DamirNine/prikmeh/курсовой/2026-11-09/apm/Скрины/кулиса_2_тест.png

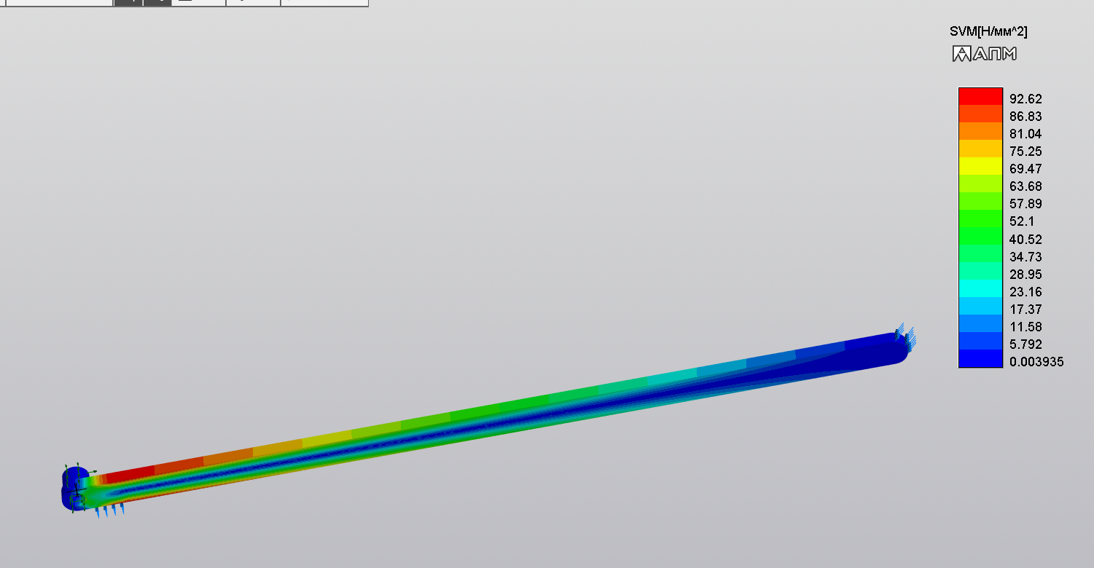
курсовой/2026-11-09/apm/Скрины/кулиса_2_тест.png
