DamirNine/prikmeh/мои_записи_Claude.md

# Мои записи и сообщения Claude по курсовому проекту

Все сообщения из диалога с Claude Code (15.09–13.10.2026) в хронологическом порядке, время московское. Сюда же входят заметки с консультаций, вставленные в чат, и ответы на вопросы Claude с вариантами («ответ на вопрос»). Реплики, отправленные во время работы Claude, помечены «по ходу работы». Ответы Claude не включены, только мои сообщения. В начале диалога есть несколько сообщений не по курсовому.

## 15.09.2026

**12:23**

привет прочитай инструкции
работаем с проектом по примеху

**12:24** · ответ на вопрос

- **Вопрос:** Не могу однозначно понять, какой проект вы имеете в виду под «примеху» — такого нет в памяти. Уточните, пожалуйста, какой это проект?
  **Ответ:** а я вспомнил посмотри в гитхабе там есть проект по прикмеху

**12:26** · по ходу работы

дай токен

**12:27** · по ходу работы

ты просметрел гитхаб?
у меня вылезло окошко с гитхабом оно тебе надо?

**12:28**

зачем тебе это у тебя же есть токен административный

**12:30**

к какой почте гитхаб привязан?

**12:36**

нужно создать токен для доступа к этому проекту что бя я мог скинуть его другу и он тоже смог бы скачать от-туда файлы так же если я буду тут работать по этому проекту ты автоматически вноси это в гитхаб
так же запиши сюда и в гитхаб что если мы что редактируем или добавляем то мы копируем файл и редактируем скопированный файл для того что бы прошлая версия оставалась и желательно еще заносить их в папки которые называть по дате редактирования

**12:59**

во сколько начился наш диалог

## 18.09.2026

**13:59**

привет посмотри последний загруженный файл там мы с другом проработали дальше наш проект проверь выполнение

**14:00**

нет в моем компьюютере последний загруженный файл

**14:03**

доделай что нужно сделать

**14:08**

открой файл

**14:15**

так убери надписи типо это дополнение из файла 
а также сделай пункты 19-25 такими же по формату как и преведущие пункты

**14:20**

что такое HoReCa
и у тебя текст разных шрифтов

**14:25**

сохрани этот файл в гитхаб и если надо будет редактировать теперь сделай копию и редактируй ее

**14:26**

выведи мне полный анализ батареи

**14:56**

новый скачанный файл просмотри на правильность

**15:29**

обнови память и замени файл  из гитхаба(файл который сегодня сохранял) этим файлом

**15:31**

делай

## 21.09.2026

**10:44**

Картинку из ГОСТа крышки
Убрать шарнир из компановки 
Ra5 ГОСТ 6636 +-
Смотрим под серийку R10-R20
Получаем предел текучести из материала крышки на 5%
Площадь кольца и предел текучести 
Рукоятка: 

Силовой расчет с известной силой человека и получаем максимальную длину рукоятки 

Кинематику прописать 

Ход ползуна: зазор + запрессовка 

Габариты:
Кухонный зазор, смотреть за рычагом 
1.5 диаметра бутылки 

ТЗ: таблица с цифрами, парсетрыч размерности и значение. Условие задачи в цифрах.

Предпроектный этап:
Расчеты
Кинематика
Силовая

не давно были у преподователя и вот что нам дали

ты еще помнишь как у нас выглядела схема механизма?

**10:48** · ответ на вопрос

- **Вопрос:** «Убрать шарнир из компановки» — что именно имелось в виду?
  **Ответ:** Не помню точно / нужно переспросить
- **Вопрос:** «Предел текучести из материала крышки на 5%» — как это понимать?
  **Ответ:** мы должны превышать силу предела текучести примерно на 5 %

**10:49**

сначала хочу сделать схему как все будет выглядеть

**10:50** · ответ на вопрос

- **Вопрос:** Какую схему делаем — формальную кинематическую (по ГОСТ 2.770, условные обозначения звеньев/шарниров/пар) для отчёта по ТММ, или общий вид устройства (как оно будет выглядеть визуально: основание, стойка, рукоятка, крышка на бутылке)?
  **Ответ:** сделай обе и в схеме тмм желательно еще подписать размеры

**10:58**

открой

**11:01**

ты вообще видел что ты сгенерировал?
оно все кривое
может тебе легче будет сделать 3д модель?
ничего не делай просто ответь

**11:03**

я как-то сказал тебе сделать 3д кубик рубик который можно крутить ты довольно легко сделал это будет сделать тяжелей?

**11:06**

да хочу 3д модель которая будет двигаться по кнопке и еще одна кнопка которая грубо говоря разрезает модель пополам что божно было увидеть что внутри
давай сначала просто статическую модель которую можно крутить и по кнопке ее разрезает

**11:20**

во первых при разрезе внутри модели прозрачные а должны быть обычные
во вторых все перепутано и не на своих местах
возьми последнию из загрузок я там попытался нарисовать как примерно должно выглядеть

**11:47**

https://507movements.com/mm_101.html
ты можешь посмотреть что тут

**11:52**

я это к тому как примерно должны выглядеть ручка а не это овальная нечто 
плюс продумай геометрию и не заставляй опоры висеть в воздухе соедени их с основанием только так что бы они не мешали механизму и выглядели нормально

**11:58**

лучше но нужно проделать отверстия где все должно ездить плюс у тебя кулиса и ползун на одной плоскости они так двигаться не смогут их нужно немного раздвинуть они двигаются за счет камня продумай геометрию

**12:03**

не с той стороны отверстия сделал и сделай кулису примерно как в схеме с отверстием сейчас там просто вмурован камень

**12:10**

сдвинь разрез к плоскости ползуна
теперь можно анимировать

**12:27**

так движение впринципе верное теперь нужно придумать как скрыть все это и как потом все это собирать(у нас будет 3д принтер и нам нужно чтобы можно было собрать механизм(он не будет выполнять свою работу главное что бы он мог двигаться как надо))
также сделай бутылку с пропорцией как у 0,33
кулису сделай потоньше
сначала сделай исправления я посмотрю и потом будем думать как скрыть и собрать

**12:38**

как использовать ГОСТ 6636

**12:45**

пока не считали как думаешь лучше сначала расчитать а потом уже думать как закрыть и собирать или сейчас все продумать а потом рассчитать и поменять размеры?
как мне самому открыть 3д если я перезапущу комп а у тебя токены закончаться добавь мне ярлык на рабочий стол

**12:47**

где храниться это 3д модель?
в смысле за счет чего я ее открываю в браузере

**12:50**

а как долго это можно будет открыть?

**12:50**

а если у меня закончиться подписка?

**12:52**

возьми последний загруженный файл и проверь его

**13:04**

переделай 3д модель ползун пусть будет прямоугольный 
не забудь сделать такие же дырки и камень должен вращаться вокруг своей оси так меньше будет износ вроде нам это показывать пока никак не надо

## 22.09.2026

**13:13**

продолжаем

## 25.09.2026

**12:19**

привет посмотри последнюю загрузку это скрин картинки механизма обрежь фото улучши качество если можешь и поверни на 90 градусов что бы закрепление было в левой стороне экрана ну и сохрани куда-нибудь в проект потом буду просить открыть ее

**12:22**

открой мне картинку

**12:26**

посмотри файл последний из загрузок это то что я тебе скидывал до этого?

## 27.09.2026

**19:23**

привет посмотри последнии три загрузки
мне нужно что бы ты имею пластичную деформацию +5 процентов крышки и площадь горлышка бутылки рассчитал силу ползуна знаю силу руки рассчитал длину рукояти а потом рассчитал соотношение ползуна и рукояти для минимизации размеров
вот еще текст не знаю насколько он подхадит нашему механизму

> **Вставлено:**
> Подобрать такие параметры механизма, который опишет необходимую траекторию.
> Кривые 6 степени
> Траектории выходной точки. Траектория достаточно приближается к прямолинейной не превышает 1/20. Надо вычислить эту величину для своего механизма:
> 1) функция положения: зависимость координат выходного звена от входного 
> Количество зависимостей - формула Гофмана: k = p_н - n
> Уравнение замкнутости контура: рассматриваем замкнутый векторный контур механизма 
> Проецируем на неподвижные декартовы оси
> Углы тригонометрические - от оси x против часовой стрелки
> 
> Пространство факторов
> Масштаб из хода, который мы получили в производительности

**19:47**

запиши все в файл ты проверил что там в скачанном?

**19:56** · по ходу работы

так же там надо размеры в гост сверить (не помню вроде гост 6636) ты это сделал?

**20:09**

открой мне папку где лежит последний файл

**20:10**

какой файл?

## 02.10.2026

**14:03**

открой файл с расчетом

**15:43**

пересчитай еще раз силу к горлышку бутылки

**15:47**

открой файл с ТЗ

**15:50**

откуда у нас  435,75 МПа
как-от многовата

**15:53**

посмотри в интернете какая площадь используется при похожих расчетах

**16:00**

новый файл и переделай теперь так

**16:10**

убери из файла упоминания о преведущей версии

**16:11** · по ходу работы

и в будущем тоже при создании новой версии не надо писать различия с преведущей просто пиши новую и все

**16:34**

посмотри в интернете силу нажима руки

**16:37**

так какая сила

**16:41**

возьми силу руки примерно 120 H

**16:46**

тз пока не трогаем его потом поправим после вопросов учителю открой файл

## 03.10.2026

**01:18**

> **Вставлено:**
> Уменьшить e и угловой ход пси
> Как соотнести их
> 
> Оптимизировать площадь треугольника 
> Какой критерий позволит сравнить между собой
> 
> Какой критерий зависит от e и пси, при этом ход постоянный остаётся?
> 
> Прикладываем силу P вертикально
> Нажатие одной рукой
> 
> От минимизации длины рычага
> От минимизации площади треугольника, сделав фиксированную высоту 
> 
> Аналоги скорости и ускорения для характерных точек
> 
> вот заметки с консультации а также фото из загрузок
> спроси что непонятно

**01:28** · ответ на вопрос

- **Вопрос:** Площадь какого треугольника минимизировать (критерий, зависящий от e и ψ)?
  **Ответ:** O и два крайних положения ползуна
только угол не от 30 до 0
а допустим от 60 до 40(примерно)
- **Вопрос:** Что значит «сделав фиксированную высоту»?
  **Ответ:** высота это зазор между крышкой и концом ползуна и еще сколько-то сколько надо на деформацию крышки
- **Вопрос:** Сила руки при «нажатии одной рукой» — какое значение брать?
  **Ответ:** посмотри с разными силами
- **Вопрос:** Откуда брать времена разгона, установившегося движения и торможения для графика ω(t)?
  **Ответ:** это расчитывается по формулам
беруться точки для них как-то там находяться скорости и ускорения
и т.д.
можешь посмотреть презентацию по прикмеху с преведущего семестра вроде там есть

**01:31** · по ходу работы

я тебе градусы как пример дал по факту ты должен рассчитать так что бы площадь треугольника была минимальна
ты изменяешь угол 
ты изменяешь e
ну и поставь себе длину рукояти ограничение какое-нибудь что бы не было метровой рукояти

**01:35** · ответ на вопрос

- **Вопрос:** Какое окно угла развивать дальше (для него посчитаю аналоги скоростей, ускорений и ω(t))? Таблица сравнения всех окон войдёт в файл в любом случае.
  **Ответ:** напиши скрипт который переберет значения для минимизации площади(ну или сам перебери)
пусть там вариируется и угол и разница углов и e и т.д.
нормально перебери вариантов а не 10 и не 100
- **Вопрос:** Рычаг — прямое продолжение кулисы (как на листе) или можно изогнуть рукоять?
  **Ответ:** Прямой, как на листе
- **Вопрос:** Времена для ω(t): предлагаю взять из производительности Q = 6 бут/мин (цикл 10 с). Подходит?
  **Ответ:** это все по формулам считать надо а не так приводить
и ты пересчитал при силе P вертикальной а не перпиндикулярной

**01:40** · по ходу работы

ты площадь вроде не так считаешь

**01:41** · по ходу работы

то что ты написал это площадь треугольника если он доезжает до угла в 0
а если не заезжает то там трегоульник с другим углом

**01:42** · ответ на вопрос

- **Вопрос:** Площадь какого треугольника минимизировать?
  **Ответ:** как сейчас но у тебя формула верна только если угол от 0 до скольки-то
а если от 60 до 40 то там другой треугольник и считать от 40 до 0 в этом треугольнике не надо

**01:57**

52,5 как-то многовато
сделай как анимацию лучших вариантов что-бы я примерно мог понять

**01:59** · по ходу работы

просто сделай анимации лучших работ которые ты показал в таблице с сохранением примерных масштабов
нажимаешь на картинку и анимация работает 1 раз

**02:07**

давай для 40 градусов

**02:10** · ответ на вопрос

- **Вопрос:** Что берём исходным для расчёта времён разгона, установившегося движения и торможения?
  **Ответ:** я не помнб посмотри в фото и презентации до этого и сделай по формулам если там нет посмотри в интернете

**20:04**

посмотри два последних скачанных файла и проверь файл
вроде там показано как расчитывать скорости

**20:06** · по ходу работы

стоп

**20:07** · по ходу работы

там речь вроде про другой механиз ничего с углом делать не нвдо

## 05.10.2026

**10:12**

посмотри на фото там есть график угловой скорости там он в виде трапеции

**10:17** · ответ на вопрос

- **Вопрос:** Какую трапецию ω(t) берём?
  **Ответ:** это все должно через формулы делаться 
там где прямая это упругая деформация

**10:20**

записывай

**10:31**

открой новый файл

**12:18**

сколько примерно токенов потребуется для изменения 3д модели под текущие размеры?
только ответь не делай

**12:19**

тогда потом

**12:20** · по ходу работы

обнови память

**18:45**

открой последний файл

## 09.10.2026

**12:30**

обнови 3д модель пока

**12:57**

посмотри два последних загрузки и переделай график в 3д

## 12.10.2026

**14:44**

какая последняя версия

**14:45**

я загрузил примеры посмотри их и проверь что все сделано правильно

**14:49**

пока не надо

**14:49**

обнови 3д модель

## 13.10.2026

**13:20**

запиши все мои записи тебе в отдельный файл и залей его на гитхаб
