DamirNine/prikmeh/лаб2/project_лаб2.md

---
name: project-прикмех-лаб2
description: Лабораторные работы по Прикладной механике в пакете Universal Mechanism Lite (Подчасов Е.О.)
metadata:
  type: project
---

# Прикмех — Лабораторные работы (UM Lite)

Курс: Прикладная механика и основы конструирования  
Преподаватель: Подчасов Е.О.  
ПО: Universal Mechanism Lite 7.0 (`C:\Program Files (x86)\UM Software Lab\Universal Mechanism Lite\70\bin\UMLite.exe`)

---

## Работа 1 — Моделирование и исследование шатунных кривых КПМ

**Цель:** построить шатунную кривую кривошипно-ползунного механизма в Компас 3D и UM Lite, аппроксимировать её участки прямой и дугой.

### Вариант (шифр): **1-8-5-3**
- **1** → l₁ = **0,1 м**
- **8** → λ₂ = l₂/l₁ = 4 → l₂ = **0,4 м**
- **5** → λBM = lBM/l₁ = 1,5 → lBM = **0,15 м**
- **3** → α = **25°**

---

## Работа 2 — Анализ и синтез механизма с выстоем на базе КПМ

**Цель:** подобрать параметры внеосного КПМ (l1, l2, exs), обеспечивающие заданный ход ползуна, коэффициент скорости Kv и долю выстоя.

### Вариант (шифр): **9-7-6**
| Параметр | Строка шифра | Значение |
|---|---|---|
| Ход h | 9 | **250 мм** |
| Kv | 7 | **1,3** |
| Доля выстоя | 6 | **14%** |

### Ключевые формулы (из методички Подчасова):
- Начальное положение (φ=0): A(0,0), B(l1,0) в плоскости YZ
  - Кривошип при φ=0 направлен в сторону +Y
  - Ползун C: y_C = exs, **z_C = −l2·√(1−((l1−exs)/l2)²)**
- При l1=0.5, l2=1.5, exs=0.2: **z_C = −1.46969 м**
- Условие полного оборота: l1 < l2 − |exs|
- Kv = (180° + θ) / (180° − θ), где θ = (θ_пр − θ_обр)/2
- Выстой: участки, где |v| < 10% от max|v|

### Исходные параметры модели для перебора:
- l1=0.5, l2=1.5, exs=0.2 (начальные)
- Пример из методички: l1=0.5, l2=0.7, exs=0.1 → Kv≈1.38, выстой≈14%, ход≈1.022 м → нам нужен Kv=1.3 (чуть меньше)

### Система координат UM Lite (из методички, Рис.2):
- **X** — ось вращения кривошипа
- **Y** — горизонталь (направление внеосности)
- **Z** — вертикаль (ось движения ползуна, вниз = −Z)
- Гравитация: `gravityz=-1`

### Шарнирные векторы (из Рис.13 методички):
- **Ground Vector1**: точка (0,0,0), ось X — для вращательной пары кривошипа
- **Ground Vector2**: точка (0,exs,0), ось Z — для поступательной пары ползуна
- **Body1 (Crank)**: vector в (0,0,0) и в (0,l1,0), ось X
- **Body2 (Rod)**: vector в (0.1,l1,0) и в (0.1,exs,z_C), ось X
- **Body3 (Slider)**: один vector, ось Z

### Шарниры (4 шт., из Рис.14 методички):
- **j1** Body1→Ground: вращательный, **входной (заданная функция времени)**, ω=2π рад/с
- **j2** Body1→Body2: вращательный, автопозиционирование
- **j3** Body3→Body2: вращательный, автопозиционирование, **cut=true** (замыкание контура)
- **j4** Ground→Body3: поступательный, автопозиционирование

### Процедура анализа (из методички):
1. Время интегрирования = 1 с (один оборот при ω=2π)
2. Открыть Графики: Кинематика → Body3 → Координата Z (положение) + Скорость Z
3. Экспортировать (Ctrl+T) → txt-файл с двумя столбцами: t, v:z(Body3)
4. Найти: max|v|, участок выстоя (|v| < 0.1·max|v|)
5. Пересчитать θ через время → Kv

---

## Файлы
- `Работа 2 (1).pdf` — методичка (Downloads), 17 стр.
- `kpm_vystoi.umd` — **созданный UMD файл (НЕ РАБОЧИЙ, есть ошибки)**
- `visualize.py` — Python-анимация механизма
- Все файлы в: `C:\Users\terek\.claude\projects\прикмех\лаб2\`

---

## Статус
- [ ] Работа 1: не начата
- [~] Работа 2: UMD файл создан, нужно исправить

## Известные ошибки в kpm_vystoi.umd
1. **coord0 ползуна = -0.98661** → должно быть **-1.46969** (неправильная формула)
2. **joint2 tc offset = ez=l1** → должно быть **ey=l1** (кривошип по Y, а не по Z)
3. **Ориентация GO (CYLINDER)** — по умолчанию идёт вдоль Z, а кривошип нужно направить по Y. Варианты:
   - Изменить `angle3=-90` в GE для поворота цилиндра (Z→Y при повороте -90° вокруг X)
   - Или использовать coord0=-90° для входного шарнира (если GO вдоль Z)
4. **coord0 вращательных шарниров** — не посчитаны правильно (зависит от ориентации GO)

## Следующий шаг
Нужно переписать kpm_vystoi.umd правильно:
- Вариант A: GO вдоль Z (как в эталонном КПМ), coord0_кривошипа = -90°, тогда joint1 prescribe: q(t)=-π/2 + 2π·t
- Вариант B: GO вдоль Y (добавить angle3=-90 к GE), coord0_кривошипа = 0°, joint1 prescribe: q(t)= 2π·t (проще, соответствует методичке)
- **Предпочтительный: Вариант B** — соответствует рисункам в методичке

### Вычисленные coord0 для Варианта B (GO вдоль Y, φ=0 = кривошип в +Y):
- joint1 (кривошип, вход): coord0=0°, function=0,6.28318,0,0,0,0
- joint4 (ползун, поступательный): coord0=**−1.46969** м
- joint2 (кривошип→шатун): coord0 = угол шатуна относительно кривошипа при φ=0
  - Вектор шатуна: (0, exs−l1, z_C) = (0, −0.3, −1.46969)
  - Нужно уточнить при следующей сессии
- joint3 (шатун→ползун, cut): coord0 = аналогично, противоположный знак

## Примечания из эталонного КПМ (Кривошипно-ползунный механизм.umd)
- GO типа "Звено" в UMD = CYLINDER + ELLIPSOID (нет специального типа LINK)
- BAR = ползун (Box-shape)
- Первый tc в joint = offset от bd1 до точки шарнира; последний tc = offset от точки шарнира до начала bd2
- Структура шарнира: tc → DOF(rv/rt/tv) → rc → tc(0,0,0) → rc → tc(return)
