DamirNine/prikmeh/memory/project_прикмех_курсовой.md

---
name: project-прикмех-курсовой
description: Курсовой по Прикладной механике/ТММ — ручной укупориватель бутылок на тангенсном механизме. Актуально v24 (курсовой/2026-11-06, переработанный расчёт из Downloads\mechanism.docx без ссылок на прошлую версию); до него v23 (курсовой/2026-11-04, build_v23.py → build_v22 → build_v21 поверх v20 + правки рисунков: замечания преподавателя 04.11). Ранее v17 (курсовой/2026-11-02, build_v17.py): v15 с правками пользователя 30.10 + разд. 13 уточнённый силовой расчёт (силы тяжести и инерции, без трения) — P max 109,9 Н, L = 500, кулиса 8×18 Ст3сп и шток Ø8 проходят; ТЗ не трогать; 3D-модель с C-образной обоймой.
metadata:
  type: project
---

# Прикмех — курсовой проект (методология проектирования машины)

Отдельный, семестровый поток заданий — не то же самое, что ДЗ по кинематике точки ([[project-прикмех]]) или ДЗ3 по степеням свободы (кулиса/камень/ползун, вариант 32). Цель курсового проекта: разработать и физически собрать кинематический прототип механизма, защититься по чужому комплекту документации.

## Этапы проектирования
0. **Маркетинговое исследование** — определить назначение проектируемой машины/механизма (понять, что именно проектируем).
1. **Предпроектный этап** — формирование ТЗ.
   - Качественные критерии — словесные, без цифр (условия функционирования, тяжело описать численно): хладостойкость, диэлектрик и т.п.
   - Количественные критерии (8 шт., выражаются цифрами):
     1. Производительность машины (физическая величина на единицу времени, напр. число деталей за смену).
     2. Кинематические характеристики входных и выходных звеньев.
     3. Силовые характеристики технологического процесса.
     4. Эргономика (эргономические требования).
     5. Допустимые габариты.
     6. Масса.
     7. Прочность.
     8. Долговечность.
   - Два базовых критерия для всего проекта — **производительность и усилие**.
2. **Расчётная часть**:
   - Кинематика: метрический синтез (тривиальный или оптимизационный — выбираются 2 варьируемые переменные), затем расчёт скоростей и ускорений.
   - Динамика: квазистатический расчёт.
   - Получение геометрических моделей деталей на основе расчётов — CAD/CAE.
3. Создание прототипа → эксплуатация.

## Комплект проектной документации
ТЗ + Пояснительная записка (сопровождает расчёты) + Конструкторская документация (**ЭГМИ** — электронная геометрическая модель изделия) + Инструкция по сборке + Инструкция по эксплуатации.

## Защита
Команды обмениваются комплектами деталей и инструкциями — нужно по **чужой** документации собрать механизм и запустить его. Защита проходит в Zoom.
Материалы к защите: полный перечень документов (см. выше) + доклад/презентация (**10–12 слайдов**, доклад **5 минут**, результаты) + видеозапись доклада + инструкции по сборке/эксплуатации + видео сборки и работы прототипа против собранного механизма.
Прототип — **сугубо кинематический**: отрабатывает только кинематику, не функционал.

## Сроки по неделям
- **3 неделя** — ТЗ (должен быть готов каркас: назначение механизма, производительность, силовая нагрузка).
- **8 неделя** — расчётная часть (ручные расчёты + компьютерные расчёты).
- **11 неделя** — конструкторская часть.
- **14 неделя** — «Т» (в лекции записано без расшифровки — уточнить у преподавателя, что имелось в виду).
- **15–17 неделя** — защита проекта.

## Текущее ДЗ: 3 варианта схемы назначения механизма

Базовая кинематическая схема — **кулисно-ползунная (тангенсная)**: кулиса 1 (качающееся звено с пазом) + камень 2 (палец-ползунок в пазу) + шатун/рычаг 3 + ползун (шток в направляющих скобах). Это та же схема, что и в ДЗ3 (Вариант 32 из `ДЗ РК6 ПМ 2026.pdf`, стр.7) и в прошлом ТММ-задании про [[тангенсный-механизм]] — курсовой проект продолжает эту же кинематику, но требует придумать ей **реальное назначение**.

На этапе 0 (маркетинговое исследование) материалы и размеры не важны — нужно только назначение/облик машины:

1. **Банальный вариант (ГОСТ-единица)** — **дверной/оконный шпингалет (задвижка) рычажного типа**. Стандартная скобяная фурнитура: поворотный рычаг-флажок (кулиса) через камень в пазу двигает штангу-засов (ползун) в опорных скобах на дверной/оконной раме. Стандартные исходные данные — типоразмеры и материалы по ГОСТ на скобяные изделия (аналог ГОСТ 5090).
2. **Вариант со свободой проектирования (рыночный аналог, не ГОСТ)** — **рычажная тавотница / шприц для консистентной смазки** (ручной смазочный инструмент с рычажным приводом плунжера). Есть готовые коммерческие товары на маркетплейсах (Ozon/WB: "шприц-масленка рычажная"), но нет единого ГОСТ-типоразмера — конструкция и пропорции варьируются у разных производителей; наш вариант будет того же порядка величин, но не копией конкретной модели.
3. **Креативный вариант (без аналогов)** — **настенная кинетическая скульптура**: например, механическая «птица/бабочка», у которой поворот ручки через кулисно-ползунный механизм превращает вращение в колебательное (машущее) движение декоративного крыла/хвоста. Чисто художественный объект, аналогов на рынке нет, сравнивать не с чем ни на одном этапе.

**Why:** выбор схемы — входная точка курсового проекта, от неё зависят все дальнейшие расчёты и первый дедлайн (3 неделя = готовое ТЗ). Три назначения выбраны так, чтобы сохранить одну и ту же кулисно-ползунную кинематику, но дать три разных уровня свободы проектирования, как требует методичка.
**How to apply:** при проработке ТЗ/расчётов курсового проекта — по умолчанию считать эти три назначения кандидатами (пока пользователь не выберет одно окончательно); при формировании количественных критериев (производительность, усилие и т.д.) — подставлять параметры под выбранное назначение, не путать качественные и количественные критерии.

## Финально выбранное назначение (2026-09-18): укупориватель бутылок

Пользователь с другом (по команде) отошли от трёх исходных вариантов-кандидатов и выбрали новое, более конкретное назначение: **ручной настольный укупориватель стеклянной бутылки Long Neck 0,33 л металлической кронен-крышкой Ø26 мм**, привод рабочего органа — тот же тангенсный механизм (кулиса-камень-ползун). Бутылка — Wiegand-Glas Longneck 0,33 л, арт. 456-10-03. Файл: `курсовой/2026-09-18/predproektnyi_etap_upakovochnyi_mehanizm_18_punktov.docx` (предпроектный этап, 18 пунктов).

### Проверка выполнения предпроектного этапа (по состоянию на 2026-09-18)

Качественные критерии (§9 документа) — сформулированы корректно, словесно, без цифр. Ок.

Из 8 обязательных количественных критериев методички заполнены/начаты только 3:
1. **Производительность** — Q = 6 бутылок/мин (цикл ~10с). ✅ Готово.
2. **Кинематические характеристики звеньев** — частично: ход ползуна S≈15мм, угол качания кулисы Δφ≤30°, длина рукоятки L≈350мм — все помечены как предварительные, требуют метрического синтеза. ⚠️ Начато, не завершено.
3. **Силовые характеристики техпроцесса** — F≈800Н (усилие укупоривания, ориентировочно), Pmax≈75Н/P≈50-60Н (усилие руки). ⚠️ Начато, но преподаватель явно указал: F нужно пересчитать через предел текучести материала крышки, а не оставлять оценочным.
4. **Эргономика** — ❌ отдельно не сформулирована (усилие руки P≈50-60Н частично покрывает, но explicit пункта нет).
5. **Допустимые габариты** — ❌ явно вынесено в список "не определено" (габариты всей установки).
6. **Масса** — ❌ не указана масса устройства (только масса бутылки).
7. **Прочность** — ❌ явно в списке "не определено" (прочность и жёсткость элементов).
8. **Долговечность** — ❌ вообще не упомянута нигде в документе.

Оба базовых критерия проекта (производительность и усилие) заявлены — формально стартовая точка 3-й недели («каркас: назначение, производительность, силовая нагрузка») закрыта. Но для полного ТЗ по методичке не хватает 5 из 8 количественных критериев (эргономика, габариты, масса, прочность, долговечность) — они пока даже не в статусе "предварительно", а просто отсутствуют или явно помечены автором как открытые вопросы (§17).

Логика по физике укупоривания (переход крышки за предел текучести, σкр>σт, упругая работа деталей механизма σmax≤[σ]) прописана верно и методологически обоснованно — это фактически уже задел на 8-ю неделю (расчётная часть/силовой расчёт), а не только на ТЗ.

**Why:** зафиксировано после явной просьбы пользователя (2026-09-18) проверить, что сделал он с другом в последнем присланном файле.
**How to apply:** следующий шаг — материал кронен-крышки → его предел текучести → пересчитать F реально, а не оценочно; затем добить недостающие 5 количественных критериев (даже кратко) до полноценного ТЗ; остальные варианты назначения (шпингалет/тавотница/скульптура) больше не актуальны — тема закрыта на укупоривателе.

### Добито до 8/8 критериев (2026-09-18)

По просьбе пользователя «доделай что нужно сделать» — дополнил копию файла (правило копии соблюдено, оригинал от друга не тронут): `курсовой/2026-09-18-доп/predproektnyi_etap_upakovochnyi_mehanizm_25_punktov.docx` (18 исходных пунктов + добавлены §19-25).

- **Материал крышки и уточнённый расчёт F** (§19): жесть SR T3-T4 (ГОСТ-аналог ЭЖК, ГОСТ 13345), s=0,20-0,22мм, σт≈400МПа (данные по международным маркам жести для крышек Ø26мм, найдены через WebSearch — источник не давал точных ГОСТ-цифр по σт, поэтому использован зарубежный аналог как обоснованная оценка). Расчёт через пластический момент изгиба зубца (Mт=σт·b·h²/4, b≈4,8мм по 21 зубцу, плечо a≈3мм) даёт F_идеал≈148Н; с технологическим коэффициентом запаса k=5,5 (трение, неравномерность, упрочнение) → F≈814Н — подтверждает ранее принятое F≈800Н аналитически, как требовал преподаватель.
- **Эргономика** (§20): по ГОСТ 12.2.049-80 — P≈50-60Н целевое, Pmax≈75Н предельное для нечастого использования.
- **Габариты** (§21): оценка ≈450×450×420мм (Д×Ш×В), предварительно.
- **Масса** (§22): ≈2-3кг по объёму стальных деталей, критерий ≤3кг.
- **Прочность** (§23): сталь 45, σт≈360МПа, n=1,8 → [σ]≈200МПа.
- **Долговечность** (§24): целевой ресурс N≥20000 циклов (прототип на защиту полный ресурс не проходит).
- **Сводная таблица** (§25): все 8 критериев методички закрыты (часть — как "предварительно", уточняется на расчётном/конструкторском этапах).

**Важно:** это оценочные/предварительные расчёты уровня ТЗ (предпроектный этап), не финальный силовой расчёт — коэффициент k=5,5 в расчёте F эмпирический (не выведен строго), нужно будет пересчитать точнее на расчётном этапе (8 неделя) при появлении реальной геометрии укупорочной головки. Пользователю стоит показать §19-25 преподавателю/другу как черновик, а не как окончательный результат.

### Версия друга «_ispravleno» (2026-09-18) — переработка §17-25 с реальными источниками

Друг (или его инструмент) прислал `predproektnyi_etap_upakovochnyi_mehanizm_25_punktov_ispravleno.docx` — существенно более строгую переработку моих §17-25: заменил мои оценочные допущения (k=5…6, [σ]=200МПа, лимит массы 3кг, ресурс 20000 циклов) на данные из реальных источников, с нумерованными сносками [1]-[7]. Файл сохранён в репозиторий тем же путём.

**Проверил источники через WebSearch/WebFetch (2026-09-18) — по большей части подтвердилось:**
- ГОСТ 32624-2020: подтверждено напрямую (allgosts.ru) — давление для типа I **0,7 МПа** (не 0,8 как в старой редакции 2014г — в 2020-м снизили), материалы ЭЖК/ХЛЖК, толщина 0,16-0,30мм — всё точно.
- TH415/T4CA жесть, σт=415МПа — подтверждено у нескольких производителей жести (Tata Steel и др.), реальная марка именно для кронен-крышек.
- ГОСТ 1050-2013 сталь 45 (σт=355МПа, σв=600МПа) — подтверждено точно.
- Vigo Manual Crown Capper (500мм, 9,5кг, ~400бут/ч) — совпадает с сайтом производителя дословно.
- Патенты EP0531379B1 и US5373683A — оба реальные (Hermann Kronseder/KRONES, начало 1990х, укупорка в 2 фазы давления), тема в точку.

**Не подтвердилось / под вопросом:**
- ~~Сноска [5] «ГОСТ Р ЕН 1005-3-2010 действует до 01.12.2026, замена ГОСТ EN 1005-3-2016» — похоже на выдумку~~ — **ОШИБОЧНАЯ ПОМЕТКА, исправлено 2026-09-21**: карточка изменения Росстандарта (protect.gost.ru/gost/changesdetails/b36a8a36-…) подтверждает: отменён с 01.12.2026, замена ГОСТ EN 1005-3-2016, изменение зарегистрировано 20.11.2025, опубликовано в ИУС 2-2026. allgosts.ru просто не успел обновиться. Утверждение друга верное, убирать НЕ нужно.
- Цифра «~80 kgf» из патентов [4] — патенты настоящие, но саму цифру усилия в тексте патентов не проверял (нужно открыть на Google Patents).
- Таблица EN 1005-3 (275Н база × 0,8 × 0,5 × 1,0 × 0,5 = 55Н) — методика верна структурно (так и работает стандарт), но сами табличные коэффициенты не сверял (текст стандарта платный).

**Why:** пользователь попросил (2026-09-18) проверить новый скачанный файл на правильность — важно для курсовой не просто доверять красиво оформленным ссылкам, а проверять их.
**How to apply:** перед защитой/сдачей — убрать или перепроверить сноску [5] про дату отмены ГОСТа.

**Обновление (2026-09-18, тем же днём):** по просьбе пользователя версия «_ispravleno» стала канонической — её содержимое скопировано в `курсовой/2026-09-18-доп/predproektnyi_etap_upakovochnyi_mehanizm_25_punktov.docx` (замена, не рядом). Дубликат `_ispravleno.docx` удаляется отдельно (файл был занят Word при попытке удаления — см. [[project-прикмех]] про паттерн "не форсить, просто попросить закрыть"). Моя более слабая версия (с коэффициентом k=5,5, [σ]=200МПа и т.д.) остаётся доступна только через git-историю (коммиты 0e7c3d1/92d7389/cbca0f3), в рабочем дереве репозитория больше не присутствует. Дальнейшая работа по курсовому проекту ведётся на основе версии друга.

## Заметки с очной встречи с преподавателем (2026-09-21)

Пользователь принёс сырой конспект (голосовой/на слух, местами неоднозначный) с очной встречи с преподавателем. Зафиксировано как есть, без додумывания — часть пунктов нужно уточнить перед реализацией:

- **Картинка из ГОСТа крышки** — в ТЗ/документацию нужно вставить чертёж/картинку крышки из ГОСТ 32624-2020 (размеры, профиль).
- **«Убрать шарнир из компановки»** — ⚠️ пользователь сам не помнит точно, что имелось в виду (2026-09-21) — **нужно переспросить преподавателя**. Пока НЕ трогать чертежи/компоновку по этому пункту — ждём уточнения.
- **Ra5 по ГОСТ 6636, ориентир на ряд R10–R20** — размеры деталей назначать не произвольно, а по рядам предпочтительных чисел ГОСТ 6636 (Ra5, при необходимости более мелкий шаг — R10/R20), с допуском ±.
- **Предел текучести материала крышки — «на 5%»** — уточнено пользователем (2026-09-21): расчётное напряжение/усилие должно **превышать предел текучести примерно на 5%** (σ_расч ≈ 1,05·σт), то есть заведомый заход в пластическую область с небольшим запасом сверху — не 5%-й запас вниз и не offset-метод. Это уточняет п.19 текущего файла (там было "σeq,кр ≥ Rp0,2" без конкретного запаса) — можно формализовать как σeq,кр ≈ 1,05·Rp0,2 ≈ 1,05·415 ≈ 436 МПа.
- **Сила укупоривания через площадь кольца**: F = A_кольца × σт (площадь контактного кольца обжима × предел текучести материала крышки) — это чище, чем прежний расчёт через пластический момент изгиба зубца (§19 в текущем файле); стоит пересчитать F этим способом и сравнить с F≈0,8кН у друга.
- **Рукоятка**: силовой расчёт с известной силой человека (эргономика, см. §20 текущего файла — Pраб≤55Н по ГОСТ Р ЕН 1005-3) → из него получить МАКСИМАЛЬНУЮ длину рукоятки (а не просто принять L≈350мм произвольно).
- **Кинематику прописать полностью** (метрический синтез + расчёт скоростей/ускорений — это уже задел на 8-ю неделю, расчётный этап).
- **Ход ползуна S = зазор + запрессовка** — то есть S раскладывается на 2 физически осмысленных слагаемых (зазор перед контактом с крышкой + глубина обжима/запрессовки), а не одна оценочная цифра ≈15мм.
- **Габариты**: учитывать "кухонный" зазор — смотреть, чтобы рукоятка при взмахе не задевала ничего вокруг (эргономический зазор за рычагом); основание/база ≥ 1,5 диаметра бутылки (≥1,5×60,4мм ≈ 90,6мм — уточняет прежнюю прикидку "200×150мм").
- **ТЗ должно быть таблицей**: колонки параметр / размерность / значение, условие задачи выражено в цифрах (а не текстом-описанием, как сейчас местами в §1-18).
- **Предпроектный этап теперь явно включает**: расчёты — кинематика + силовая часть (раньше это относили больше к 8-й неделе/расчётному этапу; преподаватель, похоже, хочет видеть их раньше, уже на этапе ТЗ).

**Why:** прямая просьба пользователя (2026-09-21) сохранить конспект со встречи с преподавателем.
**How to apply:** не переделывать документ по этим пунктам молча — сначала уточнить два неясных места (шарнир, "5%"), затем пересчитать F через площадь кольца и длину рукоятки через силовой расчёт, оформить ТЗ как таблицу параметр/размерность/значение, добавить кинематику и габаритные правила (1,5×D, зазор за рычагом) в файл.

## ТЗ в табличной форме — версия друга (2026-09-21, вечер)

Файл: `курсовой/2026-09-21/TZ_uporivatel_Long_Neck_033_GOST_predvaritelnye.docx`. Друг переписал ТЗ с нуля под замечания преподавателя: §2 — таблица 30 параметров (№/параметр/обозн./ед./значение/основание/статус), §4 — компоновочные требования, §6 — таблица 6 ГОСТов с «что берём». Проверил:

**Закрыто из списка преподавателя:** ТЗ-таблица ✅; шарнир — решено: «отдельный элемент не выделяется, пара реализуется осью/опорой» ✅ (закрывает открытый вопрос выше); Ra10–Ra20 ГОСТ 6636-69 ✅; площадь кольца + предел текучести (стр. 24) ✅; рукоятка из силы человека (стр. 27, §5) ✅; ход = зазор + запрессовка (стр. 25) ✅; 1,5·D_b = 90,6 мм (стр. 22) ✅; рукоятка входит в габарит (стр. 30) ✅; расчёты на предпроектном этапе (§5) ✅.

**Проверено по источникам:** ГОСТ 32624-2020 табл. 1 — h=6,00±0,15, d=26,75+0,15, D=32,10±0,20, z=21 — совпадает точно (fetch полного текста); ГОСТ ISO 12821-2023 — реальный, введён 01.12.2023, идентичен ISO 12821:2019; ГОСТ 32131-2021 — реальный; W=3·3−2·4=1 — верно. Ссылка на ГОСТ 32624 ведёт на internet-law.ru/…/gost_10715.html — «10715» это id страницы сайта, не номер ГОСТа, ссылка правильная.

**Замечания:**
1. Картинка крышки (§3) — перерисована сама (matplotlib-стиль), НЕ рисунок из ГОСТа; пропорции неверные (h:d нарисовано ≈0,6, реально 6/26,75≈0,22 — крышка втрое выше настоящей); подпись «D» наезжает на «Вид сверху». Преподаватель просил картинку ИЗ ГОСТа — лучше вставить настоящий рисунок 1.
2. Нет критерия «+5% над пределом текучести» (уточнение пользователя от 2026-09-21) — в стр. 24 стоит добавить σ_расч ≈ 1,05·σт.
3. n=3 (камень — отдельное звено) в ТЗ, а в 3D-модели камень — круглый палец, жёстко на ползуне (пара 4-го класса). Оба дают W=1, но ТЗ и прототип должны сойтись на одной реализации.
4. Ссылки на protect.gost.ru для ISO 12821 и 13345 — страницы пагинации (`page=1535&search=`), а не карточки документа; могут «уехать».
5. Косметика: «Long Neck» в заголовке vs «Longneck» в таблице.

**Why:** пользователь попросил проверить последний скачанный файл (2026-09-21).
**How to apply:** при следующей правке ТЗ — заменить картинку на настоящий рис. 1 ГОСТ 32624-2020 (или хотя бы исправить пропорции), добавить 1,05·σт в стр. 24, решить с камнем (отдельное звено vs палец на ползуне) и привести 3D-модель/ТЗ к одному варианту.

## Силовой расчёт F → рукоять (2026-09-27)

Документы друга от 27.09 (`Расчеты_и_вопросы_преподавателю_ПМ.docx`, `Итог_ПМ_подтвержденные_данные_и_вопросы_1.docx`): σт = 415 МПа взято от TH415/T4 (Tata Steel, EN 10202) как аналог ЭЖК ст. В 0,22 мм — ждёт согласования преподавателя; сам F друг не считал. Эскиз преподавателя в «Итоге» (перевёрнут): кольцо со стрелкой F + тангенсный механизм с размером e.

**Мой расчёт (пользователь попросил: σ+5% × площадь горлышка → F → L → соотношение):**
- Венчик 26 H 180 (ISO 12821, рис. 2): наружный **Ø26,55±0,25**, внутр. 16,5–18,0 → A_торца = 319,9 мм² → **F = 435,75·319,9 ≈ 139 кН** — физически невозможно (σ·A = сила сплющить сплошную стальную шайбу; зубцы крышки гнутся, а не сжимаются). Сечение юбки π·26,75·0,22 = 18,5 мм² → 8,1 кН. Реальный ориентир: патент US9327859B1 «450 lb force for application of conventional steel crowns» ≈ **2,0 кН**.
- Кинематика: y = e·tg φ, s = e/cos φ; сила F = P·L·cos²φ/e; рукоять **L = (F/P)(e + s_c²/e)**, s_c ≈ h_k = 6 мм.
- Оптимум: обжим при φ≈0 (кулиса ⟂ ползуну); при Δφ ≤ 30° e = S/tg30° = 26 → **Ra20 e = 28**, Δφ = 28,2°. L: 800 Н → 426 (Ra20 450) мм; 2 кН → 1066 мм; 139 кН → 74 м. При L=450 для 2 кН нужна P ≈ 130 Н.
- Если разрешить Δφ > 30° в ненагруженной зоне (угол давления ≤30° только на обжиме): e=16 → L(2 кН)=664; e=11 (теор. минимум) → 520 мм.
- Лекционный текст про «кривые 6-й степени / ≤1/20» — про шатунные кривые четырёхзвенника; у нас точная прямая (Δ=0). Нелинейность y(φ) к хорде при e=28: 3,3 % < 5 %. «Формула Гофмана» = Гохмана: k = p − n = 4 − 3 = 1.

**How to apply:** финальные F и L — только после ответа преподавателя, какое кольцо A и можно ли σт=415; показать ему цифры 139 кН / 74 м vs 2 кН. P ≤ 55 Н с реальными 2 кН даёт рукоять ~1 м — тоже вопрос.

**Файл расчёта (2026-09-27):** `курсовой/2026-09-27/Расчет_силовой_и_кинематический_тангенсный_механизм.docx` (9 стр., A4, стиль как у документов друга; генератор — scratchpad `build_calc_docx.py`) + `raschetnaya_shema_tangensnyi.png` + копии двух документов друга от 27.09. Сверка документов друга по первоисточникам: всё верно (ГОСТ 32624 пп. 4.1/5.2.1, ГОСТ 13345 табл. 2/5, ISO 12821 рис. 1, STLB п. 3.3.2 — pry-off 0,22/TH415/SR/61 HR). TH415 = 415 МПа подтверждён каталогом ArcelorMittal (EN 10202: T61/T4, CA, SR, 415±50 МПа, «crown corks»); ссылка друга на Tata Steel таблицы не содержит; σв=435 не подтверждено (не используется).

**ГОСТ 6636-69 (добавлено 2026-09-27, разд. 7 файла расчёта):** ряды сверены с текстом ГОСТа (meganorm). Приняты: S = 16 (Ra5; зазор 10 Ra5 + обжим 6 — не нормализуется, от высоты крышки), e = 28 (Ra20; Ra10 = 32 дал бы L 500), L = 450 (Ra20) при 800 Н, свободная зона 100 (Ra5), основание 200×160 (в ТЗ 150 — только Ra40), L ≈ 350 из ТЗ — лишь «дополнительный размер». Проверка: Δφ = arctg(16/28) = 29,7° ≤ 30°, L от S не зависит. Размеры бутылки/крышки/жести и углы ГОСТ 6636 не нормализует (п. 1).

### Проверка файла расчёта после обновления 27.09 (2026-10-01)

Пользователь попросил просмотреть последнее обновление на GitHub (коммиты 9193603 + 7fc1d06). **Ошибок нет.**
- Все числа пересчитаны независимо (A = 319,9 мм², F = 139 кН (126…153), юбка 8,1 кН, 450 lbf = 2,0 кН, табл. 4–6, Δφ/φоб, ход камня 4,25 мм, дуга 234 мм, нелинейность 0,585 мм = 3,7 %) — совпадают. Мелочь: в табл. 5 L(2 кН) при e = 20 и e = 11 — 793 и 519 мм (в файле 794 и 520); на выводы не влияет.
- ГОСТ 6636-69 сверен по HTML-таблице meganorm **по ячейкам** (пересказ страницы через WebFetch путал столбцы — например, ошибочно отнёс 150 к Ra20; для таблиц ГОСТов разбирать HTML самому). Цитаты пп. 1 и 4 дословные; 15 и 150 — только Ra40; 350 — дополнительный размер; Ra20 после 1000 — 1120; все принятые значения в заявленных рядах.
- Розовая заливка строк (FBE9E7) — намеренный стиль выделения во всём файле, не дефект.
- Замечания (не ошибки): (1) запас по углу качания 0,26°: при e = 28 предел 30° держится только до S ≤ 28·tg 30° = 16,17 мм — любое увеличение зазора потребует e = 32 (Ra10) или смягчения ограничения; (2) разд. 2–6 посчитаны для S = 15 (Δφ 28,2°, дуга 209 мм), разд. 7 — для S = 16 (29,7°, 234 мм) — стоит добавить итоговую таблицу принятых размеров; (3) ТЗ ещё не синхронизировано (S = 15, L ≈ 350, основание 200×150) — обновлять после ответа преподавателя, копией в папку с датой; (4) весь разд. 7 опирается на F = 800 Н из ТЗ — главный блокер по-прежнему вопрос преподавателю про кольцо/F (разд. 10).

**How to apply:** этот файл заново не перепроверять; следующий шаг — ответы преподавателя (разд. 10), затем итоговая таблица размеров и синхронизация ТЗ.

## Расчёт v2 — сила по обжиму юбки (2026-10-02)

Файл: `курсовой/2026-10-02/Расчет_силовой_и_кинематический_тангенсный_механизм_v2.docx` (11 стр.; генератор scratchpad `build_calc_docx_v2.py` = шапка v1 + `content_v2.py`). Версия 27.09 не тронута.
- «Кольцо» = сечение стенки юбки A = π·d_ср·s; F = n·σраб·A·ln(D_k/D_обж) (формула силы листовой штамповки, n = 1,5–2,0). D_k = 32,10 (ГОСТ 32624), D_обж = 28,6–28,8 (STLB прил. 6). Принято n = 2, D_обж = 28,6 → **F_ук = 1974 Н ≈ 2 кН**; сходится с патентом US9327859 (450 lb) и замером на Grifo (hobbybrauer.de: 120 Н × 18,4 ≈ 2,2 кН).
- Энергетика: путь руки на обжиме ≥ F·S_об/P = 215 мм — при P ≤ 55 Н рукоять обязательно длинная.
- Вариант А (Δφ ≤ 30°): e = 28, L = 1051 → **1120** (Ra20). Вариант Б (рекомендован, Δφ = 45°): e = 16, L = 655 → **710** (Ra20), φ_об = 20,6°. S = 16 (10 + 6). П. 25 ТЗ (800 Н) занижен в 2,5 раза.

## Сила руки — нормы (поиск 2026-10-02)

- **ГОСТ Р ЕН 1005-3-2010, табл. 1** (сверено по HTML meganorm Data2/1/4293800/4293800044.htm): F_B, Н, проф./быт.: кисть 250/184; одной рукой сидя вверх 50/31, **вниз 75/44**, наружу 55/31, внутрь 75/49; толкание с рукоятками 275/186, без 62/30; вытягивание с рукоятками 225/169, без 55/28; всем телом стоя толкание 200/119, вытягивание 145/96. Метод: F_R = F_B·m_v·m_f·m_d·m_r; m_v 1,0/0,8 (движение); m_f (≤3 с): ≤0,2/мин 1,0; 0,2–2 0,8; 2–20 0,5; >20 0,3; m_d ≤1 ч 1,0, 1–2 ч 0,8, 2–8 ч 0,5; m_r ≤0,5 рекомендовано, 0,5–0,7 не рекомендовано, >0,7 избегать. Для нас (вниз, 6 бут/мин): быт. 8,8 Н, проф. 15 Н (рекоменд.) — 55 Н из ТЗ по этому стандарту не обосновывается (55 = F_B «наружу»/«вытягивание без рукояток» проф. без множителей).
- **ГОСТ 21753-76, табл. 2** (рычаги управления, кгс не более; в скобках — «вверх-вниз»): всей рукой >960/смену 2; 241–960 3; 17–240 4; 5–16 6(4); <5 15(7); двумя руками 4,5; 9; 9; 9; 20(14).
- Замер: ручной укупориватель Grifo — макс. сила руки ≈ 120 Н (hobbybrauer.de).
- Рукоять при F = 1974 Н: P = 44 → 900/1400 мм (e = 16/28); 55 → 710/1120; 69 (7 кгс) → 560/900; 88 (2 руки, 9 кгс) → 450/710; 120 → 320/500 (Ra20).

## Расчёт v3 — P = 120 Н (2026-10-02)

Пользователь выбрал силу руки ≈ 120 Н. Файл: `курсовой/2026-10-02/Расчет_силовой_и_кинематический_тангенсный_механизм_v3.docx` (13 стр.; генератор scratchpad `make_v3.py` → `content_v3.py` → `build_calc_docx_v3.py`). Новый п. 5.1 с таблицей норм силы руки (ЕН 1005-3: 44/75, с множителями 9/15; ГОСТ 21753-76: 39 / 88 / 137 Н; замер Grifo 120 Н).
- F_ук/P = 1974/120 = 16,45; путь руки на обжиме ≥ 99 мм.
- **Рекомендован вариант А: e = 28 (Ra20), L = 482 → 500 мм (Ra10)**, Δφ = 29,7°, φ_об = 12,1°, сила руки 115,6 Н, дуга 260 мм, L/e = 17,9. Вариант Б: e = 16, L = 300 → 320 (Ra10), Δφ = 45°, 112,6 Н.
- ТЗ п. 19 (55 Н) и п. 25 (800 Н) нужно обновить — пока не трогали.

## Консультация 02–03.10 и расчёт v4 (2026-10-03)

Консультация (фото в Downloads 03.10): уменьшать e и угловой ход ψ при постоянном ходе; критерий — площадь треугольника O–Bн–Bк (O и крайние положения ползуна, высота = ход S = зазор + деформация); P вертикально, одной рукой, рычаг прямой; аналоги скорости/ускорения для характерных точек; трапеция ω(t): «до ω_max» (разгон) → «уст. дв.» → торможение с «нач. деф.» (начало деформации).
- A = ½·e·S (= разность треугольников от горизонтали) — зависит только от e; пользователь сомневался, проверено на 60°→40°: 280,6 − 135,9 = 144,7.
- Перебор `курсовой/2026-10-03/optimize_window.py`: φк −60…60, ψ 1…120 (шаг 0,1°), e 3…60 (0,1 мм) = 816 753 261 вариантов; ограничения L ≤ 500, e ≥ 10, |φ| ≤ 60°, P = 120 Н верт. (L = F·e/(P·cos³φ)). Без огр. ψ: e = 10, 60°→7,5°, ψ = 52,5° — пользователю «многовато». Анимация лучших вариантов: артефакт https://claude.ai/artifact/VXt93KQm4Mi2rMtqVxd3EP (копия animatsiya_okon_kulisy.html).
- **Выбран ψ ≤ 40°** → e = 11,7 → **12 (Ra10)**, окно **59,29° → 19,29°**, φоб = 40,36°, L = 446 → **500 (Ra10)**, сила руки 107 Н, A = 96 мм².
- ω(t): v_ср = 0,35 м/с и v_max = 0,7 м/с (Фех А.И. «Эргономика», ТПУ 2014, с. 46) → t_рх = 1,0 с, ω_max = 1,40, t_р = 0,472, t_у = 0 (вырождается), t_т = 0,525, ε = +2,97/−2,66. V_D max 29,2 мм/с; a_D max 136,5 мм/с²; V_K 0,70 м/с.
- Нелинейность y(φ) для окна 15,6 % > 1/20 — вынесено вопросом.
- Файл: `курсовой/2026-10-03/Расчет_силовой_и_кинематический_тангенсный_механизм_v4.docx` (16 стр.; генератор scratchpad content_v4.py + шапка build_calc_docx.py).

## Расчёт v5 — закон ω(t) по фазам деформации крышки (2026-10-05)

Пользователь: на фото консультации ω(t) — трапеция, «где прямая (горизонтальная площадка) — это упругая деформация»; всё по формулам. Слайды из `Final_presentation_with_seminars.pptx` (Семинары 9–12) — аналитический метод V = V_q·ω, a = ε·V_q + ω²·a_q совпадает с файлом; [ϑ] = 20° на слайде 93 — про другой (кривошипно-ползунный) механизм, угол НЕ трогать (пользователь: «стоп, ничего с углом делать не надо»).
- Фазы: разгон = холостой ход (до касания, φоб = 40,36°); площадка = упругая деформация юбки (Гук: ε_т = σт/E = 415/2,1e5 = 0,00198 → Δr = 0,032 мм → δ_у = Δr/tgα = 0,109 мм, tgα = 1,75/6); торможение = пластическая деформация (φу = 40,06° → 19,29°).
- ω_max = 0,7/0,5 = 1,40; t_р = 0,472, t_у = 0,0038, t_т = 0,518, Σ = 0,994 с; ε = +2,97 / −2,70; v_ср получается 0,351 м/с = 0,35 из Феха (независимая проверка).
- Файл `курсовой/2026-10-05/Расчет_силовой_и_кинематический_тангенсный_механизм_v5.docx` (17 стр.; генератор scratchpad make_v5.py → content_v5.py + шапка build_calc_docx.py).

**Сделано 2026-10-09 (было отложено): 3D-модель обновлена — v9, копия курсовой/2026-10-09/3d_model_v9.html; плоскости спереди назад: ползун+бутылка (z=0), кулиса (−0,22), стойка (−0,45); кнопка «Узел крупно»; движение по закону ω(t) v5.** Исходная задача: (артефакт https://claude.ai/artifact/9v6upATwdPYLdikvfoYe9o, исходник был в scratchpad старой сессии — при необходимости прочитать через Artifact read) под размеры v5: e = 12 мм, L = 500 мм, окно 59,29°→19,29°, ход 16 мм, бутылка 226,5×60,4, основание 200×160, ход камня по пазу 12,7→23,5 мм. Перевести модель из условных единиц в мм; узел у оси кулисы мелкий относительно рукояти — нужен крупный вид. Делать в новой сессии (оценка 40–60 тыс. токенов + правки).

## ИТОГ (09.10) и расчёт v6 (2026-10-10)

`курсовой/2026-10-09/…_ИТОГ.docx` — версия друга: v5 + раздел 6 заменён его фрагментом `triangle_optimization_section.docx` (A(φк, ψ) = S²/[2(tg(φк+ψ) − tg φк)], рис. 2–3, табл. 6 с ψ = 30…52,5°). Пользователь 10.10 прислал (Downloads\Telegram Desktop): фото рис. 3 A_min(ψ), «листик» с силовым расчётом (копии — `курсовой/2026-10-10/исходные/`), пример чужого курсового `преза last (2).pdf` (РК6-54Б бр.1, лесопильная рама; стр. 7 — проекции аналогов на x, y; стр. 9–10 — первичный силовой расчёт по звеньям и графики реакций от φ), лекции 6–7 и семинары 7–12 (сем. 11 — кинетостатика и порядок силового расчёта: 1) активные силы → реакции, 2) прочность → сечения/массы, 3) кинетостатика с инерцией, 4) трение…).

Просьбы: (1) нанести угловой ход на рис. 3 — «должен пересечь основной график примерно в 40°»; (2) скорость/ускорение ползуна — как проекции на оси ДСК (движемся против оси y); (3) затем силовой расчёт по листику.

**v6** = копия ИТОГ, правки скриптом `курсовой/2026-10-10/build_v6.py` (+ calc_v6.py, figs_v6.py, fig7_fbd.py, PNG рис. 3, 5–8). 27 стр.
- **Угловой ход:** ни одна честная нормировка не даёт пересечения ровно в 40° (min–max 35,5°, равные относительные уступки 36,8°, излом кривой 37,1°, «по участку 37–52,5°» 43,5°). Принято: равные относительные уступки δA = A/A* − 1 (A* = 80), δψ = ψ/ψ* − 1 (ψ* = 29,33°); прямая A*·ψ/ψ* на рис. 3 + правая шкала δ, %. Пересечение **ψ = 36,8°, e = 12,53, уступки 25,3 %** → e = 12 (Ra10) возможно с ψ ≥ 38,3° (L 480, P 115 Н) → принято 40° (L 446 → 500, P 107 Н, запас 11 %). В табл. 6 добавлены δA, δψ и строка 36,75°. Вопрос преподавателю вынесен.
- **Проекции ДСК:** 4.3 — V_qDx = 0, V_qDy = −e/cos²φ, a_qDy = 2e sinφ/cos³φ; K: V_qKx = L sinφ, V_qKy = −L cosφ, a_qKx = −L cosφ, a_qKy = −L sinφ; ω_z = −ω. Табл. 8, 9, рис. 5 — V_Dy, a_Dy (числа те же, что в v5: они уже были проекциями, менялись подписи).
- **Раздел 11 «Силовой расчёт механизма» (первичный, квазистатический, без масс/инерции/трения):** закон F(φ) по листику — 0 до касания (40,36°); упругий C = F_т/δ_у ≈ 17 300 Н/мм до φу = 40,06°; пластика k ≈ 16 Н/мм. F = σ·A_пр, A_пр = n·A·ln(Dk/Dобж) = 4,529 мм² → F_т = 1880, F_ук = 1974 Н (σmax = 1,05σт). Группа II(2,3), затем звено 1; ΣM относительно произвольной точки H (как сем. 11 и листик), при H = O → P = F·e/(L cos³φ). R21N = F/cosφ, R23 = (−F tgφ, F), R30N = −F tgφ, R10x = F tgφ, R10y = P − F, M21 = M30 = 0. Максимумы при φу = 40,06°: **P = 100,6 Н**, R12N = 2456, |R10| = 2380, |R30N| = 1581 Н, M в кулисе ≈ 37,3 Н·м; |R10y| max = 1917 Н в конце хода. Оценка инерции/веса рукояти (20×8×500 сталь): ≈ 0,6 Н и ≈ 3 Н силы руки. Разделы 11–15 → 12–16, табл. 10 → 12.
- Перед правкой docx: ИТОГ сделан в Word (w14-атрибуты, OMML в разд. 6) — правлю python-docx поверх копии, генератора content_v5 больше нет.

**Не расшифровано на листике:** надпись «9 — P сил + l длин рычага» с кривой «max разг» (возможно, замечание к разделу 9 — закон ω(t) из силы руки и длины рычага) — спросить пользователя. Нижний график листика (два горба и спад ниже нуля) похож на силу/момент с учётом сил инерции — это следующий этап (кинетостатика).

**How to apply:** следующий шаг — прочностной расчёт кулисы/камня/ползуна/оси O в положениях φ = 40,06° и 19,29° → сечения и массы → кинетостатика с инерцией по ω(t) п. 9 → трение. ТЗ (final-1 в `исходные/`) всё ещё не синхронизировано (S 15, L 350, P 55 Н, F 800 Н).

### v7 (2026-10-10, тот же день) — точка M, система 9 уравнений, L по max L_треб(φ)

Замечания пользователя к v6: (1) на рисунке со звеньями нужна точка M левее и выше всего, с осями от неё (как «H» на листике и «M» в сем. 11), чтобы моменты всех звеньев считать относительно неё; (2) полная матрица из 9 уравнений; (3) всё выразить через угол и построить графики; (4) максимальное значение (требуемой) длины рукояти принять за проектную длину; (5) «сила руки тоже должна быть от угла».

Файл `курсовой/2026-10-10/…_v7.docx` (29 стр.; build_v7.py = помощники build_v6 + v7_body; calc_v7.py, figs_v7.py, fig7_fbd_v7.py; рис. 4, 5, 7, 8, 9 — *_v7.png).
- Плечи от M: вправо x, вниз y (все положительны), проекции сил — по ДСК (x →, y ↑), момент M_M(F) = F_y·x + F_x·y (как в сем. 11: «R10x·y_M + R10y·x_M»). x_M = 50, y_M = 500 мм; D (x_M + e; y_M − e tgφ), K (x_M + L cosφ; y_M − L sinφ), a(φ) = X_D cosφ − Y_D sinφ.
- Неизвестные X = (R10x, R10y, R12N, M12, R23x, R23y, R30N, M30, **P**) — сила руки P(φ) неизвестная, L — параметр. Табл. 10 — матрица A(φ) и B(φ); |det A| = 117…401, решено для 40 001 угла, = аналитике, не зависит от M. (Сначала пробовал L как 9-ю неизвестную при P = 120 — на холостом ходе выходит L = 0 и R10y = +120 Н, бессмыслица; перешёл на P(φ) по замечанию пользователя.)
- L_треб(φ) = F(φ)·e/(120·cos³φ): max **419,25 мм при φу = 40,06°** → **L = 450 мм (Ra20)**; P(φ) ≤ **111,8 Н**. Окно ψ = 38,3° дало бы 451 → 500 мм — аргумент за ψ = 40° в 6.6.
- Каскад L 500 → 450 по всему документу: ω_max = 1,556; t_р 0,425, t_у 0,0034, t_т 0,466, Σ 0,894 с; ε +3,66/−3,34; V_Dy max −32,4 мм/с (φ 44,9°); a_Dy(0) = −168,5; V_r до 24,3 мм/с (касание 20,8), a_к = 64,8; F/P: 4,99/16,59/31,53; табл. 7, 8, 9, 12, п. 7.1, 9.3, 9.4, вопросы. Дуга руки 314, подъём 387 мм.
- Реакции при φу (L = 450): R10x 1581, R10y −1768, |R10| 2371, R12N 2456, R23 (−1581; 1880), R30N −1581, M12 = M30 = 0; конец хода: P 62,6, |R10y| 1911.
- **3D-модель v9 (L = 500) устарела** — при следующем обновлении перевести на L = 450.

### v8 (2026-10-10, вечер) — ψ = 36,75° вместо 40°, e = 12,53, L = 500, уравнения с φ ± 90°

Просьба пользователя: «пересчитай все углы, где у нас сошлись две линии — 36 с чем-то; угол 40 выкидываем; ты угол правильно считаешь? посмотри рисунок» (фото `Downloads\Telegram Desktop\photo_2026-10-10_22-45-54.jpg` — кусок листа: R12, M12 и дуга угла от горизонтали до R12N). Выбор пользователя: **e = 12,53 мм — точка пересечения** (не нормализовать; обоснование — п. 1 ГОСТ 6636-69: размер связан расчётной зависимостью e = S/(tg φн − tg φк)). Альтернативы, которые отверг: e = 13 (58,45→21,69, A 104), e = 14 (56,26→19,50, A 112, L 444→450), e = 12 требует ψ ≥ 38,3°.
- **Угол проверен по фото:** направление R12N — φ + 90° от оси x против часовой (как cos(φ1 + π/2) на листе), R21N — φ − 90°; в v8 уравнения записаны явно: R10x + R12N·cos(φ+90°) = 0, R10y + R12N·sin(φ+90°) − P = 0, камень — cos/sin(φ−90°); a(φ) = X_D·sin(φ+90°) + Y_D·cos(φ+90°); на рис. 7 — дуги углов.
- Файл `курсовой/2026-10-10/…_v8.docx` (29 стр.; build_v8.py = помощники v7 + v8_body, относительные пути; calc_v8.py → forces_v8.npz, kin_v8.npz; figs_v8.py нужен ещё amin_v6.npz из calc_v6.py; fig7_fbd_v8.py; рис. 2–9 *_v8.png). Коммит 7df230b.
- Окно 59,47° → 22,72°, A = 100,2 мм², уступки 25,3 %; φоб = 41,91°, φу = 41,63° (упругий участок 0,28°); L0 = 500 (оценка с F_ук при касании — точка лежит на ограничении L ≤ 500).
- L_треб max = **470,1 мм при φу = 41,63°** → **L = 500 мм (Ra10)**, P ≤ **112,8 Н** (запас 6 %). Реакции при φу: R10x 1671, R10y −1767, |R10| 2432, R12N 2515, R23 (−1671; 1880), R30N −1671, M = 40,7 Н·м; конец хода P 63,0, |R10y| 1911. |det A| = 129…425.
- Кинематика при L = 500: ω_max 1,40; t_р 0,438, t_у 0,0034 (3,4 мс — точно 3,448, не 3,5!), t_т 0,472, Σ 0,913 с; ε +3,20/−2,97; V_Dy max −31,9 (φ 45,3°), касание −31,7; a_Dy(0) −155,3; V_r до 23,9, касание 21,16, a_к 59,2; F/P 5,23/16,45/31,32 (φу 16,66). Нелинейность y(φ) 2,42 мм = 15,1 %. Дуга руки 321, подъём 431 мм.
- В табл. 6 строка ψ = 40° оставлена как точка сетки сравнения (30/35/40/45/50/52,5), принятый 36,75 выделен.
- Допущения поправлены: сила обжима постоянна только в выборе окна (пп. 5–7, в запас), в п. 11 — закон п. 11.2; «допустимая сила руки P_доп = 120 Н».
- **3D-модель v9 устарела:** L снова 500, но e 12 → 12,53 и окно 59,29→19,29 → 59,47→22,72.
- Аудит через Workflow (ultracode) 10.10 не прошёл — лимит сессии; можно перезапустить.

### v9 (2026-10-11) — независимая перепроверка v8

Пользователь: «перепроверь всё, что нарешал; ты переделал графики?». Файл `курсовой/2026-10-11/…_v9.docx` (29 стр.; build_v9.py = build_v8 + 4 правки, рисунки берёт из ../2026-10-10; verify_v9.py <docx> — независимый пересчёт и сверка). Коммит cdb0218.
- **verify_v9.py** считает всё заново другим способом (бисекция вместо сетки, своя матрица 9×9 строго по табл. 10, своё моделирование ω(t)) и сверяет строки текста и таблицы 3, 6, 7, 8, 9, 11, 12 + данные npz рисунков 3–9: **0 расхождений**; система 9 уравнений = аналитике до 1e-9 Н, от точки M не зависит; |det| 129…425.
- Ловушка: оптимизация окна (п. 6, табл. 6, ψ*, точка пересечения) считана при **F = 1974 Н** (как в п. 6.2), а не 1973,53 — с точной силой ψ* = 29,322, табл. 6 «уезжает» в 2-м знаке (ψ = 30: φк 6,79 вместо 6,75). ψ* = 29,3289 → 29,33; пересечение 36,754, A_c = 100,25 (на границе округления), принятое e = 12,53 → A = 100,24.
- Исправлено в v9: δA(ψ = 50) 2,9 → 2,8 % (было от округлённой площади 82,3); C = 1880/0,1087 ≈ 17 300 (с 0,109 вручную 17 250); подпись рис. 1 — F_ук там сила головки на крышку (вниз), на ползун — такая же вверх (рис. 7); дата 11.10.2026.
- Рисунки: 2–9 в документе — v8 (проверено по md5 картинок в docx); рис. 1 — общая схема ИТОГ без чисел. Отдельный 3D-график площади был со старым «ψ = 40° принято» → `2026-10-11/fig_area_3d_v9.png` (fig3d_v9.py), точка ψ = 36,75°.
- Ещё не обновлено: 3D-модель механизма (`2026-10-09/3d_model_v9.html`, артефакт 9v6upATwdPYLdikvfoYe9o) — окно 59,29→19,29, e = 12; нужно 59,47→22,72, e = 12,53, L = 500.

### v10 (2026-10-11/12) — раздел 12 «Прочностной расчёт звеньев»

Просьба: «сделай копию файла и в ней сделай прочностной расчёт как в примере». Пример — `Downloads\Telegram Desktop\преза last (2).pdf` (РК6-54Б бр.1, стр. 11–18): положения по экстремумам графиков → эпюры N, Q, M (онлайн-калькулятор) → сечение кулисы (полый прямоугольник, A = bH − bh, σ = N/A + M/W ≤ [σ] = σт/n, «код» по ГОСТ 6636-69) → распределение h вдоль кривошипа → массы из 3D. Семинар 12 (sem12.pdf): σ = N/A, σ = M/W + N/A, W = I/y_max, J = bh³/12, W = bh²/6, эпюры Q, N для шатуна.
Файл `курсовой/2026-10-11/…_v10.docx` (39 стр.) = копия v9 + разд. 12; build_v10.py (SRC = v9 в той же папке), calc_v10.py → strength_v10.json, figs_v10.py → рис. 10–14 (*_v10.png), verify_v10_strength.py (МКЭ местного изгиба + формулы) — расхождений нет; verify_v9.py на v10 — 0. Коммит 07a4cd2. Разделы 12–16 → 13–17, табл. «Принятые параметры» → 17.
- Сталь 45 (ГОСТ 1050-2013, σт 355, σв 600), [n] = 2,5 → [σ] 142, [τ] 85; [p] = 30 МПа для подвижных соединений — ориентировочно (источник не нашёл), вынесено в вопросы.
- Опасное φу = 41,63°: N = −75,0 Н, Q(O–D) = −2430,5, Q(D–K) = +84,3, |M_D| = 40,75 Н·м (= P(L cos φ − e)); φк: 28,27 Н·м.
- Палец D Ø12 (консоль, плечо 6 мм, изгиб 87,3 МПа), камень 18×18×10 (p 14,0), ось O Ø16 (плечо 22 мм, 130,6 МПа), ступица Ø32×16.
- **Компоновка у оси O:** при e = 12,53 камень в конце хода в 4,58 мм от оси; ось Ø12 с бобышкой R9 в одной плоскости → перекрытие 4,4 мм, нужно e ≥ 17,5 мм. Принята составная кулиса: ступица позади планки, паз в планке перед ней (a1 = 3,6, a2 = 34,7 мм). Вопрос преподавателю: так или увеличить e (тогда повтор разд. 6).
- Сечение А–А (b = 10, w = 18): определяет местный изгиб стенки паза (балка с заделками, пролёт 31,1); H = 32 → 144,7 МПа (не проходит), принято H = 36 (Ra20): 91,6 МПа (φк 73,8). Рукоять: профиль 36 → 16 на 100 мм, далее 10×16; σ ≤ 72,7 МПа; прогиб K 2,6 мм.
- Шток ползуна Ø16×60: σ = 9,8 МПа, λ = 30. Массы: m1 = 0,833 кг (zS 194,7 мм, J_O 0,0528, J_S 0,0212), m2 = 0,017, m3 = 0,275 кг.
- 3D-модель механизма (09.10, v9 html) всё ещё в старых размерах; 12.10 пользователь просил её открыть — открыта (Start-Process).
**How to apply:** следующий этап — кинетостатика с массами табл. 16 (сем. 11, п. 3), затем трение и проверочный расчёт; ждать ответа преподавателя по компоновке у оси O и [p].

### Примеры чужих курсовых и сверка v10 (2026-10-12)

Пользователь загрузил примеры (копии в `курсовой/примеры/`): **РПЗ РК6-52Б-1** (тот же кулисный тангенсный механизм: AB = k·sec α, y = k·tg α; посадка семян) + его презентация «курсач-преза»; **РПЗ.pdf** (РК6-51Б бр. 2, кривошипно-ползунный, выдвижная полка) + «Презентация.pptx (1).pdf».
Структура примеров: титул, реферат, содержание, введение (назначение, цель, задачи) → поисковая НИР (назначение, качественные/количественные критерии, исходные данные) → эскизное проектирование (структурная схема, метрический синтез варьированием, кинематика: аналоги V_q, a_q всех ключевых точек графиками по φ, V = V_q·ω, a = a_q·ω² + V_q·ε) → первичный силовой (без масс, равновесие каждого звена, СЛАУ в матричной форме, графики реакций, самое нагруженное положение) → определение сечений/прочностной ([σ] = σт/n, эпюры, затем сортамент по ГОСТ) → **уточняющий силовой** (+ m·g, Ф = −m·a_S, M_Ф = −J·ε, сравнение с первичным) → **рабочее проектирование** (3D-модели звеньев в КОМПАС, МКЭ напряжений/перемещений, оптимизация, чертежи, сборка) → заключение, источники; презентация ~12–14 слайдов, прототип на 3D-печати.
Вывод сверки: разделы v10 по методике совпадают с примерами (кинематика, СЛАУ 9×9, эпюры N/Q/M — у нас подробнее). **Нет:** уточняющего силового расчёта с инерцией; 3D-моделей звеньев/МКЭ/чертежей/сборки; оформления РПЗ (титул, реферат, содержание, введение, критерии, заключение); графиков аналогов по φ для всех точек (у нас таблицы + график ползуна). Рабочие разделы (сверка источников, вопросы преподавателю, применимость лекций) в итоговую РПЗ не переносить.

**3D-модель обновлена под v10 (2026-10-12):** артефакт 9v6upATwdPYLdikvfoYe9o, версия 10; копия `курсовой/2026-10-12/3d_model_v10.html`. e = 12,53, окно 59,47→22,72, L = 500; составная кулиса (планка 10 мм, сечение 36 → 10×16, паз 18 от 3,6 до 34,7 мм; ступица Ø32×16 позади планки на консольной оси O Ø16 от стойки); камень — брусок 18×18×10, поворачивается вместе с кулисой; палец D Ø12 консолью от штока Ø16, заканчивается в камне (за планку не выходит — иначе упирается в ступицу); плоскости: шток/бутылка/втулки z = 0, планка −14 мм, ступица −19…−35, стойка от −37; втулки направляющих только перед планкой, кронштейны к стойке ниже ступицы; ω(t) v8 (t_р 0,438, t_у 0,003448, t_т 0,472).

### v11 (2026-10-23) — прочностной расчёт переделан по схеме консультации 19.10

Пользователь (19.10, видимо по итогам консультации): «силовой расчёт норм»; прочностной — опасные положения → эпюры N, Q, M → σ = |N|/A + |M|/W ≤ [σ] (A = b·h, W = b·h²/6) → размеры по сортаменту (пруток — перебор, лист — b известно, h из уравнения) → из этого материал. 23.10: «делай, прошлый прочностной расчёт удали».
Файл `курсовой/2026-10-23/…_v11_квадратный_камень.docx` (42 стр.; в 2026-10-19 лежит только исходная копия v10, сделанная 19.10): build_v11.py (SRC = v10 из 2026-10-11, вырезает старый разд. 12 со всеми картинками и вставляет новый), calc_v11.py → strength_v11.json, figs_v11.py → рис. 10–14 *_v11.png, verify_v11_strength.py (независимо, местный изгиб — аналитически) — расхождений 0; verify_v9.py из 2026-10-11 на v11: таблицы 0, текст — только дата (11.10 → 23.10, намеренно).
- Структура разд. 12: 12.1 порядок, марки стали (табл. 12: Ст3сп ГОСТ 14637-89 σт 245; 35 и 45 — ГОСТ 1050-2013 табл. 4: 315/530, 355/600; 40Х — ГОСТ 4543-2016: 785/980), [n] = 2,5, [τ] = 0,5[σ]; 12.2 опасные положения (табл. 13, 14): φу = 41,63° — всё, кроме штока, φк = 22,72° — шток; 12.3 эпюры (рис. 10–12); 12.4 пруток — перебор по ГОСТ 2590 (табл. 15); 12.5 кулиса из листа — h, H из уравнения, местный изгиб стенки паза (рис. 13); 12.6 выбор материала (табл. 16 — все детали из одной марки при b = 8; табл. 17 — проверка принятого), перегрузка; 12.7 массы (табл. 18); 12.8 итоги. Сводка стала табл. 19. Ссылки «п. 12.7» в 11.1/11.7 остались верными (массы).
- Принято: кулиса (планка + ступица) — Ст3сп, лист 8 мм: рукоять 8×18 (91,5 МПа), зона паза H = 36, паз w = 16, стенки t = 10 (93,6 МПа: общий 26,3 + местный 67,3, M_м = 8,97 Н·м в заделке у a1) при [σ] 98; детали из прутка — сталь 45 ([σ] 142): палец D Ø10 (128,1, τ 42,7), ось O Ø16 (127,0) + ступица Ø32×16, камень 16×16×8, шток Ø12 (17,4 МПа; условие малой гибкости λ ≤ 40 при μ = 2, l = 60 — по прочности хватило бы Ø5, но λ = 96).
- Выбор материала: 40Х даёт рукоять 8×10 и прогиб конца 16,8 мм (E одинаков у всех сталей) + закалка длинной детали → нет; 45 для кулисы −0,13 кг, но прогиб ×1,6 → кулиса Ст3сп (прогиб 2,8 мм); для пальцев/оси сталь 45 (Ø10/Ø16 вместо Ø11/Ø18 → меньше камень и паз). Лист 8 мм: при 6 мм кулиса легче на 8 %, но давление палец–камень 47 МПа (при 8 мм — 31); при 10 мм +12 % массы.
- Перегрузка (головка упёрлась в конце хода, рука 120 Н): F = 3758 Н, все нагрузки в φк ×1,90 → кулиса до 142, пальцы до 208 МПа < σт; запас по текучести ≥ 1,7 — так обосновано [n] = 2,5. Вопрос преподавателю — нужен ли упор хода.
- Массы: m1 = 0,718 кг (планка 0,643 + ступица 0,076), z_S = 199,1 мм, J_O = 0,0472, J_S = 0,0188 кг·м²; m2 = 0,011; m3 ≈ 0,315 (ориентировочно: направляемая часть 24×40×16, палец, шток Ø12×60, головка Ø40×24).
- Новые вопросы (разд. 16, №11–15): материал Ст3сп/45 и [n]; упор хода; составная кулиса (камень в конце хода в 5,6 мм от O); [p] для шарниров (камень–паз 19,6, палец–камень 31,4, ось–ступица 9,5 МПа); МКЭ для стенки паза.
- Важно для 3D-модели: в силовом расчёте реакция направляющей ползуна — на уровне пальца D (M30 = 0), поэтому шток считается только сжатым. В 3D-модели v10 обе втулки ниже кулисы — шток был бы консолью под 1,67 кН поперечной силы; при обновлении модели направляющую делать на уровне D. Модель (артефакт 9v6upATwdPYLdikvfoYe9o) ещё в размерах v10.
**How to apply:** дальше — уточняющий силовой расчёт с массами табл. 18 (сем. 11, п. 3), обновление 3D-модели под v11, ответы преподавателя по вопросам 11–15.

### Вариант с камнем-роликом (2026-10-23) — отдельный файл
Пользователь: «почему камень стал квадратом, он же был круглым» (круглым — ролик в 3D-модели v9 от 09.10; брусок-сухарь появился в v10). Объяснил: ролик касается стенки паза по линии, σH по Герцу ≈ 1200 МПа для Ø16 × 8. Попросил **отдельный файл с круглым**, причём в самом файле **не писать «выбрали круглый как просили» и не объяснять, почему круглый** — переделать так, будто бруска не было.
Файл `курсовой/2026-10-23/…_v11_круглый_камень.docx` (43 стр.): build_r.py (SRC = v10), calc_r.py → strength_r.json, figs_r.py (рис. 12–14), fig7_fbd_r.py (рис. 7: звено 2 — круг), fig1_roller.py (рис. 1 из v10 с роликом в точке D), verify_r.py — расхождений 0; verify_v9 — таблицы 0.
- п. 4.1: камень — ролик на пальце D, пара 1–2 высшая, при структурном анализе заменяется поступательной (ПВП, W = 1 сохраняются); раздел 11 не менялся (M12 = 0 и так).
- Контакт: σH = 0,418·√(F·E/(b·ρ)); ГОСТ 21354-87 (проверено по PDF files.stroyinf.ru): табл. 12 σHlim = 2НВ + 70 (< 350 НВ) или 17·HRC + 200 (38…50 HRC), табл. 11 SH = 1,1 / 1,2, п. 3.2.2 σHPmax = 2,8σт / 44·HRC; Z_N = 1. Без закалки [σH] < 700 → ролик ≥ Ø31,4 при b = 12 → закалка ТВЧ ролика и стенок паза HRC 45…50 → [σH] = 840 → материал всех звеньев — сталь 45 (лист по ГОСТ 1577-93).
- Перебор листа (табл. 15): b 6/8/10/12 → ролик Ø45/36/28/22, H 71/56/45/40, m1 0,81–0,85 кг, прогиб 1,7…5,0 мм; принят **b = 12**: ролик Ø22 × 12 (σH = 836 ≤ 840; перегрузка 1064 ≤ 2090), рукоять 12×12 (136,2 МПа), зона паза H = 40, паз 22 со скруглёнными концами (t = 9; 91,5 МПа: 15,6 + 75,8, местный M = 12,29 Н·м при сосредоточенной силе), палец D Ø11 (134,7), ось O Ø16 (139,1, плечо 23), шток Ø12. m1 = 0,850 кг (J_O 0,0477), m2 = 0,027, m3 ≈ 0,321.
**How to apply:** два параллельных файла v11 в `курсовой/2026-10-23` — …_v11_квадратный_камень.docx (build_v11.py) и …_v11_круглый_камень.docx (build_r.py); пользователь выберет. Правки — в соответствующий build-скрипт.

### Трение — только прикидка (2026-10-23, пользователь: «не надо пока ничего»)
В v11 трения нет (разд. 15: η = 1, «запас 6 % для трения»). Прикидка для квадратного камня при φу (трение в пазу, в направляющей ползуна, в шарнирах O и D, f одинаковый): f = 0,05 → R12N 2768 Н, P ≈ 129 Н (L для 120 Н ≈ 540 мм); f = 0,10 → 3096 Н, P ≈ 150 Н (L ≈ 620 мм). Запаса 6 % не хватает. Если попросят — предложенные варианты: только трение / трение + инерция; при P > 120 — удлинить L, оставить 500 и указать силу, или снизить трение (смазка, бронзовый камень). Новый файл — в папку дня правки.

### v13 (2026-10-24) — по замечаниям преподавателя, единственный актуальный вариант
Замечания: эпюры на истинном (наклонном) положении звена; оси/пальцы на срез — потом в моделях (из расчёта убраны); шток — на устойчивость с критической силой; масса и J камня не нужны; e ≈ 1 см → камень снаружи рычага (обойма), не в пазу. Пользователь: «теперь только этот вариант, ни квадрата, ни круга».
Файл `курсовой/2026-10-24/…_v13.docx` (39 стр.): build_v13.py (SRC = v10), calc_v13.py → strength_v13.json, figs_v13.py (рис. 10–13), fig7_fbd_v13.py, fig1_scheme_v13.png (ровная опора под O); verify_v9 — таблицы 0.
- Кулиса — сплошная полоса Ст3сп 8×18 (h_треб 17,71; σ 94,8 ≤ 98; τ 25,3; прогиб 4,0 мм), обойма камня 20 мм, p = 15,7 МПа; паза и ступицы нет.
- Шток Ст3сп: λ = μl/i, μ = 2, l = 60; Ясинский (a 310, b 1,14) при λ < 100, Эйлер при λ ≥ 100; [n_у] = 3. Ø6 проходит по рабочей силе (n 3,13), но при перегрузке 3758 Н n = 1,65 → принят Ø8: λ 60, F_кр 12 144 Н, n_у 6,15 (перегрузка 3,23).
- Массы: m1 = 0,573 кг (J_O 0,0471), m3 ≈ 0,27; камень не учитывается.
- Не сделано: v12 с новым рис. 1 не пересобран (файлы были открыты в Word) — неактуально, v13 его заменяет.

### v14 (2026-10-24) — те же расчёты, рисунки без наложений (актуальная версия)
Пользователь: «рисунки и обозначения пересекаются, некоторая часть как будто обрезана». `…_v14.docx` (39 стр.), build_v14.py (= build_v13 + замены). Рисунки: figs_v14.py (10–13), fig7_fbd_v14.py, fig1_v14.py (растр v13: подписи L·cos φ, F_ук, φ_н перенесены, штриховка восстановлена зеркально, x_лев + x_прав = 930), figs_kin_v14.py (рис. 4, 5).
- Нумерация: камень-обойма теперь рис. 12 (в п. 12.4), шток — рис. 13 (в v13 было наоборот, не по порядку).
- Рис. 12: кулиса целиком + выносной элемент А (круг) + сечение Б–Б; разрыва полосы больше нет (пользователь не любит линии обрыва). R12N действует на кулису по +n → рабочее ребро — нижнее (в v13 стрелка была сверху — ошибка).
- Эпюра Q — «ординаты без масштаба» (участок D–K 84 Н против 2430 Н на O–D иначе не виден); на схеме R10y — модулем, стрелка в истинную сторону.
- Грабли: calc_v8.py (данные kin_v8.npz для рис. 4, 5) импортирует scipy, а его нет — запускать с PYTHONPATH на заглушку scipy/optimize.py (brentq делением пополам) во временной папке; npz в репозиторий не кладутся.

### v15 (2026-10-26) — повторная проверка «всего», актуальная версия
`курсовой/2026-10-26/…_v15.docx` (39 стр.), build_v15.py берёт рисунки из своей папки, иначе из 2026-10-24 (там же strength_v13.json). figs_v15.py — рис. 3 (подпись «принято» не перекрывает штриховые ограничения), 6 (вставка не на оси и не на скачке силы), 8 (выноска к точке снизу); данные amin_v6.npz (calc_v6.py) + forces_v8.npz. В тексте добавлены ссылки на таблицы 17 и 19; «Рабочая версия от 26.10.2026».
- Проверено: все 13 рисунков — нужные файлы, порядок рисунков и ссылок, в тексте нет паза/ролика/ступицы/срезного расчёта, вёрстка через Word без отрывов подписей.
- Открыто (не трогал, спросить): в исходных разделах 1–8 у таблиц 1–9 нет ссылок в тексте до таблицы (табл. 3, 7, 8, 9 не упомянуты вовсе).

### ЗАДАЧА НА ПОТОМ (2026-10-26, пользователь: «пока просто запиши»)
Изменить геометрию камня: обойма должна охватывать кулису со всех сторон, чтобы кулиса не выскакивала. Сейчас обойма C-образная — открыта со стороны стойки (верхняя, нижняя и передняя стенки, задней нет), см. рис. 12 и 3D-модель.
Учесть при переделке: открытая сторона была нужна, потому что в конце хода (φк) край обоймы подходит к центру оси O на 3,58 мм, а ось O (Ø10) с распорной втулкой (Ø16) входит в кулису как раз со стороны стойки — закрытая задняя стенка в них упрётся. Тогда менять что-то из: длину обоймы l_к = 20, ось O (с другой стороны / короче), задняя стенка не сплошная (губки, заходящие за задние кромки полосы). Затронет: рис. 12, текст п. 12.3–12.4, 3D-модель.
**Закрыто пользователем 30.10:** в рис. 12 поверх старого сечения «в)» вставлен (плавающий) рисунок — обойма с губками, заходящими за задние кромки полосы. 3D-модель ещё с C-образной обоймой.

### v18 (2026-11-02) — формулы Word, матрица 9×9, рис. 14 из 9 графиков (актуальная версия)
Просьба: «все формулы красиво через LaTeX; вместо табл. 20 — матрица 9×9; графиков 9». `курсовой/2026-11-02/…_v18.docx` (47 стр.) = постобработка v17 скриптом build_v18.py.
- Формулы: formulas_latex.py — LaTeX всех 103 выносных формул по порядку (сверка по началу текста; список — list_formulas.py), omml.py: latex2mathml 3.77.0 (поставлен pip) → правка MathML (склейка 1,05; cos/sin/tg с применением функции и тонким пробелом; \quad → символы пробела; прописные греческие прямо; pmatrix → mfenced) → `C:\Program Files\Microsoft Office\root\Office16\MML2OMML.XSL` → OMML 14 пт, cases — столбцы влево. Итого 109 формул Word (6 разбиты на 2 строки, закон обжима 11.2 — система с фигурной скобкой). Линейные формулы друга в п. 6.1–6.2 тоже переделаны (tan → tg).
- Табл. 20 → матричное уравнение A(φ)·X = B(φ) (11 пт), B3 = G1·XS − Ф1y·XS − Ф1x·YS − MФ1 строкой ниже; табл. 21–23 → 20–22; таблицы разд. 13 не разрываются (keepNext).
- Рис. 14 (figs_v18.py → fig14_unknowns_v18.png): 3×3 как рис. 9, первичный штрихом, уточнённый сплошной, разность — оранжевая правая шкала.
- Обозначения: R10x/R23x → R с нижним 10 и верхним x везде (как в разд. 11 и на рисунках).
- Проверка: verify_v9 — таблицы 0 (текстовые «не найдено» — формулы теперь в m:t); числа всех формул v17 = v18 (кроме 17 300 с тонким пробелом и степеней ²/³ из п. 6).
- Дальше правки формул — через formulas_latex.py / build_v18.py; новые формулы — omml.math_paragraph(LaTeX).
- **v20 после правки пользователя** (02.11, 12:29): пользователь сам удалил п. 12.6 «Проверка принятых размеров» с таблицей 17 и попросил «просто обнови v20» (правка на месте, без новой версии; его вариант закоммичен отдельно 69d9795). renum_v20.py: таблицы 18–22 → 17–21, пп. 12.7/12.8 → 12.6/12.7, «п. 12.7» → «п. 12.6»; ссылка про перегрузку в 12.1 → п. 12.5, в сводке «Наибольшие напряжения» → пп. 12.4, 12.5. Таблиц теперь 21 (сводка — 21).
- **v20** (тот же день, актуальная): рис. 12 перерисован (fig12_v20.py, build_v20.py поверх v19) — сечение Б–Б с губками прямо в рисунке, палец D заодно с обоймой (общий контур, цвет и штриховка, на виде А торец пальца закрашен); плавающая картинка пользователя поверх рис. 12 удалена; в подписи «палец D выполнен заодно с обоймой». Проверено 02.11: таблицы v19 = файл пользователя 30.10, кроме строки камня в табл. 17 ([p] = 24, «проходит» вместо «—», «см. вопросы») и строк сводки; Downloads\Kursovoy_Proekt_Prikladnaya_Mehanika*.docx — обрезки начала расчёта (табл. 1 без изменений). Пустые скобки на фото с телефона — его просмотрщик не показывает объекты-скобки и матрицы формул Word; пользователь: «с формулами всё норм».
- **v19** (тот же день): рис. 14 — только уточнённый расчёт, без штриховой первичной и оранжевой разности (просьба пользователя), figs_v19.py + build_v19.py поверх v18; подпись и ссылка в п. 13.6 «(первичного — на рисунке 9)».

### v21 (2026-11-04) — замечания преподавателя, актуальная версия
Замечания (конспект пользователя): крайние положения тонкими линиями; разрез исправить — продлить линию, сплошной цвет без штриховки; «главный вектор / главный момент сил инерции»; пустой кружочек → точка; схемы по ЕСКД, звено — палочкой; расчёт кинематических пар — отверстия на срез и смятие («считали только для центров»); [τ] крепежа ≤ 50 МПа.
Файл `курсовой/2026-11-04/…_v21.docx` (52 стр.) = постобработка v20 скриптом build_v21.py. Мои трактовки (сказать, если преподаватель имел в виду иное): крайние положения — тонкие штрихпунктирные с двумя точками (ГОСТ 2.303) на рис. 1 и 12б; «продлить линию» — ось пальца через всё сечение Б–Б; секущая плоскость перенесена на ось пальца D (раньше шла мимо пальца, а он был в сечении); «кружочек → точка» — на расчётных схемах (рис. 7, 10, 11, 13) шарниры и центры масс закрашенными точками, на кинематической схеме рис. 1 шарниры остались кружками по ГОСТ 2.770.
- Рисунки: fig1_v21.py (новая кинематическая схема с нуля: стойка-опора, кулиса линией, камень прямоугольником, шток в направляющей, головка поперечной линией; рабочее положение φ = 48° на холостом ходе), fig_fbd_v21.py (рис. 7 и 13, на рис. 13 — легенда «главный вектор/момент»), figs_epury_v21.py (exec figs_v14 с точками), fig12_v21.py (без штриховки, Ø10, ступица штриховой), fig14_v21.py (exec figs_v19 по calc_v21.npz).
- Новый **п. 12.6 «Кинематические пары: срез и смятие»** + табл. 17 (calc_v21.py: exec calc_v17 с массой ступицы + проверки): ось O и палец D Ø10, сталь 45, [τср] = 50 (0,5·142 = 71 → ограничение 50); τ 31,0 / 32,0; Ø8 — на пределе (50,0). [σсм]: подвижное 24, неподвижное (ось в стойке, лист Ст3сп 12 мм) 65 (Inventor: fixed 84/65/50, sliding 30/24/12; τA пальцев 11 373: 50/35/25, 11 500: 70/50/35). **Отверстие кулисы на оси O: 2432/(10·8) = 30,4 > 24 — не проходит** → ступица Ø16 × 12 приварена к кулисе вместо распорной втулки, l = 20, 12,2 МПа; больший d нельзя (d ≥ 12,7 → перемычка 2,7 мм, τ 57 > 49). Перемычки: кулиса c = 4 → 38,0; ползун c = 7, s = 16 → 11,2; стойка 20,3; ползун–палец 15,7; 3–0: 2,6 МПа. Перегрузка ×1,90: τ 50,5 / 51,9 < 0,5σт = 177,5.
- Ступица (11,5 г на оси O) → m1 = 0,585, zS = 241,6, JS = 0,0130, G1 = 5,74; m1·zS и JO те же → P, R не меняются; в табл. 19 MФ1 0,0415 / −0,0385, в табл. 20 R10y −1761 / −1861. Перенумерация: пп. 12.6–12.7 → 12.7–12.8, табл. 17–21 → 18–22.
- 3D-модель v21: patch_3d_v21.py → 3d_model_v21.html, артефакт 2LV9g7o2g8fChrYMYRXPHw версия 3 (ступица в группе кулисы, палец D через ползун 16 мм); ярлык на столе не менялся.

### v22 (2026-11-04, тот же день) — правки пользователя к рисункам v21, актуальная версия
Пользователь: «звено 3 тоже палка»; «стойка не ровная — угол не 90°» (треугольная опора у O на рис. 1 → вертикальная стойка на основании, как в v13–v14); «в разрез палец не попадает — заштриховать как раньше, без пальца, цвет пальца как сейчас» → «разрез Б–Б»: секущая плоскость снова рядом с пальцем (cy + 6), обойма и полоса со штриховкой и светлой заливкой v20, палец D за плоскостью — без штриховки, цвет #e8c99a; ось пальца продлена. Значит, «без штриховки» у преподавателя относилось к пальцу, а не ко всему разрезу.
Файлы: fig1_v22.py, fig_fbd_v22.py (звено 3 — только линия, без прямоугольника и головки), fig12_v22.py; build_v22.py = exec build_v21 с другими DST/рисунками/подписями 7 и 12. Текст и расчёт — как в v21. v21 оставлен (был открыт в Word).
3D-модель v22 (patch_3d_v22.py → 3d_model_v22.html, артефакт версия 4): ступица голубая (matHub, в allMats для разреза), в легенде, на панели блок «Что изменено» — пользователь не понял по v21, что поменялось.

### v23 (2026-11-04) — разрез Б–Б: обойма и палец одного цвета, актуальная версия
Пользователь: «ты вернул старое, а нужно, чтобы камень и палец были одного цвета». fig12_v23.py: обойма — цвет пальца #e8c99a со штриховкой ////, кулиса — #c9d4e3 со штриховкой (цвета вида б), палец за плоскостью без штриховки. build_v23.py = exec build_v22 (меняет DST и рис. 12). Вопрос «может ли камень с пальцем быть одной деталью» — ответил: да (обойма с цапфой из стали 45 или палец, запрессованный и приваренный в обойму, — неразъёмная деталь); обойма надевается на полосу с конца K до установки ручки, палец D держится в ползуне стопорным кольцом.

### Модели в КОМПАС-3D v25 (2026-11-04) — `курсовой/2026-11-04/kompas/`
Пользователь: «смоделировать звенья в компасе, чтобы ручка не могла опуститься ниже и механизм работал»; выбрал: строю скриптом через API, оба упора неподвижные (не регулируемые), пружину пока не делаем.
- kompas_build.py (API5, COM к уже запущенному kStudy.exe — сам COM-сервер не стартует, «Ошибка при выполнении приложения-сервера»; скрипт запускает kStudy.exe и ждёт) → 10 деталей .m3d: УКП.00.001 Основание, .002 Стойка (лист 12, x −49,47…42,53, y до 62), .003 Ось O Ø10, .004 Направляющая (планки у боковых граней ползуна + кронштейны к стойке), .005 Упор нижний (грань по нижнему ребру кулисы при φк, r 30…42), .006 Упор верхний (по верхнему ребру при φн, r 45…57); .01.001 Кулиса со ступицей, .01.002 Ручка (Ø26, x 402,5…497,5), .02.001 Камень с пальцем D, .03.001 Ползун. Неподвижные — в координатах сборки (начало — ось O, z как в 3D-модели), подвижные — в своих («O, x вдоль кулисы», «D»).
- kompas_assembly.py (API7) → УКП.00.000 Укупориватель.a3d: 11 сопряжений; угол кулисы — mc_Angle XZ кулисы ↔ XZ сборки с IMateInterval (UseInterval, SetValueRange 22,72…59,47); камень — XZ ↔ XZ кулисы; ползун — YZ на расстоянии e от YZ сборки; палец — соосность. Проверки: угол задан сопряжением (диапазон выключен) — y ползуна = e·tg φ точно; 15° → 23,09°, 70° → 59,09° после включения диапазона. С включённым диапазоном ParamValue не двигает механизм; Placement у сопряжённых деталей скриптом не меняется; повторное Save/SaveAs открытой сборки — «Ошибка на сервере», поэтому сборка проверяется и сохраняется в том же запуске (положение φу).
- geom_check.py — соударения по геометрии на 241 положении: нет; упоры касаются кулисы ровно в φк и φн; мин. зазоры 0,5 (обойма–полоса, ползун–направляющая), 2,5 мм (нижний упор–обойма). API-проверка соударений (IMeasurementContainer.Collisions) падает — нет способа задать объекты.
- Массы КОМПАС: кулиса 577,6 г (расчёт 584,7 — без вычета отверстия), ползун 371 г (в расчёте ориентировочно 270 — головка Ø40×24 сплошная), камень 43,7 г.
- В КОМПАС у пользователя были открыты свои документы ПТП (Деталь.m3d с несохранёнными изменениями) — не трогал.
- Пружина (ответ пользователю): нужен момент ≈ 1,25 Н·м вверху / 2,0 Н·м внизу (вес 0,83 / 1,32 Н·м × 1,5), сила руки +4,3 Н → ≈ 114 Н; обязателен верхний упор; варианты — кручения на оси O, растяжения кулиса–стойка, сжатия на штоке (до 134 Н).

### КОМПАС, переделка (2026-11-04, вечер) — детали отдельно, сборка сопряжениями
Пользователь: «как делал сборку? нужно сначала отдельно все детали, потом в сборке всё соединять; отдельная папка под детали». Было: неподвижные детали построены сразу в координатах сборки и просто закреплены.
Стало: `kompas/Детали/*.m3d` — каждая деталь от своей базы (основание — центр верхней грани; стойка — ось O на передней грани; ось — центр заднего торца; направляющая — ось ползуна на низу кронштейнов; упоры — угол задней грани; кулиса — ось O на задней грани полосы; ручка — начало на оси; камень — ось пальца на передней грани; ползун — ось отверстия в средней плоскости). Стойка 92 × 390 × 12 (x −49,5…42,5 от O), основание 200 × 160 × 20; упоры: нижний x 31…42, низ −5; верхний x 15…21, верх +60 (грани по рёбрам кулисы в φк, φн). Массы КОМПАС = ручной счёт для всех 10 деталей.
`УКП.00.000 Укупориватель.a3d`: закреплено только основание, 25 сопряжений по граням/осям/плоскостям (список — в docstring kompas_assembly.py); камень по толщине привязан к ползуну (1 мм, палец со стопорным кольцом) — с привязкой к кулисе решатель терял «камень по оси кулисы». Кинематика: y ползуна = e·tg φ точно.
Грабли API: IPlacement3D.Rotate — центр поворота в координатах самой детали (передавать 0,0,0); «На расстоянии» между плоскостями — знаковое, по нормали 2-й плоскости (нормаль XZ = −y → для «выше» менять порядок объектов); вырез с dtNormal идёт против нормали эскиза → вырезы делать симметрично (dtBoth); грань компонента — IPart7.FindObjectsByPoint в координатах сборки; Alignment: прижатые грани — Opposite, заподлицо/плоскости — Cooriented. SetAdvancedColor: прозрачность 1,0 = непрозрачная (с 0,0 детали были невидимы — «как 3D-чертёж», только рёбра). «На расстоянии» иногда ставит деталь по другую сторону плоскости независимо от начального положения (так встали верхний упор и камень) → где можно — совпадения граней (камень: торец пальца заподлицо с передней гранью ползуна), в скрипте check_places() сверяет положение всех деталей с задуманным. Вид сборки можно сохранить в PNG: ksDocument3D.SaveAsToRasterFormat (k5.ActiveDocument3D()). Диапазон угла (IMateInterval) API не принуждает (перестроение не двигает кулису даже при диапазоне 30…30,01°) — работает только при перетаскивании мышью, проверяет пользователь.

Движение (06.11): встроенная анимация — Сборка → Размещение компонентов → Изменить положение компонентов → способ «По сопряжениям» (кнопки Вперёд/Назад/Стоп); для туда-сюда по кнопке — `2026-11-06/kompas/kompas_motion.py` + «Движение механизма.bat» (tkinter-окно Старт/Стоп, закон ω(t) п. 9, замедление 1…10, по умолчанию 3; кадр 40–60 мс; диапазон угла выключается на время движения, при «Стоп» возвращается; сборку не сохраняет).

### КОМПАС — 4 детали, стойка на столе (2026-11-04, ночь) — заменено версией 2026-11-06
Пользователь по очереди: основание убрать (к стене) → стойка/ось/направляющая/упоры одной деталью, кулиса+ручка одной деталью → «куда рукоять пропала, это просто палка» (сделал рукоять Ø26 стальной частью кулисы, 868 г) → «убери рукоять и переназови деталь; верни стойку к столу, только это всё ещё одна деталь». Итог (`kompas/Детали`): УКП.00.001 Стойка = основание 200 × 160 × 20 (лист в 18 мм от левой и 10 мм от задней кромки) + лист 92 × 390 × 12 + ось O + направляющая + упоры, без отверстий под стену, 8622,1 г; УКП.01.001 Кулиса (полоса + ступица, без рукояти, 577,6 г = расчёт); УКП.02.001 Камень с пальцем D; УКП.03.001 Ползун. Сборка: стойка закреплена, 8 сопряжений, проверки пройдены. Эскизы (05.11, «эскизы с минусом — задай размеры, чтобы стали +»): все 22 полностью определены — класс Sketch2D: горизонтальность/вертикальность, совпадение концов (ksSetObjConstraint), одна фиксированная точка, управляющие размеры (ksLinDimension/ksDiamDimension → TransferReference → IDrawingObject1.Associate + ksCFixedDim), проверка ISketch.ConstraintsState == 1 при сохранении; полоса кулисы — прямоугольник + 2 окружности R9 (без дуг). Кожух (05.11, «деталь, чтобы закрывала механизм и её можно было двигать, как на продажу»): УКП.04.001 Кожух, АБС 2 мм, 43,4 г, наружные кромки x −17…45,5, y −53…64 от O, z −34…12; открыт сзади, паз под кулису (полоса между нижним ребром при φк и верхним при φн, зазор 1 мм, z −34…−12,5) в правой и верхней стенках и паз под шток в дне (x e ± 6) открыты назад → снимается сдвигом вперёд; в сборке 3 сопряжения: YZ и XZ по плоскостям стойки + «На расстоянии» (стойка XY, кожух XY — такой порядок даёт +z) с диапазоном 0…120 мм (пользователь сам поменял 60 → 120 в КОМПАСе 05.11 и попросил записать; сборку сохранил через API7 IKompasDocument.Save — у созданного скриптом документа сохранение работает, кожух в файле сдвинут на ≈59,6 мм, как оставил пользователь). geom_check: соударений нет, зазоры кулиса–паз 1, шток–паз 2 мм. Отдельной рукояти-втулки нет — если попросят снова, это вопрос материала (через API телу материал не задать) и массы в разд. 13.

### КОМПАС — крепление к стене, актуальная версия (2026-11-06) — `курсовой/2026-11-06/kompas`
**Итог 06.11:** стойка = лист 92 × 390 × 12 (x −31,75…60,25 от O — центр 14,25 совпадает с центром кожуха, поля от кожуха по 14,75 мм («механизм с края стенки — сделай посередине, смотри по кожуху»); 4 отв. Ø6 под стену: 8 мм от боковых краёв, чтобы шляпка не шла под кожух, 10 от верхнего и нижнего; правое верхнее отверстие при φ ≈ 46° закрыто кулисой, шуруп ставится при другом положении рукояти, зазор до кулисы по z есть) + основание 128 × 92 × 20 (x −49,75…78,25: поля по 18 мм от листа, ось бутылки на 1,7 мм левее центра; z −46…46 в сборке: задняя кромка заподлицо со стеной, ось бутылки посередине глубины; 92 ≥ 1,5·D = 90,6) + ось O, направляющая (97 мм), упоры, 5436,3 г; ползун: шток Ø8 × 60 + головка, 371,1 г; кожух y −53…64, 43,4 г; кулиса 577,6 г; камень 43,7 г. Низ листа −325,25 от O = дно бутылки (бутылка 226,5 + крышка 6 + зазор 10 = 242,5 под головкой при φн, подтверждено поставщиками 225–227 мм). Шток 60 и лист 390 — как в расчёте: пользователь просил укоротить только потому, что «смотрелось странно», потом вернул («если по длине нормально, менять ничего не надо»). Промежуточная версия с листом 365 и штоком 35 (коммит 6145db0) — НЕ актуальна. Масса ползуна: в модели головка сплошная (236,8 г), в расчёте m3 = 0,27 учтена полость Ø30×20 (125,8 г) — поэтому 371 г против 270; в модель полость не вносилась, сделать только по просьбе. docx и 3D на сайте под крепление к стене не обновлены. Грабля: упавший на сохранении сеанс КОМПАСа после перезапуска восстанавливает безымянный черновик, и он становится активным окном — app.ActiveDocument нельзя использовать для чтения свойств своей детали (Part.save берёт массу через TransferInterface своего документа). Опасные шаги связывать через &&, файлы не удалять до подтверждения, что КОМПАС закрылся: 06.11 так удалились детали и сборка (восстановлены пересборкой). Грабля: КОМПАС держит в памяти модель файла даже после закрытия всех документов — если детали открывались в этом сеансе, перед перестройкой его надо перезапустить (app.Quit(), connect() запустит снова); kompas_assembly сверяет массы компонентов с parts_mass.json и останавливается при расхождении. Запускающий .bat писать байтами из Python-файла, не через printf в bash: обратные слэши портятся. Первоначально: Пользователь: «убери ещё раз крепление к столу (прямоугольник снизу), пластину крепим к стене». Скрипты скопированы из 2026-11-04/kompas (там осталась настольная версия). (без основания стойка весит 3587,5 г); сборка: 11 сопряжений, кожух 0…120 мм. От стены (задняя грань листа): кулиса 24,5…32,5 мм, ось ползуна 46 мм; низ листа — уровень дна бутылки. Отдельной рукояти-втулки нет, рукоять — конец полосы. При перетаскивании мышью механизм работает: пользователь ставил рукоять на 27,15°, ползун пришёл в e·tg φ. Не обновлены под стену и новое основание: 3D-модель на сайте (основание, ручка) и docx (сводка «основание 200 × 160», ТЗ).

### 3D-модель v17 (2026-11-02) — новая ссылка
Старый артефакт 9v6upATwdPYLdikvfoYe9o из этого аккаунта не открывается («not found», список артефактов пуст) — опубликован новый: **https://claude.ai/artifact/2LV9g7o2g8fChrYMYRXPHw** (иконка cube); исходник `курсовой/2026-11-02/3d_model_v17.html`, собирается `patch_3d_v17.py` из 2026-10-26/3d_model_v15.html. Обновлять — publish того же файла (в новой сессии — с url). Версия 2 (02.11) — 3d_model_v20.html (patch_3d_v20.py из v17): палец D в группе камня, цвет обоймы (как на рис. 12 v20); публиковать с url. Ярлык на модель у пользователя: `C:\Users\terek\Desktop\Укупориватель 3D.url` (02.11 переведён на новую ссылку) — при смене ссылки править и его.
- Обойма закрыта: сзади губки (толщина 2,5, заход на рёбра 2,2 мм, z −24,5…−22 — в глубине распорной втулки оси O Ø16), у оси O укорочены на 3 мм: без этого в конце хода губка входит во втулку на 0,31 мм; с укорочением зазор ≥ 1,47 мм (стенки — 2,15, ось Ø10 — 4,5; проверено перебором 2001 положения). Зазор губок до втулки выводится на панели.
- Кнопка «Человек для масштаба» (и якорь #human): фигура 1750 мм у кухонной столешницы 850 мм (1200 × 750), стоит у торца против конца рычага лицом к механизму (rotation.y = π/2), правая рука — 2-звенная обратная кинематика к рукоятке (плечо 325, предплечье 255 + кисть 90), следует за рычагом в анимации. При 850 мм рукоять в начале хода ≈ 1,63 м от пола — выше плеча.

### Правки пользователя 30.10 и v16 (2026-11-02)
Пользователь правил v15 сам (`Downloads\…_v15 (2).docx`, копия — `курсовой/2026-11-02/…_v15_правки_30.10.docx`): удалил разд. 14 «Применимость лекций» и 16 «Вопросы» (Допущения → 14, Источники → 15) — **не восстанавливать**; новое сечение Б–Б обоймы на рис. 12; в табл. 17 уточнил названия строк; в формулах п. 6.1 «−» стало «-»; убрал рис. 13 (шток). По его просьбе в `…_v16.docx` (cleanup_v16.py) удалены остатки рис. 13 (абзац «26295», подпись, ссылка в п. 12.5). Висит: в табл. 17 «см. вопросы» у давления камня p = 15,7 МПа — раздела вопросов нет.

### v17 (2026-11-02) — раздел 13 «Уточнённый силовой расчёт с силами тяжести и инерции» (актуальная версия)
Решения пользователя: трение не учитываем, обратный ход не считаем; если по уточнённым нагрузкам материалы выдерживают — пишем «всё в норме», если нет — менять материал внутри разд. 13 и пересчитать.
Файл `курсовой/2026-11-02/…_v17.docx` (45 стр.): build_v17.py (SRC = v16), calc_v17.py → calc_v17.json/npz (npz не в git), fig13_fbd_v17.py (рис. 7 + G1, Ф1τ, Ф1n, MФ1 в S1, G3, Ф3 в S3), figs_v17.py (рис. 14: P(φ) перв./уточн. + поправки ΔR). Разделы: Сводка → 14 (табл. 19 → 23), Допущения → 15, Источники → 16; новые табл. 19–22, рис. 13–14.
- Знаки: ω, ε в документе по модулю, φ' = −ω, φ'' = −ε; Ф1τ = m1·ε·zS по +n, Ф1n по +u, MФ1 = JS·ε (CCW +); Fпр = Fук − G3 + Ф3; P = [Fпр·e/cos²φ − G1·zS·cos φ + JO·ε]/(L·cos φ). Матрица A та же, меняется только B.
- Итоги: P max 112,8 → 109,9 Н (−2,6 %; вес кулисы −2,8 Н, ползуна −0,2), L = 500 сохраняется (запас 8 %); холостой ход P = −2,9…−2,5 Н, R12N = −5,1…−3,6 Н (камень на противоположном ребре — обойма закрытая); реакции на рабочем участке −0,14…−0,29 %. Проверка энергией: AP 10,751 = AF 11,452 − ΔП 0,701 Дж.
- Проверочный прочностной (распределённые q·(ε·z − g·cos φ), q·(ω²·z − g·sin φ), q = 1,13 кг/м): |MD| 40,75 → 40,65 Н·м (вес/инерция D–K компенсируют снижение P), σ 94,8 → 94,6 ≤ 98, τ 25,3, p 15,7 ≤ [p] = 24, шток не хуже — материалы не менялись.
- [p] = 24 МПа — Autodesk Inventor Help, Clevis Pin Joints (metric): сталь 37/42, подвижное соединение, повторная нагрузка (статика 30, знакоперем. 12); внесено в п. 12.4, табл. 17 («см. вопросы» → «проходит») и источники.
- verify_v9.py (2026-10-11) на v17: таблицы 0 расхождений; «не найдено» — только строки удалённого пользователем разд. 14 и намеренно изменённые (дата, сводка).
- Грабли вёрстки: длинные формулы в одну строку переносятся (FORM 14 pt) — делить на строки; таблица «перв. / уточн.» в одной ячейке переносится → по две строки на положение; рисунок после длинной таблицы уезжает и оставляет полстраницы пустой → ставить рисунок перед таблицей.
- Шапка «(разделы 15–16)» → «(раздел 15)», дата 02.11.2026.

### КОМПАС — встроенная анимация «Механика: Анимация» (2026-11-06, готово) — `курсовой/2026-11-06/kompas`
Запуск в одно нажатие: `Анимация в КОМПАСе.bat` → `kompas_animation.py --play` (открывает копию сборки, запускает Анимацию, загружает сценарий, ставит цикл и «Возвращать в начало», жмёт ▶). `python kompas_animation.py` без ключей пересобирает копию и сценарий — делать после любой пересборки деталей или сборки. Файлы: `УКП.00.000 Укупориватель (анимация).a3d` (копия: рукоять в φн, сопряжение угла исключено, скрытая ось «Ось O» по цилиндру оси O), `Анимация механизма.xml` (36 шагов: 18 вниз, 18 вверх, ломаная по закону ω(t), отклонение < 0,1°). Рабочая сборка не менялась: в ней диапазон угла для мыши. Проверено журналом на 3 циклах и через .bat: φ 22,72…59,47 без накопления сдвига, ползун = камень = e·tg φ (медиана ошибки 0,000 мм). Номинально ход 2,74 с (3× к реальным 0,91 с), на деле около 4 с: «время условное», кадр дольше 1/24 с. Кнопка окна `Движение механизма.bat` и kompas_motion.py остаются как были.
Как устроено (ради чего копия): кулису вращает Анимация, камень и ползун идут по сопряжениям, кинематику считает КОМПАС. Если сопряжение «Под углом» не исключено в самой сборке, решатель возвращает кулису на место. Флаги Mate в XML ничего не отключают, Cycle в XML при загрузке не применяется (только галочка 1024 в «Настройках»).
Грабли формата: ось вращения — только по цилиндрической поверхности (o3d_axisConeFace), системная «Ось Z» и ось по двум плоскостям дают «Траектория не соответствует документу!»; пробелы в имени оси пишутся в XML подчёркиваниями («Ось O» → Axis="Ось_O"); Direct="1" — φ растёт (рукоять вверх); XML UTF-8 без BOM. Запуск из скрипта: ksAttachKompasLibrary + ksExecuteKompasLibraryCommand(h, 2) не возвращается, пока окно открыто, — отдельным процессом (--lib). Окно Анимации — диалог с меню, команды идут через WM_COMMAND (номера в скрипте), панель «Воспроизведение»: ▶ 1008, ■ 1009, «Возвращать в начало» 1069. Файл сохраняется с задержкой — ждать появления. После HideMessage обязательно вернуть ksShowMessage. IKompasDocument.Save() ничего не возвращает; GetOrigin() возвращает (флаг, x, y, z), брать [-3:]. PowerShell Start-Process -Wait на .bat не вернётся, пока открыта Анимация (ждёт и --lib).
Не сделано, можно предложить: кожух на время анимации полупрозрачный (в XML есть Transparency), запись видео кнопкой ● на панели. docx и 3D на сайте под стену не обновлены.

### КОМПАС — бутылка и причина сбоев SaveAs (2026-11-06) — `курсовой/2026-11-06/kompas`
«Сделай отдельную деталь бутылку и добавь туда»: УКП.05.001 Бутылка (`Детали`): полая, стекло 2,5, янтарная полупрозрачная (opacity 0,6). H 226,5, Ø60,4, шейка Ø26, венчик Ø26,6, горло Ø17,4, стенка 2,3, дно 5, плечо от y = 98 — две сопряжённые дуги. Стенка и начало плеча подобраны под ТЗ: 220,8 г (в ТЗ m_b = 220 г, «Зафиксировано») и 354,8 мл до краёв; из-за этого плечо ниже, чем в 3D на сайте (там 128). Эскиз один, «+»: Sketch2D.contour — у дуги закреплены все три точки (индексы 0, 1, 2). В сборке 3 новых сопряжения (всего 14): дно на основании, плоскости YZ и XY по ползуну. Компонент № 5; в анимации тоже есть (PARTS в kompas_animation.py). geom_check: соударений нет; головка касается верха бутылки при φк — так задумано: ход 16 = зазор 10 + крышка 6, крышка не моделировалась, головка в модели сплошная (без полости Ø30×20).
Причина сбоев «Ошибка на сервере» в SaveAs (2 раза за день): приложения КОМПАСа, включая APM FEM, грузятся ещё 5–7 с после старта (APM FEM на 3,4 с); скрипт подключался в это окно и сразу создавал первую деталь, APM FEM цеплялся к ней (рядом .apmf, всегда только у стойки), следующий SaveAs падал в kAPI2D5.dll+0xa898, на стеке ApmFemTreeView.ocx. Дампы: %LOCALAPPDATA%\ASCON\KOMPAS-3D\Dumps. Исправлено: connect() после запуска ждёт wait_apps() (число модулей не растёт 4 с), Part.save останавливается, если появился .apmf. Нарочно сбой не воспроизводился, после исправления один полный прогон прошёл без него. Если сбой повторится — смотреть, был ли .apmf.

### Расчёт v24 (2026-11-06) — `курсовой/2026-11-06`
Пользователь скачал `mechanism.docx` (44 стр., 531 формула, 164 рисунка, 23 таблицы — переработка v23 с таблицей источников 1, приложением А о перегрузке) и попросил убрать упоминания прошлой версии. Снимок — `mechanism.docx`, результат — `Расчет_силовой_и_кинематический_тангенсный_механизм_v24.docx`, скрипт — `docx_remove_version_refs.py` (меняет только w:t, проверено: кроме текста document.xml ничего не изменилось). Заменено 38 абзацев: «Указано в v23» → «Принято» (слово уже есть в столбце «Статус» таблицы 2), «исходный расчёт/п. 12.6», «эта редакция». Вместе со ссылками ушли оговорки о том, что нормативные первоисточники не перепроверялись. Сравнение «первичный/уточнённый расчёт» оставлено — это содержание разд. 13. В v24 по-прежнему основание 200 × 160 и настольная компоновка, под крепление к стене не обновлено.

### КОМПАС 09.11 — палец D отдельно от камня — `курсовой/2026-11-09/kompas`
Замечание преподавателя: камень = деталь с отверстием + штифт, фиксация по оси (резьба + гайка или проточка под кольцо). Пользователь: палец отрезать, в камне отверстие, палец удлинить, резьба со стороны ползуна, гайка. Сделано: «Камень» УКП.02.001 (обойма с отверстием Ø10, 30,7 г), «Палец D» УКП.02.002 (Ø10 × 21,5 + М8 × 1,25 на 10,5, L = 32, сталь 45, 17,3 г, условная резьба), «Шайба 8 ГОСТ 11371-78», «Гайка М8-6H.5 ГОСТ 5915-70» (S13 × 6,5, фаски 30°, внутренняя резьба). Палец запрессован в камень (H7/r6), задний торец заподлицо с обоймой — сзади в 0,5 мм полоса кулисы, головке места нет; ползун вращается на пальце; шайба упирается в уступ пальца в 0,5 мм перед ползуном, гайка — в шайбу (ползун не зажат). Кожух глубже: CV_Z 46 → 58 (стенка в 3 мм от конца пальца, 52,3 г). Сборка: 9 компонентов, 23 сопряжения, всё выполнено; соударений нет (geom_check). «−» у подвижных компонентов — как и раньше (угол задан диапазоном). API: эскиз на XOZ — (u, v) = (x, −z); условная резьба — o3d_thread по круговому ребру (FindObjectsByPoint у TopPart детали). Пользователь 09.11: «анимацию через КОМПАС делать не надо» — kompas_animation в папку 09.11 не перенесён. Документ расчёта (палец, срез i = 1, крепление) под это ещё не обновлён.

### Расчёт v26 (2026-11-09) — `курсовой/2026-11-09`, актуальный
build_v26.py (из v24 в 2026-11-06; python -I build_v26.py v24.docx v26.docx fig_crimp.png) по замечаниям преподавателя, в оформлении v24 (выносные формулы — PNG из LaTeX, рендер matplotlib mathtext cm 12 пт 600 dpi, \frac→\dfrac, ширина EMU = px·1524, descr «LaTeX: …»): 1) срез в одной плоскости — звенья в параллельных плоскостях, i убрано из формул/текста/табл. 17/прил. А; 2) I_min — минимальный осевой момент инерции сечения (п. 12.5, обозначения), абзац «увеличить размер или сменить материал» (материал помогает только при λ < λпред; выбран диаметр); 3) логика «рисунок → уравнения → матрица → решение»: «По расчётным схемам рисунка 8…», итог о 9 уравнениях — в конце 11.4, «система решена…» — в 11.6 и 13.5, рис. 14 — в конце 13.3 перед уравнениями (перенос рисунков сразу после вводной фразы давал полстраницы пустоты — отказался); 4) новый рис. 1 в п. 3.3 (fig_crimp.py: половина сечения — коническая горловина α = 16,3°, давление q по нормали, б) q·cos α / q·sin α, F_ук = ∫ q sin α dA) + текст, формула, ссылка в 11.1; остальные рисунки +1 (15 всего). 45 стр.; пустой низ на с. 5, 28, 35 (в v24 было 4 такие страницы) — подгонять в конце. Черновик v25 — занят скрытым Word от моей проверки (у пользователя не открыт), пользователь: «делай новую версию» → v26. Не тронуто (предложить): перегрузка τ 50,5/51,9 > 50 и кулиса 125 > 98 («увеличить размер или сменить материал»); п. 12.6/рис. 12 «палец заодно с обоймой» — модель уже с отдельным пальцем и гайкой; табл. 18 «головка Ø40 × 24», m3 = 0,270 кг (в КОМПАСе ползун 418,7 г).
Окно «Движение механизма.bat» (09.11) проверено — работает.

### КОМПАС 09.11 — головка с конической горловиной
kompas_build.py: SLIDER_PROFILE — головка Ø40, вход конуса Ø32,1 → Ø28,6 на 6 мм (фаска 1,25), цилиндр Ø28,6 до потолка 0,5 мм над крышкой при φк; при φк верх конуса на 5,4 мм ниже торца горлышка (низ юбки), при φоб вход конуса у низа юбки. Головка удлинена вниз 24 → 36,65 мм (шток 60 прежний, ход 16 не менялся); ползун 418,7 г. `python kompas_build.py polzun` — перестроить только ползун. Сборка пересобрана (23 сопряжения), geom_check: соударений нет, буртик горлышка — стенка горловины 1 мм, торец — потолок 1,44 мм. Зазор между торцом головки и верхом крышки в начале хода всего ≈2,4 мм (бутылку подсовывать впритык). Крышки в модели нет.

### Расчёт v27 (2026-11-09) — актуальный: рисунок пальца
build_v27.py (из v26): рис. 13 «Камень и кулиса» — fig13_kamen.py (основа fig12_v23.py): в Б–Б палец отдельной деталью,
в стенке обоймы — штриховыми, к ползуну — обрыв; новый г) разрез В–В через ось пальца параллельно Б–Б (кулиса, обойма,
палец Ø10 × 32, ползун — след при φу ±18,07, шайба, гайка М8; палец/шайба/гайка нерассечёнными по ГОСТ 2.305; одна
плоскость среза; направляющая не показана). Текст: под рисунком, п. 12.6 (палец запрессован H7/r6, шайба и гайка, уступ 0,5)
и табл. 17 — вместо «заодно с обоймой». 45 стр., рис. 13 на с. 29.
Ответ пользователю 09.11 про перегрузку: только когда ход кончился (φк) и давят 120 Н (63 Н нужно); заклинивание раньше —
меньше (φу ≈ 2000 Н); нижний упор в 3D снимает перегрузку с пальца/ползуна/штока, но не с кулисы (≈51 Н·м, ≈118 МПа > 98);
в прил. А упор не учтён.

### Расчёт v28 (2026-11-09) — актуальный; палец своим цветом
Пользователь: «палец теперь другая деталь — покрась в другой цвет» → палец D #7fae6a (зелёный) на рис. 13 (fig13_kamen.py,
PIN) и в 3D (kompas_build.py PIN_COLOR, build_pin(); `python kompas_build.py pin` — перестроить только палец; сборку
пересобирать не нужно — цвет берётся из детали). v28 = v27 + новая картинка рис. 13 (build_v28.py), текст не менялся.
Вопрос «у ползуна не слишком глубоки?» — ответил про полость-горловину: ≈14 мм — минимум (крышка 6,3 + обжим 6 + фаска 1,25
+ зазор 0,5), менять не нужно.
Грабля 09.11: после `python kompas_build.py pin|polzun` сборку надо пересобрать (`python kompas_assembly.py`): сопряжения ссылаются на грани детали, у перестроенной детали они новые — старая сборка открывается с «!» (6 сопряжений пальца). Скрипт теперь об этом напоминает.

### APM FEM (с 09.11) — `курсовой/2026-11-09/apm`, в работе
Задача пользователя: каждую деталь (кроме стойки) — сетка, силы, расчёт в APM FEM; 4 картинки на деталь: деталь, тест, новая
деталь (где красное — добавить материал/скругления, где синее — убрать, напр. отверстия в середине кулисы), тест новой; всё —
в отдельный файл. Порядок: сначала кулиса и ползун, потом камень и палец D. Нагрузка — рабочая при φу (Fук 1880, R12N 2515,
P 112,8, R30N 1671 Н). Делёж: у APM FEM нет API (только команды RTW: 2 Закрепление, 3 Сила, 10 Сетка, 11 Расчёт, 15 Карта)
→ клики в APM делает пользователь, я — инструкции, копии деталей (apm/Детали, «(APM)»: светлые, эскизы скрыты; у кулисы
линией разъёма отделена зона контакта с камнем x 6,76…26,76 на нижней грани), картинки (apm_prep.py: SaveAsToRasterFormat,
ракурс — IKompasDocument3D1.ViewProjectionManager.SetMatrix3D, 4×4 по строкам: ось X экрана, ось Y, к наблюдателю, сдвиг),
улучшенные детали и итоговый файл. Скрины пользователя — apm/Скрины (кулиса_2_тест.png, ползун_2_тест.png …).
APM-результаты хранятся ВНУТРИ .m3d (не .apmf), только если в дереве прочностного анализа на папке «Карты результатов» включён флажок «Сохранять результаты в файл», затем Ctrl+S. Пользователь (09.11): модели с картами напряжений сохранять, чтобы быстро открывать в КОМПАСе → после каждого теста: флажок + сохранить, проверить рост файла, коммит. Скрины пользователь делает Win+Shift+S → OneDrive\Изображения\Screenshots (беру последний, копирую в apm/Скрины: <деталь>_2_тест.png, <деталь>_4_тест_новой.png). Кулиса готова: 92,6 МПа (ручной 94,6); облегчённая — 8 пазов 30×8 R4, x 125…435, 463,9 г (−114 г), максимум тот же, у пазов ≤ 81.
APM 13.11 итог (отчёт apm/«Прочностной анализ деталей в APM FEM.docx», build_report.py, 8 стр., вверху жирно «напряжения снизились, всё в допускаемых» — просьба пользователя): кулиса 9 пазов 449,7 г, 92,6 МПа; ползун колокол+R3 320,8 г, 95,9→49,0; камень — замкнутая обойма (задняя стенка 2,5 от x −4, у ступицы губки), R1,5 (до углов полосы 0,09 мм — пользователю предложено R1, не решено), фаски 0,5 на отверстии (передняя — вырезом вращения, «Фаска» не строится), сталь 40Х: 646→230 в перемычке; палец — сталь 40Х, изгиб ≈230 (консоль 4 мм заделки). Пики на кромке закрепления APM — сингулярность, не учитывать. Закрепление половины отверстия даёт 28 000 МПа (сингулярность) — не делать. Доработки внесены в модель 13.11 (см. ниже), в расчётную записку — нет.

### Сборка 13.11 и комплект для печати (сделано 13.11) — `курсовой/2026-11-13`
Рабочая модель — kompas/ (детали из APM-копий: prepare_parts.py → unhide_parts.py → kompas_assembly.py; стойка и кожух —
`python kompas_build.py stand cover`). Итог: кулиса 447,7 г (фаска по контуру), ползун 320,8, камень 34,6 — СТАЛЬ 45 (камню
40Х не нужна: 100 МПа < 142), палец 17,3 — 40Х (192 > 142), стойка 6134 г: рёбра 80 × 138,6 × 8 (60°), кожух 59,2 г: левая
стенка в 1 мм от конца кулисы (x −12), лежит верхней стенкой на верхнем упоре (CV_Y1 62), утолщение левой стенки ниже кулисы
(y ≤ −9) упирается в планку направляющей — решение пользователя «максимально просто». geom_check.py: + рёбра, + проверка
кожух–стойка (касания), KOMPAS CheckIntersectionWithBody (IFeature7.ResultBodies компонентов) — пересечений нет.
Грабли КОМПАСа: APM-копии сохранены со скрытыми телами → копии невидимы (чтение IModelObject.Hidden ненадёжно — ставить
явно, проверять картинкой); открывать деталь при открытой сборке → «пустой» документ (Item=None) и падение; растровая
картинка — по габариту видимых тел в масштабе (пиксели ∝ dpi), не по окну; STL — SaveAsToAdditionFormat format 6 (пишет ASCII).
Комплект «Укупориватель — печать и сборка/»: «Инструкция по сборке.html» (самостоятельный, картинки встроены; для новичка:
что это, как работает, детали, печать, подготовка, 8 шагов с подсветкой новой детали, работа, неполадки) + «Детали для
печати/» 8 STL (без бутылки). Исходники — инструкция/ (make_images.py, export_stl.py, template.html, build_html.py).
Отчёт APM ещё не обновлён под итог камня (100,1 МПа) и сталь 45 камня; расчётная записка — под массы/материалы.
