DamirNine/prikmeh/memory/MEMORY.md

# Memory Index — Прикмех

- [Проект Прикмех](project_прикмех.md) — ДЗ по Прикладной механике, РК6-45Б бригада 2, кинематика точки, финал …_исправл.docx
- [Курсовой проект](project_прикмех_курсовой.md) — укупориватель на тангенсном механизме: модели КОМПАС v25 — актуальные курсовой/2026-11-09/kompas (09.11: камень + отдельный палец D Ø10/М8 с шайбой и гайкой, кожух глубиной 58; анимацию через КОМПАС пользователь делать не просил — в 09.11 её нет); до них курсовой/2026-11-06/kompas (Детали/ — стойка: лист 390 мм на стену + основание 128 × 92 + всё неподвижное, кулиса, камень, ползун со штоком 60, кожух, бутылка; сборка с диапазонами; окно «Движение механизма.bat»; встроенная анимация КОМПАС — «Анимация в КОМПАСе.bat», kompas_animation.py, копия сборки и XML-сценарий); настольная версия — 2026-11-04/kompas; актуально v28 (09.11: = v27, палец зелёный #7fae6a на рис. 13 и в 3D); v27 (= v26 + рис. 13 с отдельным пальцем, разрез В–В с шайбой и гайкой); v26 (09.11, курсовой/2026-11-09: замечания преподавателя — i = 1, I_min, логика рисунок→уравнения→матрица→решение, рис. 1 обжим конусом; головка в 3D с конической горловиной); v24 (06.11, курсовой/2026-11-06: mechanism.docx без ссылок на прошлую версию); до него v23 (04.11, курсовой/2026-11-04, build_v23.py → v22 → v21 поверх v20; v23 — обойма и палец одного цвета в разрезе; v22 — звено 3 линией, ровная стойка, разрез Б–Б со штриховкой и пальцем без штриховки; v21: замечания преподавателя — схемы по ЕСКД, новый п. 12.6 «пары на срез и смятие» с [τ] крепежа ≤ 50 МПа, ступица Ø16 × 12 у оси O); v20 (02.11, курсовой/2026-11-02: = v19 + рис. 12 с губками и пальцем заодно с обоймой; v19 = v18 с рис. 14 только уточнённого расчёта; v18 = v17 + все формулы — формулы Word из LaTeX (omml.py, formulas_latex.py), матрица 9×9 вместо табл. 20, рис. 14 — 9 графиков; разд. 13 «Уточнённый силовой расчёт» — P 109,9 Н, без трения); до этого v15 (26.10, курсовой/2026-10-26; = v14 из 2026-10-24 + рис. 3, 6, 8 и ссылки на табл. 17, 19; обойма — рис. 12, шток — рис. 13): камень-обойма снаружи кулисы, полоса Ст3сп 8×18, эпюры на наклонном звене, шток Ø8 на устойчивость; ψ = 36,75°, e = 12,53, L = 500; 3D-модель v17 — новый артефакт 2LV9g7o2g8fChrYMYRXPHw (старый 9v6up… недоступен), курсовой/2026-11-02/3d_model_v17.html: закрытая обойма с губками, укороченными у втулки оси O, кнопка «Человек»
- [Правила работы с файлами](workflow_редактирование.md) — копия перед правкой + папки по дате, автопуш изменений в GitHub
- [Формулы через LaTeX](feedback_formulas_latex.md) — все новые формулы: LaTeX → формулы Word (omml.py в курсовой/2026-11-02), не текстом
