DamirNine/prikmeh/memory/project_прикмех.md

---
name: project-прикмех
description: ДЗ по Прикладной механике (МГТУ, РК6-45Б, бригада 2) — кинематика точки, плоское и сложное движение, проверка расчётов и перерисовка рисунков.
metadata:
  type: project
---

# Прикмех (Прикладная механика)

ДЗ для МГТУ им. Баумана, каф. «Теория механизмов и машин», направление 09.03.01.
Вариант: **РК6-45Б, бригада 2**. Тема: кинематика точки.

## Исходные данные варианта
- x(t)=3a·cos(bπt²/3), y(t)=a·sin(bπt²/3); a=8, b=−3 → **x=24cos(πt²), y=−8sin(πt²)**
- Сложное движение: z′(t)=6t²+2, φ(t)=−sin(πt). Момент t₀=1.

## Ключевые ответы (проверены символьно через sympy, всё верно)
- Плоское, t=1: M(−24,0); траектория — эллипс x²/24²+y²/8²=1.
- ДСК: V=(0,16π), a=(96π²,16π); |a|=16π√(36π²+1).
- ПСК: r=24, θ=π, V_r=0, V_θ=−16π, a_r=−96π², a_θ=−16π.
- ЕСПЗД: a_τ=16π, a_n=96π², ρ=8/3.
- Сложное: V=(0,−8π,12), a=(88π²,16π,12); ρ_простр≈0,89. Два метода (через неподвижную СК и через формулы сложного движения) дают одинаковый результат.

## Файлы (C:\Users\terek\.claude\projects\прикмех)
- **РК6-45Б_бригада_2_решение_ПМ_финал.docx** — АКТУАЛЬНЫЙ финал (раунд 2, после правок Подчасова), также лежит в `C:\Users\terek\OneDrive\Рабочий стол\университет\Семестр 4\Прик Мех\4 семестр\`.
- РК6-45Б_бригада_2_решение_ПМ_исправл.docx — финал раунда 1 (устарел, базовый файл для замены картинок в раунде 2).
- РК6-45Б_бригада_2_решение_ПМ.docx — оригинал решения (новая версия с двумя методами).
- homework1.docx / homework1.pdf — предыдущая версия решения (была «упрощённая/точная схема», в новой заменена на 2 метода).
- ДЗ РК6 ПМ 2026.pdf — методичка с заданием (34 варианта механизмов; к данному ДЗ по кинематике не относится напрямую).
- **redraw.py** — генерирует 14 исправленных рисунков → media_fixed/ (раунд 2: + базис на всех рисунках, 3D — только окрестность точки).
- **insert_images.py** — заменяет word/media/imageN.png на media_fixed/figNN внутри копии docx и пересчитывает cy под новый аспект (ищет wp:extent/a:ext по позиции конкретного a:blip r:embed, не глобальной заменой строк — картинки 2-9 и 11-14 совпадают по cx/cy, глобальная замена была бы небезопасна). Раунд 2 запускался на _исправл.docx → _финал.docx.
- media_fixed/ — fig01…fig14 (текущая версия), media_new/ — оригинальные image1…14 (из самого первого раунда).

## Что было сделано
1. Проверены все расчёты — корректны. Найдена опечатка в старой версии (матрица поворота y·sinφ вместо x·sinφ), в новой версии исправлена.
2. Рисунки перерисованы в правильном масштабе: равный аспект осей (эллипс 24×8), векторы в верных пропорциях (a_r:a_θ=18.8:1), читаемые 3D.
3. Картинки вставлены в копию docx (replace media в zip + пересчёт cy под аспект). Маппинг Рис.N→imageN→figN.

## Про масштаб векторов на рисунках (важно, не баг)
Деления осей (5, 10, 24…) — это КООРДИНАТЫ точки (единицы длины). Векторы V (=16π≈50)
и a (=96π²≈947) имеют другие единицы и огромны, их нельзя отложить в той же шкале.
Поэтому скорость/ускорение нарисованы в отдельном уменьшенном масштабе (sV=0.18, sA=20/96π²):
стрелка показывает НАПРАВЛЕНИЕ, истинная величина — в подписи. Длина стрелки ≠ число на оси.
Внутри одного рисунка компоненты пропорциональны (a_r:a_θ=18.8:1). Пользователь это принял,
менять не просил. Был баг: при sV=0.40 стрелка V (~20) вылезала за ylim=12 и не рисовалась —
исправлено уменьшением до sV=0.18 (~9 ед.).

## Инструменты
Python 3.12 (`py`), пакеты sympy/matplotlib/numpy установлены. docx-текст извлекается через zipfile+regex; кириллицу в путях передавать НЕ через here-string в py-stdin (манглится) — писать .py файл и запускать.

## Раунд 2: правки рисунков по замечаниям Подчасова (2026-06-19)

Подчасов (преподаватель) вернул работу с замечаниями: 1) нет масштаба, 2) на всех картинках должен быть базис (i,j / e_r,e_φ / τ,n) в начале координат O, 3) на части картинок нет векторов вообще, 4) пространственные (3D) рисунки — не рисовать всю траекторию, только окрестность точки M (можно чуть продлить за неё) + базис + векторы V и a.

Эталонный стиль (фото в Загрузках от 19.06.2026, 6 шт.) показывает: полный эллипс (не дуга) с 2 стрелками направления обхода, точки-метки на пересечении с осями (24,-24,8,-8) с цифрами, базис у O, большой вектор в точке M с разложением на компоненты (пунктирный прямоугольник) и подписями.

**Важно — пользователь поправил:** масштаб эллипса должен быть НАСТОЯЩИЙ 8:24 (равный аспект, как в исходном `redraw.py` с `set_aspect("equal")`), а НЕ искажённый, как на эталонных фото Подчасова (там эллипс визуально "пухлее" реальных пропорций). Эталонные фото — образец СТИЛЯ (базис, векторы, подписи), а не образец масштаба.
Также: цвета должны быть яркие/насыщенные (чёрный эллипс, красный/синий/фиолетовый/зелёный векторы), а не блёклый серый.

Пробовал делать рисунки в Desmos через Playwright CDP (см. технические заметки ниже) — пользователь сначала попросил "сделай графики в desmos", но после того как стало ясно сколько граблей у Desmos API (vector/segment не поддерживаются, подписи теряются, параметр должен называться t), сказал "сделай как раньше а не в desmos" — **вернулись на matplotlib (redraw.py)**, это финальный инструмент для рисунков. Технические заметки по Desmos оставлены ниже на будущее, если когда-то снова попросят Desmos.

**Финал нужно сохранить в:** `C:\Users\terek\OneDrive\Рабочий стол\университет\Семестр 4\Прик Мех\4 семестр` (а не только в папке проекта).

### Раунд 2.1: точечная полировка после первой партии правок

После первой версии раунда 2 пользователь дал ещё точечные правки (через live-просмотр и через страницу сравнения, см. ниже):
- У базиса (i/j, e_r/e_φ, τ/n) подписи с белым фоном слегка перекрывали оси — увеличил отступ подписи от точки крепления (с ~0.8-0.9 до 1.3-1.6 ед.) и уменьшил `pad` бокса.
- Подпись `M(t=1)` на плоских рисунках перекрывалась векторами, исходящими из M (вверх/вправо) — перенесена левее точки (`ha="right"`, x=-25.5), в свободную зону (там нет ни кривой, ни векторов, т.к. x<-24 вне эллипса).
- В 3D (Рис.10, 12) подпись `$\vec a$` была не видна — не сама стрелка, а именно текст-метка, перекрывалась осью k / другими элементами из-за того что mplot3d не делает честную сортировку по глубине между Text и Poly3DCollection. Исправлено: подписям векторов в 3D добавлен белый bbox + `zorder=20` + сдвиг метки в сторону от оси k (`loff=(2.5,2.5,2)` вместо `(0,0,2)`).
- В Рис.14 буквы `a_r` (оранжевая) и `a` (красная) почти слились — **важно: пользователь просил развести именно ПОДПИСИ, а не сами стрелки** (стрелки должны остаться из одной точки M, как в физике). Сначала по ошибке развёл стрелки (сдвинул точку старта) — пользователь поправил "буквы а не стрелки, стрелки верни назад". Финально: стрелки обе из `Mabs`, а подписям просто разный вертикальный отступ `loff=(0,0,-1.3)` для a_r (ниже) и `loff=(0,0,+1.3)` для a (выше).
- `arrow3()` теперь принимает `loff=(dx,dy,dz)` — кастомный отступ метки от конца вектора (по умолчанию `(0,0,2)`).

### Страница сравнения «было/стало»
`compare/index.html` — простая HTML-страница (тёмная тема, вертикальный список, обычный скролл) с парами картинок `old/{N}.png` (старые из `_исправл.docx`, raunda 1) и `new/{N}.png` (копии текущих `media_fixed/figNN`). Раздаётся локально через `py -m http.server 8743` из папки `compare/`, открывается в уже запущенном Playwright-браузере. При каждой правке рисунков — обновлять `compare/new/*.png` (copy из media_fixed) и просто релоадить страницу в браузере, HTML менять не нужно.

### Раунд 2.2: мелкая сетка + цифры/стрелки помельче

- Пользователь принёс референс из Desmos (скрин с мелкой сеткой "миллиметровка": крупные линии через 2(x)/1(y) с подписями + мелкие промежуточные). Добавлено в `base_plane()`: `MultipleLocator(2)/(1)` для крупной сетки, `AutoMinorLocator(4)` для мелкой, два вызова `ax.grid()` (major/minor) разной яркости. DPI поднят до 220 для чёткости тонких линий.
- Затем: "цифры и стрелки выглядят большими" — приём **"рисуй крупнее, потом уменьшай"**: размер шрифтов/линий задан в pt и не зависит от figsize, а от figsize зависит, сколько пикселей приходится на единицу данных. Поэтому: `figsize` увеличен в `SCALE=1.6` раза (и для плоских, и для 3D рисунков), картинка рендерится при том же dpi=220, а затем в `save()` через PIL уменьшается обратно `/SCALE` (LANCZOS) — итоговый размер картинки тот же, но шрифты/линии относительно сетки получаются тоньше и мельче. Параметр `SCALE` в начале `redraw.py` — можно покрутить, если понадобится ещё мельче/крупнее.

### Важно: финальный docx живёт в OneDrive — может быть занят Word
При копировании финала в OneDrive один раз получил `Device or resource busy` — файл был открыт в Word (`WINWORD.exe`). Не нужно ничего форсить/убивать процесс — просто попросить пользователя закрыть файл и повторить `cp` после подтверждения.

### Раунд 3: правки по номерам страниц docx (не Рис.N!)

Пользователь дал фидбэк по номерам **страниц итогового docx**, а не по "Рис.N" — соответствие НЕ совпадает с номером рисунка и не очевидно (зависит от объёма текста перед рисунком). Чтобы сопоставить страницу→рисунок надёжно: **конвертировать docx в PDF через Word COM (PowerShell)** и посмотреть нужные страницы:
```powershell
$word = New-Object -ComObject Word.Application; $word.Visible = $false
$doc = $word.Documents.Open($path); $doc.SaveAs([ref]$pdfPath, [ref]17); $doc.Close(); $word.Quit()
```
(17 = wdFormatPDF). Затем `Read` нужных страниц PDF напрямую (инструмент поддерживает `pages` параметр). Так нашли точное соответствие: стр.6→Рис.3, стр.9→Рис.5, стр.10→Рис.6, стр.11→Рис.7, стр.12→Рис.8, стр.13→Рис.9 (смещение +3/+4, не константа).

Найденные и исправленные баги (matplotlib-версия НИКОГДА не имела полного разложения вектора — это осталось недоделанным с самого первого раунда, я предполагал что раз есть результирующий вектор или есть компоненты — то "вектор есть", но Подчасову нужны ОБЕ части одновременно):
- **Рис.3 (ДСК ускорение)**: был только итоговый `a`, без `a_x,a_y`. Добавлена функция `decompose(ax, base, vx, vy, color, lx, ly, la)` — рисует оба компонента + пунктирную рамку + итоговый вектор одним вызовом. Переиспользована для Рис.6 (`a_r,a_θ`) и Рис.9 (`a_n,a_τ`), у которых была обратная проблема — были компоненты, но не было итогового `a`.
- **Рис.5**: текст `$V_r=0$` рисовался в `M[0]-7` = -31, что вне `xlim=(-30,30)` — "улетал влево" за рамку. Убран совсем (по просьбе пользователя), вместо него — нормальная подпись масштаба.
- **Рис.6, 9**: текст про "отношение компонент 18.8:1" заменён на единообразную подпись `масштаб ускорения 1:N` (как у Рис.2/3) — старый текст не выглядел как масштаб для Подчасова.
- **Рис.7**: орты τ,n рисовались ДВАЖДЫ — и у точки M (старый стиль), и у O (по конвенции раунда 2). Убрана версия у M, оставлена только у O.
- **3D (Рис.10-14): базисные векторы i,j,k разной длины** — причина: `ax.set_box_aspect((1,1,1))` форсит КУБ независимо от реальных диапазонов осей (xlim/ylim span=52, zlim span=16), из-за чего 1 единица по Z визуально "растягивается" больше чем по X/Y. **Правильный fix для равного 3D-масштаба — `set_box_aspect` с РЕАЛЬНЫМИ диапазонами осей**: `ax.set_box_aspect((xspan, yspan, zspan))`, а не `(1,1,1)`.
- **3D: вектор `a` (crimson) "пропадал" на Рис.10/12** — НЕ баг прозрачности/zorder (computed_zorder=False не помогло). Реальная причина: вектор `a` почти параллелен оси `i` (red) и при ракурсе `elev=18,azim=-60` визуально ложится на неё; crimson и red — слишком близкие оттенки, после downsize (SCALE=1.6) тонкие близкие линии сливаются в одну. Фикс: цвет `a` в Рис.10/12 заменён на контрастный `magenta`. **Урок: для 3D-векторов выбирать цвета по контрасту с осевым базисом (red/green/blue), а не просто "разные именованные цвета" — crimson/red, или navy/blue визуально слипаются.**
- Добавлены подписи `масштаб скорости/ускорения 1:N` на все рисунки, где их не было (Рис.5,8 и все 3D Рис.10-14, через новую `note3d()`).

### Раунд 4: единичный базис везде + орты ЕСПЗД из точки M + убран белый фон подписей (2026-06-21)

Правки от пользователя:
1. **Базисные векторы единичной длины (=1) во ВСЕХ рисунках**, включая 3D (Рис.10-14, i,j,k). Раньше в 2D были растянуты до 3.6 (для наглядности), в 3D — до 12. `draw_basis()` теперь рисует `L=1.0`; в `base_3d()` тоже `L=1.0`, но `arrow_length_ratio` поднят до 0.4 (иначе наконечник на векторе длины 1 не виден на масштабе осей 52×52×16) — базис в 3D стал маленьким крестиком у O, это осознанный трейдофф, пользователь подтвердил после явного вопроса (AskUserQuestion: "оставить 12" vs "сделать 1" → выбрал 1).
2. **Рис.7,8,9 (ЕСПЗД): орты τ,n теперь рисуются из точки M(t=1), а не из O** — `draw_basis(ax, kind, origin=...)` принял параметр origin; `base_plane(..., basis_at=M)`. Концептуально верно: естественный трёхгранник привязан к движущейся точке, а не к фиксированному O (в отличие от i,j/e_r,e_θ, которые остались в O).
3. **Коллинеарность орта и физического вектора (V вдоль τ в Рис.8, a_n вдоль n и a_τ вдоль τ в Рис.9)** — если рисовать орт ДО более длинного V/a того же направления, длинный вектор сверху полностью перекрывает короткий орт (даже если у него другой цвет — он просто рисуется позже и закрывает первый). Два фикса вместе: (а) цвет esp-орт сделан тёмно-серым `"0.3"` вместо чёрного — отличим от чёрного V; (б) ввёл `base_plane(..., defer_basis=True)` + ручной вызов `draw_basis(ax,"esp",origin=M)` ПОСЛЕ отрисовки V/a — рисуется последним = виден сверху как короткий чёткий "огрызок"-наконечник у основания длинного вектора.
4. **Убран белый bbox-фон у подписей** — и у орт (`lbl()` внутри `draw_basis`), и у векторов V/a в 3D (`arrow3()`). Раньше белый фон был добавлен намеренно (Рис.10/12: подпись $\vec a$ пропадала без него из-за особенностей сортировки глубины в mplot3d). После проверки без фона подпись на сером фоне сетки всё равно читается — регрессии не возникло, но если в будущем подпись где-то пропадёт — известная причина и обратный фикс (вернуть bbox) под рукой.
5. **compare/ страница**: добавлен cache-busting (`?v=${Date.now()}` к src картинок) — картинки old/new перезаписываются под теми же именами при каждом раунде, без cache-bust браузер после F5 показывал старые версии из кэша (пользователь жаловался "не вижу разницы" — вероятная причина).
6. После проверки — `py insert_images.py` перезапущен (читает `_исправл.docx` как основу, не предыдущий `_финал.docx` — это нормально, так и задумано), `_финал.docx` пересохранён + скопирован в OneDrive.

## Технические заметки по управлению Desmos через JS API (Playwright CDP)

На странице www.desmos.com/calculator доступен `window.Calc` — внутренний API калькулятора (setExpression/setExpressions/setMathBounds/asyncScreenshot/getState/expressionAnalysis работают).

Грабли:
- Функции `vector(...)` и `segment(...)` НЕ поддерживаются на этой странице (ошибка "калькулятор не поддерживает функцию"), даже с `authorFeatures`/`forceEnableGeometryFunctions` включёнными. Вместо вектора — рисовать вручную: "вал" как параметрическую прямую `(x1+(x2-x1)t,y1+(y2-y1)t)` + треугольник-наконечник через `\operatorname{polygon}((x,y),(x,y),(x,y))` (это работает).
- Параметрическая переменная ОБЯЗАТЕЛЬНО должна называться `t` — любая другая буква (`u`,`s`,`r`...) даёт ошибку "слишком много переменных", даже если задать domain явно. При этом разные независимые кривые могут все использовать `t` одновременно без конфликта (каждая своя область видимости).
- Domain параметрической кривой надо задавать ОТДЕЛЬНЫМ вызовом `setExpression({id, domain:{min,max}})` ПОСЛЕ создания самой кривой (создание+domain в одном вызове иногда не применяется).
- Чтобы точка была невидима, но её label остался виден на скриншоте — НЕ `pointOpacity:0`, а `pointSize:0, pointOpacity:1` (opacity:0 скрывает и точку, и подпись).
- `asyncScreenshot` по умолчанию не включает подписи (label) — нужен явный параметр `showLabels:true`.
- Функции `\cos`,`\sin` и т.п. ОБЯЗАТЕЛЬНО с бэкслешем в latex; при передаче через `node -e "..."` в Bash бэкслеши легко теряются — писать .cjs файл через Write, не инлайн.
