DamirNine/prikmeh/РК6-45Б_бригада_2_решение_ПМ.docx

# Решение задания по прикладной механике

РК6-45Б, бригада 2. Плоское и сложное движение точки

# Исходные данные

Для варианта РК6-45Б, бригада 2 заданы:

x(t)=3acos(bπt^2)/3,  y(t)=asin(bπt^2)/3,  t=1.

Параметры варианта:

a=8,  b=-3.

Подставим значения a и b :

x(t)=3⋅8cos(-3πt^2)/3=24cos(-πt^2 ).

Так как cos(-α)=cosα , получаем:

x(t)=24cos(πt^2 ).

Для координаты y :

y(t)=8sin(-3πt^2)/3=8sin(-πt^2 ).

Так как sin(-α)=-sinα , получаем:

y(t)=-8sin(πt^2 ).

Для второго номера законы движения подвижной системы:

z'(t)=6t^2 +2,  φ(t)=-sin(πt).

# 1. Первый номер: движение точки в плоскости

## 1.1. Положение точки и траектория

В момент времени t=1 :

x(1)=24cosπ=-24,

y(1)=-8sinπ=0.

Следовательно,

M(-24; 0).

Для получения уравнения траектории обозначим:

u=πt^2 .

Тогда:

x=24cosu,  y=-8sinu.

Отсюда:

x/24=cosu,  -y/8=sinu.

Используем тождество sin^2 u+cos^2 u=1 :

(x/24)^2 +(-y/8)^2 =1.

Получаем уравнение траектории:

(x^2)/576+(y^2)/64=1.

Это эллипс с полуосями 24 по оси x и 8 по оси y .

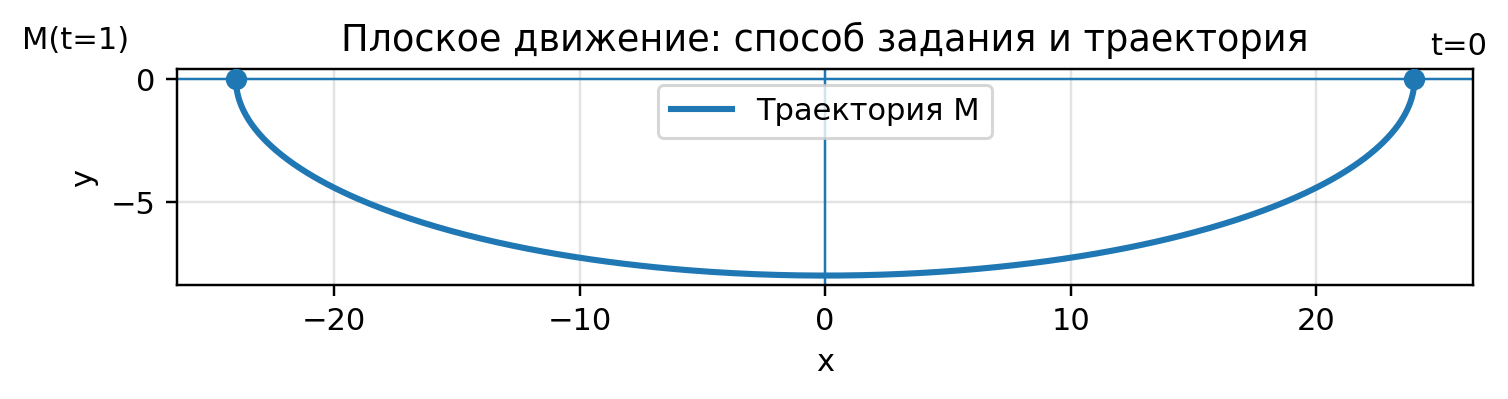
[picture p3: figure]

Рисунок 1. Плоское движение: способ задания и траектория.

## 1.2. Решение в декартовой системе координат

В декартовой системе координат скорость и ускорение находятся прямым дифференцированием координат:

V=xi+yj,

a=xi+yj.

### Скорость

Для координаты x :

x(t)=24cos(πt^2 ),

x(t)=24⋅[-sin(πt^2 )]⋅2πt.

Следовательно,

x(t)=-48πtsin(πt^2 ).

При t=1 :

x(1)=-48πsinπ=0.

Для координаты y :

y(t)=-8sin(πt^2 ),

y(t)=-8cos(πt^2 )⋅2πt.

Следовательно,

y(t)=-16πtcos(πt^2 ).

При t=1 :

y(1)=-16πcosπ=16π.

Итак,

V=0i+16πj=16πj.

Модуль скорости:

V=√(x^2 +y^2)=√(0^2 +(16π)^2).

V=16π≈50,27.

Скорость направлена вертикально вверх, так как x=0 , а y>0 .

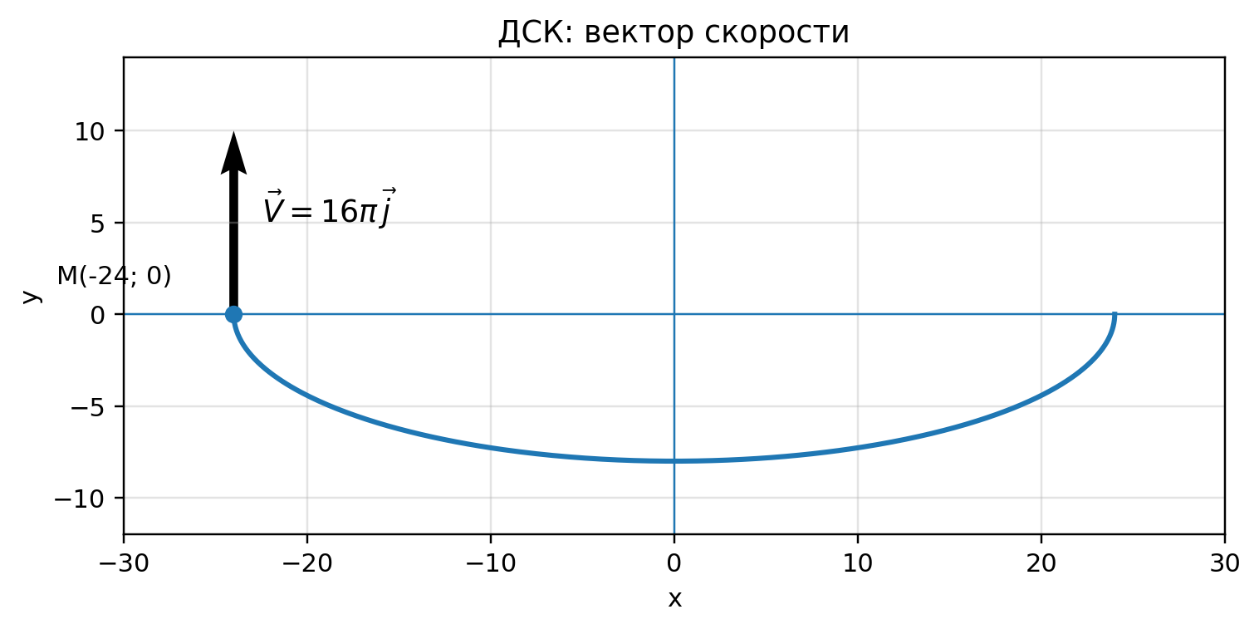
[picture p4: figure]

Рисунок 2. ДСК: вектор скорости.

### Ускорение

Вторая производная координаты x :

x(t)=-48πsin(πt^2 )-96π^2 t^2 cos(πt^2 ).

При t=1 :

x(1)=-48πsinπ-96π^2 cosπ.

x(1)=96π^2 .

Вторая производная координаты y :

y(t)=-16πcos(πt^2 )+32π^2 t^2 sin(πt^2 ).

При t=1 :

y(1)=-16πcosπ+32π^2 sinπ.

y(1)=16π.

Следовательно,

a=96π^2 i+16πj.

Модуль ускорения:

a=√((96π^2 )^2 +(16π)^2).

a=16π√(36π^2 +1)≈950,03.

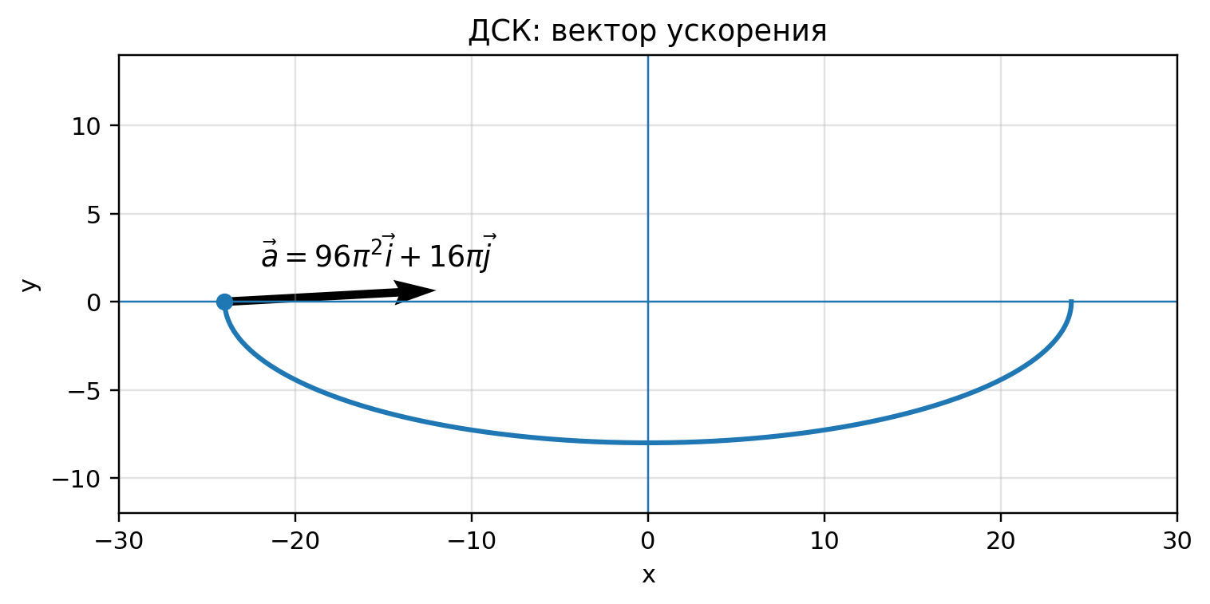
[picture p5: figure]

Рисунок 3. ДСК: вектор ускорения.

Итог для ДСК:

M(-24;0),  V=16πj,  a=96π^2 i+16πj.

## 1.3. Решение в полярной системе координат

В полярной системе координат используются величины r и θ :

r=√(x^2 +y^2),  θ=atan2(y,x).

При t=1 имеем x=-24 , y=0 , поэтому:

r=√((-24)^2 +0^2)=24.

Точка лежит на отрицательной полуоси Ox , значит:

θ=π.

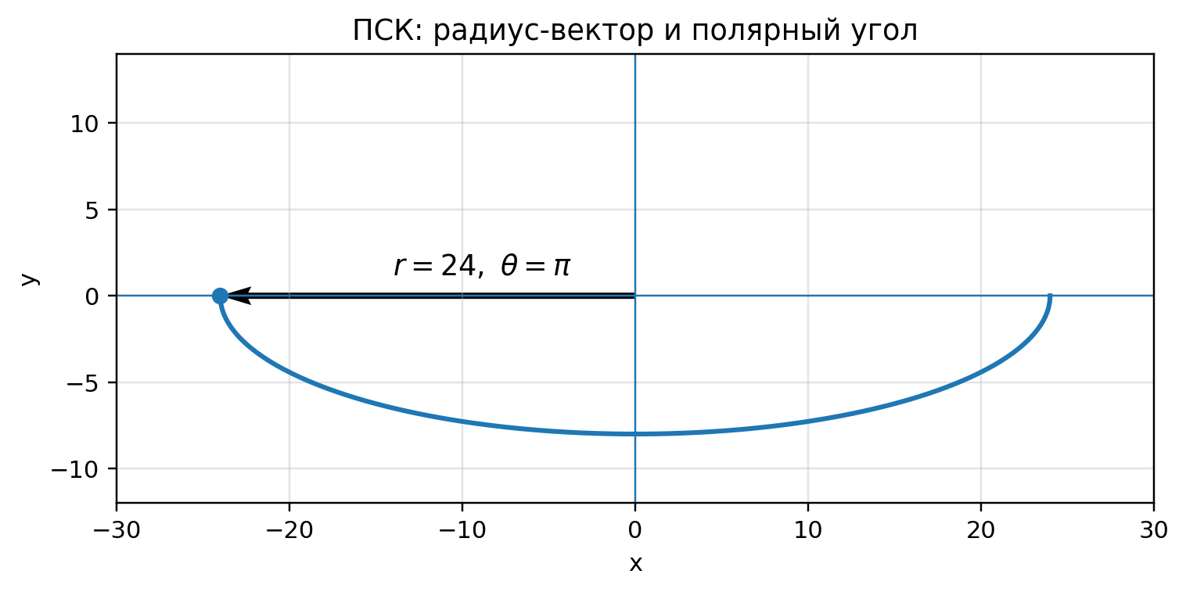
[picture p6: figure]

Рисунок 4. ПСК: радиус-вектор и полярный угол.

### Скорость в полярной системе

Скорость в полярной системе:

V=V_r e_r +V_θ e_θ ,

где:

V_r =r,  V_θ =rθ.

Компоненты можно найти через декартовы координаты:

r=(xx+yy)/r,

θ=(xy-yx)/(r^2).

Подставим значения при t=1 :

x=-24,  y=0,  x=0,  y=16π,  r=24.

Радиальная составляющая скорости:

V_r =r=((-24)⋅0+0⋅16π)/24=0.

Угловая скорость:

θ=((-24)⋅16π-0⋅0)/(24^2).

θ=-(384π)/576=-(2π)/3.

Поперечная составляющая скорости:

V_θ =rθ=24⋅(-(2π)/3)=-16π.

Итак,

V_r =0,  V_θ =-16π.

V=0e_r -16πe_θ .

По модулю:

V=16π.

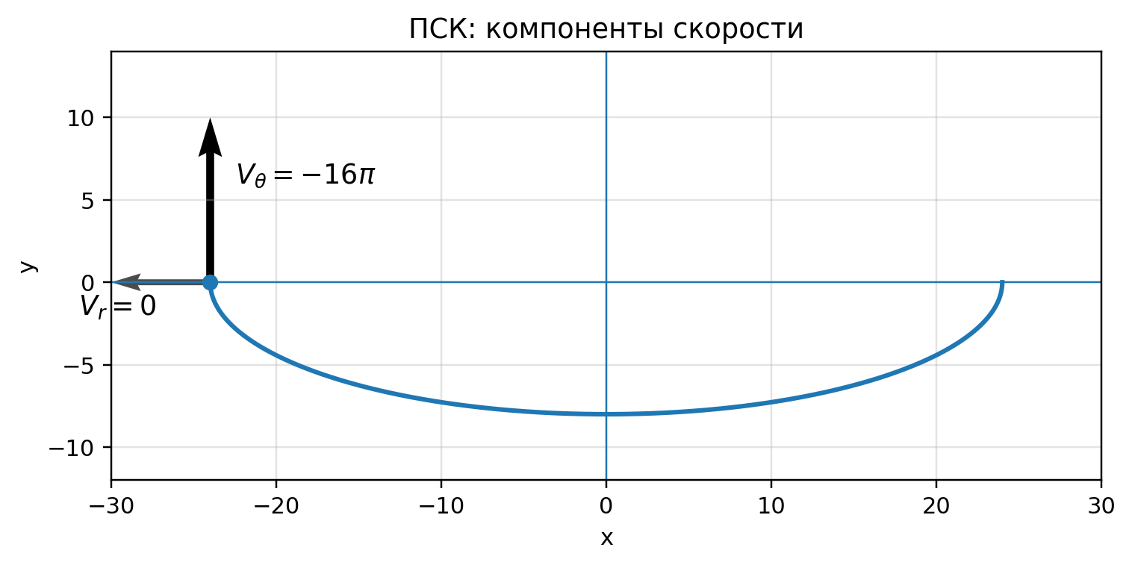
[picture p7: figure]

Рисунок 5. ПСК: компоненты скорости.

### Ускорение в полярной системе

В полярной системе ускорение записывается так:

a=a_r e_r +a_θ e_θ .

В момент t=1 :

θ=π,

поэтому:

e_r =(cosπ,sinπ)=(-1,0),

e_θ =(-sinπ,cosπ)=(0,-1).

Декартовое ускорение:

a=(96π^2 , 16π).

Радиальная компонента:

a_r =a⋅e_r =(96π^2 ,16π)⋅(-1,0).

a_r =-96π^2 .

Угловая компонента:

a_θ =a⋅e_θ =(96π^2 ,16π)⋅(0,-1).

a_θ =-16π.

Следовательно,

a=-96π^2 e_r -16πe_θ .

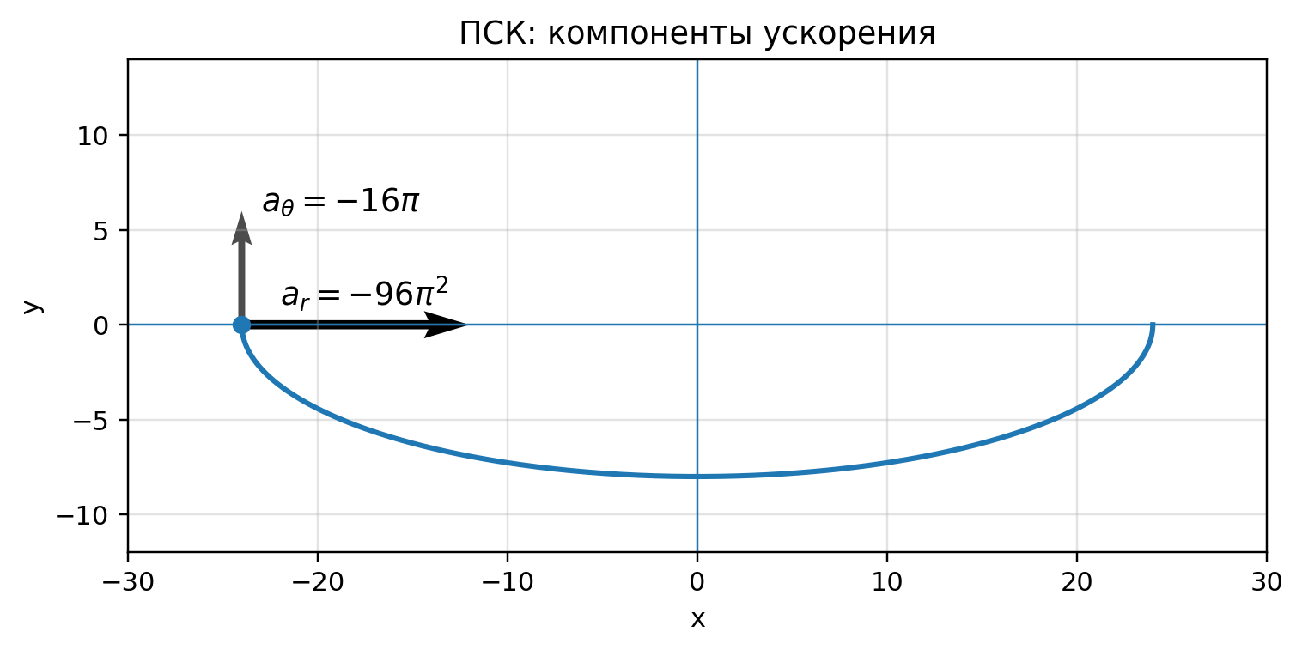
[picture p8: figure]

Рисунок 6. ПСК: компоненты ускорения.

Итог для ПСК:

r=24,  θ=π,  V_r =0,  V_θ =-16π,

a_r =-96π^2 ,  a_θ =-16π.

## 1.4. Решение при естественном способе задания движения

В естественном способе используются касательный и нормальный единичные векторы:

τ,  n.

Скорость всегда направлена по касательной:

V=Vτ.

Ускорение раскладывается на тангенциальную и нормальную составляющие:

a=a_τ τ+a_n n.

В точке M(-24;0) касательная направлена вверх, а главная нормаль направлена вправо.

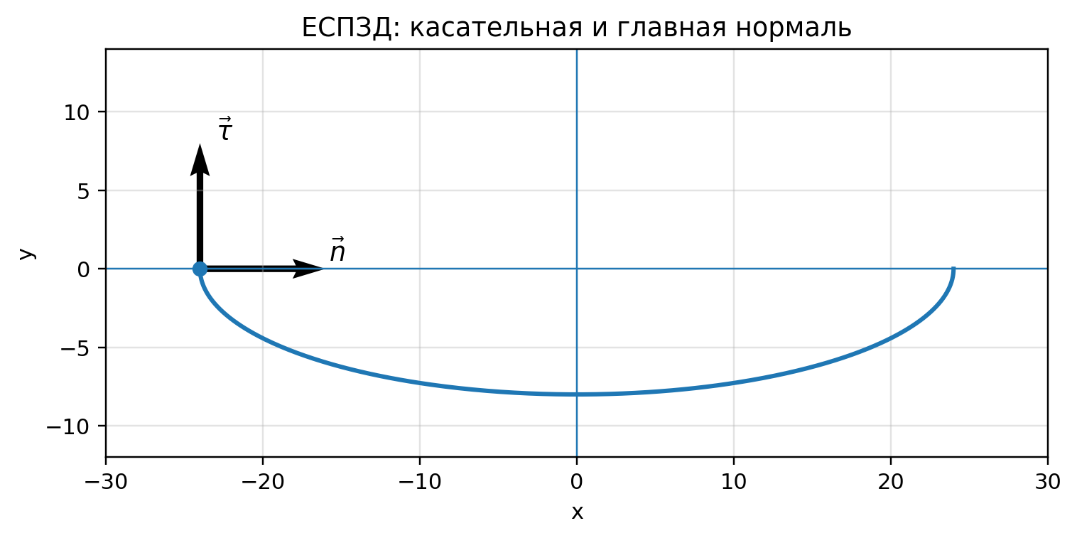
[picture p9: figure]

Рисунок 7. ЕСПЗД: касательная и главная нормаль.

### Скорость

Из решения в ДСК:

V=16πj.

Следовательно,

V=16π.

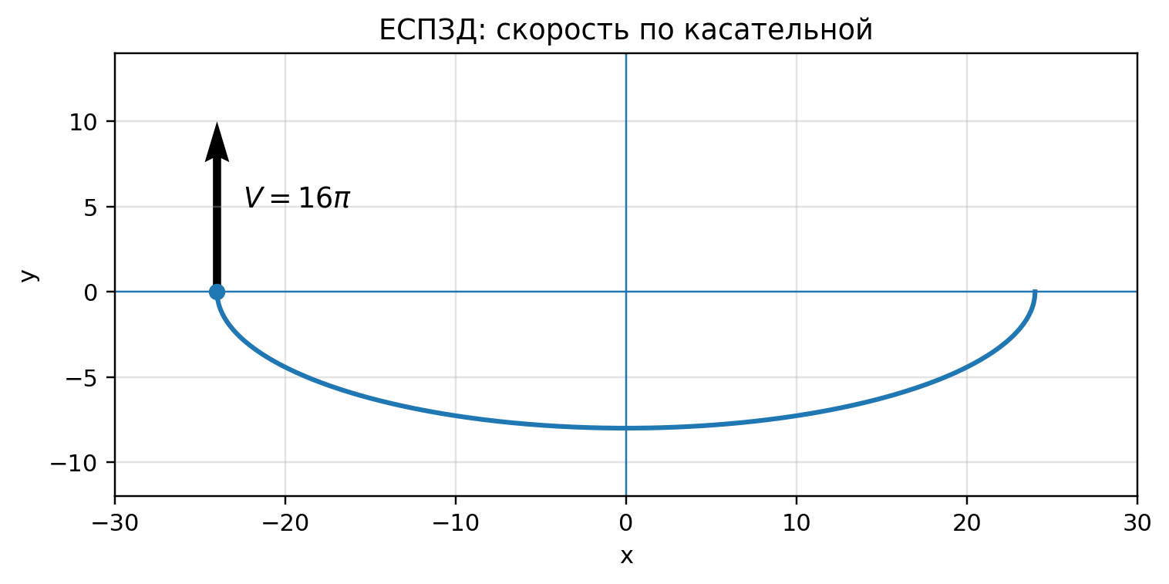
[picture p10: figure]

Рисунок 8. ЕСПЗД: скорость по касательной.

### Тангенциальное и нормальное ускорения

Тангенциальная составляющая ускорения равна проекции ускорения на касательную. Так как касательная направлена вверх, то:

a_τ =16π.

Нормальная составляющая направлена вправо:

a_n =96π^2 .

Проверка по модулю полного ускорения:

a=√(a_τ^2 +a_n^2)=√((16π)^2 +(96π^2 )^2).

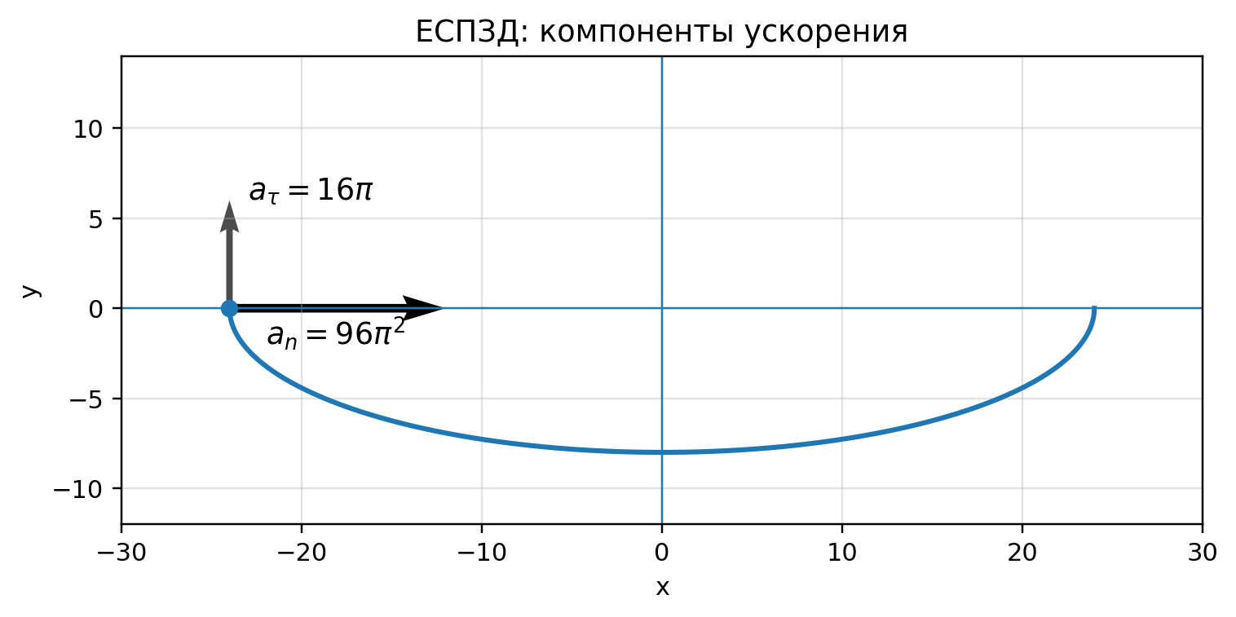
[picture p11: figure]

Рисунок 9. ЕСПЗД: компоненты ускорения.

### Радиус кривизны плоской траектории

Радиус кривизны находится по формуле:

ρ=(V^2)/(a_n).

Подставляем значения:

ρ=((16π)^2)/(96π^2)=(256π^2)/(96π^2).

ρ=8/3≈2,67.

Итог для ЕСПЗД:

V=16π,  a_τ =16π,  a_n =96π^2 ,  ρ=8/3.

# 2. Второй номер: сложное движение точки

Подвижная система движется по законам:

z'(t)=6t^2 +2,

φ(t)=-sin(πt).

При t=1 :

z'(1)=6⋅1^2 +2=8,

φ(1)=-sinπ=0.

То есть в рассматриваемый момент оси подвижной и неподвижной систем совпадают по направлению, а смещение вдоль оси z равно 8 .

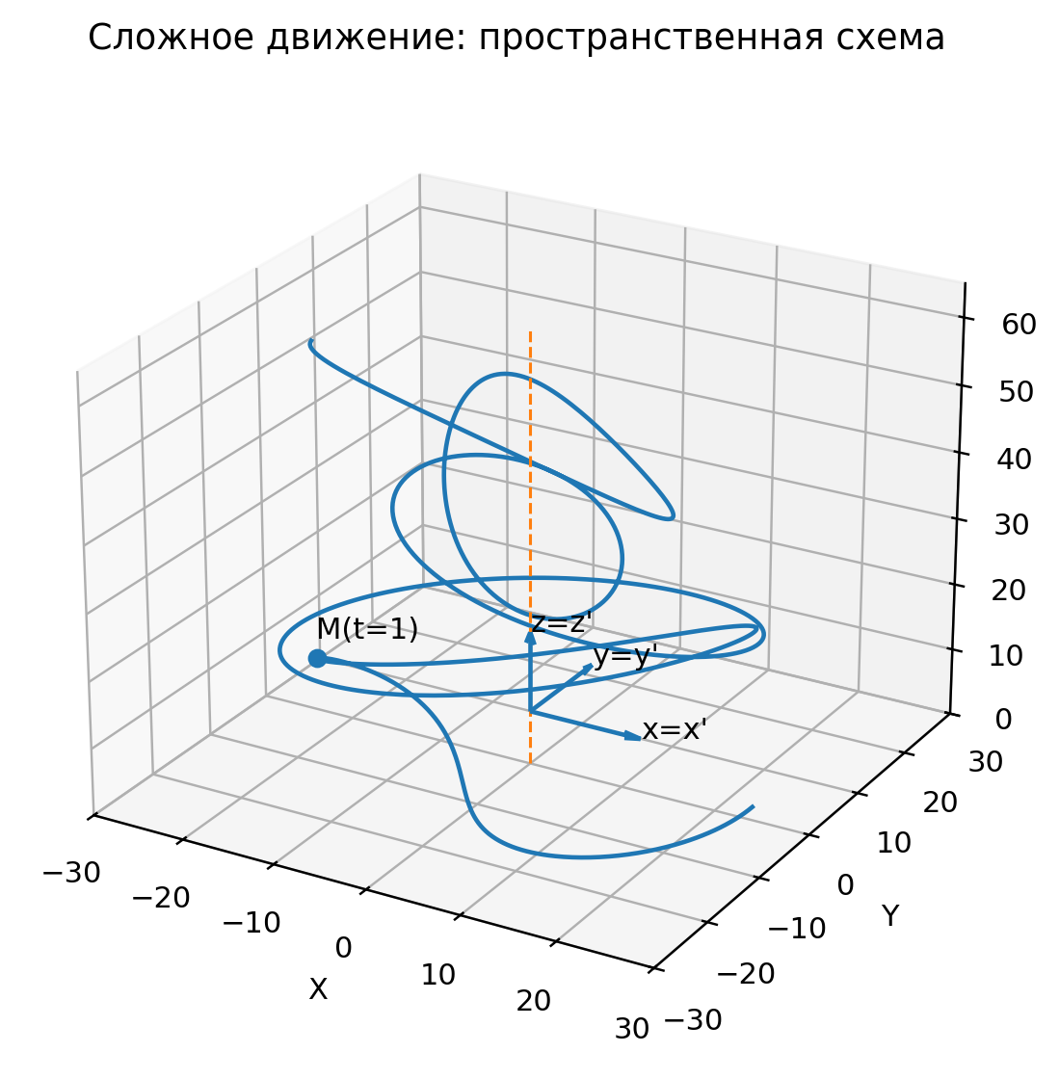
[picture p12: figure]

Рисунок 10. Сложное движение: пространственная схема.

## 2.1. Производные закона поворота и движения вдоль оси

Скорость вдоль оси z' :

z'(t)=12t.

При t=1 :

z'(1)=12.

Ускорение вдоль оси z' :

z'(t)=12.

Закон поворота:

φ(t)=-sin(πt).

Угловая скорость:

ω=φ(t)=-πcos(πt).

При t=1 :

ω=φ(1)=π.

Вектор угловой скорости направлен вдоль оси z' :

ω=πk'.

Угловое ускорение:

ε=φ(t)=π^2 sin(πt).

При t=1 :

ε=φ(1)=0.

## 2.2. Метод 1: через переход к неподвижной системе координат

В этом методе сначала записываем координаты точки в неподвижной системе. При повороте вокруг оси z на угол φ :

X=xcosφ-ysinφ,

Y=xsinφ+ycosφ,

Z=z'.

### Скорость методом 1

Дифференцируем координаты:

X=xcosφ-xφsinφ-ysinφ-yφcosφ,

Y=xsinφ+xφcosφ+ycosφ-yφsinφ,

Z=z'.

При t=1 имеем:

φ=0,  cos0=1,  sin0=0.

Также:

x=-24, y=0, x=0, y=16π, φ=π, z'=12.

Тогда:

X=x-yφ=0-0⋅π=0.

X=0.

Для координаты Y :

Y=xφ+y.

Y=(-24)π+16π=-8π.

Y=-8π.

Для координаты Z :

Z=12.

Следовательно, абсолютная скорость:

V=0i-8πj+12k.

Модуль скорости:

V=√(0^2 +(-8π)^2 +12^2).

V=4√(4π^2 +9)≈27,85.

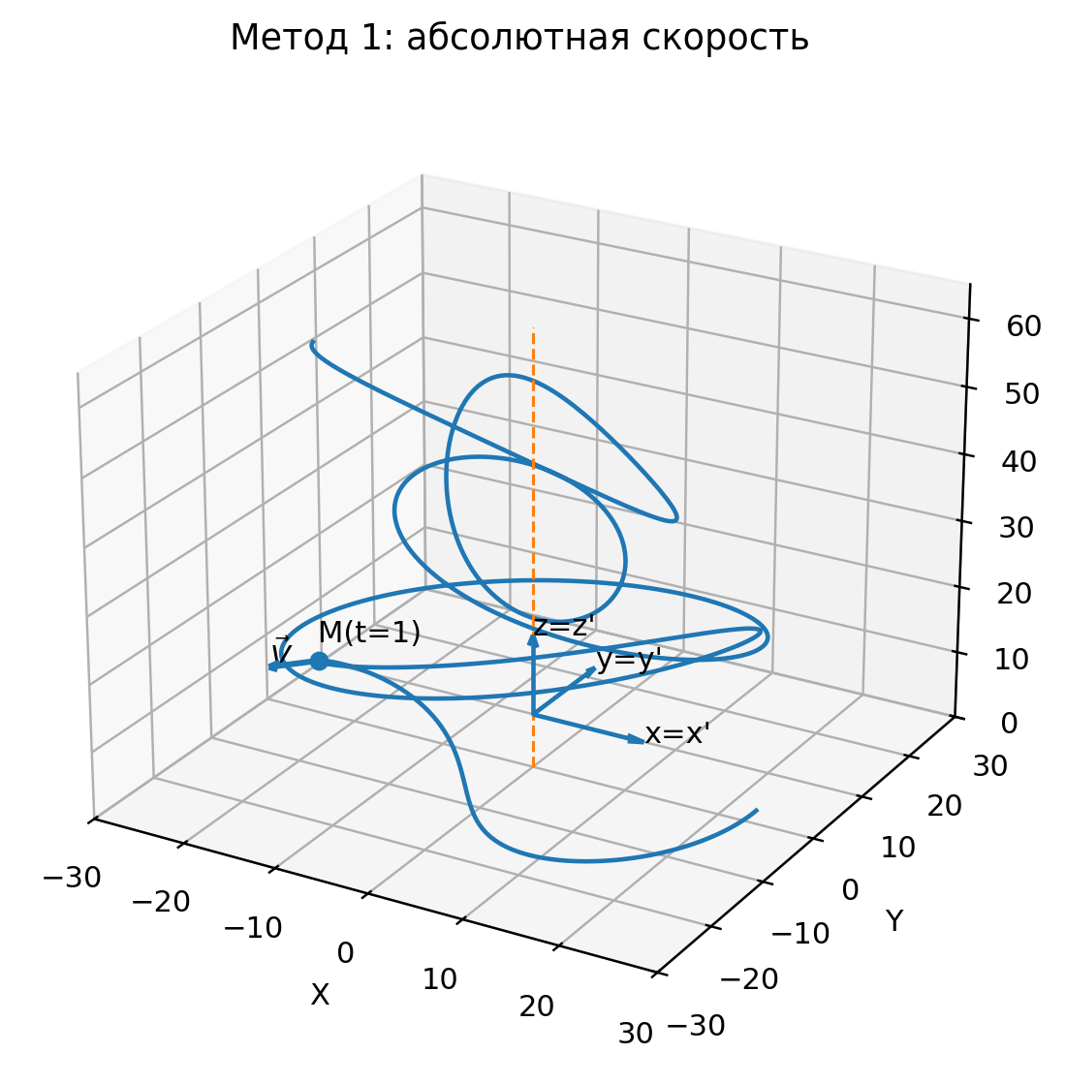
[picture p13: figure]

Рисунок 11. Метод 1: абсолютная скорость.

### Ускорение методом 1

При φ=0 удобно использовать упрощённые формулы, полученные повторным дифференцированием координат:

X=x-xω^2 -2yω-yε,

Y=y+2xω+xε-yω^2 ,

Z=z'.

Подставляем:

x=96π^2 , x=-24, ω=π, y=16π, y=0, ε=0.

Получаем:

X=96π^2 -(-24)π^2 -2⋅16π⋅π-0.

X=96π^2 +24π^2 -32π^2 =88π^2 .

X=88π^2 .

Для координаты Y :

Y=16π+2⋅0⋅π+(-24)⋅0-0⋅π^2 .

Y=16π.

Для координаты Z :

Z=12.

Следовательно:

a=88π^2 i+16πj+12k.

Модуль ускорения:

a=√((88π^2 )^2 +(16π)^2 +12^2).

a=√(7744π^4 +256π^2 +144)≈870,06.

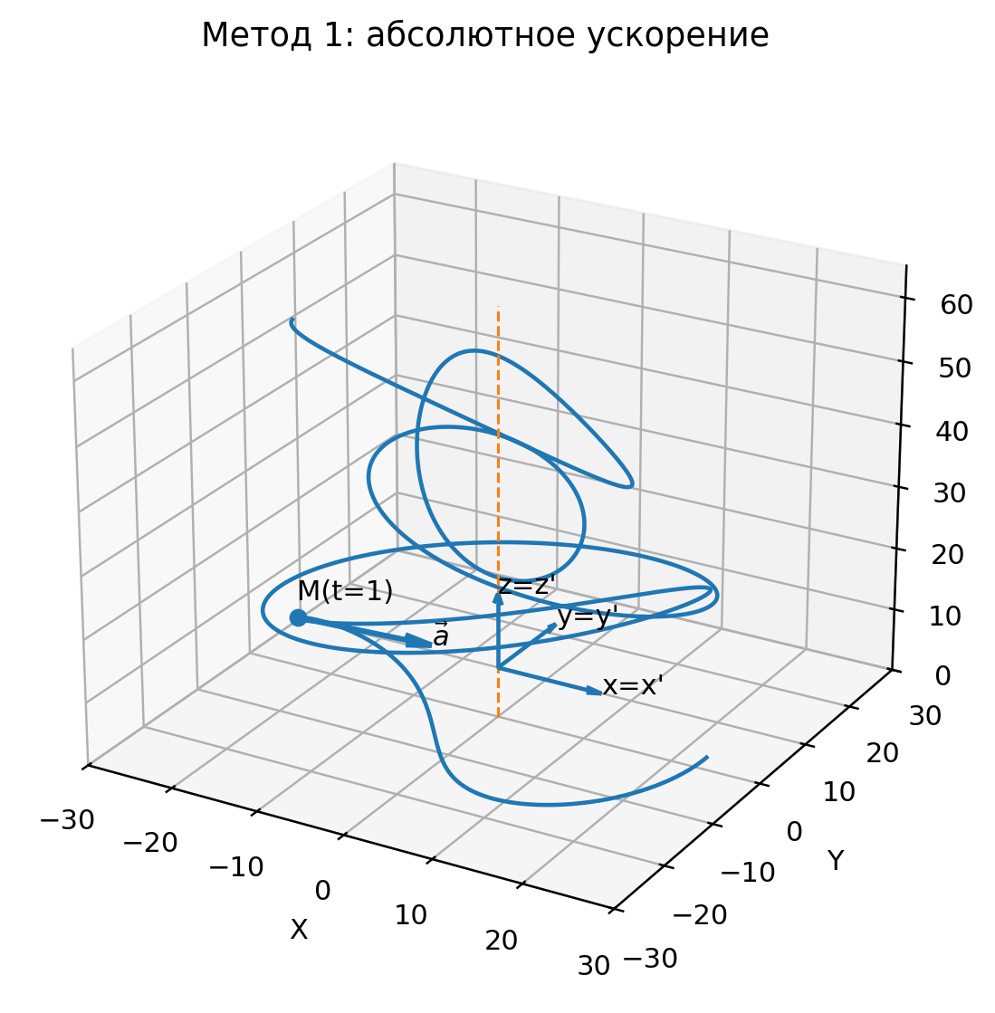
[picture p14: figure]

Рисунок 12. Метод 1: абсолютное ускорение.

## 2.3. Метод 2: через формулы сложного движения

Главная формула для скорости сложного движения:

V=V_e +V_r .

Здесь V_r - относительная скорость точки в подвижной системе, а V_e - переносная скорость, возникающая из-за вращения подвижной системы.

### Относительная скорость

Относительная скорость:

V_r =xi'+yj'+z'k'.

Подставляем значения при t=1 :

x=0, y=16π, z'=12.

Получаем:

V_r =0i'+16πj'+12k'.

### Переносная скорость

Радиус-вектор точки относительно начала подвижной системы:

r=-24i'+0j'+8k'.

Переносная скорость при вращении:

V_e =ω×r.

Так как:

ω=πk',

то:

V_e =πk'×(-24i'+0j'+8k').

Раскрываем:

V_e =-24π(k'×i')+8π(k'×k').

Так как k'×i'=j' и k'×k'=0 , получаем:

V_e =-24πj'.

### Абсолютная скорость методом 2

Складываем:

V=V_e +V_r .

V=-24πj'+16πj'+12k'.

V=-8πj'+12k'.

При t=1 угол φ=0 , поэтому оси подвижной и неподвижной систем совпадают:

i'=i,  j'=j,  k'=k.

Значит:

V=-8πj+12k.

Модуль:

V=4√(4π^2 +9)≈27,85.

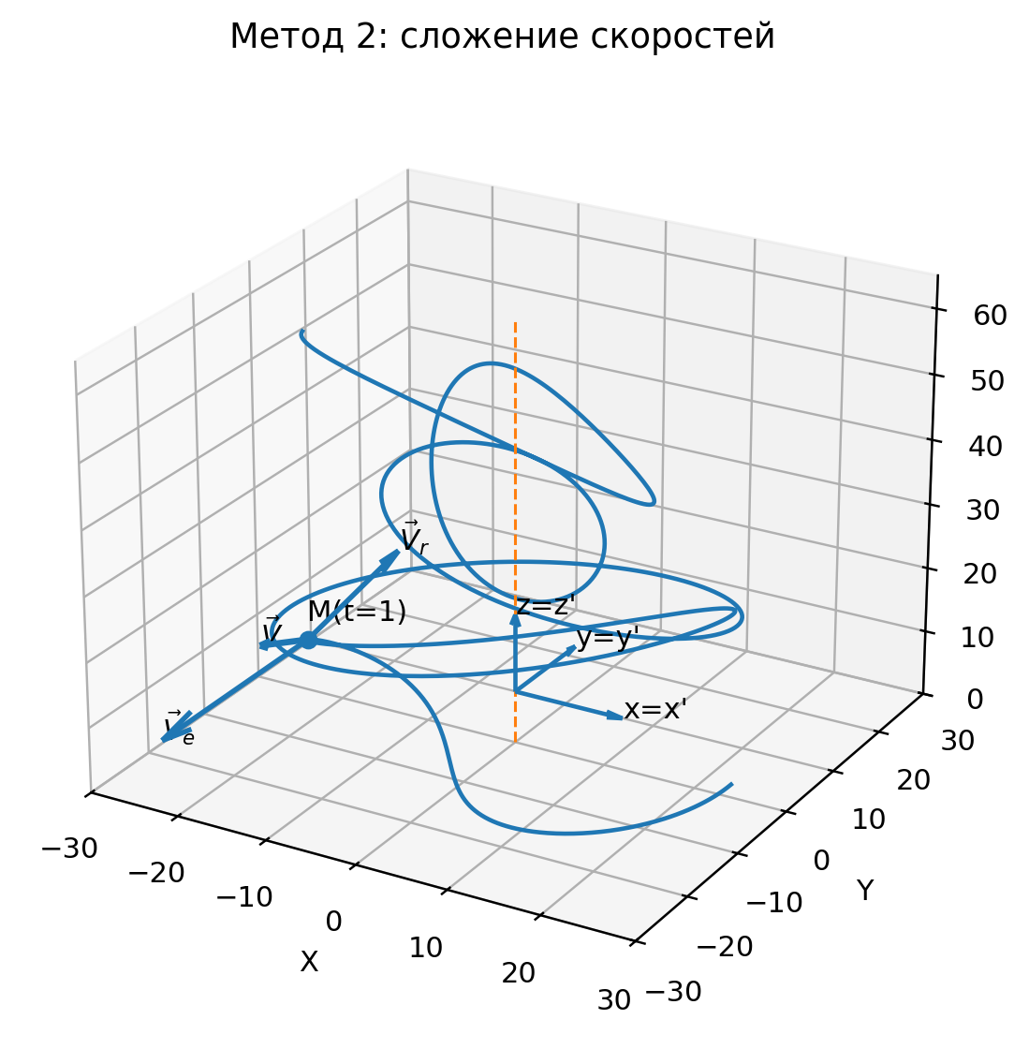
[picture p15: figure]

Рисунок 13. Метод 2: сложение скоростей.

## 2.4. Ускорение методом 2

Формула сложного движения для ускорения:

a=a_r +a_e +a_(кор) .

### Относительное ускорение

Относительное ускорение:

a_r =xi'+yj'+z'k'.

При t=1 :

x=96π^2 , y=16π, z'=12.

Следовательно:

a_r =96π^2 i'+16πj'+12k'.

### Переносное ускорение

Переносное ускорение:

a_e =ε×r+ω×(ω×r).

Так как:

ε=0,

то:

ε×r=0.

Остаётся нормальное переносное ускорение:

a_e =ω×(ω×r).

Мы уже нашли:

ω×r=-24πj'.

Тогда:

a_e =πk'×(-24πj').

a_e =-24π^2 (k'×j').

Так как k'×j'=-i' , получаем:

a_e =24π^2 i'.

### Ускорение Кориолиса

Ускорение Кориолиса:

a_(кор) =2ω×V_r .

Подставляем:

a_(кор) =2πk'×(16πj'+12k').

a_(кор) =32π^2 (k'×j')+24π(k'×k').

Так как:

k'×j'=-i',  k'×k'=0,

получаем:

a_(кор) =-32π^2 i'.

### Абсолютное ускорение методом 2

Складываем составляющие:

a=a_r +a_e +a_(кор) .

a=(96π^2 i'+16πj'+12k')+24π^2 i'-32π^2 i'.

Компоненты:

a_x =96π^2 +24π^2 -32π^2 =88π^2 ,

a_y =16π,

a_z =12.

Следовательно:

a=88π^2 i'+16πj'+12k'.

Так как при t=1 оси совпадают:

a=88π^2 i+16πj+12k.

Модуль:

a=√(7744π^4 +256π^2 +144)≈870,06.

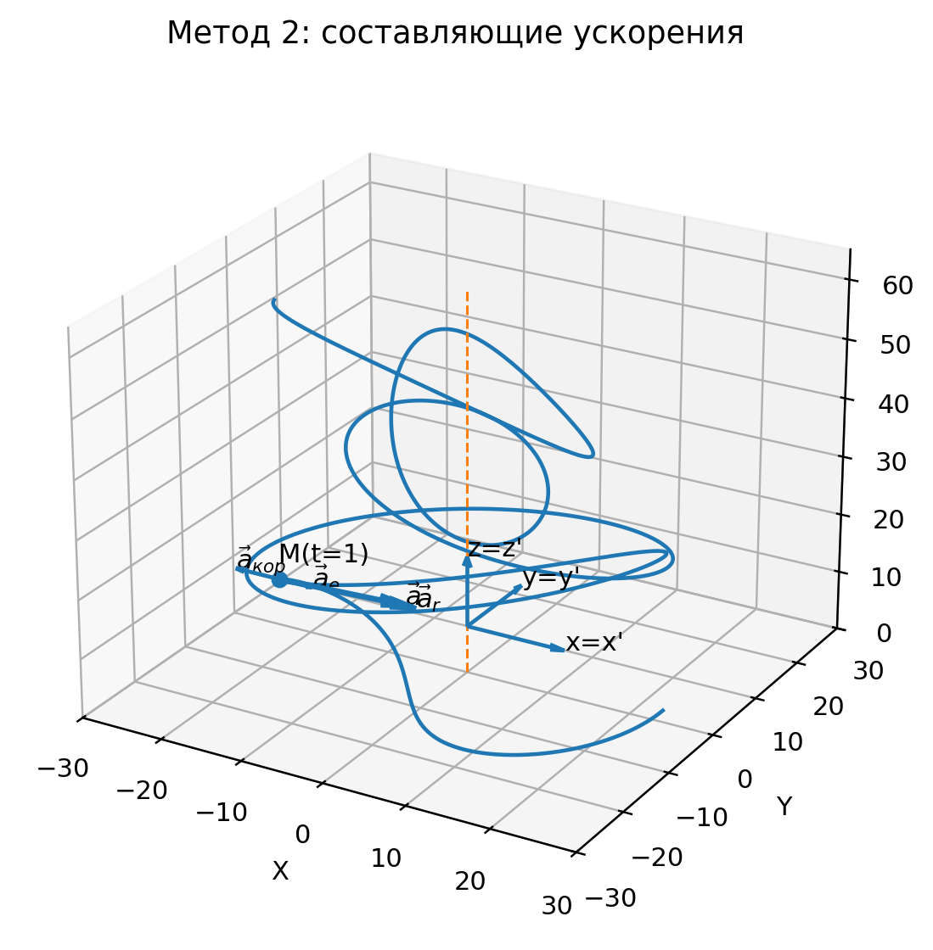
[picture p16: figure]

Рисунок 14. Метод 2: составляющие ускорения.

## 2.5. Радиус кривизны пространственной траектории

Для пространственного движения радиус кривизны вычисляется по формуле:

ρ=(V^3)/(|V×a|).

Используем найденные абсолютные скорость и ускорение:

V=(0; -8π; 12),

a=(88π^2 ; 16π; 12).

Векторное произведение:

V×a=∣i, j, k0, -8π, 1288π^2 , 16π, 12∣.

Компонента по оси x :

(V×a)_x =(-8π)⋅12-12⋅16π.

(V×a)_x =-96π-192π=-288π.

Компонента по оси y :

(V×a)_y =12⋅88π^2 -0⋅12=1056π^2 .

Компонента по оси z :

(V×a)_z =0⋅16π-(-8π)⋅88π^2 =704π^3 .

Следовательно:

V×a=-288πi+1056π^2 j+704π^3 k.

Модуль векторного произведения:

|V×a|=√((-288π)^2 +(1056π^2 )^2 +(704π^3 )^2).

Модуль скорости:

V=4√(4π^2 +9).

Тогда:

ρ=((4√(4π^2 +9))^3)/(√((288π)^2 +(1056π^2 )^2 +(704π^3 )^2)).

ρ≈0,89.

# 3. Сравнение двух методов

Первый метод дал:

V=0i-8πj+12k,

a=88π^2 i+16πj+12k.

Второй метод дал:

V=-8πj'+12k',

a=88π^2 i'+16πj'+12k'.

При t=1 :

φ(1)=0,

поэтому оси совпадают:

i'=i,  j'=j,  k'=k.

Значит, оба метода дают один и тот же результат:

V=-8πj+12k,  V=4√(4π^2 +9)≈27,85.

a=88π^2 i+16πj+12k,  a≈870,06.

Радиус кривизны пространственной траектории во втором задании:

ρ≈0,89.

# Итоговые ответы

Плоское движение:

M(-24;0),  V=16πj,  V=16π≈50,27.

a=96π^2 i+16πj,  a≈950,03.

a_τ =16π,  a_n =96π^2 ,  ρ=8/3≈2,67.

Сложное движение:

V=-8πj+12k,  V≈27,85.

a=88π^2 i+16πj+12k,  a≈870,06.

ρ≈0,89.
