DamirNine/prikmeh/курсовой/2026-10-23/Расчет_силовой_и_кинематический_тангенсный_механизм_v12_квадратный_камень.docx

КУРСОВОЙ ПРОЕКТ ПО ПРИКЛАДНОЙ МЕХАНИКЕ

Ручной настольный укупориватель бутылки Long Neck 0,33 л

Силовой и кинематический расчёт тангенсного механизма

Рабочая версия от 23.10.2026. Расчёт выполнен по цепочке: материал крышки → предел текучести +5 % → площадь кольца → усилие на ползуне → сила руки → длина рукояти → графическая оптимизация окна качания кулисы по минимуму площади треугольника O–Bн–Bк → аналоги скоростей и ускорений → закон движения кулисы ω(t) → проекции скоростей и ускорений характерных точек на оси ДСК → силовой расчёт звеньев (система 9 уравнений, моменты относительно точки M) → длина рукояти по наибольшему значению требуемой длины L(φ) → прочностной расчёт звеньев: опасные положения, эпюры N, Q, M, подбор сечений по сортаменту, выбор материала, массы звеньев.

Величины со статусом «допущение» подлежат согласованию с преподавателем (разделы 15–16).

1. Проверка исходных данных

Все числовые исходные данные расчёта сверены с первоисточниками.

Таблица 1 — Результаты сверки

№ | Утверждение | Первоисточник | Результат
1 | Крышка тип I — обжимная | ГОСТ 32624-2020, п. 4.1 | Подтверждено
2 | Жесть ЭЖК толщиной 0,16–0,30 мм | ГОСТ 32624-2020, п. 5.2.1 | Подтверждено
3 | hk = 6,00; dk = 26,75; Dk = 32,10 мм; z = 21 | ГОСТ 32624-2020, табл. 1 | Подтверждено
4 | Жесть № 22 — 0,22 мм | ГОСТ 13345-85, табл. 2 | Подтверждено; отклонение +0,01/−0,02 мм
5 | Степень твёрдости В — 61 ± 3 HR30T | ГОСТ 13345-85, табл. 5 | Подтверждено
6 | ГОСТ 13345-85 не задаёт σт в МПа | ГОСТ 13345-85 | Подтверждено: нормируются только твёрдость и глубина лунки
7 | Pry-off крышка: 0,22 мм, TH415, SR, 61 HR | STLB Kronenkorken, 10.11.2016, п. 3.3.2 | Подтверждено; документ рекомендательный
8 | TH415: σт = 415 МПа | Каталог ArcelorMittal «Steel for Packaging» (EN 10202) | Подтверждено: 415 ± 50 МПа, назначение — crown corks
9 | Диаметр крышки после обжима 28,6–28,8 мм | STLB Kronenkorken, разд. 6, приложение 6 | Подтверждено
10 | Реальное усилие укупоривания ≈ 2 кН | US 9 327 859 B1 («450 lb»); замер на укупоривателе Grifo (hobbybrauer.de, 2019) | Подтверждено двумя независимыми источниками
11 | Наружный диаметр венчика 26 H 180 — 26,55 ± 0,25 мм | ISO 12821:2019 (ГОСТ ISO 12821-2023), рис. 2 | Подтверждено
12 | Базовые силы FB и метод FR = FB·mv·mf·md·mr | ГОСТ Р ЕН 1005-3-2010, табл. 1–5 | Подтверждено
13 | Предельные усилия на рычагах по частоте использования | ГОСТ 21753-76, табл. 2 | Подтверждено
14 | Максимальная сила руки на ручном укупоривателе ≈ 120 Н | замер на укупоривателе Grifo (hobbybrauer.de, 01.04.2019) | Подтверждено (единичный замер)
15 | Перемещение руки к органу управления — 0,35 м/с; сгибание и разгибание руки — 0,7…1,7 м/с | Фех А.И. Эргономика: учеб. пособие. Томск: Изд-во ТПУ, 2014, с. 46 | Подтверждено
16 | Нормальные линейные размеры, ряды Ra5–Ra40 | ГОСТ 6636-69, пп. 1, 4, таблица | Подтверждено по полному тексту

2. Исходные данные

Таблица 2 — Исходные данные расчёта

Обозн. | Величина | Значение | Источник | Статус
σт | Предел текучести жести (TH415 ≈ ЭЖК ст. В, 0,22 мм) | 415 МПа (±50) | EN 10202, каталог ArcelorMittal | Допущение
k | Коэффициент «+5 %» над пределом текучести | 1,05 | указание преподавателя | Трактовку подтвердить
Dk | Наружный диаметр крышки до обжима | 32,10 ± 0,20 мм | ГОСТ 32624-2020, табл. 1 | Подтверждено
Dобж | Диаметр крышки после обжима | 28,6–28,8 мм | STLB, приложение 6 | Подтверждено
s | Толщина жести | 0,22 мм | ТЗ п. 17; ГОСТ 13345-85 | Принято
n | Коэффициент упрочнения и трения в инструменте | 1,5–2,0 | формула силы листовой штамповки | Принято n = 2,0
hk | Высота крышки | 6,00 ± 0,15 мм | ГОСТ 32624-2020, табл. 1 | Подтверждено
P | Сила руки на конце рукояти, направлена вертикально | 120 Н | п. 5.1 | Принято (в ТЗ п. 19 — 55 Н, обновить)
Sз | Технологический зазор | 10 мм | назначен, Ra5 | Допущение
Sоб | Часть хода под нагрузкой (обжим) | ≤ hk = 6 мм | принято с запасом | Допущение
S | Ход ползуна S = Sз + Sоб | 16 мм (в ТЗ ≈ 15) | ТЗ п. 26; ГОСТ 6636-69 | Предварительно
Lmax | Наибольшая длина рукояти | 500 мм | ограничение габарита | Допущение
emin | Наименьшее расстояние от оси кулисы до оси ползуна | 10 мм | конструктивно: ось кулисы, камень, ползун | Допущение
[ϑ] | Допускаемый угол давления на ползун | 60° | принято | Допущение
ψ | Угловой ход кулисы | 36,75° | точка равных относительных уступок (п. 6.6) | Принято
Q | Производительность | ≥ 6 бут./мин | ТЗ п. 18 | Принято
vmax | Наибольшая скорость руки (сгибание и разгибание руки) | 0,7 м/с | Фех А.И., с. 46: 0,7…1,7 м/с, нижняя граница | Подтверждено
E | Модуль упругости жести (сталь) | 2,1·10⁵ МПа | справочное значение для стали | Принято

3. Усилие укупоривания

3.1. Рабочее напряжение

σраб = k·σт = 1,05·415 = 435,75 МПа

3.2. Почему не площадь торца горлышка

Если умножить σраб на площадь кольца торца горлышка (венчик 26 H 180, ISO 12821):

Aторц = π/4·(26,55² − 17,25²) = 319,9 мм², F = 435,75·319,9 ≈ 139 кН

Это около 14 т на горлышко и в 70 раз больше реального усилия (п. 3.4). Произведение σ·Aторц — это сила, при которой пластически сплющилась бы сплошная стальная шайба площадью 320 мм². Стекло горлышка не деформируется, а металл крышки по всей площади торца не сжимается — поэтому эта площадь в расчёт не принимается.

3.3. Расчётная схема: обжим юбки крышки

При укупоривании горловина головки надвигается на крышку и уменьшает диаметр её юбки с Dk = 32,10 мм до Dобж = 28,6–28,8 мм. Пластически деформируется тонкое кольцо — стенка юбки толщиной s. Такая операция в листовой штамповке называется обжимом, и сила для неё определяется через кольцевое сечение стенки и степень деформации:

Fук = n·σраб·A·ln(Dk/Dобж), A = π·dср·s

Здесь A — площадь кольцевого сечения стенки (кольцо на эскизе преподавателя), dср = Dобж − s, ln(Dk/Dобж) — логарифмическая степень деформации по окружности, n = 1,5–2,0 — коэффициент упрочнения металла и трения в инструменте. Расчётный случай — наименьший диаметр после обжима и верхнее значение n:

A = π·(28,6 − 0,22)·0,22 = 19,61 мм², ln(32,10/28,6) = 0,1154

Fук = 2,0·435,75·19,61·0,1154 = 1974 Н ≈ 2,0 кН

Размерность: [МПа]·[мм²] = [Н/мм²]·[мм²] = [Н]; степень деформации и n безразмерны.

Таблица 3 — Усилие обжима, Н, в зависимости от Dобж и n

Dобж, мм | A, мм² | ln(Dk/Dобж) | n = 1,5 | n = 1,8 | n = 2,0
28,6 | 19,61 | 0,1154 | 1480 | 1776 | 1974
28,7 | 19,68 | 0,1120 | 1440 | 1729 | 1921
28,8 | 19,75 | 0,1085 | 1401 | 1681 | 1867

3.4. Проверка по независимым данным

Таблица 4 — Сравнение с реальными значениями

Источник / вариант | Fук | Комментарий
Расчёт по обжиму юбки (п. 3.3) | 1,40–1,97 кН | принят, Fук = 1974 Н
Патент US 9 327 859 B1: «450 lb force for application of conventional steel crowns» | ≈ 2,0 кН | промышленное укупоривание стальной крышки
Ручной укупориватель Grifo: замер силы руки 120 Н × передаточное отношение 18,4 | ≈ 2,2 кН | форум hobbybrauer.de, 2019
Площадь торца горлышка | 139 кН | отклонено, п. 3.2
Сечение юбки без степени деформации π·dk·s·σраб | 8,1 кН | отклонено: осевое смятие юбки как трубы
ТЗ, п. 25 (предварительно) | 800 Н | занижено в 2,5 раза — п. 25 ТЗ нужно обновить

Оговорка: формула силы и коэффициент n взяты из листовой штамповки; юбка кронен-крышки гофрированная (21 зубец), поэтому расчёт является инженерной оценкой.

4. Кинематический анализ

4.1. Структура механизма

Звенья: 0 — стойка, 1 — кулиса с рукоятью, 2 — камень, 3 — ползун. Кинематические пары: O (0–1, вращательная), 1–2 (поступательная), D (2–3, вращательная), 3–0 (поступательная); все — V класса. Формула строения: I(0, 1) + II ПВП(2, 3).

W = 3n − 2p5 = 3·3 − 2·4 = 1, k = p − n = 4 − 3 = 1 (формула Гохмана)

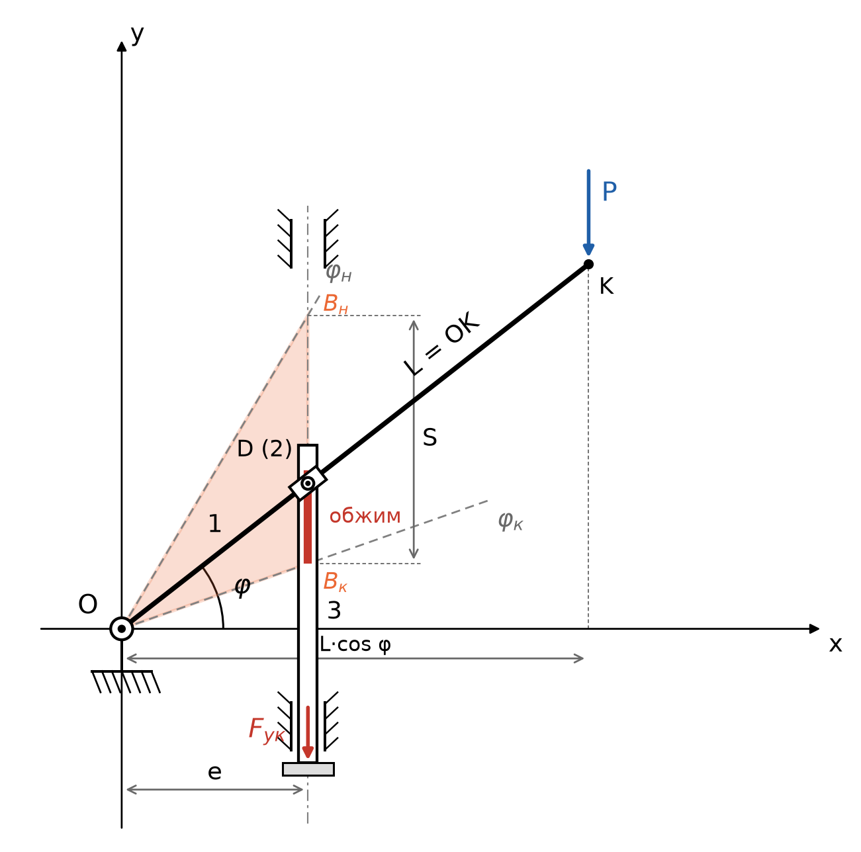
[picture p139: figure]

Рисунок 1 — Расчётная схема (без масштаба): O — ось кулисы, D — камень, K — конец рукояти; заштрихован треугольник O–Bн–Bк, красным — участок обжима; Fук — сила, с которой головка давит на крышку (на ползун крышка действует такой же по величине силой, направленной вверх, — рис. 7)

4.2. Функция положения

Векторный контур O → D; углы отсчитываются от оси x против часовой стрелки:

lOD = e + y (векторы — полужирным)

x: lOD·cos φ = e, y: lOD·sin φ = y

y = e·tg φ, lOD = e / cos φ

4.3. Аналоги скоростей и ускорений

Обобщённая координата q = φн − φ отсчитывается от начала хода; при рабочем ходе φ убывает (кулиса поворачивается по часовой стрелке), ползун движется вниз — против оси y ДСК. Координаты точек в ДСК (рис. 1): ползун D — xD = e, yD = e·tg φ; конец рукояти K — xK = L·cos φ, yK = L·sin φ. Аналоги скоростей и ускорений — проекции на оси ДСК, полученные дифференцированием координат по q (dφ/dq = −1):

ползун D: VqDx = dxD/dq = 0, VqDy = dyD/dq = −e/cos²φ

aqDx = 0, aqDy = d²yD/dq² = 2e·sin φ/cos³φ

камень относительно кулисы: Vq,r = e·sin φ/cos²φ, aq,r = e(1 + sin²φ)/cos³φ

точка C кулисы под камнем: VqC = lOD = e/cos φ

конец рукояти K: VqKx = L·sin φ, VqKy = −L·cos φ

aqKx = −L·cos φ, aqKy = −L·sin φ, |VqK| = |aqK| = L

Проекции истинных скоростей и ускорений: VDy = ω·VqDy, aDy = ω²·aqDy + ε·VqDy (так же для оси x и точки K); ускорение Кориолиса камня aк = 2ω·Vr. Здесь ω = dq/dt > 0 и ε = dω/dt — по закону движения п. 9; проекция угловой скорости кулисы на ось z ДСК ωz = dφ/dt = −ω (поворот по часовой стрелке). Знак проекции показывает направление движения относительно оси: VDy < 0 — ползун движется против оси y.

4.4. Ход ползуна, масштаб и угол давления

S = e·(tg φн − tg φк) ⇒ e = S / (tg φн − tg φк)

Все линейные размеры механизма пропорциональны e — «масштаб из хода». Без учёта трения камень давит на ползун по нормали к пазу кулисы, поэтому угол давления на ползун равен φ.

5. Силовой расчёт рукояти

5.1. Сила руки

Нажатие одной рукой, сила P направлена вертикально. Сила сопоставлена с нормами и с замером на серийном ручном укупоривателе:

Таблица 5 — Сила руки по нормам и замерам

Источник | Условия | P, Н
ГОСТ Р ЕН 1005-3-2010, табл. 1 | одной рукой вниз, базовая сила FB: бытовое / профессиональное применение | 44 / 75
ГОСТ Р ЕН 1005-3-2010, п. 4.2, табл. 2–5 | то же с множителями mv = 0,8; mf = 0,5 (6 бут./мин); md = 1,0; mr = 0,5 | 9 / 15
ГОСТ 21753-76, табл. 2 | всей рукой, 17–240 раз в смену | 39 (4 кгс)
ГОСТ 21753-76, табл. 2 | двумя руками, менее 5 раз в смену, движение «вверх — вниз» | 137 (14 кгс)
Замер на ручном укупоривателе Grifo | наибольшая сила руки | ≈ 120

Методика ГОСТ Р ЕН 1005-3 для режима 6 бутылок в минуту рекомендует лишь 9–15 Н; при усилии обжима ≈ 2 кН ручной укупориватель с такой силой нереализуем (п. 5.3). Реальные ручные укупориватели работают при силе руки около 120 Н. Принимается:

P = 120 Н (вертикально)

5.2. Длина рукояти

Рукоять — прямое продолжение кулисы. Вертикальная сила P на конце K совершает работу на вертикальном перемещении точки K: d(L·sin φ) = L·cos φ·dφ. По принципу возможных перемещений (трение не учитывается):

P·L·cos φ·dφ = F·dy = F·e/cos²φ·dφ ⇒ F = P·L·cos³φ / e

L = Fук·e / (P·cos³φmax)

Здесь φmax — наибольший угол кулисы на участке обжима (начало обжима, tg φоб = tg φк + Sоб/e).

5.3. Энергетическая проверка

Работа руки на участке обжима не меньше работы обжима. Если сила обжима постоянна на всём участке Sоб, вертикальный путь руки на этом участке:

sруки ≥ Fук·Sоб / P = 1974·6 / 120 = 99 мм

Механизм может только распределить этот путь между длиной рукояти и углом её поворота, но не сократить его. При P = 9–15 Н путь руки на одном обжиме составил бы 0,8–1,3 м — поэтому рекомендуемые значения ГОСТ Р ЕН 1005-3 для ручного укупоривания неприменимы.

6. Выбор окна качания кулисы по минимуму площади треугольника O–Bн–Bк

6.1. Целевая функция

Критерием кинематического синтеза по указанию преподавателя принимается минимальная площадь треугольника O–Bн–Bк, образованного осью кулисы O и крайними положениями точки ползуна. Полный ход ползуна S задан, поэтому расстояние e не является независимым параметром: оно однозначно определяется выбранным окном углов кулисы.

S = e·(tan φн - tan φк)

ψ = φн - φк, φн = φк + ψ

e(φк, ψ) = S / [tan(φк + ψ) - tan φк]

Площадь красного треугольника равна половине произведения его основания S на расстояние e:

A = 1/2·e·S

После исключения e получаем целевую функцию, непосредственно зависящую от положения и углового хода кулисы:

A(φк, ψ) = S² / {2·[tan(φк + ψ) - tan φк]}

Для принятого хода S = 16 мм выполняется A = 8e и e = A/8. Поэтому e удобно показывать на дополнительной правой шкале графика A_min(ψ): это тот же результат оптимизации, выраженный как основной геометрический размер механизма.

6.2. Ограничения оптимизации

При построении допустимой области сохранены ограничения текущей расчётной модели: Fук = 1974 Н; P = 120 Н; S = 16 мм; Sоб = 6 мм; L ≤ 500 мм; e ≥ 10 мм; |φ| ≤ 60°. Для каждого значения ψ положение окна φк → φн выбирается так, чтобы площадь A была минимальной и одновременно выполнялись геометрические и силовые ограничения.

L = Fук·e / [P·cos³ φоб], φоб = arctan(tan φк + Sоб/e)

6.3. Зависимость площади A от конечного угла φк

На рисунке 2 показана зависимость A = f(φк) при фиксированных значениях углового хода ψ. Каждая кривая показывает, как смещение окна качания влияет на площадь при неизменном ходе S. Точками отмечены минимальные допустимые значения с учётом ограничений из п. 6.2.


Рисунок 2 — Зависимость площади треугольника A от конечного угла φк при различных значениях углового хода ψ; точками — минимум с учётом ограничений п. 6.2, крупной точкой — принятый вариант ψ = 36,75°

6.4. Зависимость минимальной площади Aₘᵢₙ от углового хода ψ

Для каждого ψ определено минимальное допустимое значение площади. На рисунке 3 левая вертикальная ось показывает Amin, первая правая — соответствующее расстояние e = 2A/S = A/8, вторая правая — относительную уступку δ (п. 6.6). Вертикальными линиями показана смена активных ограничений: при малых ψ минимум задаётся ограничением длины рукояти, затем — предельным углом φн = 60°, а при больших ψ дальнейшее уменьшение площади прекращается из-за e ≥ 10 мм. Оранжевой прямой на тот же график нанесён угловой ход ψ — второй критерий выбора (п. 6.6).


Рисунок 3 — Минимальная допустимая площадь Amin(ψ) и угловой ход ψ в шкале относительных уступок; пересечение — компромисс равных уступок, принятый вариант

6.5. Численные результаты оптимизации

Таблица 6 — Результаты минимизации площади при различных ψ и относительные уступки (выделено — точка компромисса, принятый вариант)

ψ, ° | φк, ° | φн, ° | e, мм | Aₘᵢₙ, мм² | φоб, ° | L, мм | δA, % | δψ, %
30 | 6,75 | 36,75 | 25,46 | 203,7 | 19,49 | 500 | 154,6 | 2,3
35 | 20,99 | 55,99 | 14,57 | 116,5 | 38,50 | 500 | 45,7 | 19,3
36,75 | 22,72 | 59,47 | 12,53 | 100,2 | 41,91 | 500 | 25,3 | 25,3
40 | 20,00 | 60,00 | 11,70 | 93,6 | 41,25 | 453 | 17,0 | 36,4
45 | 15,00 | 60,00 | 10,93 | 87,4 | 39,25 | 387 | 9,3 | 53,4
50 | 10,00 | 60,00 | 10,28 | 82,3 | 37,22 | 335 | 2,8 | 70,5
52,5 | 7,49 | 59,99 | 10,00 | 80,0 | 36,19 | 313 | 0,0 | 79,0

6.6. Выбор расчётного варианта

Площадь треугольника и угловой ход ψ — два противоречивых критерия: уменьшение площади (и расстояния e) требует увеличения углового хода, а угловой ход рукояти желательно иметь наименьшим. Строгий минимум площади в принятой области — ψ ≈ 52,5°, e = 10 мм, A = 80 мм², но угловой ход при этом на 79 % больше наименьшего допустимого.

Чтобы сравнить критерии на одном графике, оба выражены в относительных уступках от своих наилучших допустимых значений:

δA = Amin(ψ)/A* − 1, A* = 80,0 мм² (e = 10 мм)

δψ = ψ/ψ* − 1, ψ* = 29,33° (наименьший ψ при L ≤ 500 мм)

На рисунке 3 угловой ход нанесён прямой A*·ψ/ψ*: в этой шкале наилучшие значения обоих критериев совмещены, и вторая правая шкала δ читается одинаково для обеих линий. Точка пересечения — компромисс равных относительных уступок: ψ = 36,75°, A = 100,2 мм², e = 12,53 мм, каждая уступка 25,3 % (таблица 6). Левее неё резко растёт площадь (при ψ = 30° уступка по площади 155 %), правее — угловой ход, а площадь почти не уменьшается: после излома при ψ = 37,1° увеличение ψ на 1 % уменьшает A лишь на 0,58 %.

Принимается точка равных уступок: ψ = 36,75°, e = 12,53 мм, окно 59,47° → 22,72°, A = 100,2 мм². Расстояние e связано расчётной зависимостью e = S/(tg φн − tg φк) с ходом S = 16 мм и углами окна, поэтому по п. 1 ГОСТ 6636-69 к нормальному размеру не приводится (раздел 7). Для сравнения: при нормальном размере e = 12 мм (Ra10) окно с φн ≤ 60° требует ψ ≥ 38,3°, а при e = 14 мм (Ra20) площадь возрастает до 112 мм² (уступка 40 %).

Для принятого ψ = 36,75° окно лежит на границе ограничения L ≤ 500 мм (п. 6.2): φк = 22,72°, φн = 59,47°, e = 12,53 мм, A = 100,2 мм² (выделенная строка таблицы 6). Окончательная длина рукояти определяется силовым расчётом (п. 11.7).

7. Приведение размеров к ГОСТ 6636-69 и уточнение окна

«Стандарт не распространяется на технологические межоперационные размеры, связанные с расчетной зависимостью с принятыми значениями других параметров; на размеры, установленные в стандартах на конкретные изделия; на оптимальные размеры, замена которых нормальными линейными размерами приведет к снижению качества продукции».

ГОСТ 6636-69, п. 1.

«При выборе размеров предпочтение должно отдаваться рядам с более крупной градацией (ряд Ra5 следует предпочитать ряду Ra10; ряд Ra10 — ряду Ra20; ряд Ra20 — ряду Ra40)».

ГОСТ 6636-69, п. 4.

7.1. Расстояние e и окно кулисы

Расстояние e = 12,53 мм принято в точке равных уступок (п. 6.6). Оно связано расчётной зависимостью e = S/(tg φн − tg φк) с нормальным ходом S = 16 мм и углами окна, поэтому по п. 1 ГОСТ 6636-69 к нормальному размеру не приводится. Окно кулисы из условия точного хода при ψ = 36,75°:

φн = 59,47°, φк = 22,72°, ψ = 36,75°, φоб = arctg(tg 22,72° + 6/12,53) = 41,91°

L0 = 1974·12,53 / (120·cos³41,91°) ≈ 500 мм

Это оценка в запас: в ней полная сила Fук действует уже в момент касания, поэтому точка компромисса и лежит на ограничении L ≤ 500 мм (п. 6.2). Окончательная длина рукояти определяется силовым расчётом (п. 11.7) как наибольшее значение требуемой длины Lтреб(φ) при допустимой силе руки 120 Н: Lтреб max = 470 мм при φу = 41,63° → L = 500 мм (ряд Ra10); наибольшая сила руки при этом 112,8 Н. Площадь треугольника: A = ½·12,53·16 = 100,2 мм².

7.2. Остальные размеры

Таблица 7 — Нормализация размеров по ГОСТ 6636-69

Размер | Расчётное / исходное, мм | Ra10, мм | Ra20, мм | Принято, мм | Ряд | Примечание
Технологический зазор Sз | ≈ 9 | 10 | 10 | 10 | Ra5 | назначается конструктором
Ход ползуна S = Sз + Sоб | 15 (ТЗ; только в Ra40) | 16 | 16 | 16 | Ra5 | Sоб = 6 мм связан с высотой крышки и не нормализуется
Расстояние e | 12,53 | 16 | 14 | 12,53 | — | точка равных уступок; связано расчётной зависимостью с S и углами (п. 1 ГОСТ 6636-69)
Длина рукояти L | 470 (max Lтреб, п. 11.7) | 500 | 500 | 500 | Ra10 | наибольшая сила руки 112,8 Н ≤ 120 Н
Свободная зона у бутылки | ≥ 1,5·60,4 = 90,6 | 100 | 100 | 100 | Ra5
Основание a × b (ТЗ) | 200 × 150 | 200 × 160 | 200 × 160 | 200 × 160 | Ra10 / Ra5 | 150 есть только в Ra40
Длина рукояти в ТЗ | ≈ 350 | — | — | заменена расчётом | — | 350 — лишь «дополнительный размер»

К размерам бутылки, венчика, крышки и толщине жести, к Sоб, к текущим положениям y(φ), lOD(φ) и к углам ГОСТ 6636-69 не применяется (п. 1).

8. Аналоги скоростей и ускорений характерных точек

Характерные положения: начало хода (φн), начало обжима — касание головки с крышкой (φоб), конец хода (φк). Значения по формулам п. 4.3 при e = 12,53 мм, L = 500 мм; размерность — мм на радиан (мм/рад, мм/рад²). Для ползуна даны проекции аналогов на ось y ДСК, проекции на ось x равны нулю (VqDx = aqDx = 0); минус у VqDy — при рабочем ходе ползун движется против оси y.

Таблица 8 — Аналоги скоростей и ускорений

Положение | φ | lOD | VqDy | aqDy | Vq,r | aq,r | 2Vq,r | F/P
начало хода | 59,47° | 24,67 | −48,56 | 164,67 | 41,83 | 166,51 | 83,65 | 5,23
начало обжима | 41,91° | 16,84 | −22,62 | 40,62 | 15,11 | 43,97 | 30,23 | 16,45
конец хода | 22,72° | 13,58 | −14,73 | 12,33 | 5,69 | 18,35 | 11,38 | 31,32

Для конца рукояти K: |VqK| = L = 500 мм/рад, нормальная составляющая аналога ускорения a^nqK = L = 500 мм/рад²; проекции на оси ДСК в начале обжима: VqKx = L·sin φ = 334,0 мм/рад, VqKy = −L·cos φ = −372,1 мм/рад (конец рукояти движется вниз и вправо). Передаточное отношение по силе F/P = L·cos³φ/e на участке обжима наименьшее в его начале; в начале пластической деформации (φу = 41,63°) оно равно 16,66, и сила руки 1880/16,66 = 112,8 Н (п. 11.7).

9. Закон движения кулисы ω(t)

9.1. Формулы

Закон изменения угловой скорости кулисы на рабочем ходе — трапеция: разгон с постоянным ускорением до ωmax, установившееся движение, торможение до остановки. Угловой ход равен площади под графиком ω(t):

ψ = ½·ωmax·tр + ωmax·tу + ½·ωmax·tт

εр = ωmax/tр, εт = −ωmax/tт

Фазы определяются работой укупоривателя:

- разгон — холостой ход, от начала хода до касания головки с крышкой (φн → φоб), кулиса набирает ωmax;
- установившееся движение — упругая деформация крышки, пока напряжение в юбке не достигнет предела текучести (φоб → φу);
- торможение — пластическая деформация крышки (обжим) до остановки в конце хода (φу → φк).

9.2. Упругий участок деформации крышки

Юбка крышки деформируется упруго, пока относительная деформация не достигнет предела текучести (закон Гука):

εт = σт/E = 415 / 2,1·10⁵ = 0,00198

Радиальное упругое перемещение юбки наружным диаметром Dk:

Δrу = εт·Dk/2 = 0,00198·32,10/2 = 0,032 мм

Горловина головки переводит осевой ход в радиальное обжатие юбки. За весь обжим Sоб = 6 мм радиус уменьшается на (Dk − Dобж)/2 = (32,10 − 28,6)/2 = 1,75 мм, поэтому:

tg α = 1,75/6 = 0,292 (α = 16,3°), δу = Δrу/tg α = 0,032/0,292 = 0,109 мм

Из 6 мм обжима упругий участок занимает 0,109 мм, пластический — 5,891 мм. Положения кулисы по функции положения y = e·tg φ:

φоб = arctg(tg 22,72° + 6/12,53) = 41,91°, φу = arctg(tg 22,72° + 5,891/12,53) = 41,63°

ψхх = 59,47° − 41,91° = 17,56° = 0,3065 рад

ψу = 41,91° − 41,63° = 0,28° = 0,00483 рад, ψпл = 41,63° − 22,72° = 18,91° = 0,3301 рад

9.3. Наибольшая угловая скорость и времена фаз

По эргономическим данным (Фех А.И., с. 46) сгибание и разгибание руки происходит со скоростью 0,7…1,7 м/с. Наибольшая скорость конца рукояти принимается по нижней границе, так как рука прикладывает значительное усилие:

ωmax = vmax/L = 0,7/0,5 = 1,40 рад/с

Времена фаз — из формулы трапеции для каждого участка:

tр = 2ψхх/ωmax = 2·0,3065/1,40 = 0,438 с

tу = ψу/ωmax = 0,00483/1,40 = 0,0034 с

tт = 2ψпл/ωmax = 2·0,3301/1,40 = 0,472 с

εр = 1,40/0,438 = 3,20 рад/с², εт = −1,40/0,472 = −2,97 рад/с²

tрх = 0,438 + 0,003 + 0,472 = 0,913 с

проверка: ψ = ½·1,40·0,438 + 1,40·0,0034 + ½·1,40·0,472 =

= 0,641 рад = 36,75°

Средняя скорость руки на рабочем ходе sK/tрх = 321/0,913 = 351 мм/с совпадает со скоростью перемещения руки к органу управления 0,35 м/с (Фех А.И., с. 46) — независимая проверка принятой ωmax.

Установившийся участок короткий (3,4 мс): сталь деформируется упруго лишь до 0,2 %, поэтому почти весь обжим — пластический. На рисунке 4 он показан на увеличенной вставке.

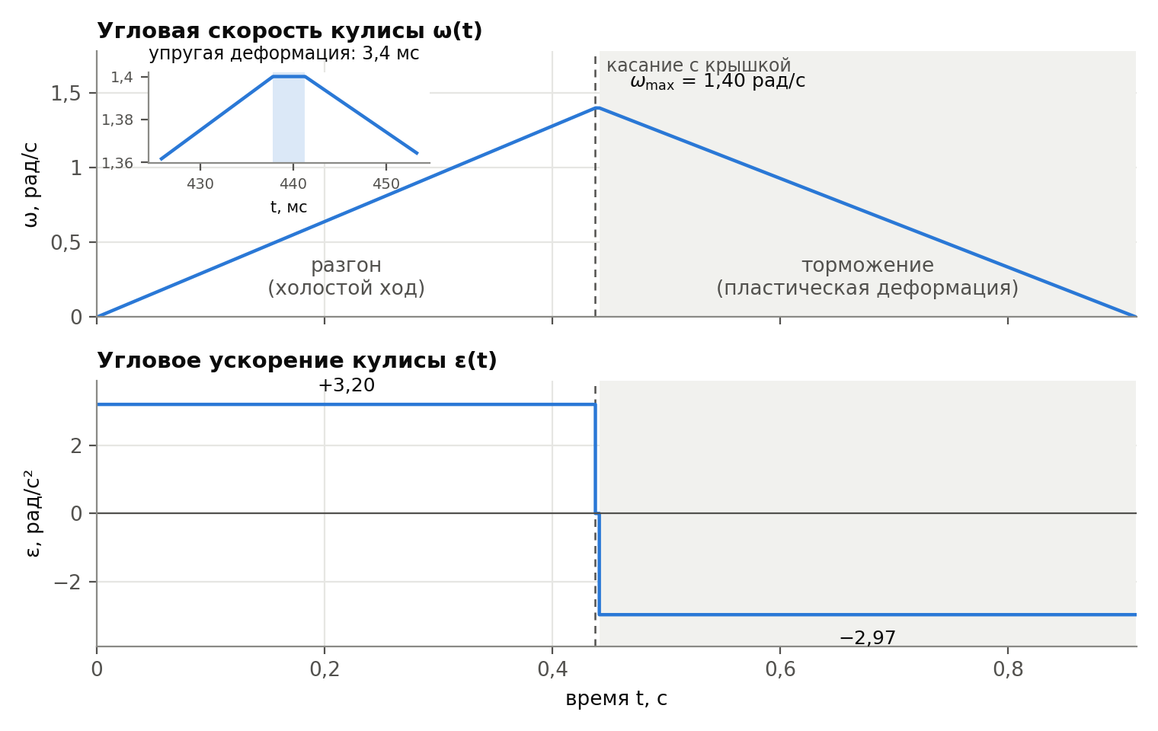
[picture p140: figure]

Рисунок 4 — Угловая скорость и угловое ускорение кулисы на рабочем ходе; серым — пластическая деформация, на вставке — упругая деформация

9.4. Проверка производительности

Tц = 60/Q = 60/6 = 10 с

Обратный ход принимается по времени равным рабочему: tрх + tобр ≈ 1,8 с. На установку и снятие бутылки остаётся 8,2 с из 10 с цикла — требование Q ≥ 6 бут./мин выполняется.

10. Скорости и ускорения характерных точек

Проекции скоростей и ускорений на оси ДСК вычисляются по аналогам (п. 4.3 и 8) и закону движения (п. 9): VDy = ω·VqDy, aDy = ω²·aqDy + ε·VqDy. Ползун движется вдоль оси y, поэтому VDx = 0 и aDx = 0, а скорость и ускорение ползуна полностью задаются проекциями на ось y. Ось y направлена вверх, а на рабочем ходе ползун движется вниз — против оси y, поэтому VDy < 0. Если знаки VDy и aDy совпадают, ползун разгоняется, если противоположны — тормозится. В моменты смены фаз угловое ускорение меняется скачком, поэтому значения даны до и после них.

Таблица 9 — Проекции скоростей и ускорений на оси ДСК в характерные моменты (L = 500 мм)

Момент | t, с | φ | ω, рад/с | ε, рад/с² | VDy, мм/с | aDy, мм/с² | VK, м/с | a^τK, м/с² | a^nK, м/с²
начало хода | 0 | 59,47° | 0 | +3,20 | 0 | −155,3 | 0 | +1,60 | 0
касание с крышкой (до) | 0,438 | 41,91° | 1,40 | +3,20 | −31,7 | +7,3 | 0,70 | +1,60 | 0,98
касание (после) — упругая деформация | 0,438 | 41,91° | 1,40 | 0 | −31,7 | +79,6 | 0,70 | 0 | 0,98
начало пластической деформации (до) | 0,441 | 41,63° | 1,40 | 0 | −31,4 | +78,2 | 0,70 | 0 | 0,98
начало пластической деформации (после) | 0,441 | 41,63° | 1,40 | −2,97 | −31,4 | +144,8 | 0,70 | −1,48 | 0,98
конец хода | 0,913 | 22,72° | 0 | −2,97 | 0 | +43,7 | 0 | −1,48 | 0

Наибольшая по модулю проекция скорости ползуна VDy = −31,9 мм/с достигается на холостом ходе при φ = 45,3° (t = 0,393 с); головка подходит к крышке с VDy = −31,7 мм/с. Наибольшая по модулю проекция ускорения aDy = −155,3 мм/с² — в начале хода (направлена вниз, ползун разгоняется). Камень скользит по пазу кулисы со скоростью до 23,9 мм/с (на холостом ходе, при φ ≈ 50,7°), в момент касания — Vr = ω·Vq,r = 1,40·15,11 = 21,16 мм/с; ускорение Кориолиса в момент касания aк = 2·1,40·21,16 = 59,2 мм/с². Конец рукояти K движется со скоростью до 0,70 м/с.

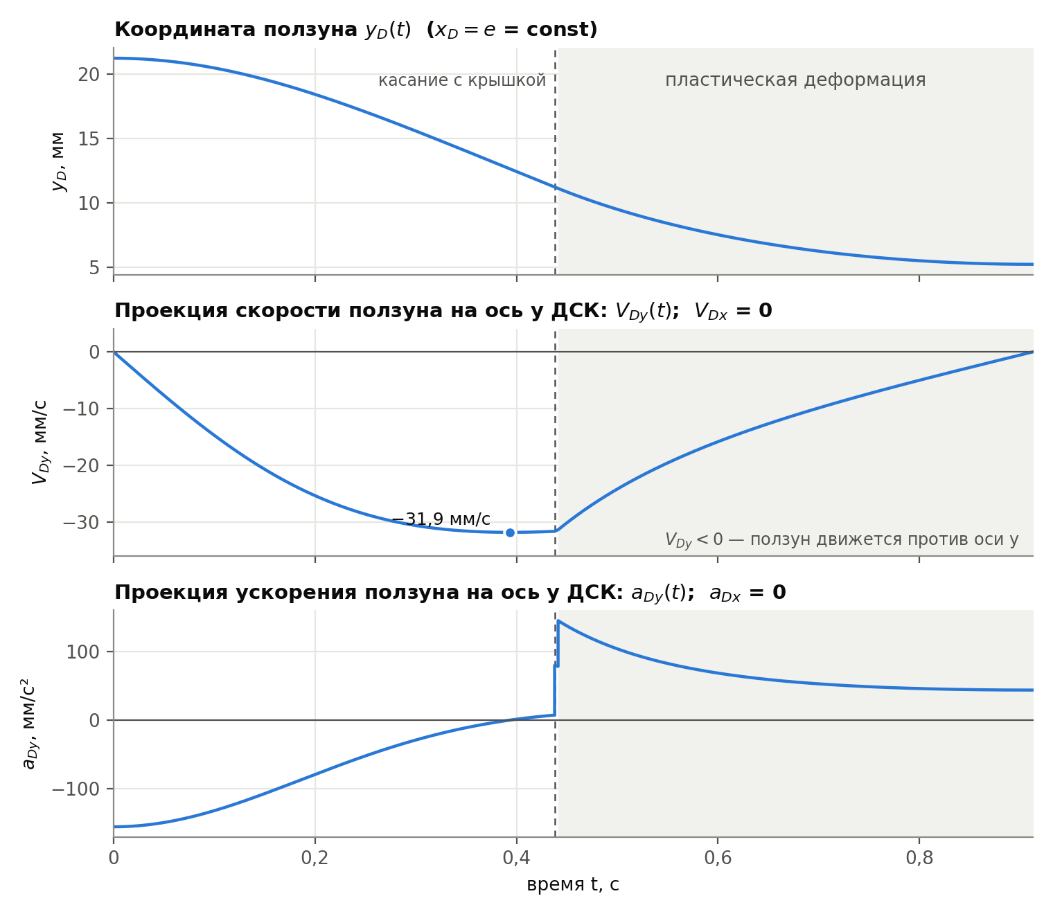
[picture p141: figure]

Рисунок 5 — Координата ползуна и проекции его скорости и ускорения на ось y ДСК на рабочем ходе (VDx = aDx = 0); серым — пластическая деформация
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
