DamirNine/prikmeh/desmos_screens/fig01_traj.png

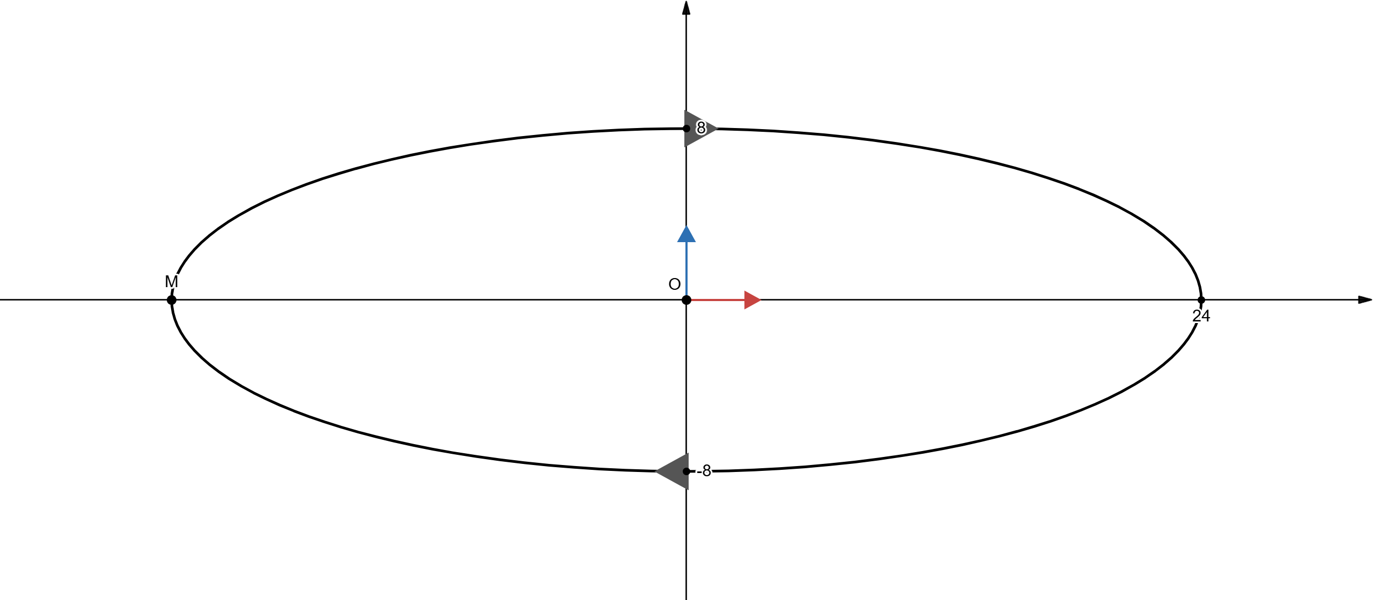
desmos_screens/fig01_traj.png
