DamirNine/prikmeh/scratch_media/check2_kamen.png

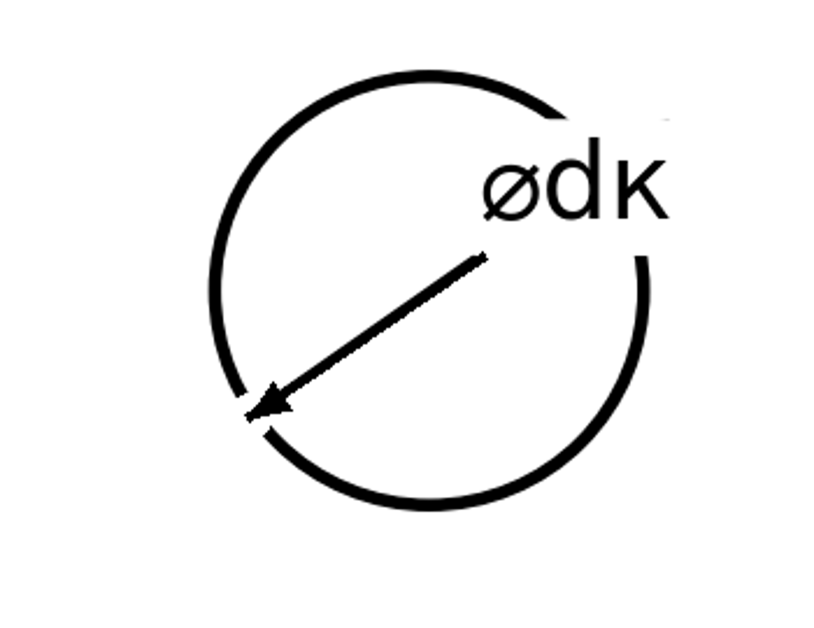
scratch_media/check2_kamen.png
