DamirNine/prikmeh/scratch_media/check2_kulisa.png

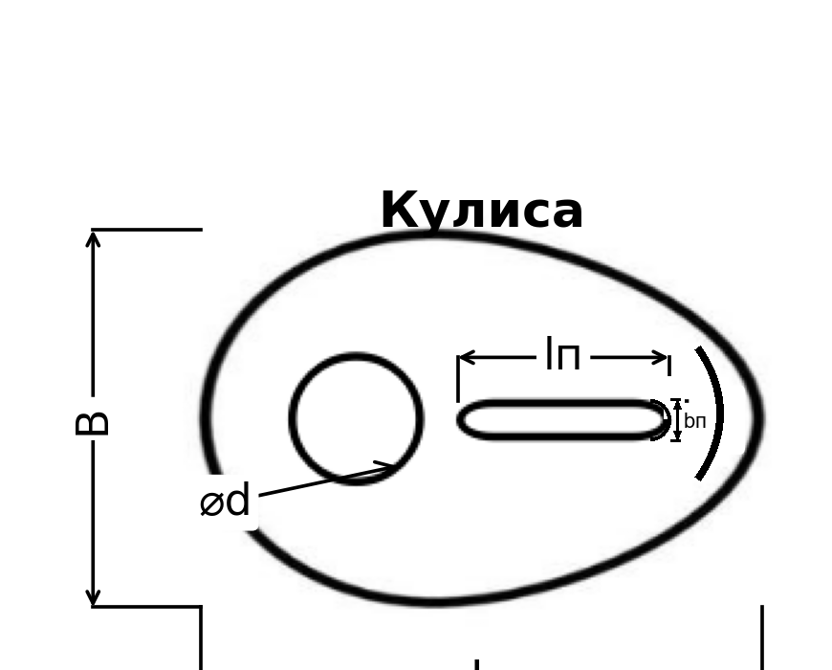
scratch_media/check2_kulisa.png
