DamirNine/prikmeh/scratch_media/check3_slot.png

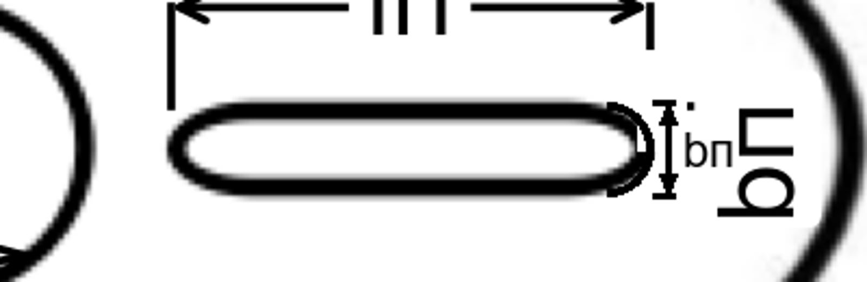
scratch_media/check3_slot.png
