DamirNine/prikmeh/scratch_media/check4_slot.png

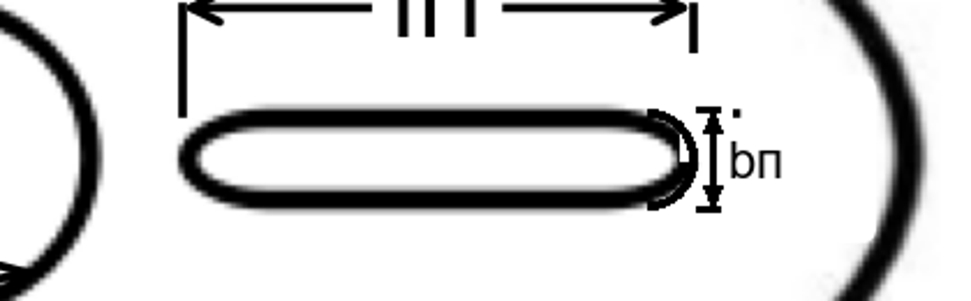
scratch_media/check4_slot.png
