DamirNine/prikmeh/scratch_media/check4_whole.png

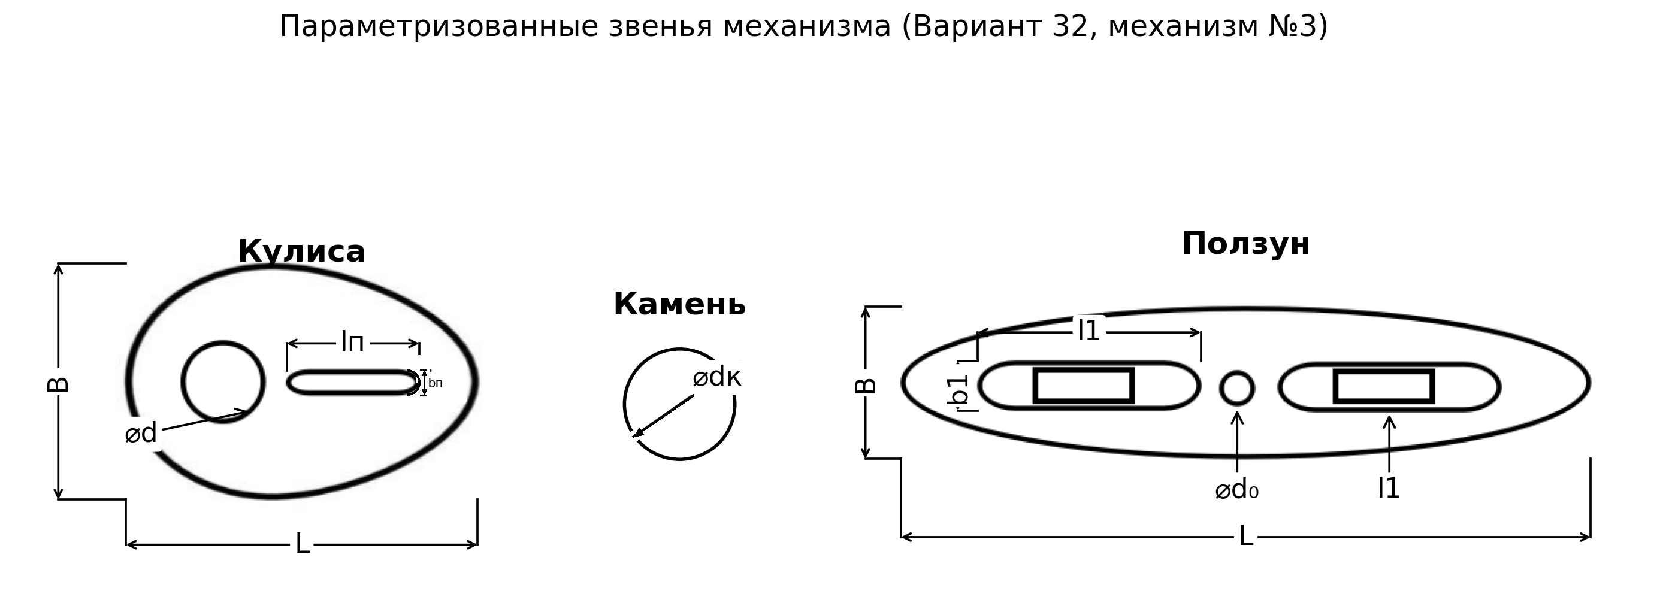
scratch_media/check4_whole.png
