DamirNine/prikmeh/scratch_media/check_bp_zoom.png

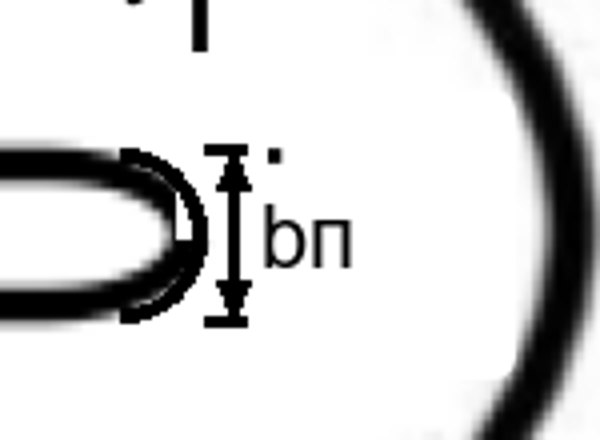
scratch_media/check_bp_zoom.png
