DamirNine/prikmeh/scratch_media/check_contour_grid.png

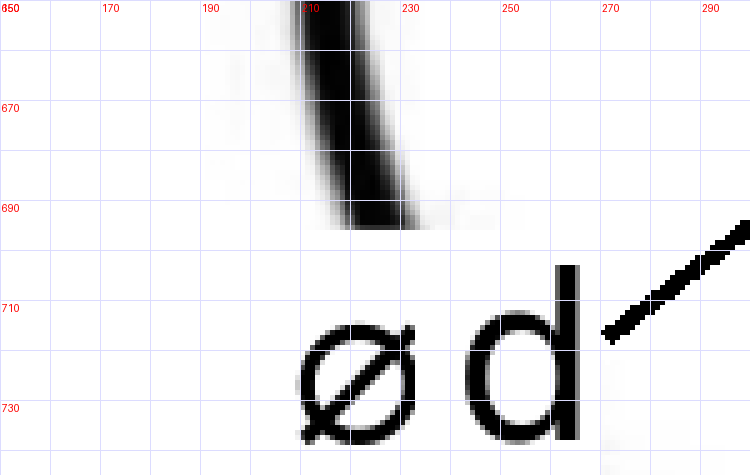
scratch_media/check_contour_grid.png
