DamirNine/prikmeh/scratch_media/check_contour_wide.png

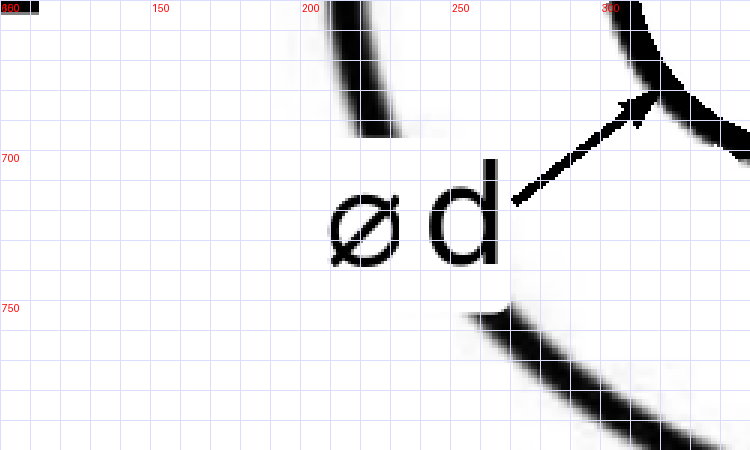
scratch_media/check_contour_wide.png
