DamirNine/prikmeh/scratch_media/check_d_actual.png

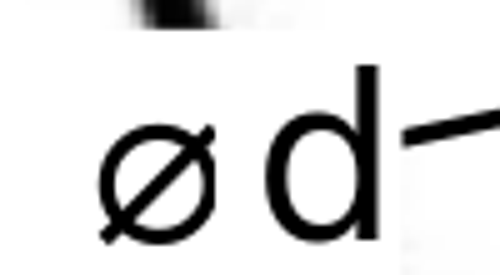
scratch_media/check_d_actual.png
