DamirNine/prikmeh/scratch_media/check_dot_zoom.png

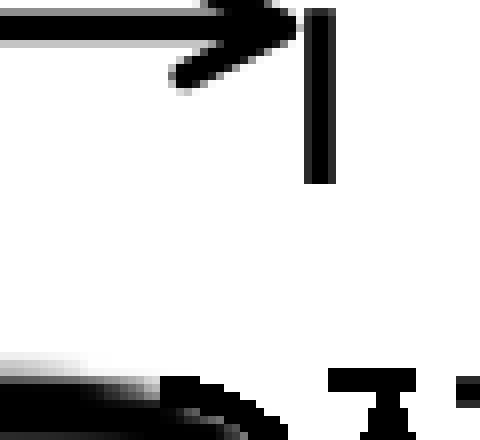
scratch_media/check_dot_zoom.png
