DamirNine/prikmeh/scratch_media/check_extra_arrow.png

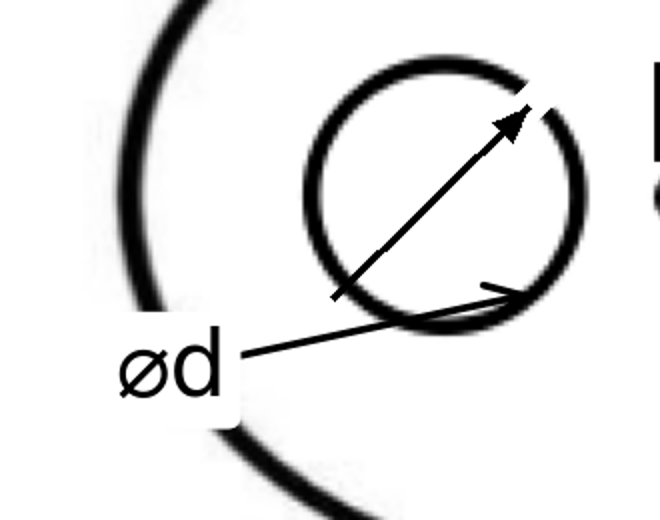
scratch_media/check_extra_arrow.png
