DamirNine/prikmeh/scratch_media/check_final_od.png

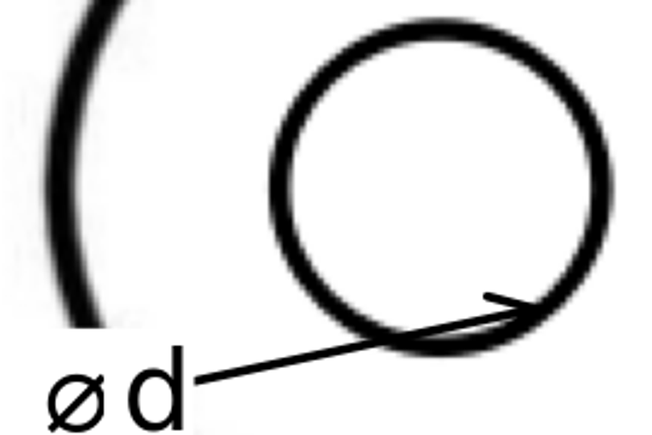
scratch_media/check_final_od.png
