DamirNine/prikmeh/scratch_media/check_full_kulisa.png

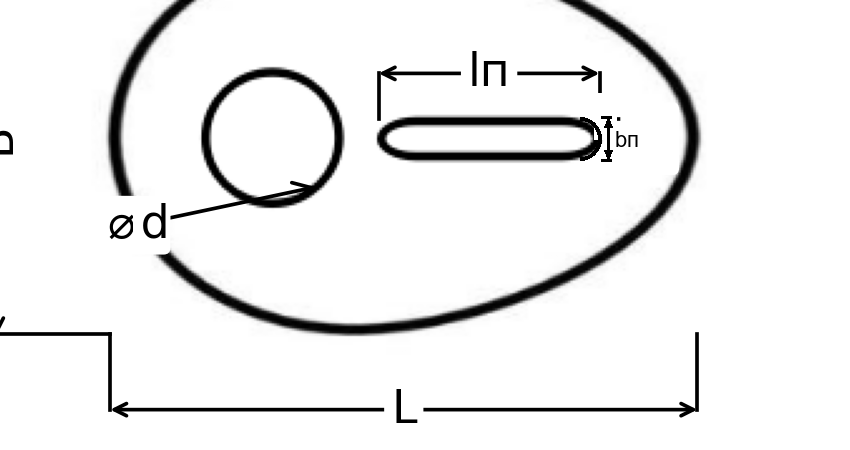
scratch_media/check_full_kulisa.png
