DamirNine/prikmeh/scratch_media/check_kulisa_full2.png

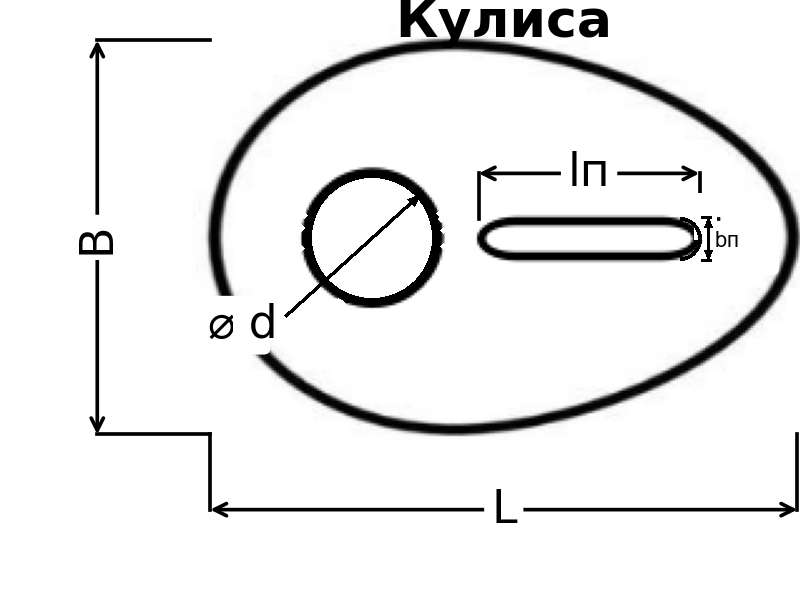
scratch_media/check_kulisa_full2.png
