DamirNine/prikmeh/scratch_media/check_label_d.png

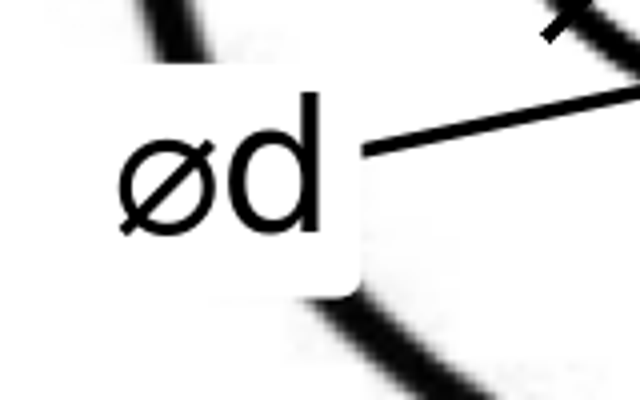
scratch_media/check_label_d.png
