DamirNine/prikmeh/scratch_media/check_label_grid.png

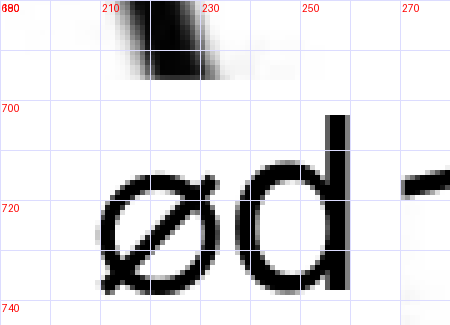
scratch_media/check_label_grid.png
