DamirNine/prikmeh/scratch_media/check_label_oval.png

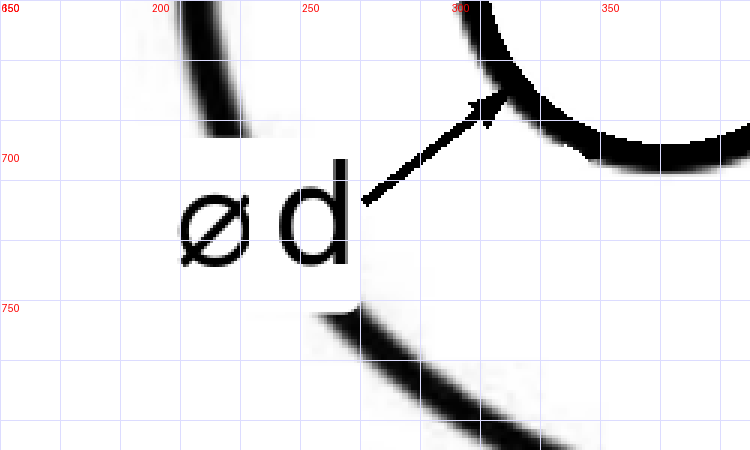
scratch_media/check_label_oval.png
