DamirNine/prikmeh/scratch_media/check_label_pixels.png

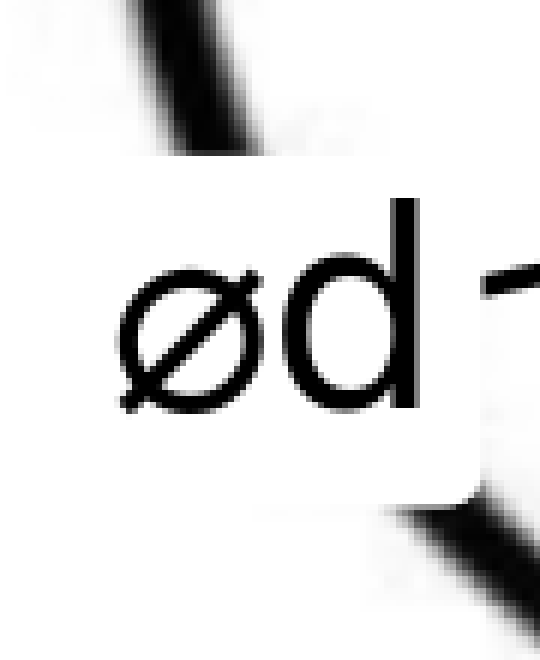
scratch_media/check_label_pixels.png
