DamirNine/prikmeh/scratch_media/check_label_pixels_fixed.png

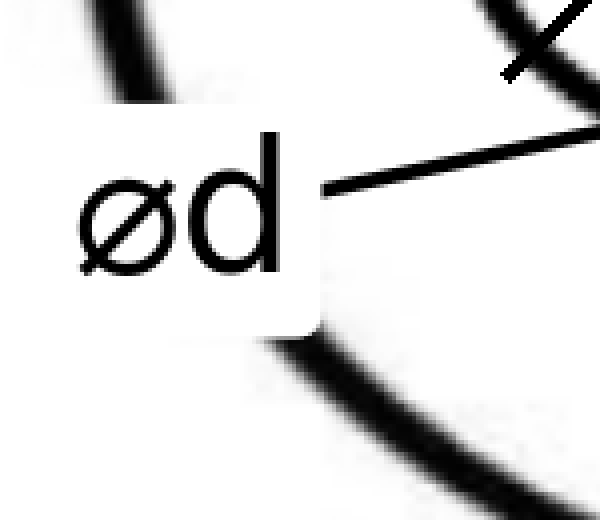
scratch_media/check_label_pixels_fixed.png
