DamirNine/prikmeh/scratch_media/check_lines_isolated2.png

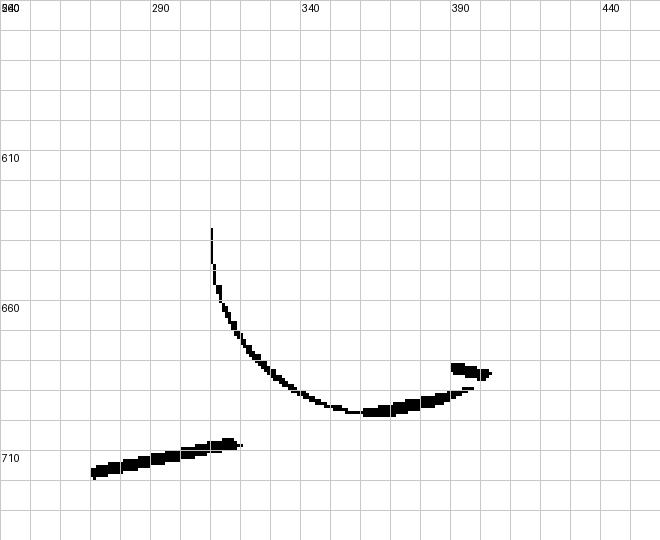
scratch_media/check_lines_isolated2.png
