DamirNine/prikmeh/scratch_media/check_lines_isolated3.png

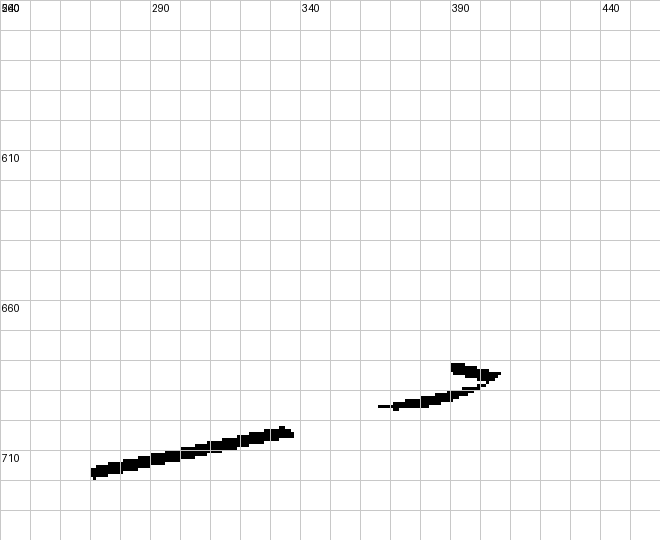
scratch_media/check_lines_isolated3.png
