DamirNine/prikmeh/scratch_media/check_lines_isolated.png

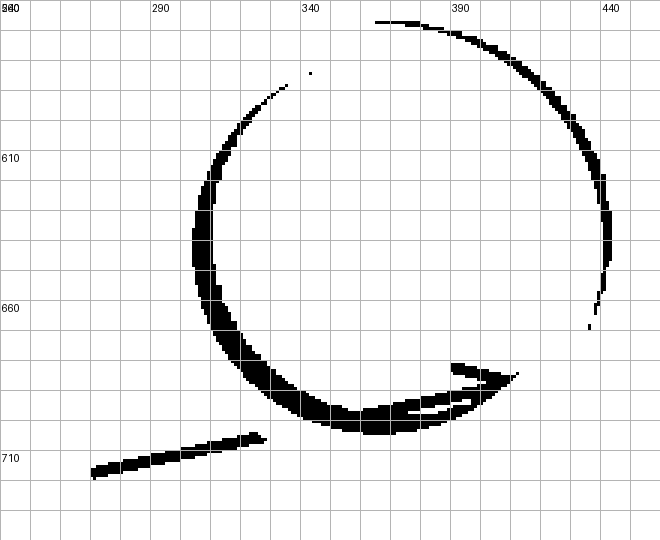
scratch_media/check_lines_isolated.png
