DamirNine/prikmeh/scratch_media/check_od_final2.png

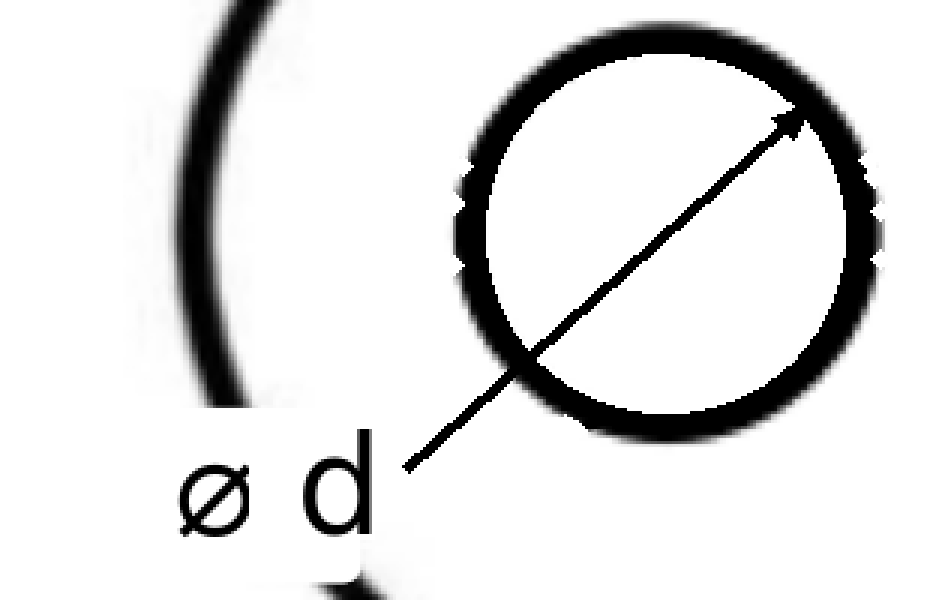
scratch_media/check_od_final2.png
