DamirNine/prikmeh/scratch_media/check_od_full_grid.png

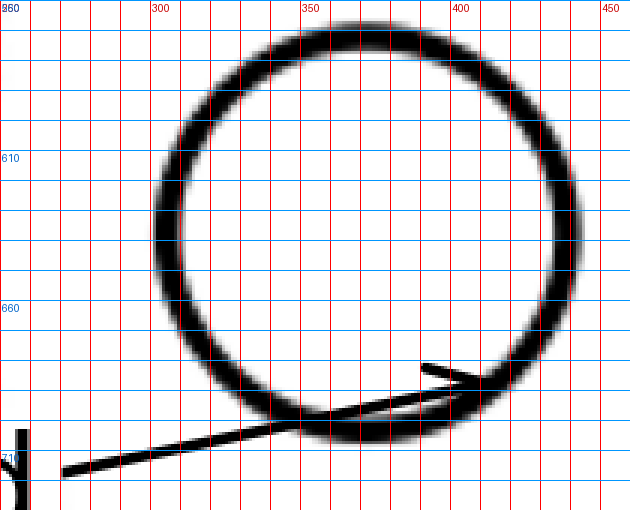
scratch_media/check_od_full_grid.png
