DamirNine/prikmeh/scratch_media/check_od_v2.png

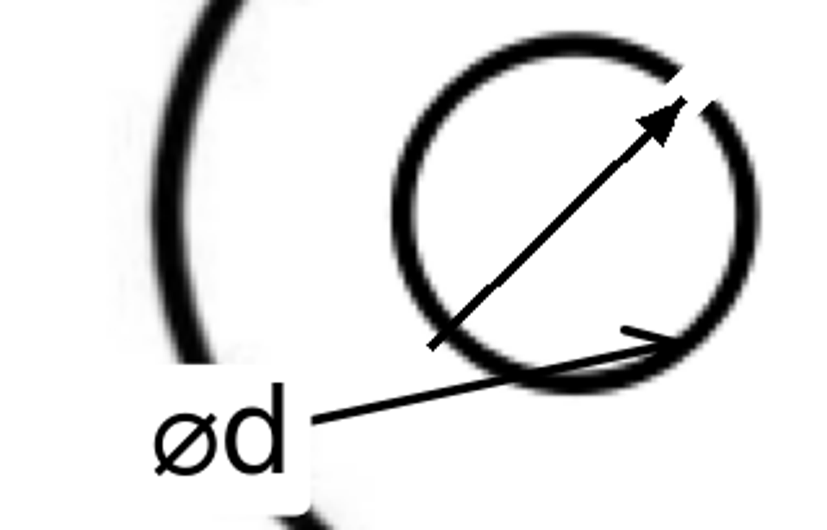
scratch_media/check_od_v2.png
