DamirNine/prikmeh/scratch_media/check_pristine_grid.png

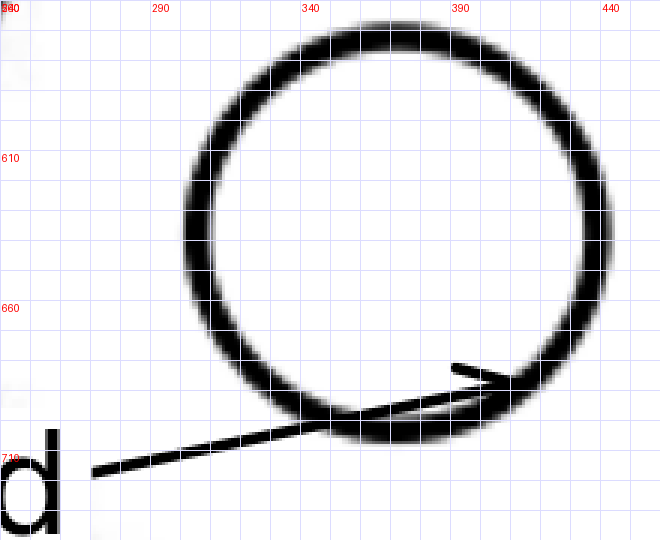
scratch_media/check_pristine_grid.png
