DamirNine/prikmeh/scratch_media/check_radial_od2.png

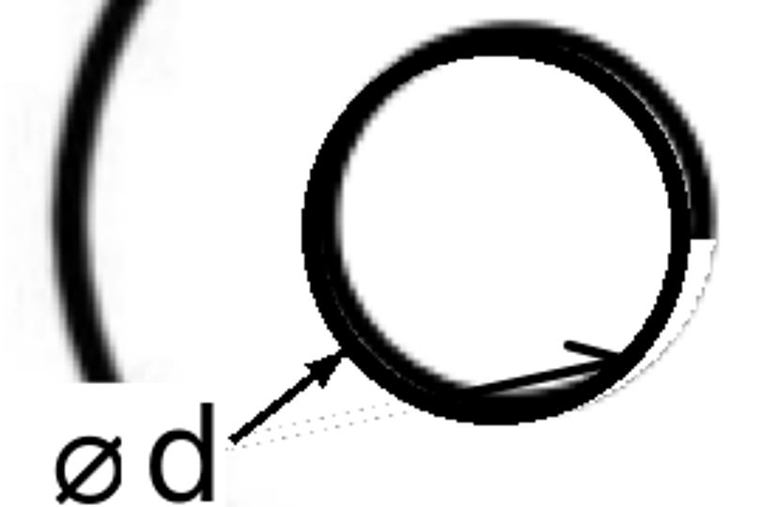
scratch_media/check_radial_od2.png
