DamirNine/prikmeh/scratch_media/check_tip_grid.png

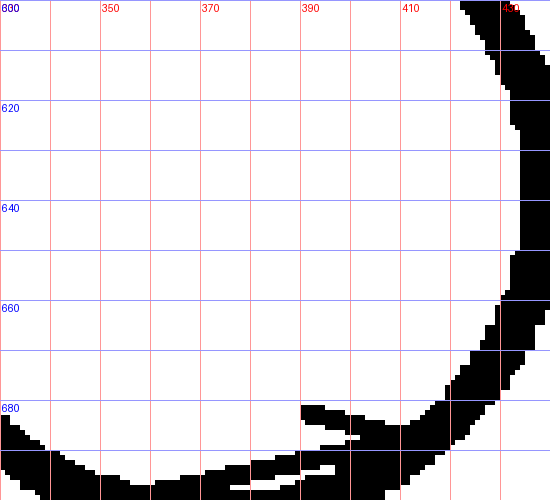
scratch_media/check_tip_grid.png
