DamirNine/prikmeh/scratch_media/crop_bp_nearest.png

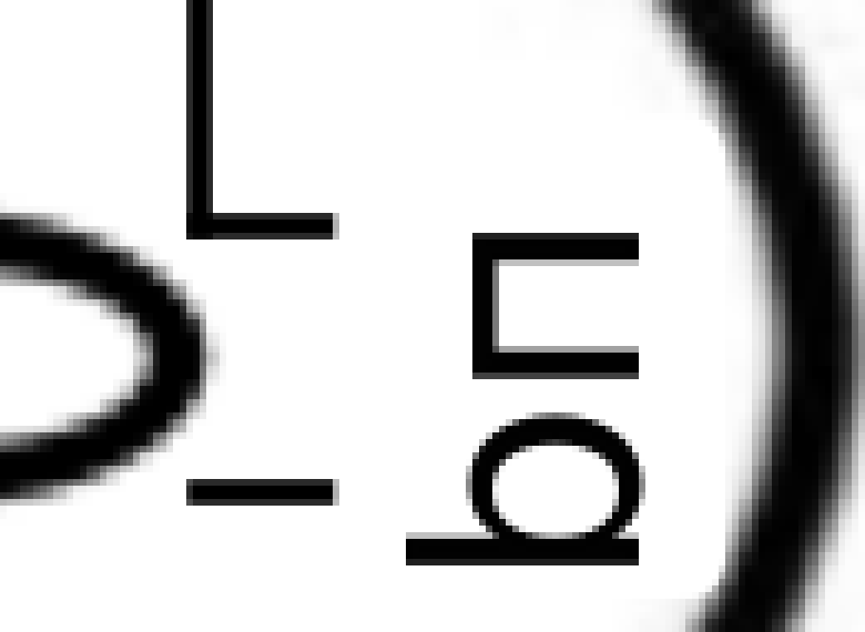
scratch_media/crop_bp_nearest.png
