DamirNine/prikmeh/scratch_media/crop_kamen.png

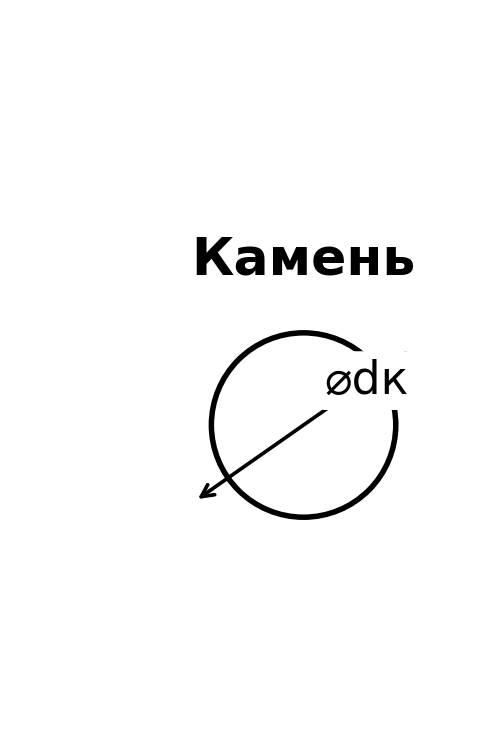
scratch_media/crop_kamen.png
