DamirNine/prikmeh/scratch_media/crop_kulisa.png

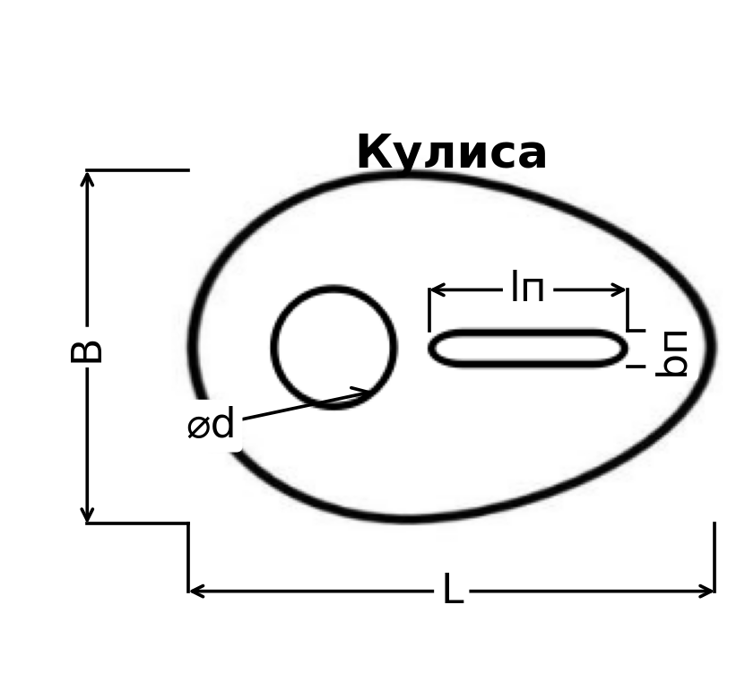
scratch_media/crop_kulisa.png
