DamirNine/prikmeh/scratch_media/crop_slot2.png

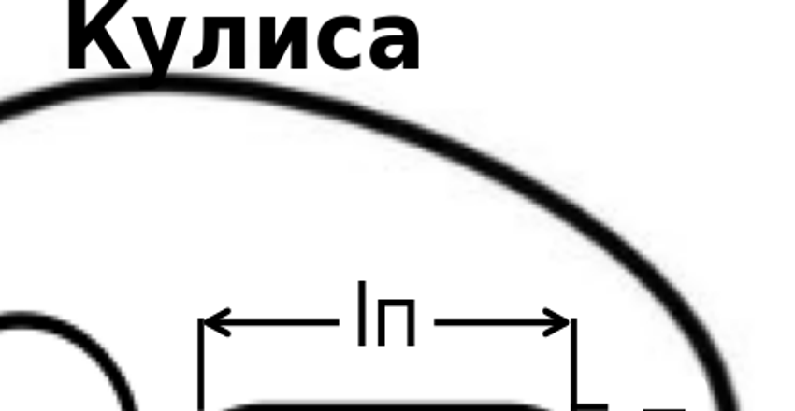
scratch_media/crop_slot2.png
