DamirNine/prikmeh/scratch_media/crop_slot3.png

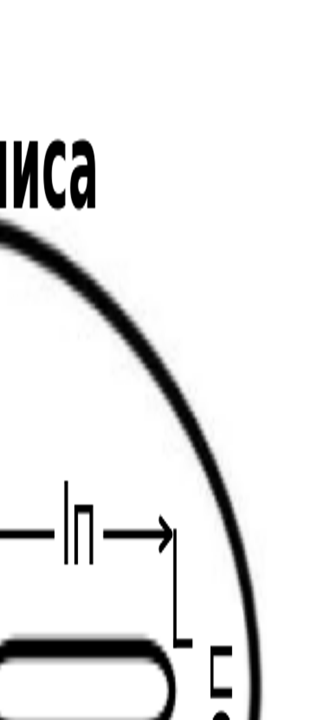
scratch_media/crop_slot3.png
