DamirNine/prikmeh/scratch_media/crop_slot4.png

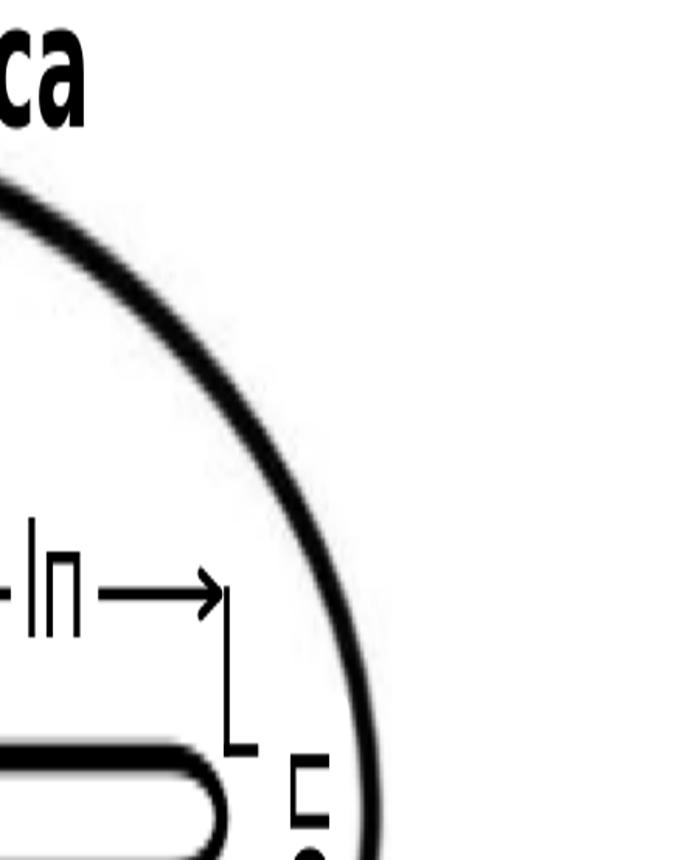
scratch_media/crop_slot4.png
