DamirNine/prikmeh/scratch_media/crop_slot.png

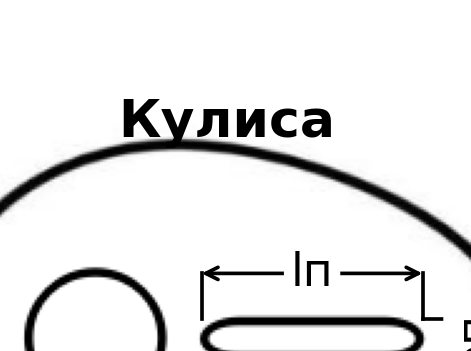
scratch_media/crop_slot.png
