DamirNine/prikmeh/scratch_media/crop_slot_grid.png

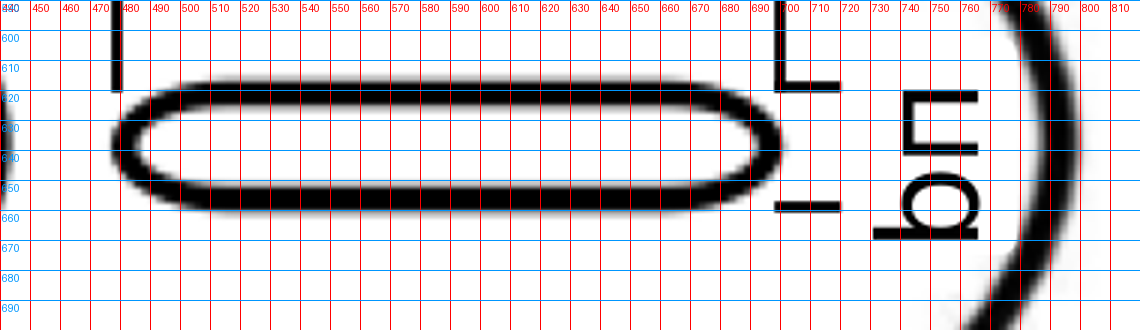
scratch_media/crop_slot_grid.png
