DamirNine/prikmeh/scratch_media/image1.png

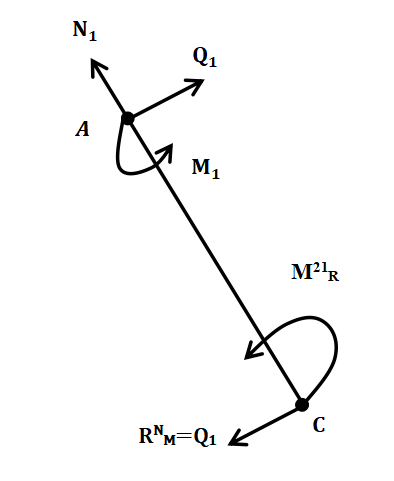
scratch_media/image1.png
