DamirNine/prikmeh/scratch_media/image2.png

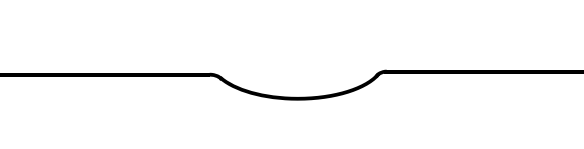
scratch_media/image2.png
