DamirNine/prikmeh/scratch_media/image3.png

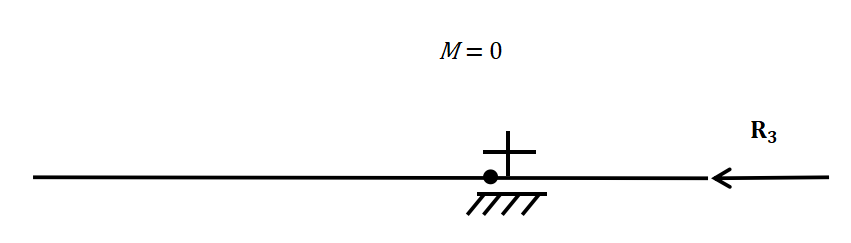
scratch_media/image3.png
