DamirNine/prikmeh/scratch_media/image4.png

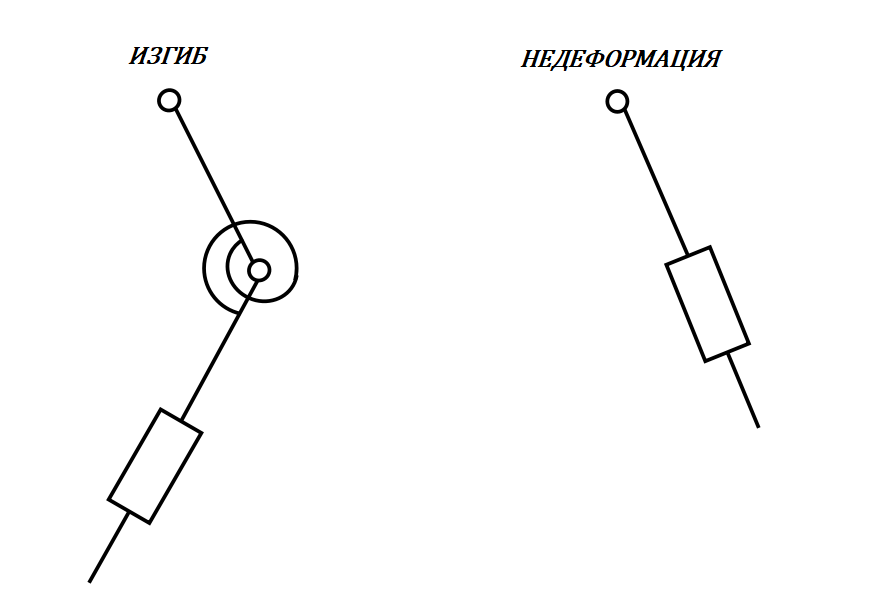
scratch_media/image4.png
