DamirNine/prikmeh/scratch_media/image7.png

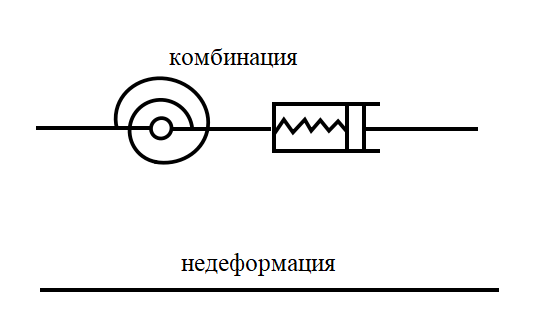
scratch_media/image7.png
