DamirNine/prikmeh/scratch_media/image8.png

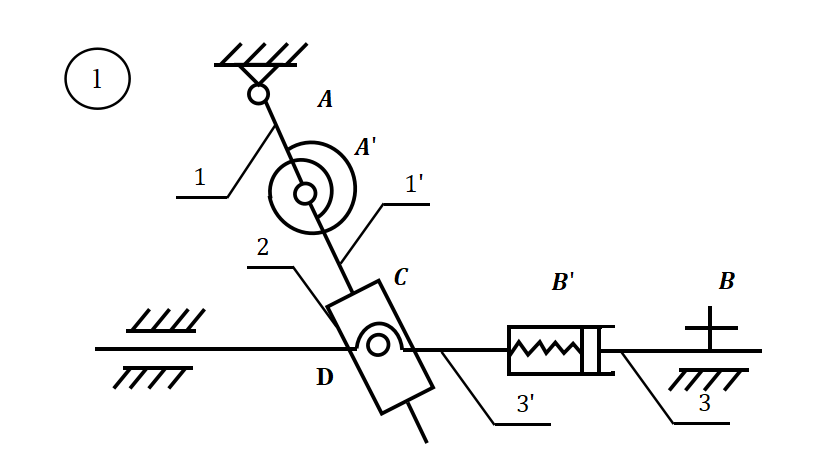
scratch_media/image8.png
