DamirNine/prikmeh/scratch_media/image9.png

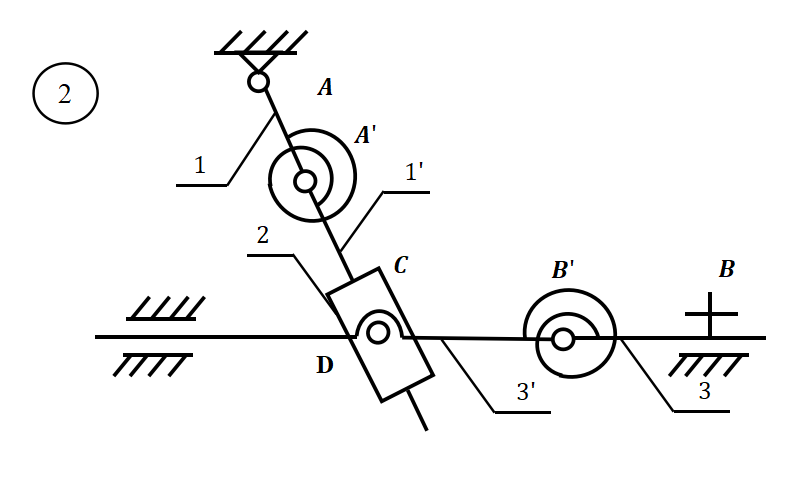
scratch_media/image9.png
