DamirNine/prikmeh/scratch_media/image10.png

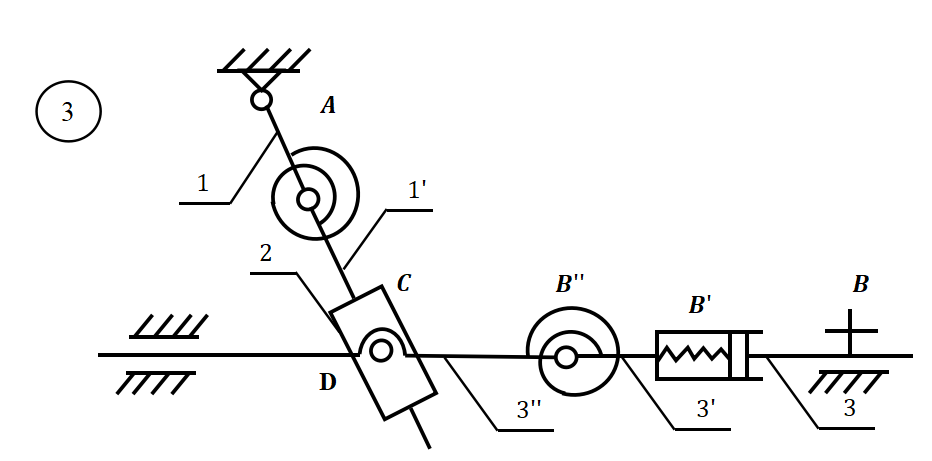
scratch_media/image10.png
