DamirNine/prikmeh/scratch_media/image11.png

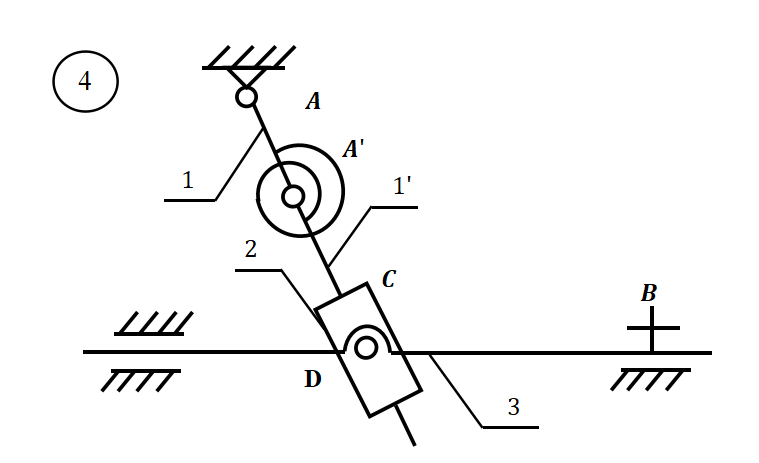
scratch_media/image11.png
