DamirNine/prikmeh/scratch_media/image12.png

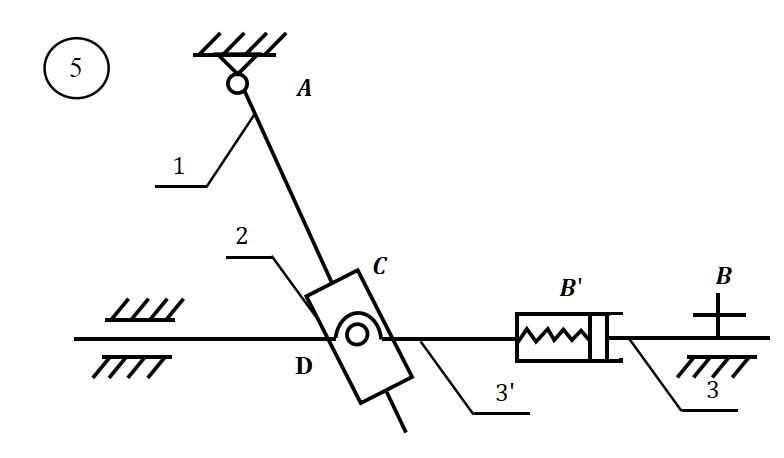
scratch_media/image12.png
