DamirNine/prikmeh/scratch_media/image13.png

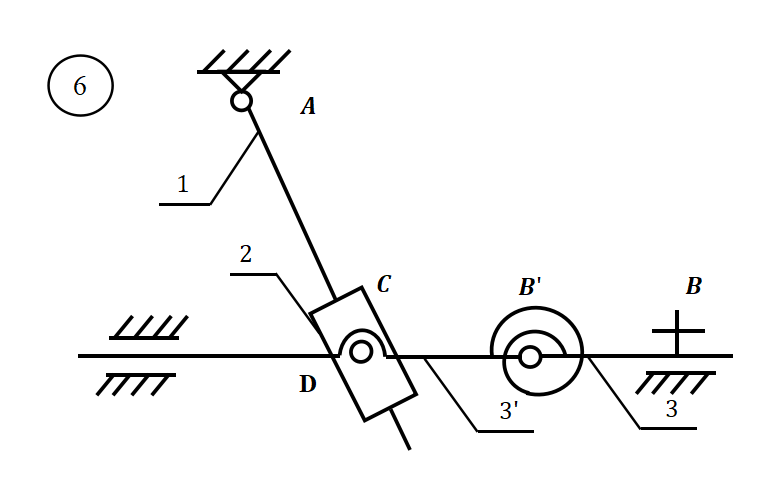
scratch_media/image13.png
