DamirNine/prikmeh/scratch_media/image14.png

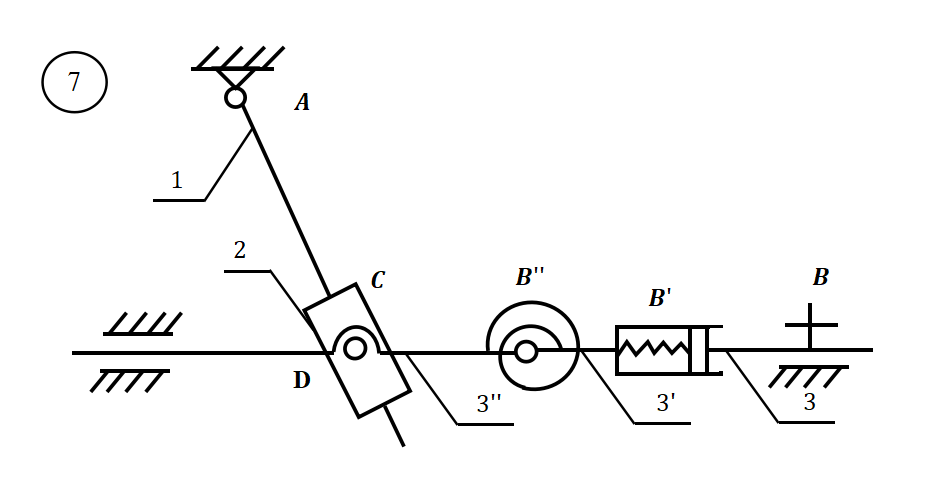
scratch_media/image14.png
