DamirNine/prikmeh/scratch_media/image15.png

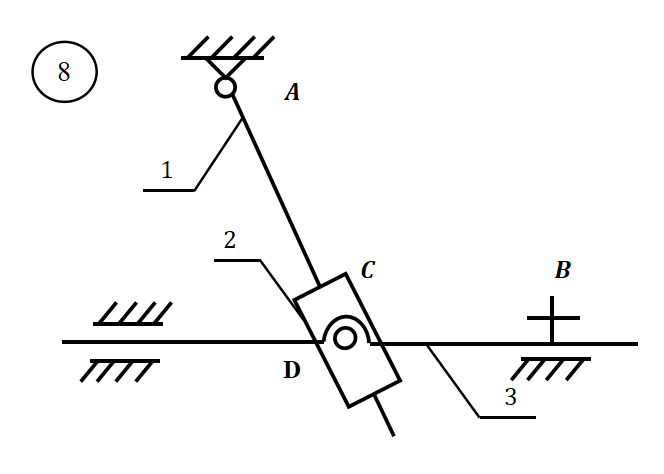
scratch_media/image15.png
