DamirNine/prikmeh/scratch_media/image16.png

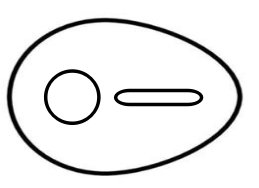
scratch_media/image16.png
