DamirNine/prikmeh/scratch_media/image17.png

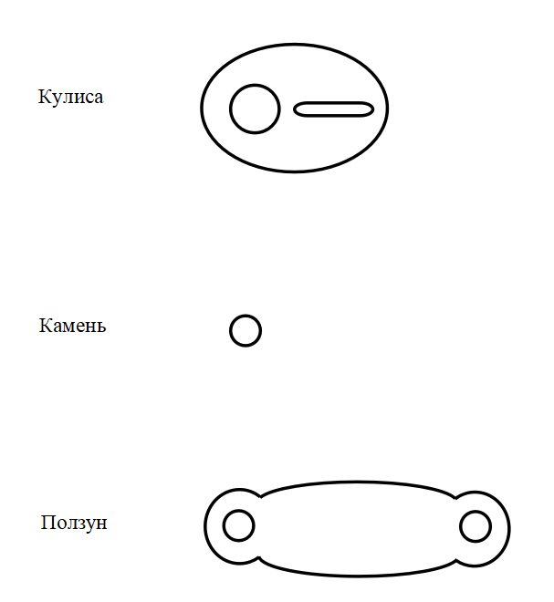
scratch_media/image17.png
