DamirNine/prikmeh/scratch_media/line_only_vis.png

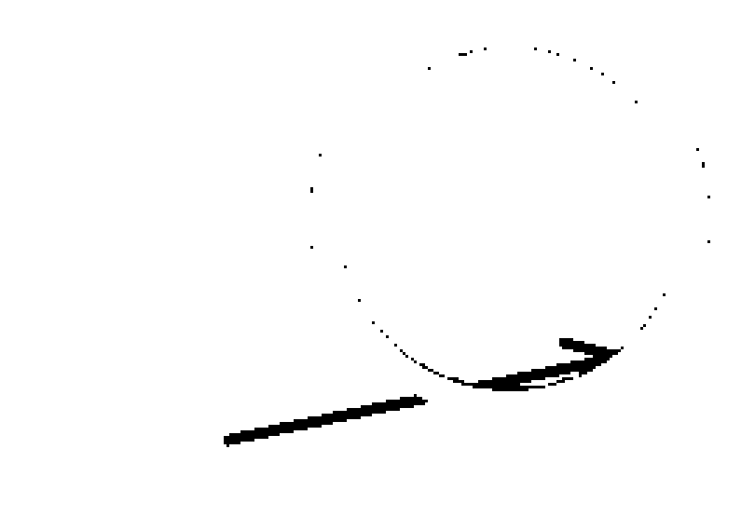
scratch_media/line_only_vis.png
