DamirNine/prikmeh/курсовой/2026-09-21/general_view.png

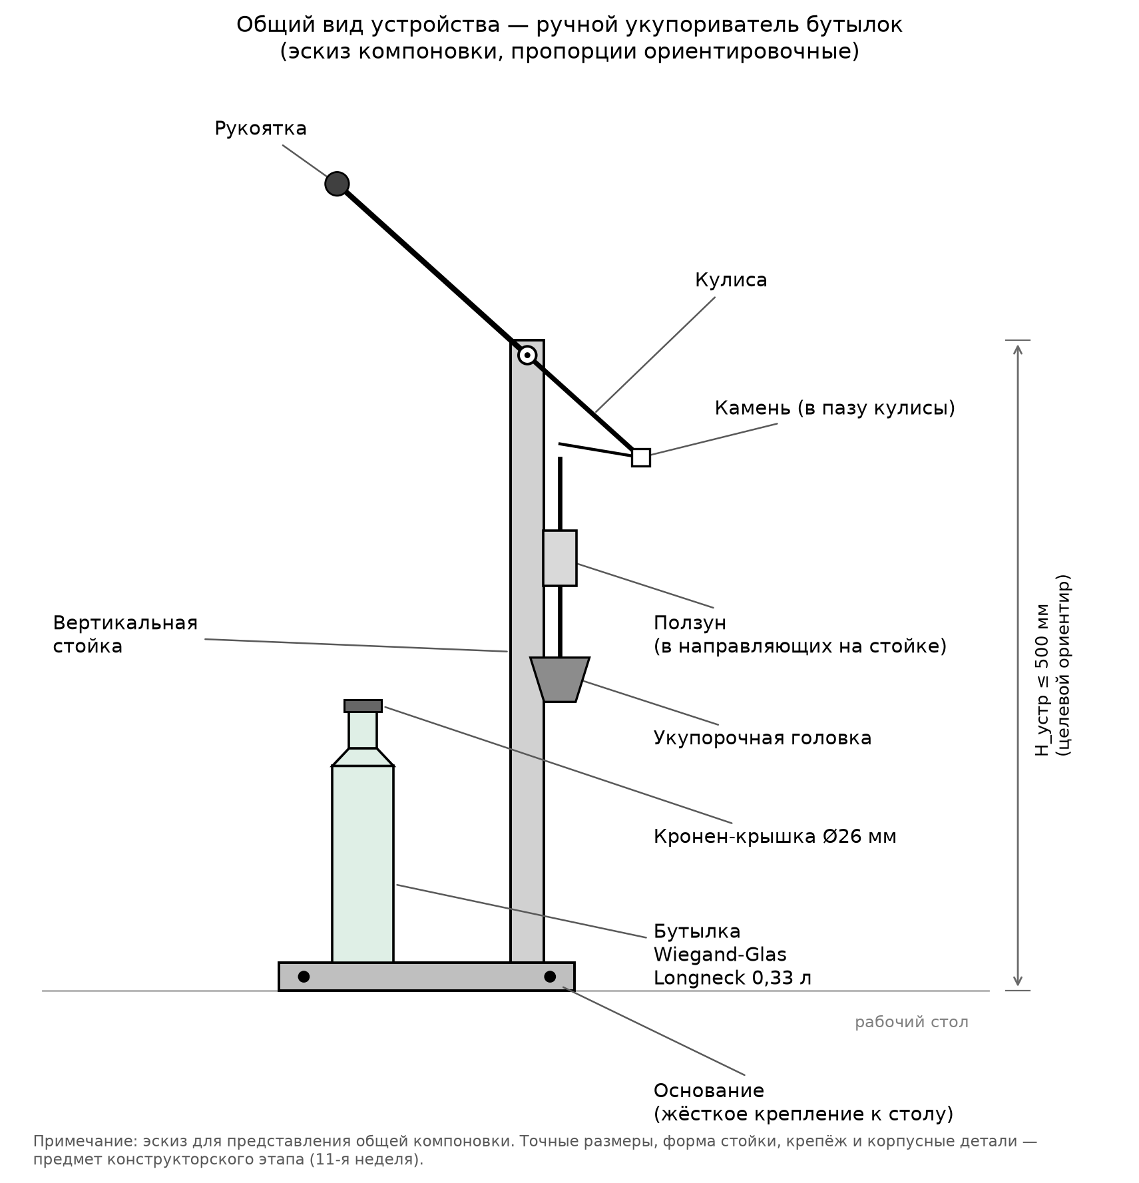
курсовой/2026-09-21/general_view.png
