DamirNine/prikmeh/курсовой/2026-09-21/kinematic_scheme.png

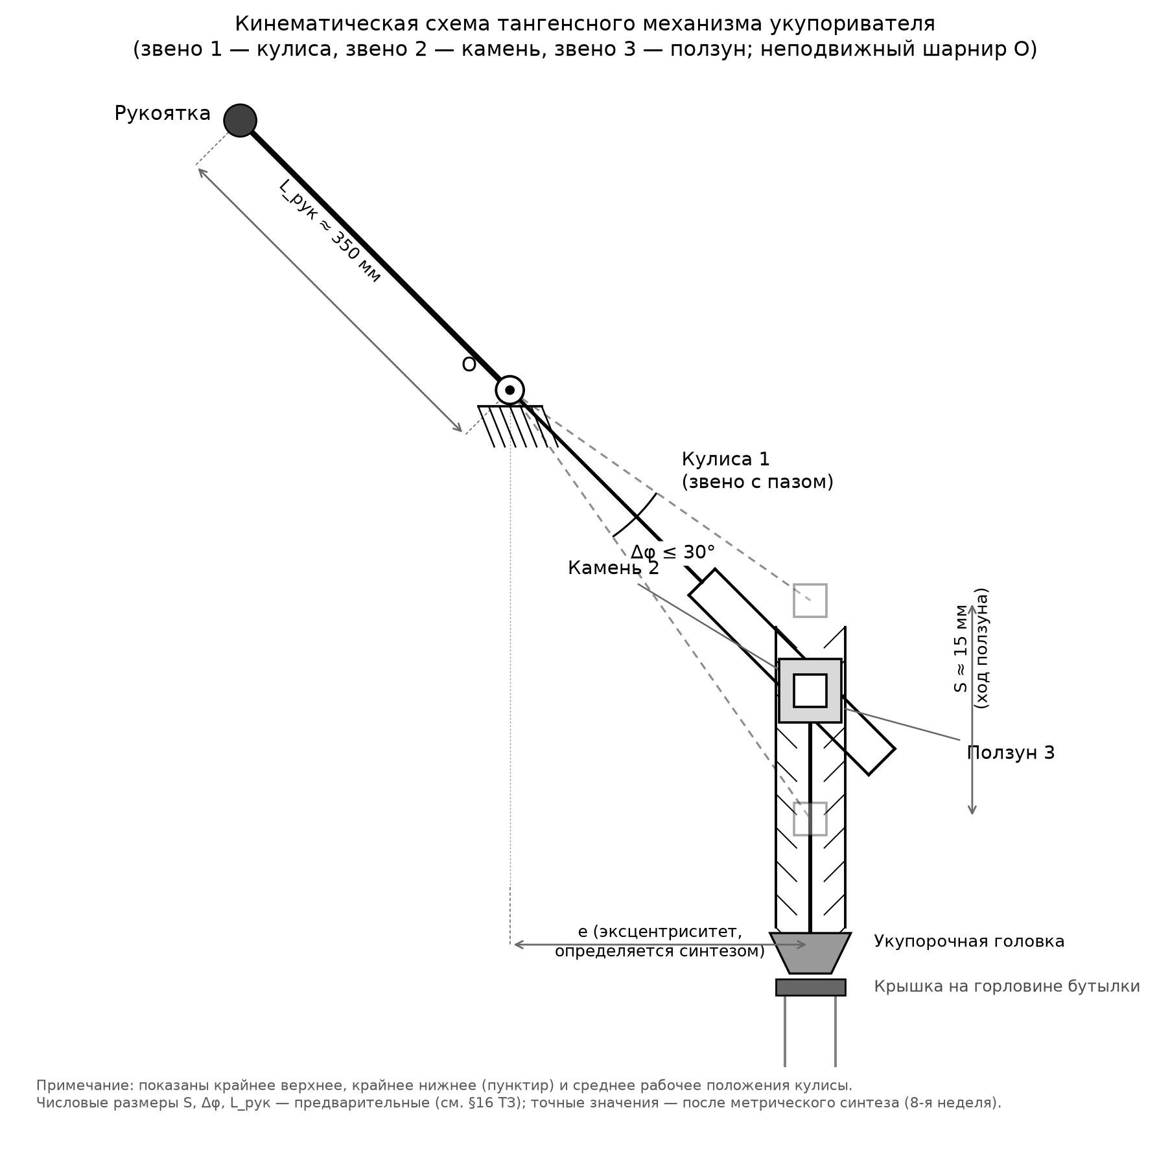
курсовой/2026-09-21/kinematic_scheme.png
