DamirNine/prikmeh/курсовой/2026-09-25/shema_mehanizma_zadanie.png

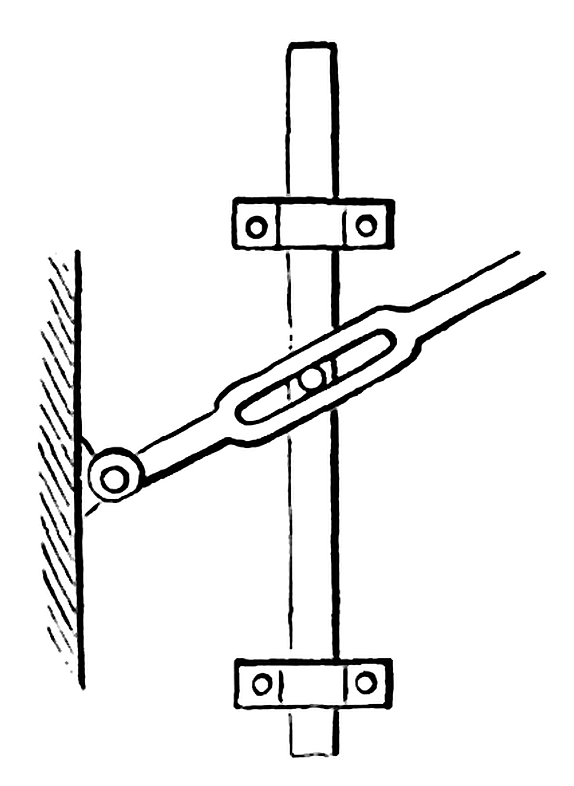
курсовой/2026-09-25/shema_mehanizma_zadanie.png
