DamirNine/prikmeh/курсовой/2026-09-27/raschetnaya_shema_tangensnyi.png

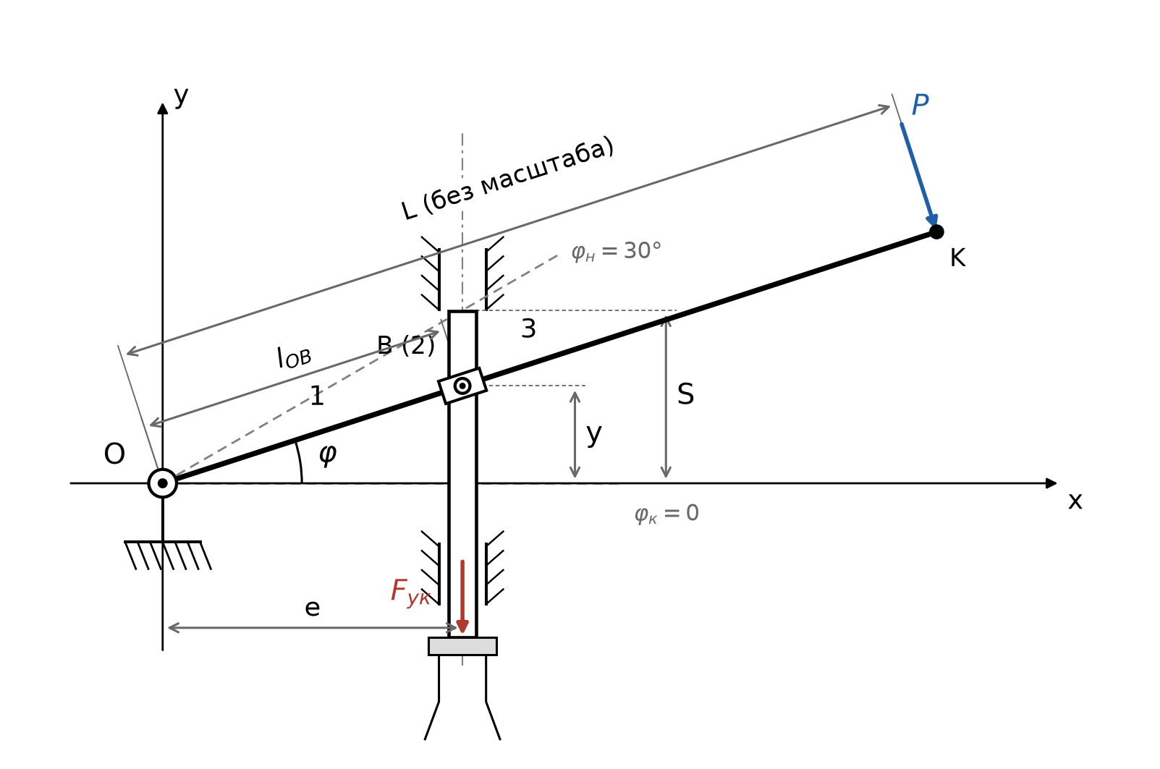
курсовой/2026-09-27/raschetnaya_shema_tangensnyi.png
