DamirNine/prikmeh/курсовой/2026-10-03/fig_frontier.png

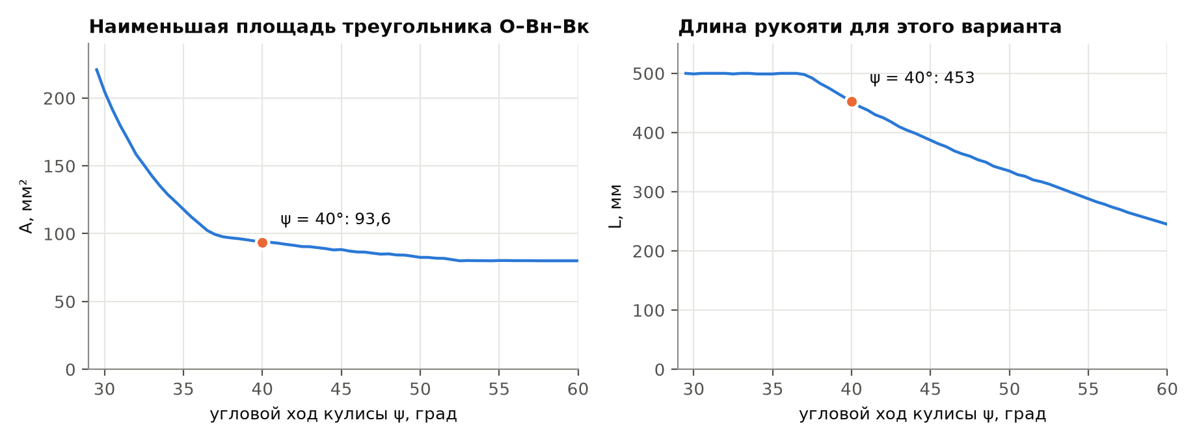
курсовой/2026-10-03/fig_frontier.png
