DamirNine/prikmeh/курсовой/2026-10-03/fig_omega.png

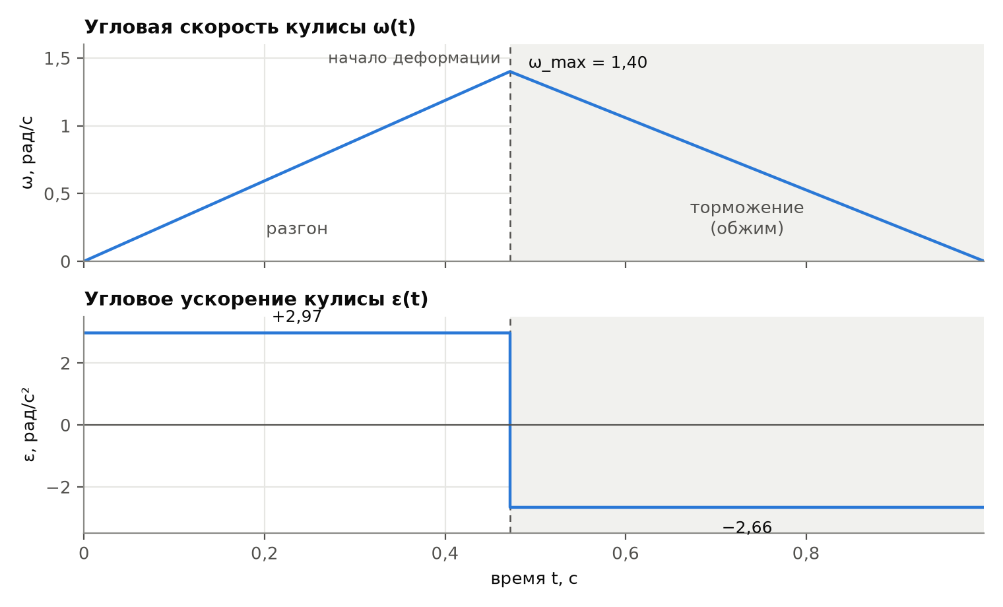
курсовой/2026-10-03/fig_omega.png
