DamirNine/prikmeh/курсовой/2026-10-03/fig_slider.png

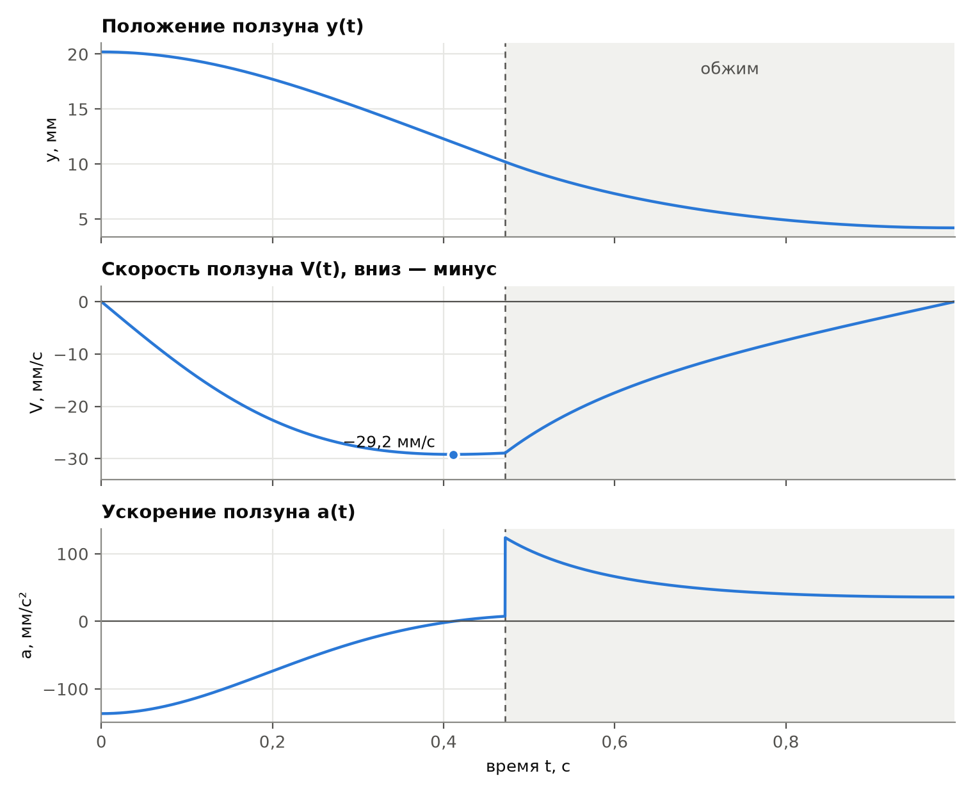
курсовой/2026-10-03/fig_slider.png
