DamirNine/prikmeh/курсовой/2026-10-09/fig_area_3d.png

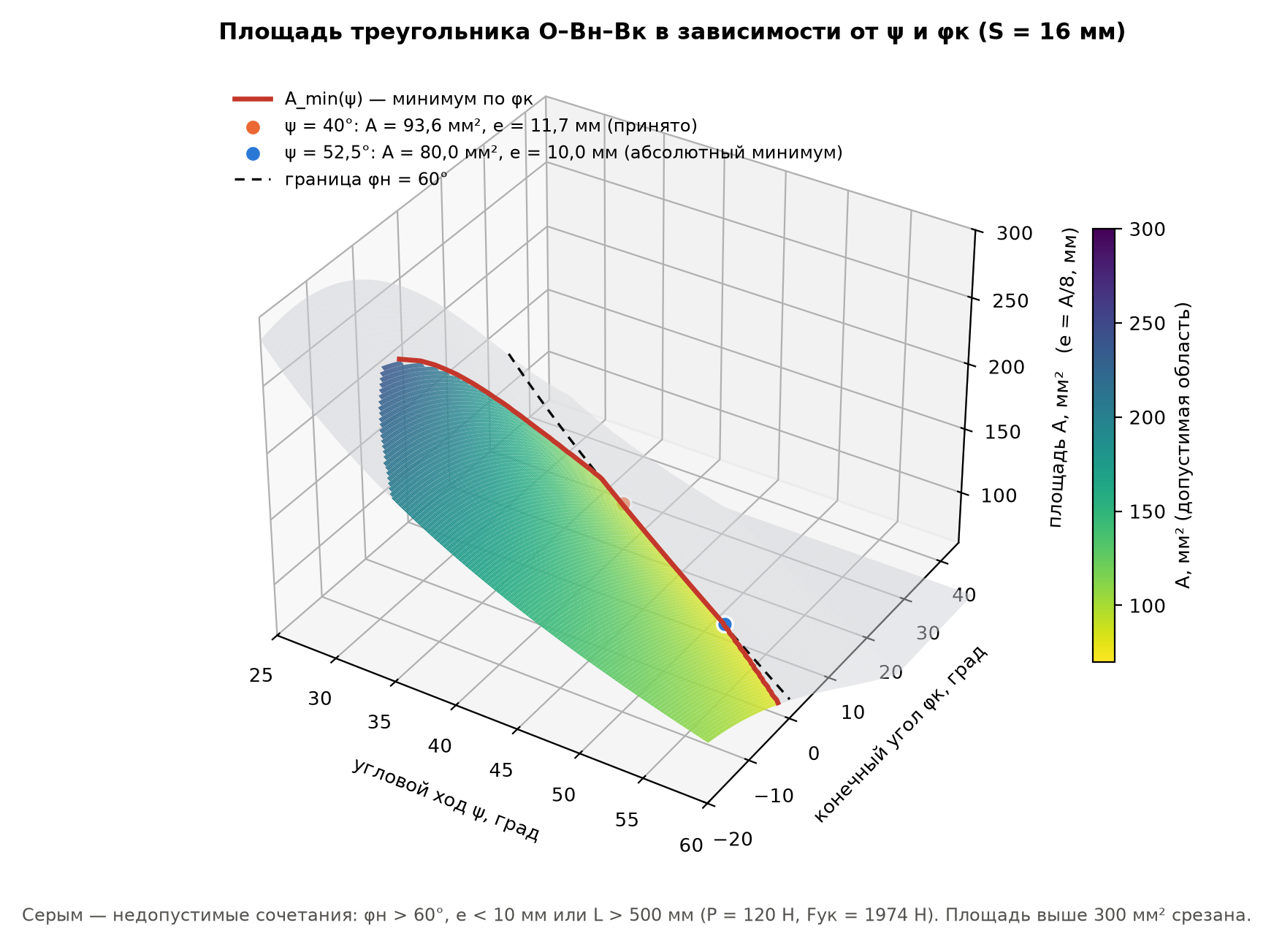
курсовой/2026-10-09/fig_area_3d.png
