DamirNine/prikmeh/курсовой/2026-10-10/fig3_amin_psi_v6.png

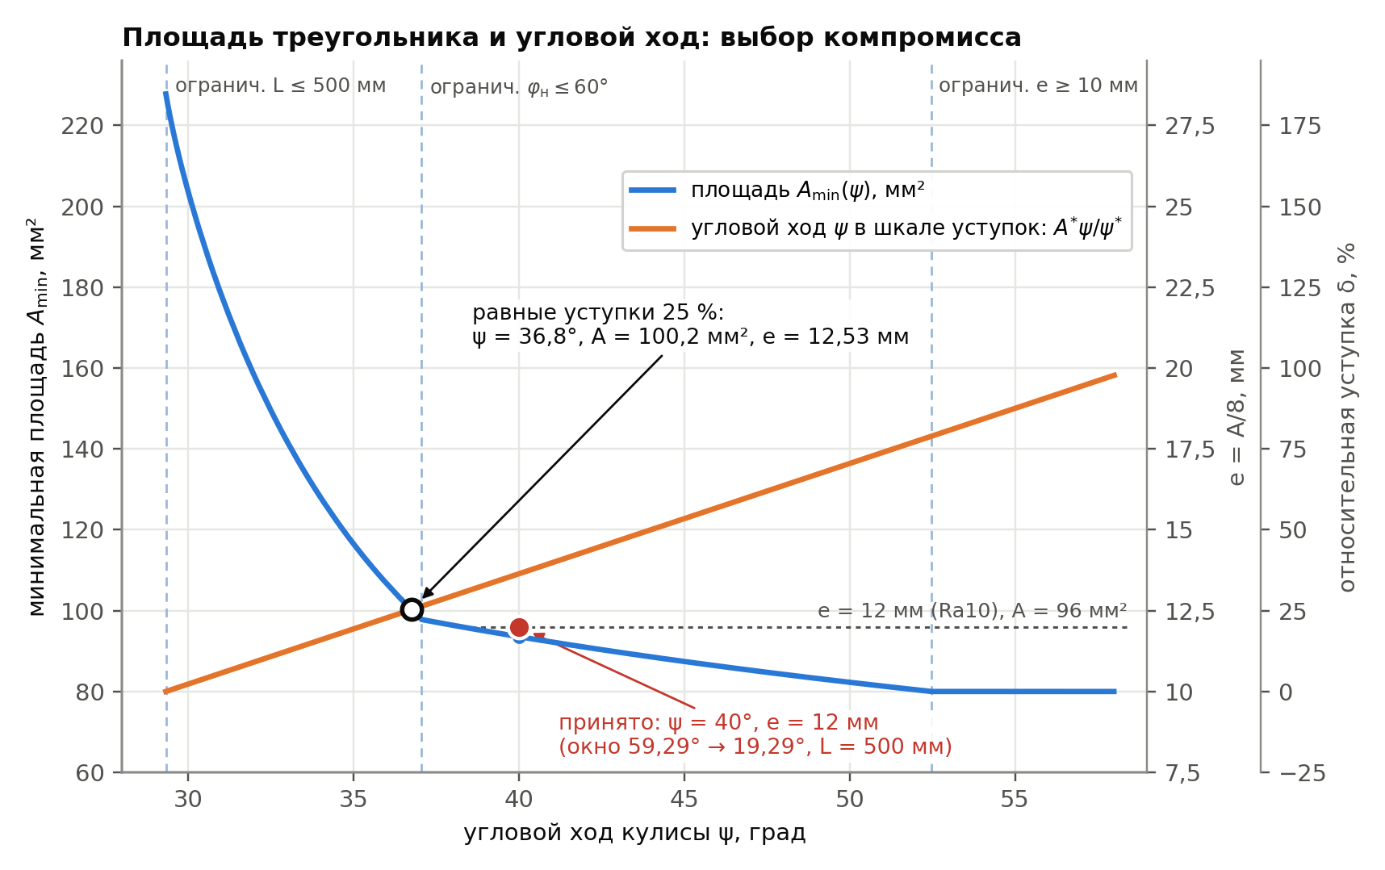
курсовой/2026-10-10/fig3_amin_psi_v6.png
