DamirNine/prikmeh/курсовой/2026-10-10/fig7_fbd_v6.png

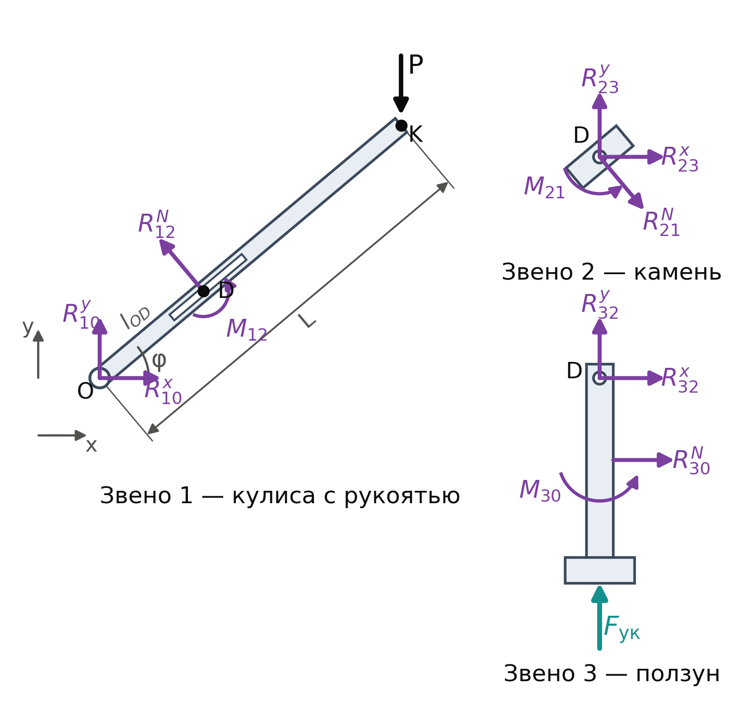
курсовой/2026-10-10/fig7_fbd_v6.png
