DamirNine/prikmeh/курсовой/2026-10-10/fig8_forces_v6.png

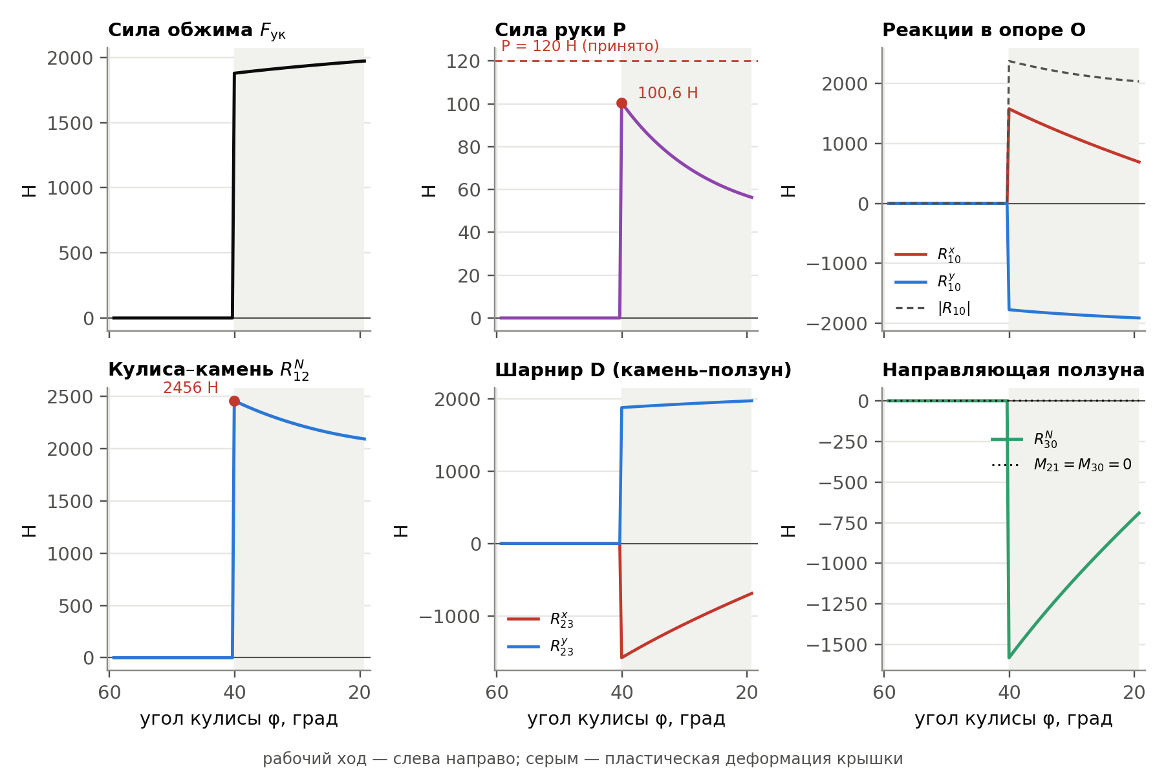
курсовой/2026-10-10/fig8_forces_v6.png
