DamirNine/prikmeh/курсовой/2026-10-10/исходные/foto_grafik_Amin.jpg

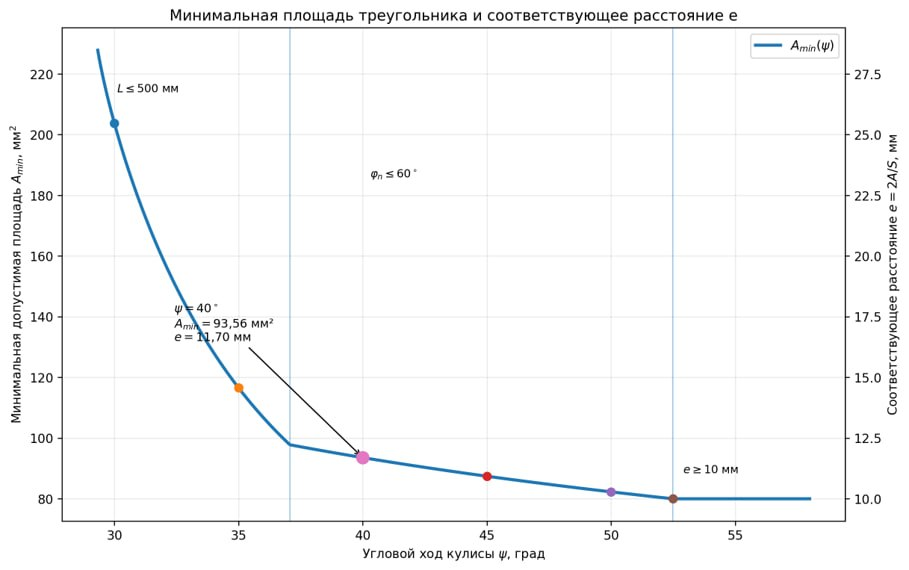
курсовой/2026-10-10/исходные/foto_grafik_Amin.jpg
