DamirNine/prikmeh/курсовой/2026-10-10/исходные/listik_silovoi_raschet.jpg

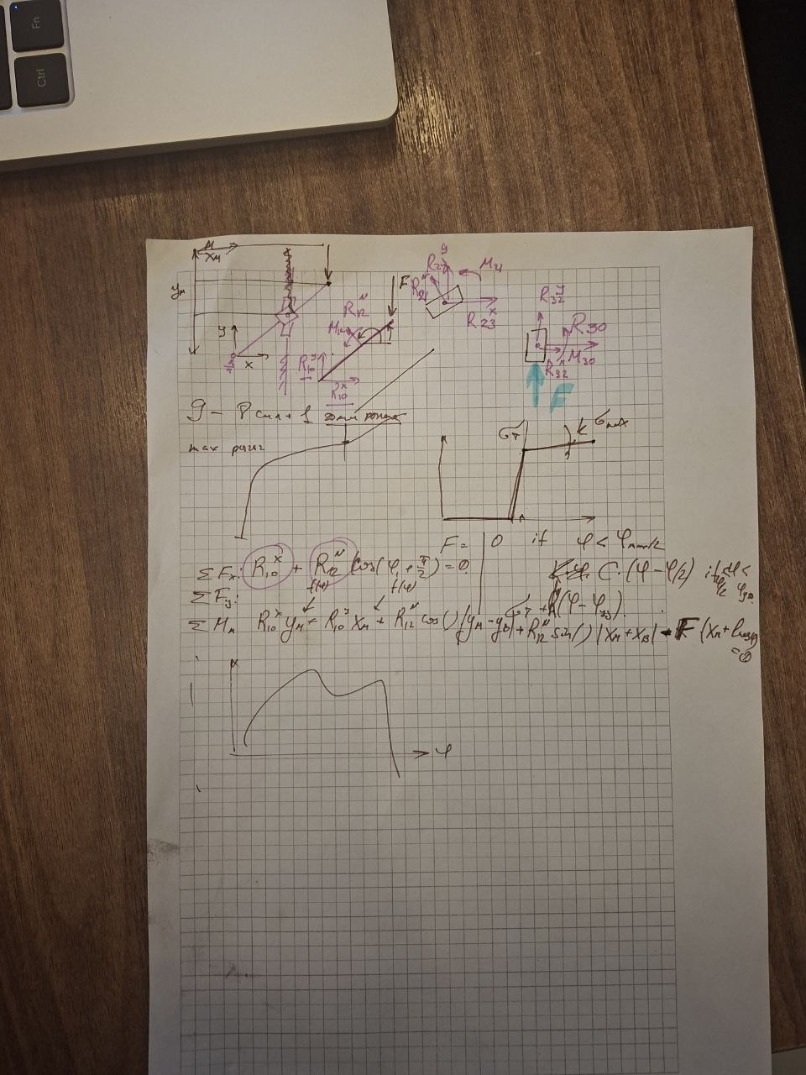
курсовой/2026-10-10/исходные/listik_silovoi_raschet.jpg
