DamirNine/prikmeh/курсовой/2026-10-11/fig10_epury_phiy_v10.png

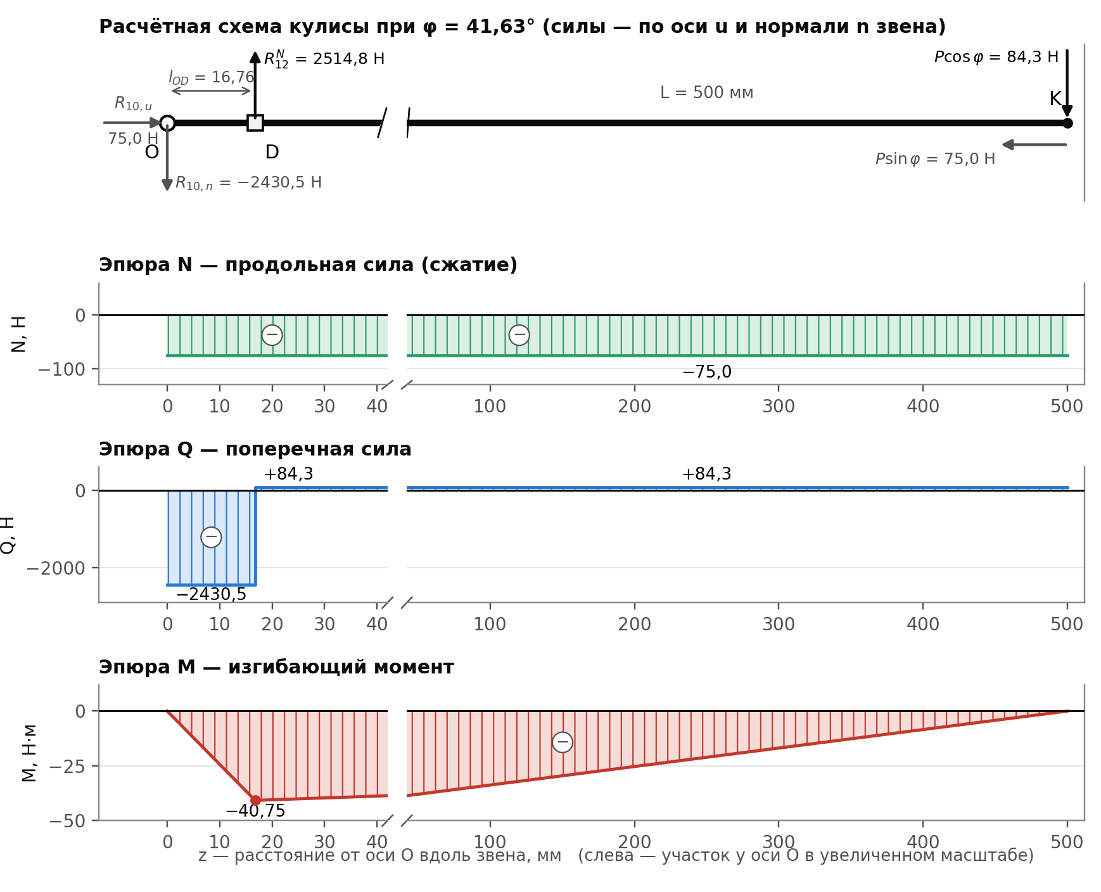
курсовой/2026-10-11/fig10_epury_phiy_v10.png
