DamirNine/prikmeh/курсовой/2026-10-11/fig11_epury_phik_v10.png

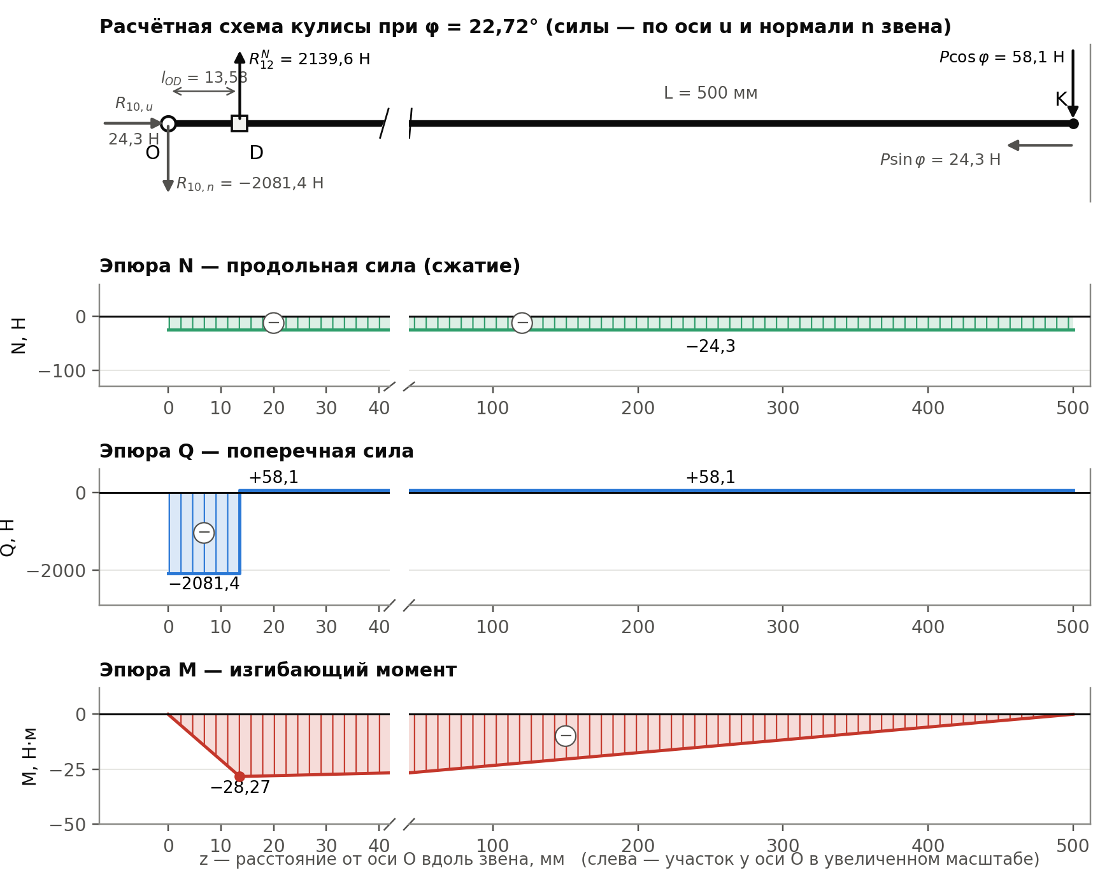
курсовой/2026-10-11/fig11_epury_phik_v10.png
