DamirNine/prikmeh/курсовой/2026-10-11/fig12_node_O_v10.png

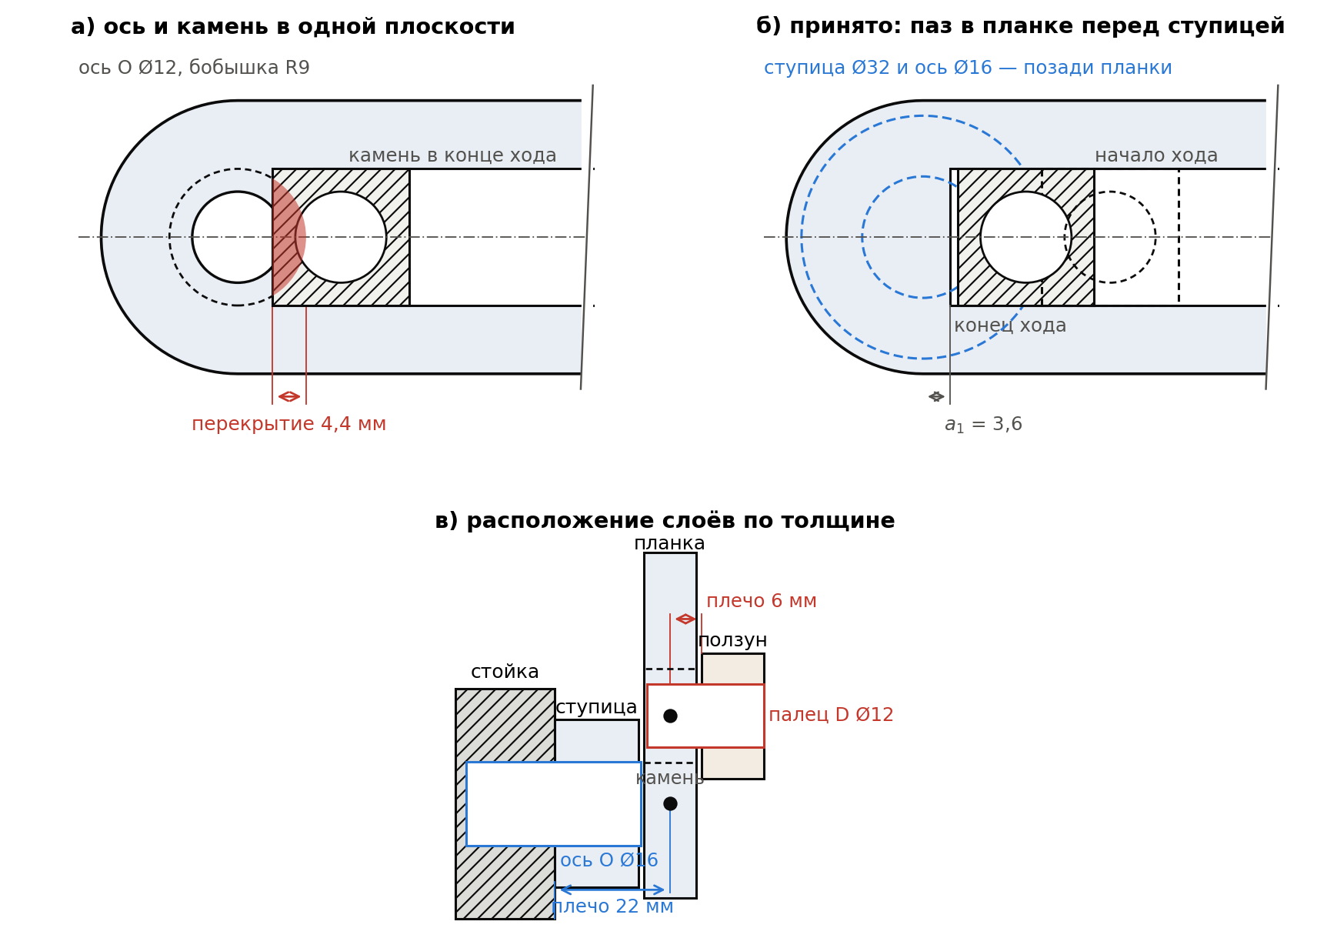
курсовой/2026-10-11/fig12_node_O_v10.png
