DamirNine/prikmeh/курсовой/2026-10-11/fig13_kulisa_v10.png

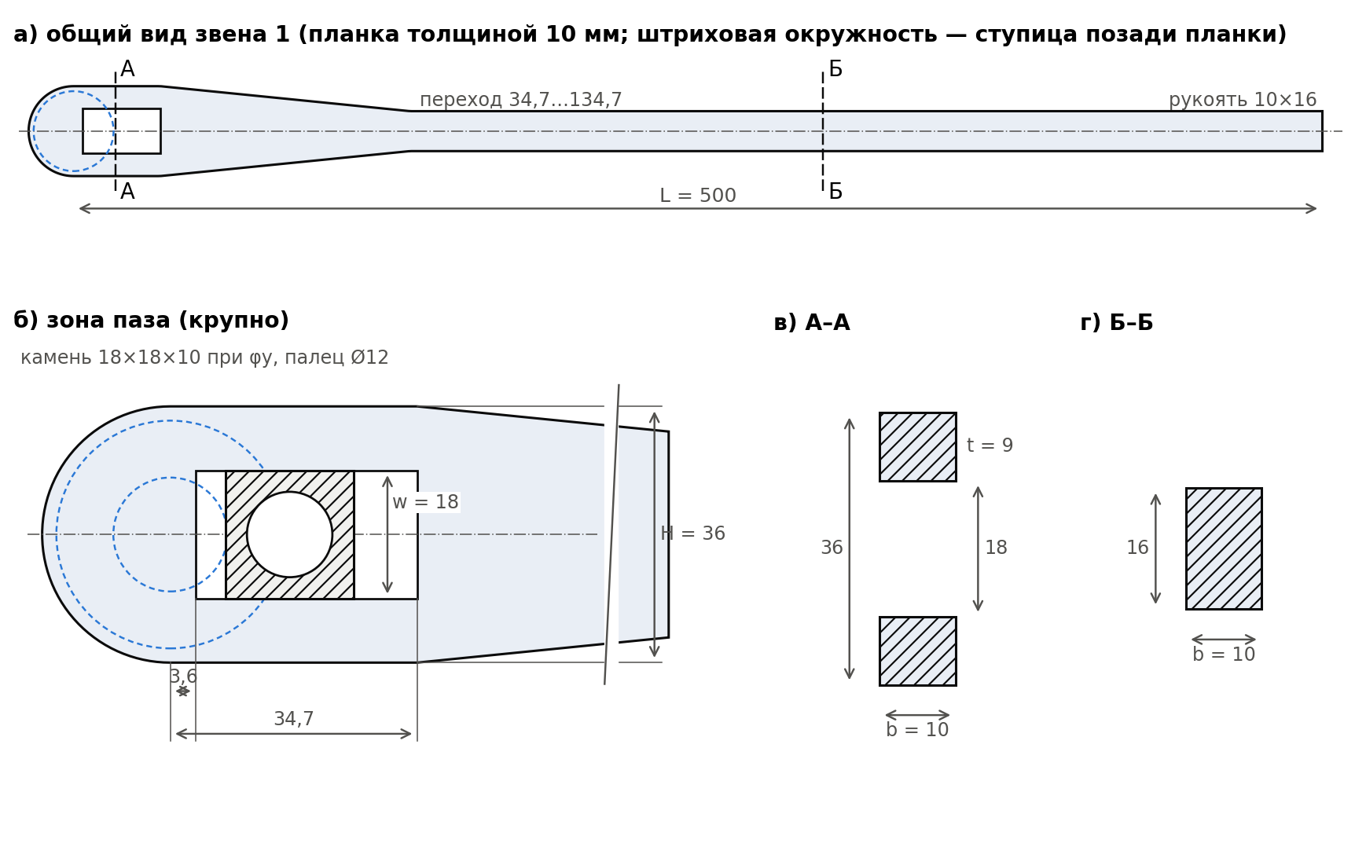
курсовой/2026-10-11/fig13_kulisa_v10.png
