DamirNine/prikmeh/курсовой/2026-10-11/fig14_handle_h_v10.png

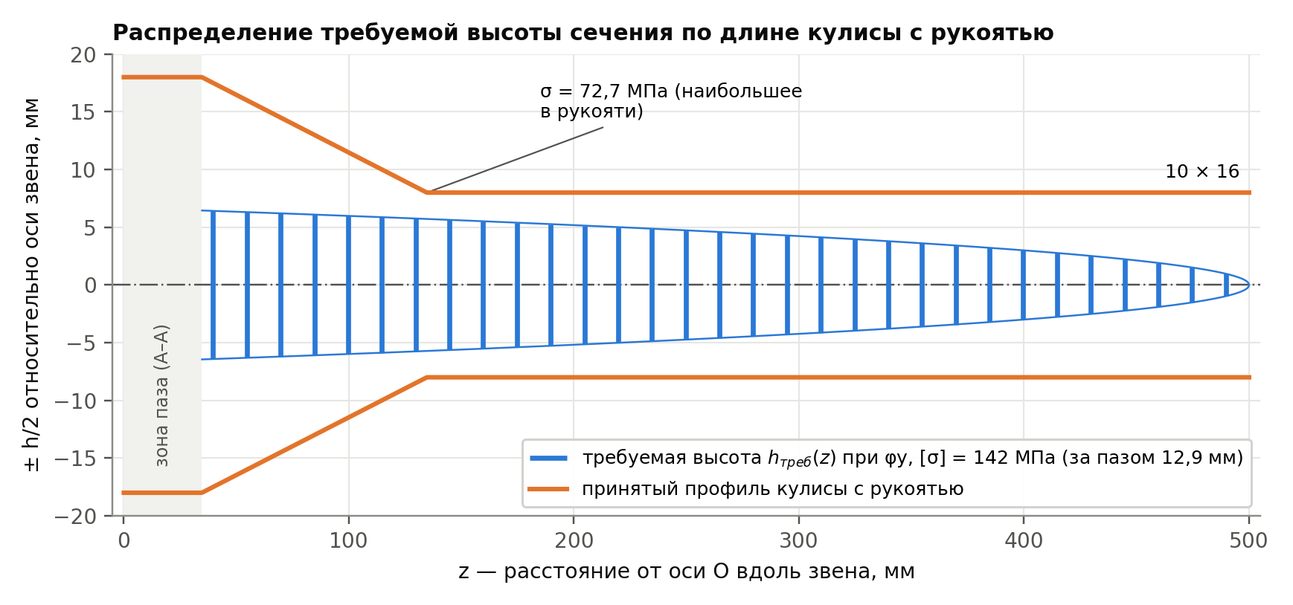
курсовой/2026-10-11/fig14_handle_h_v10.png
