DamirNine/prikmeh/курсовой/2026-10-11/fig_area_3d_v9.png

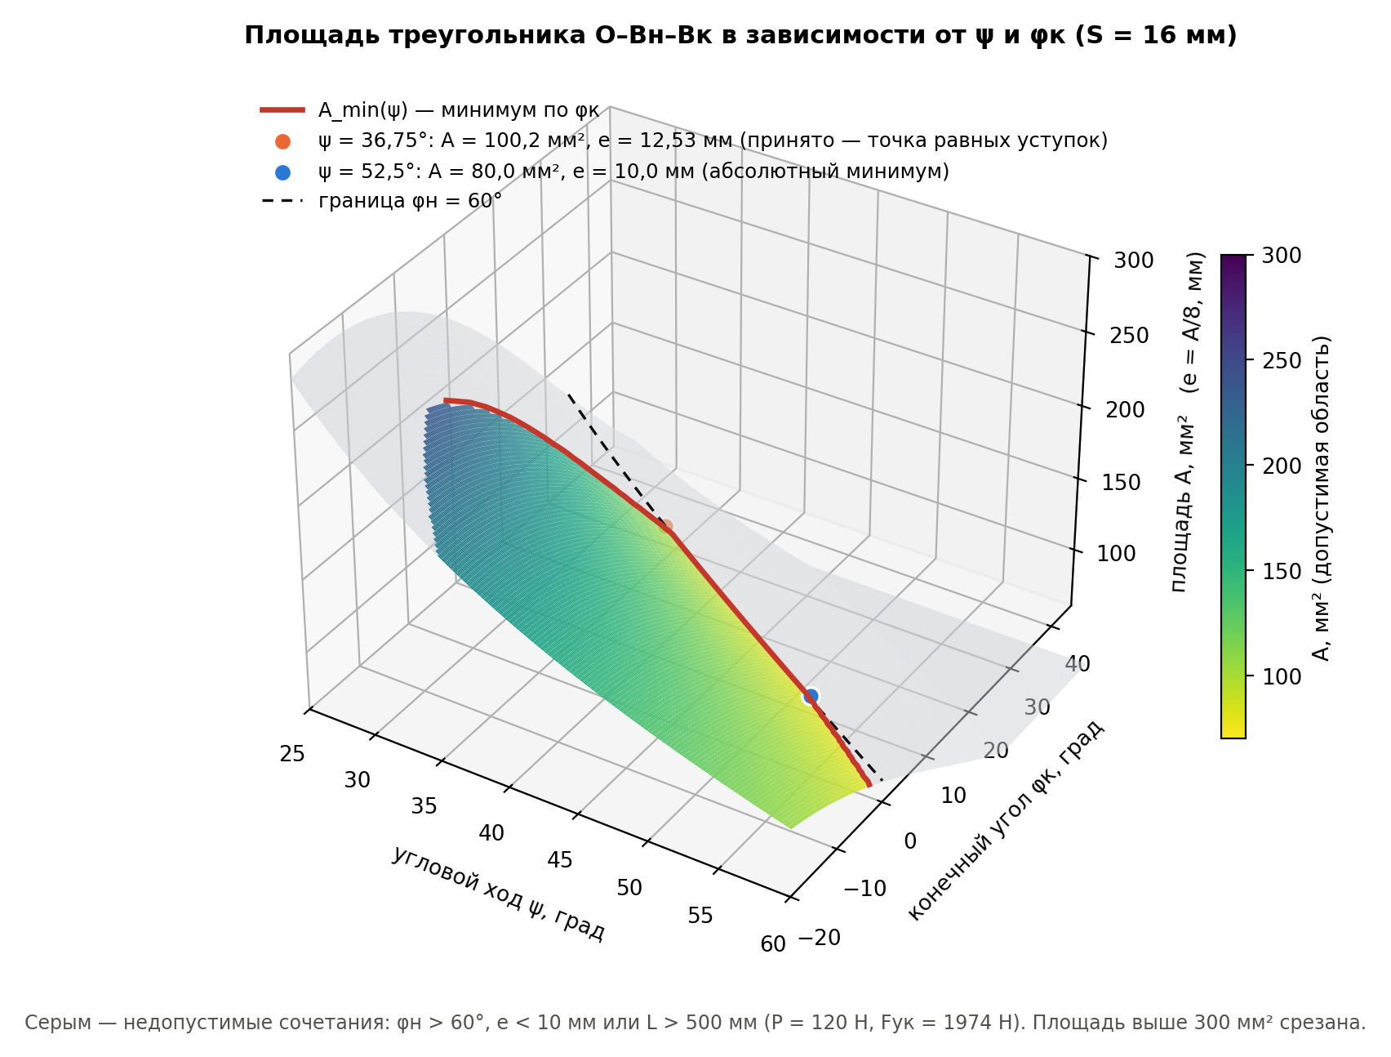
курсовой/2026-10-11/fig_area_3d_v9.png
