DamirNine/prikmeh/курсовой/2026-10-19/fig10_epury_phiy_v11.png

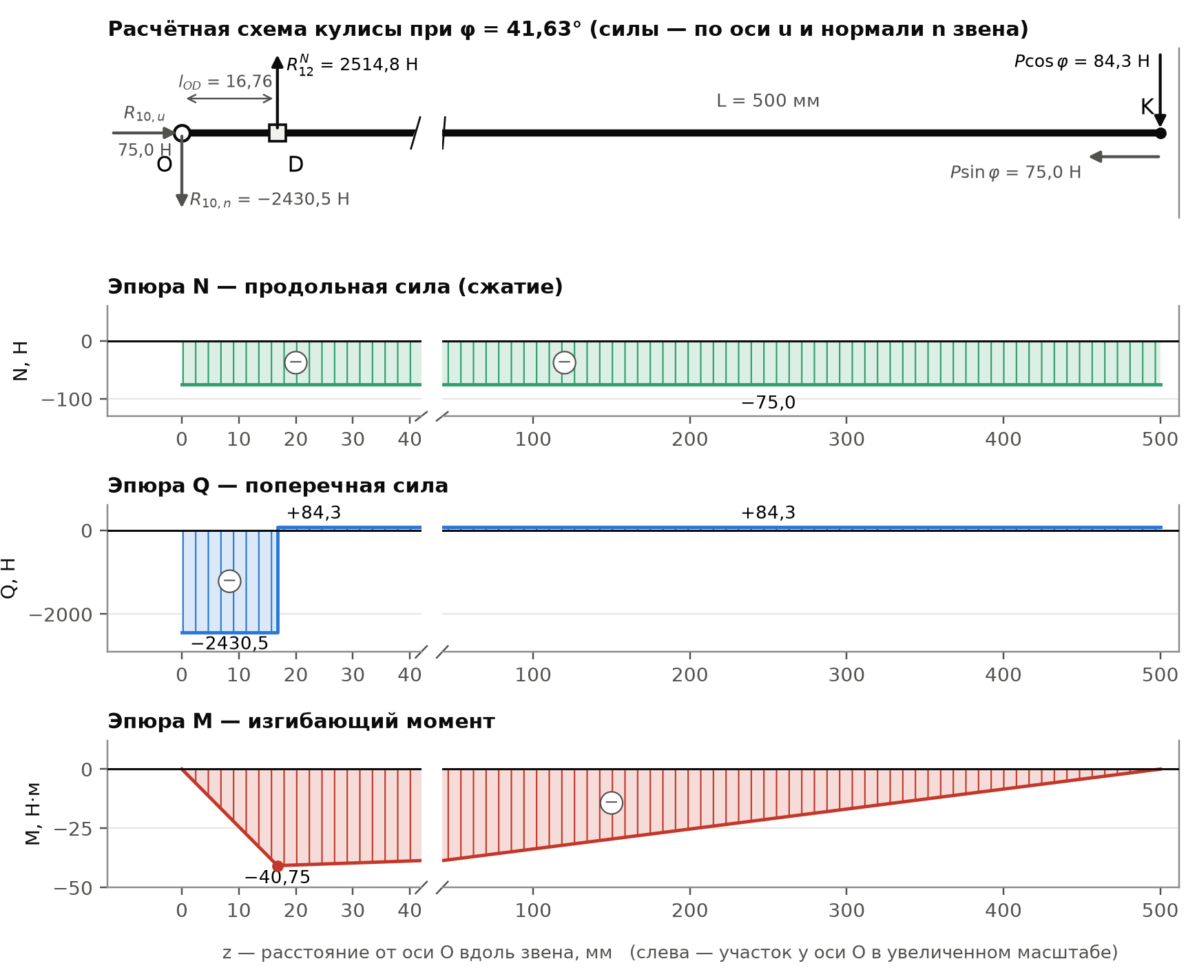
курсовой/2026-10-19/fig10_epury_phiy_v11.png
