DamirNine/prikmeh/курсовой/2026-10-19/fig13_wall_v11.png

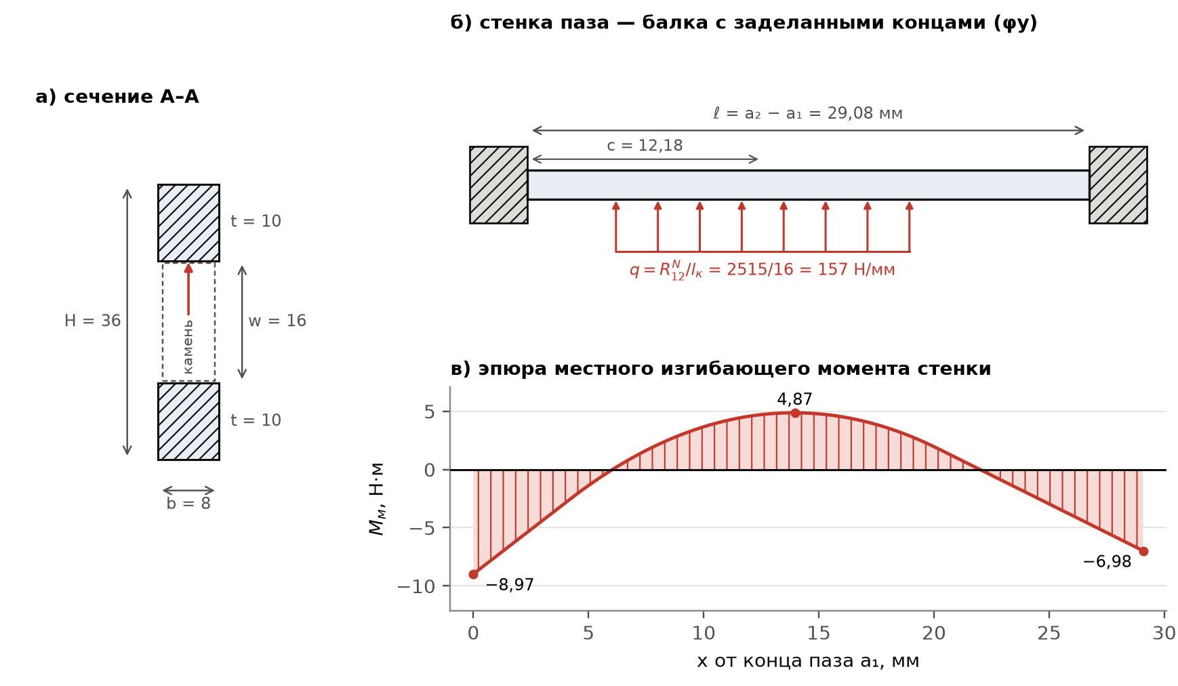
курсовой/2026-10-19/fig13_wall_v11.png
