DamirNine/prikmeh/курсовой/2026-10-19/fig14_kulisa_v11.png

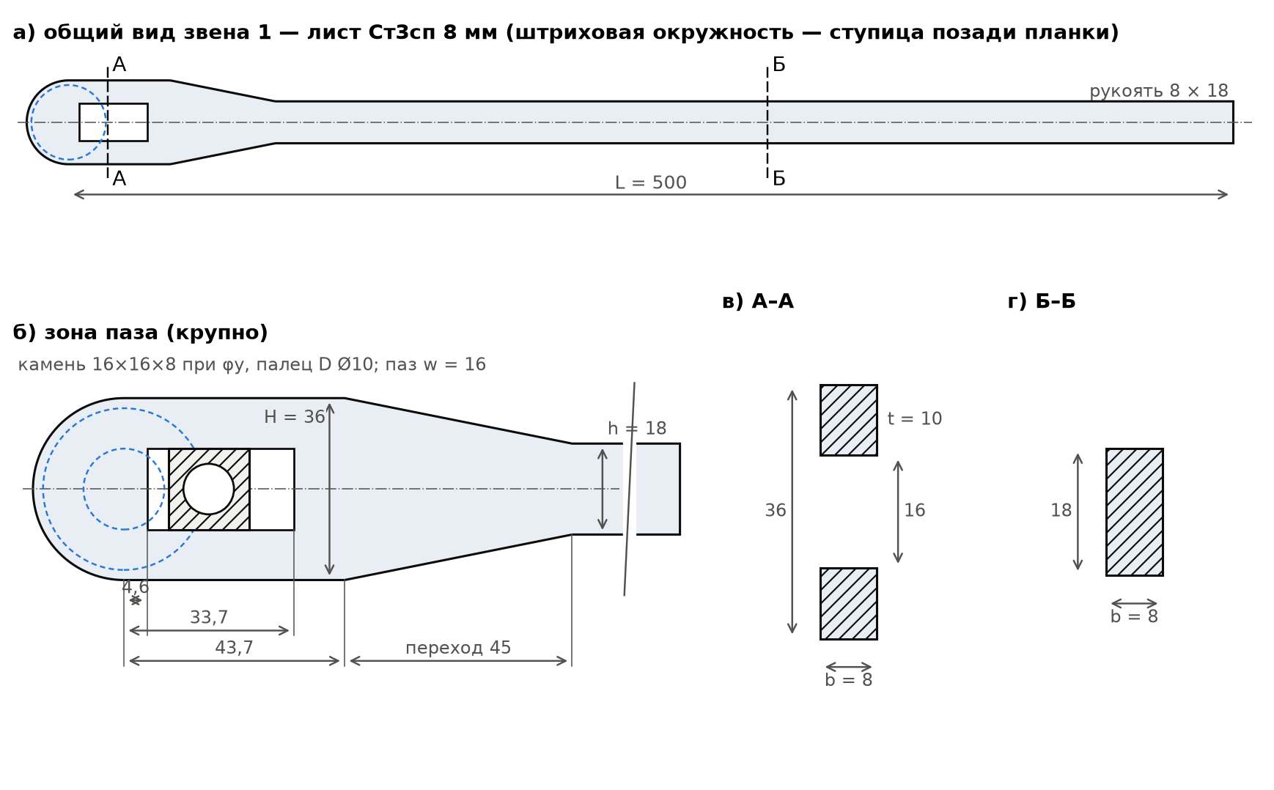
курсовой/2026-10-19/fig14_kulisa_v11.png
