DamirNine/prikmeh/курсовой/2026-10-23/fig10_epury_phiy_v12.png

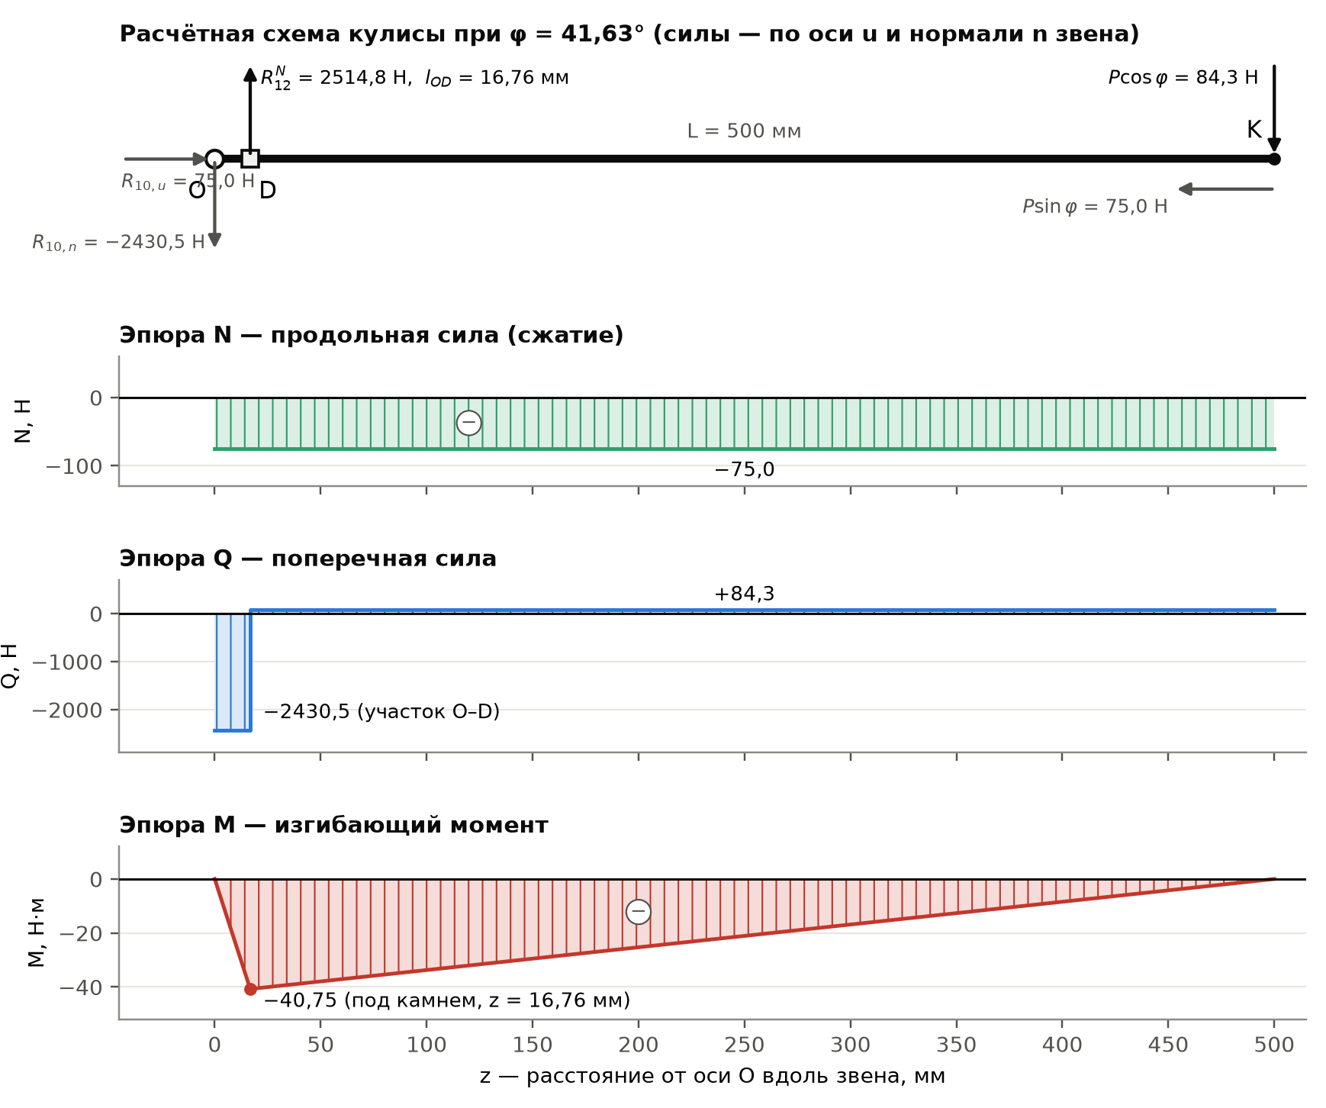
курсовой/2026-10-23/fig10_epury_phiy_v12.png
