DamirNine/prikmeh/курсовой/2026-10-23/fig11_epury_phik_v12.png

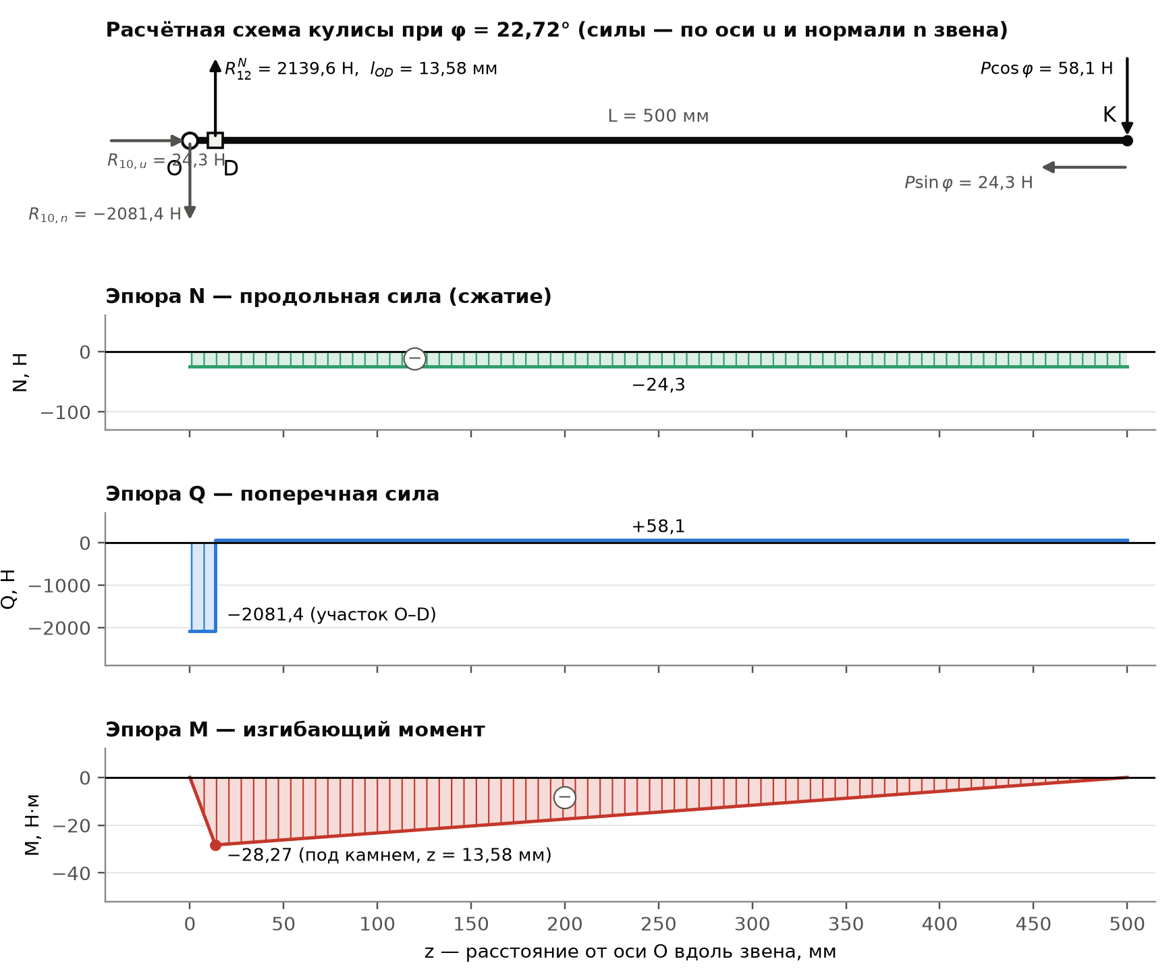
курсовой/2026-10-23/fig11_epury_phik_v12.png
