DamirNine/prikmeh/курсовой/2026-10-23/fig12_bars_r.png

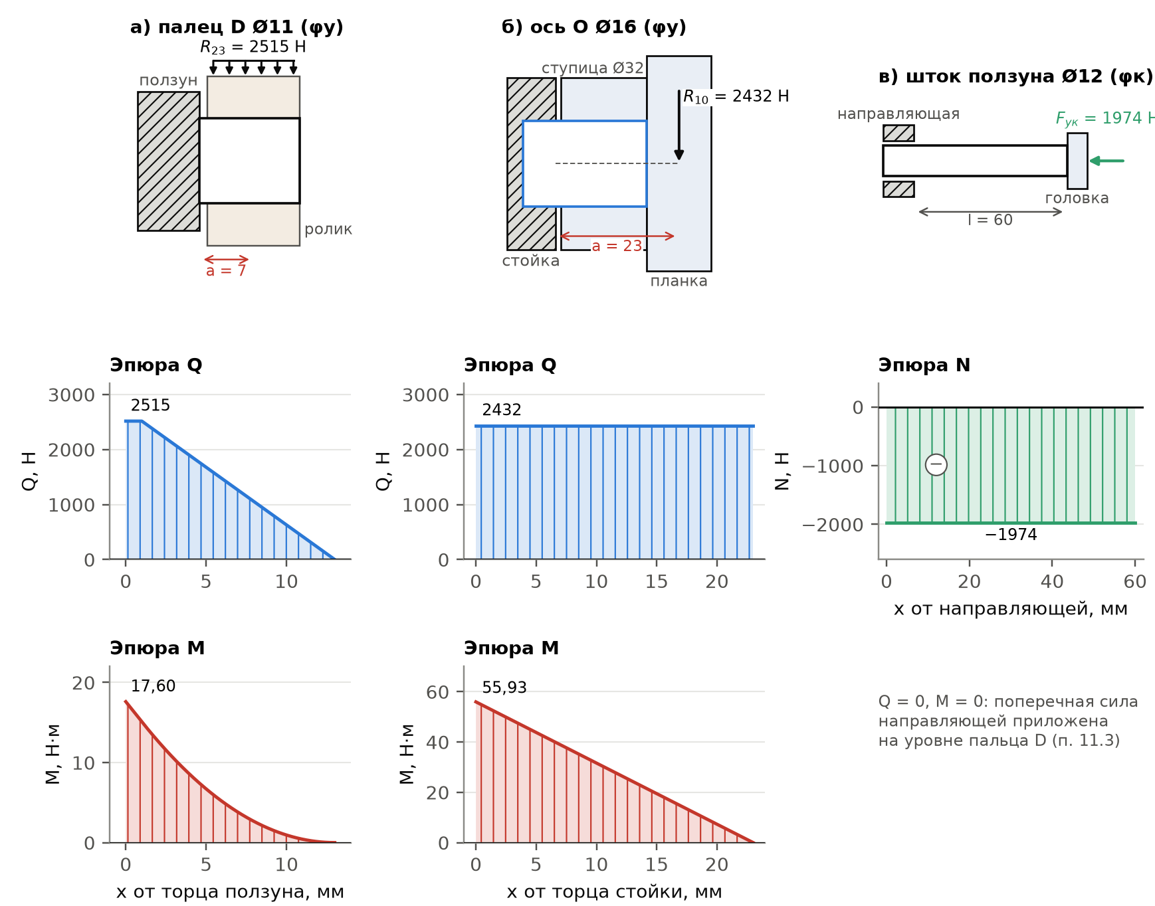
курсовой/2026-10-23/fig12_bars_r.png
