DamirNine/prikmeh/курсовой/2026-10-23/fig13_wall_r.png

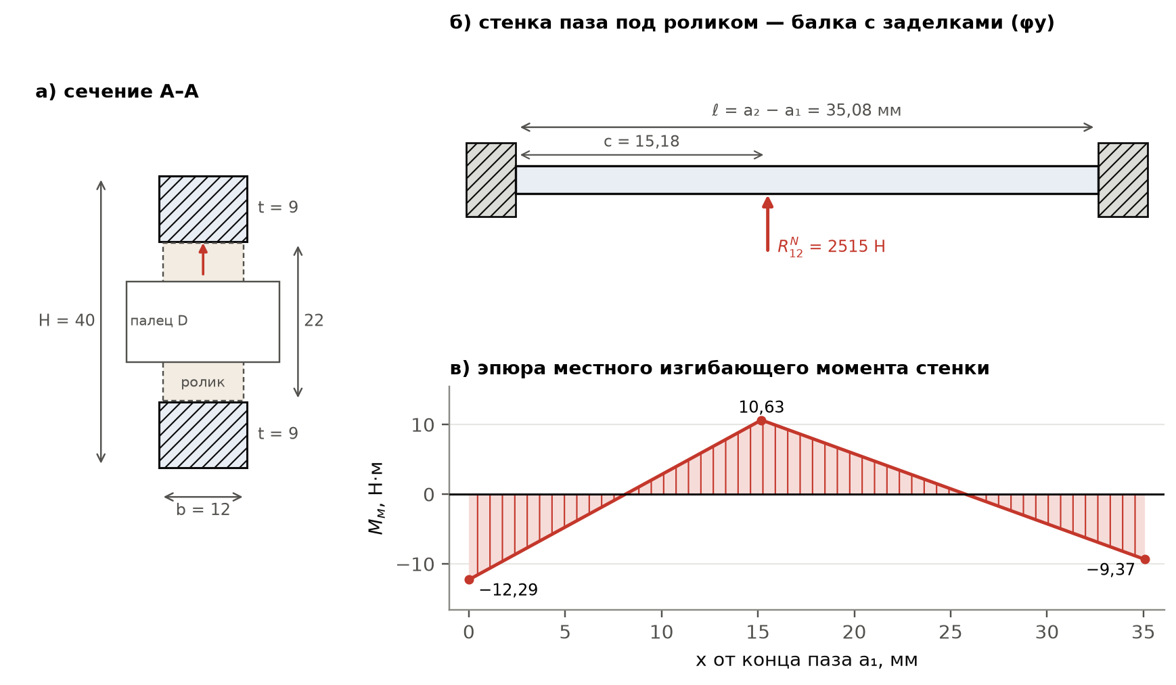
курсовой/2026-10-23/fig13_wall_r.png
