DamirNine/prikmeh/курсовой/2026-10-23/fig14_kulisa_r.png

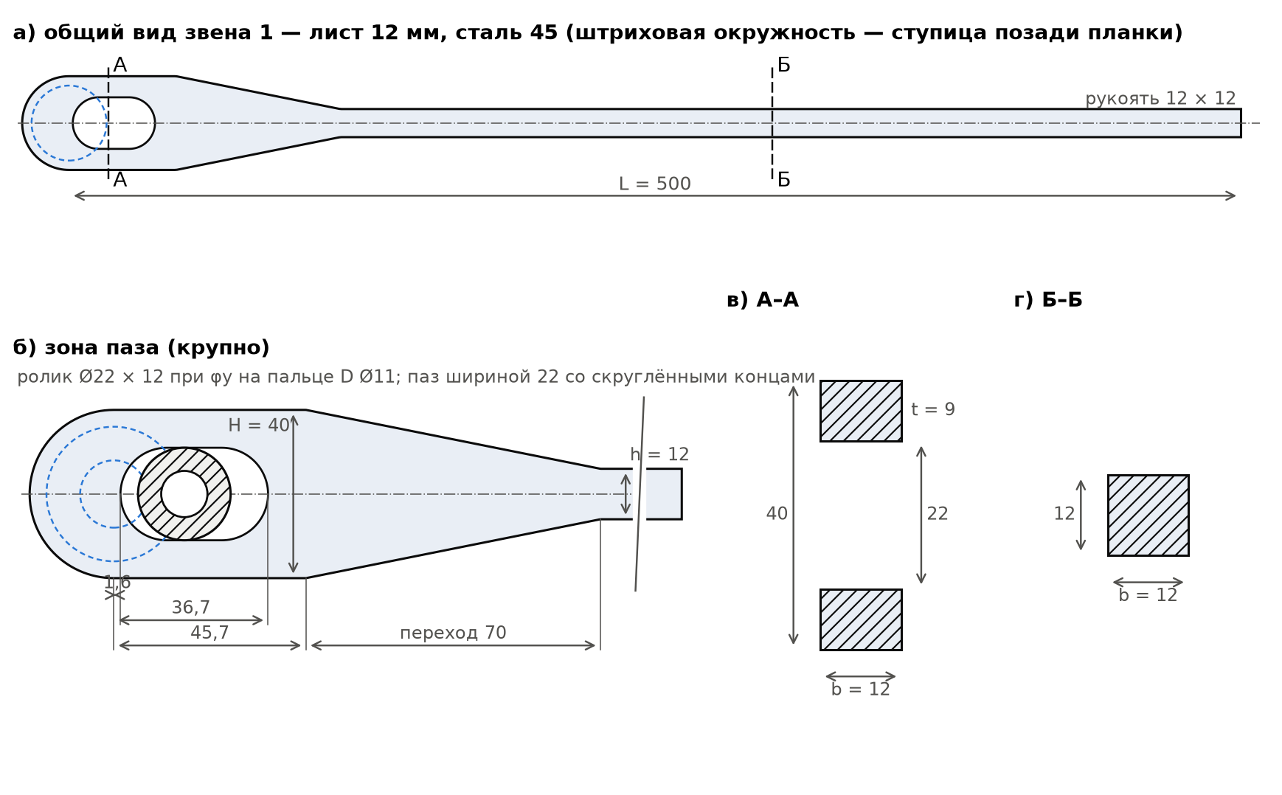
курсовой/2026-10-23/fig14_kulisa_r.png
