DamirNine/prikmeh/курсовой/2026-10-24/fig10_epury_phiy_v13.png

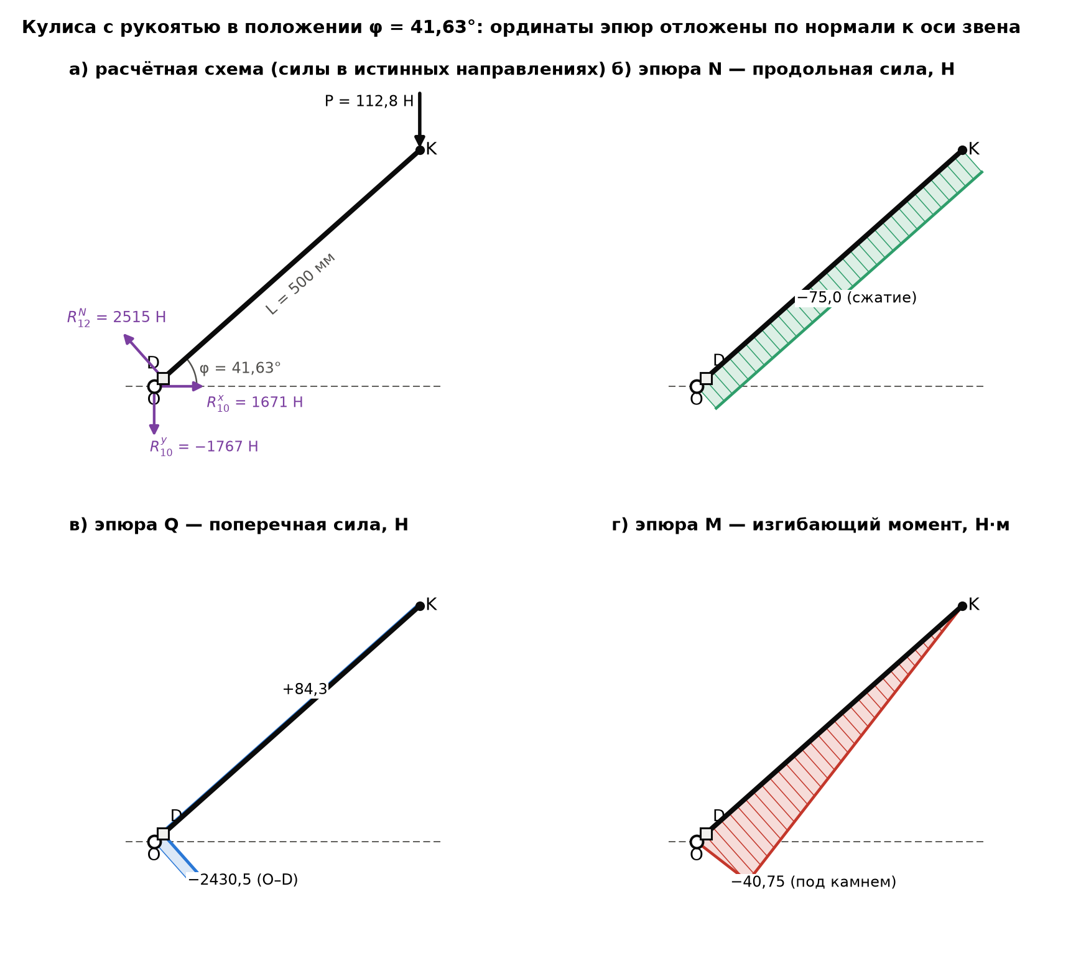
курсовой/2026-10-24/fig10_epury_phiy_v13.png
