DamirNine/prikmeh/курсовой/2026-10-24/fig11_epury_phik_v13.png

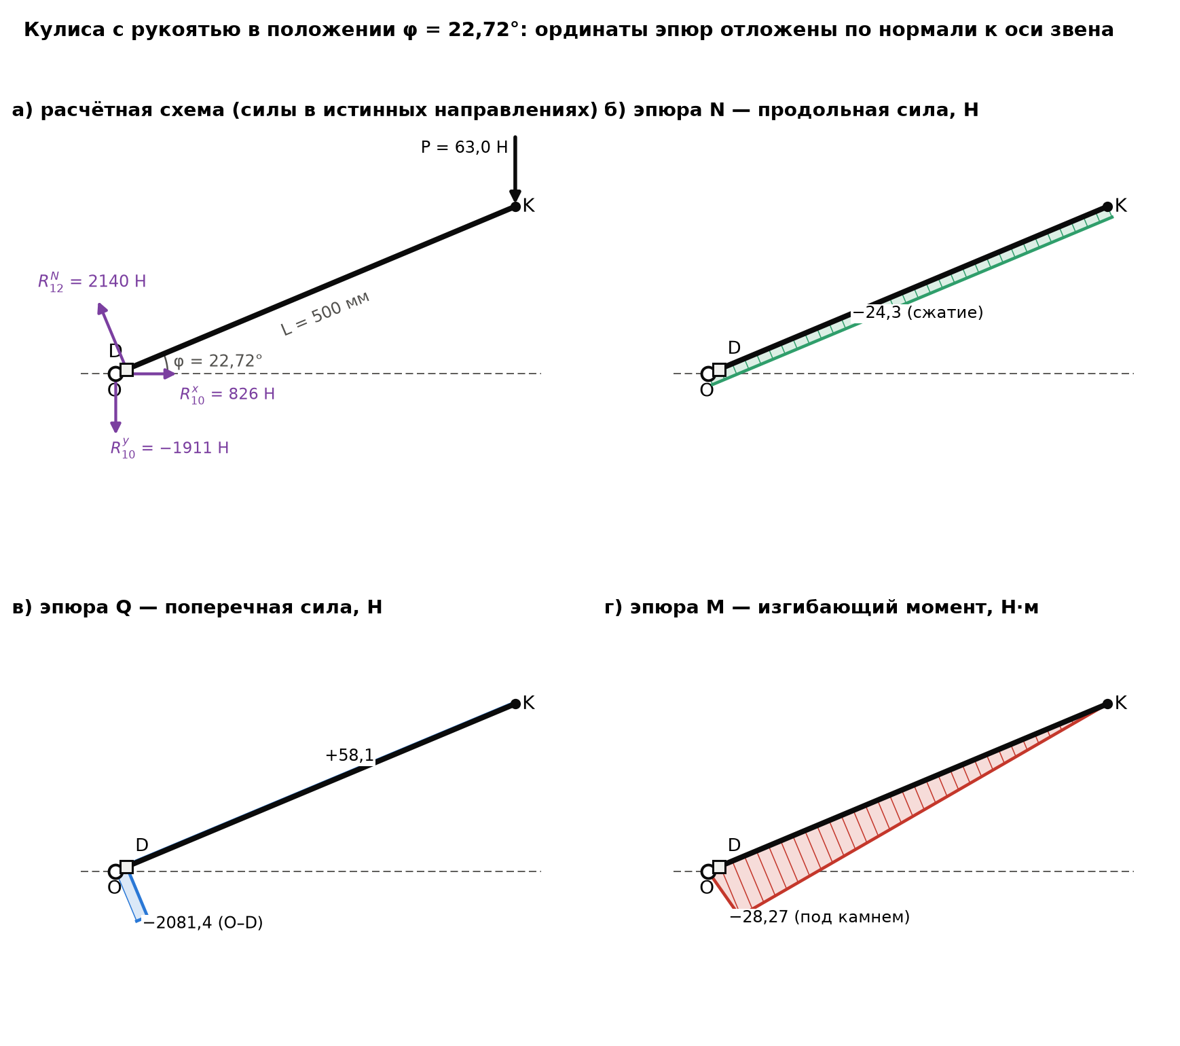
курсовой/2026-10-24/fig11_epury_phik_v13.png
