DamirNine/prikmeh/курсовой/2026-10-24/fig12_rod_v13.png

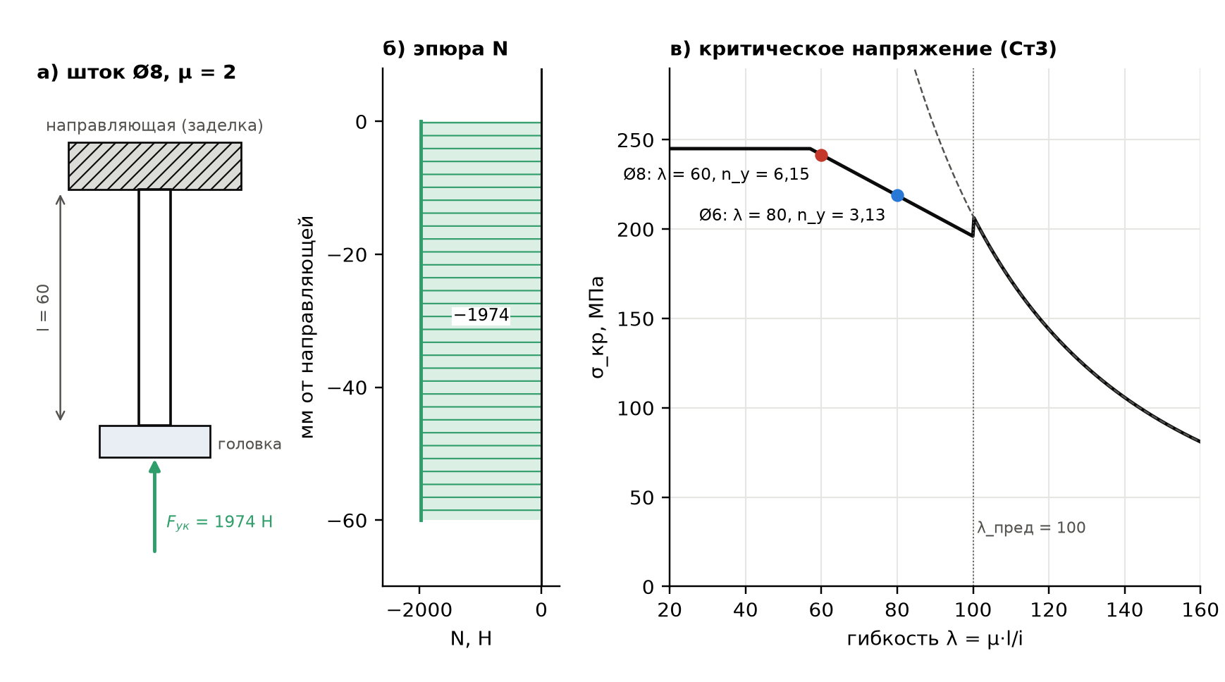
курсовой/2026-10-24/fig12_rod_v13.png
