DamirNine/prikmeh/курсовой/2026-10-24/fig13_kamen_v13.png

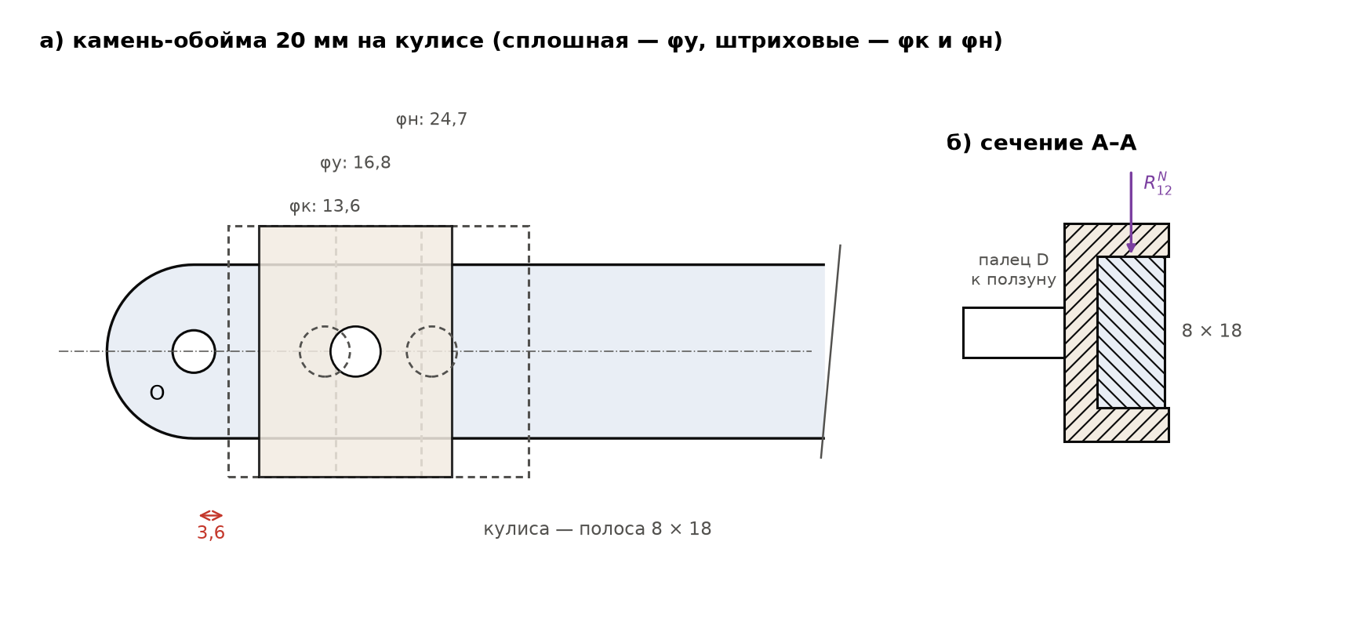
курсовой/2026-10-24/fig13_kamen_v13.png
