DamirNine/prikmeh/курсовой/2026-11-02/fig14_refined_v17.png

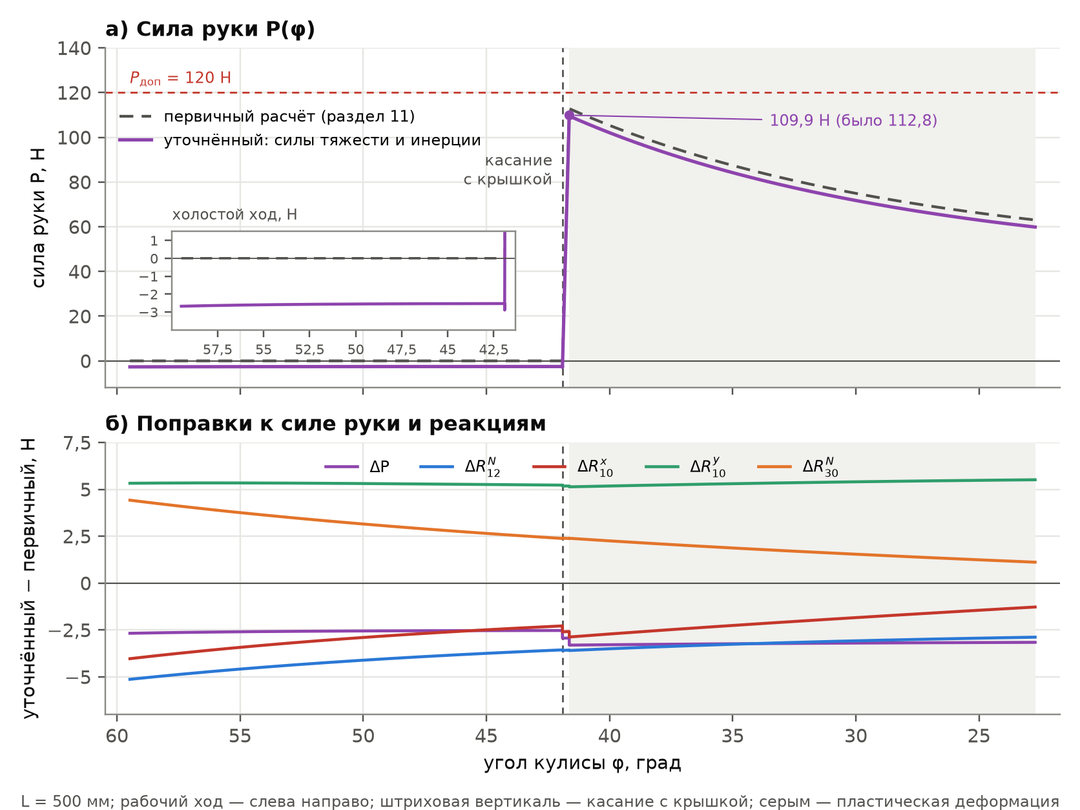
курсовой/2026-11-02/fig14_refined_v17.png
