DamirNine/prikmeh/курсовой/2026-11-02/fig14_unknowns_v18.png

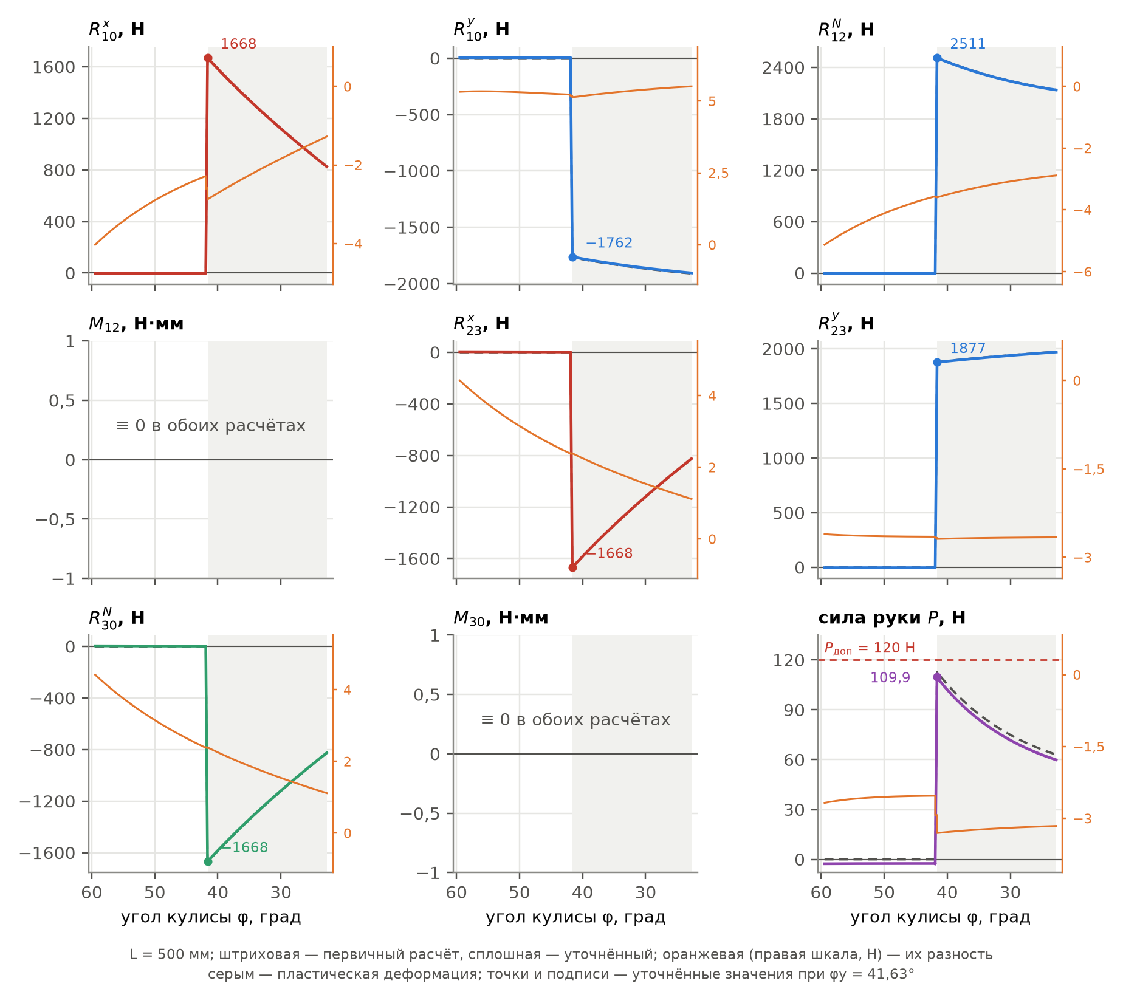
курсовой/2026-11-02/fig14_unknowns_v18.png
