DamirNine/prikmeh/курсовой/2026-11-09/apm/Картинки/камень_3_новый.png

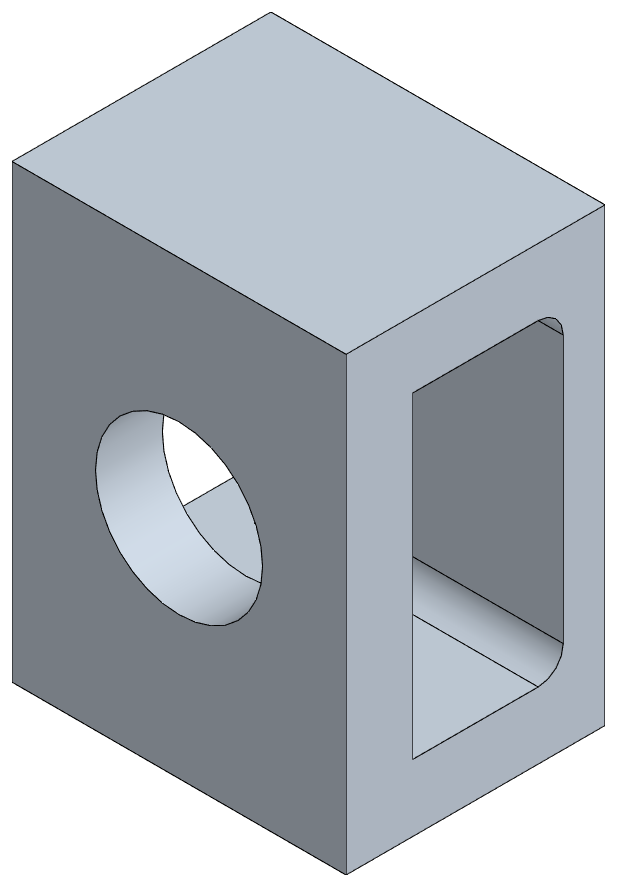
курсовой/2026-11-09/apm/Картинки/камень_3_новый.png
