DamirNine/prikmeh/курсовой/2026-11-09/apm/Картинки/кулиса_1_деталь.png

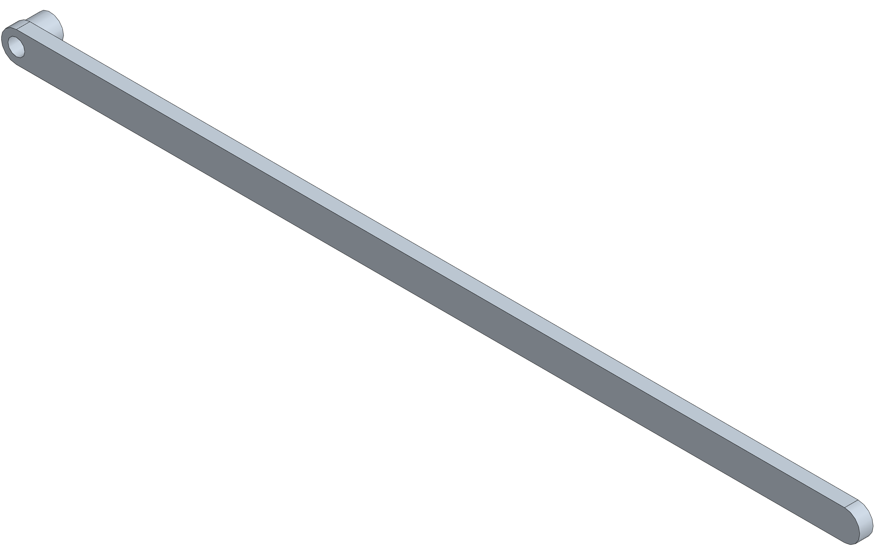
курсовой/2026-11-09/apm/Картинки/кулиса_1_деталь.png
