DamirNine/prikmeh/курсовой/2026-11-09/apm/Картинки/ползун_3_новый.png

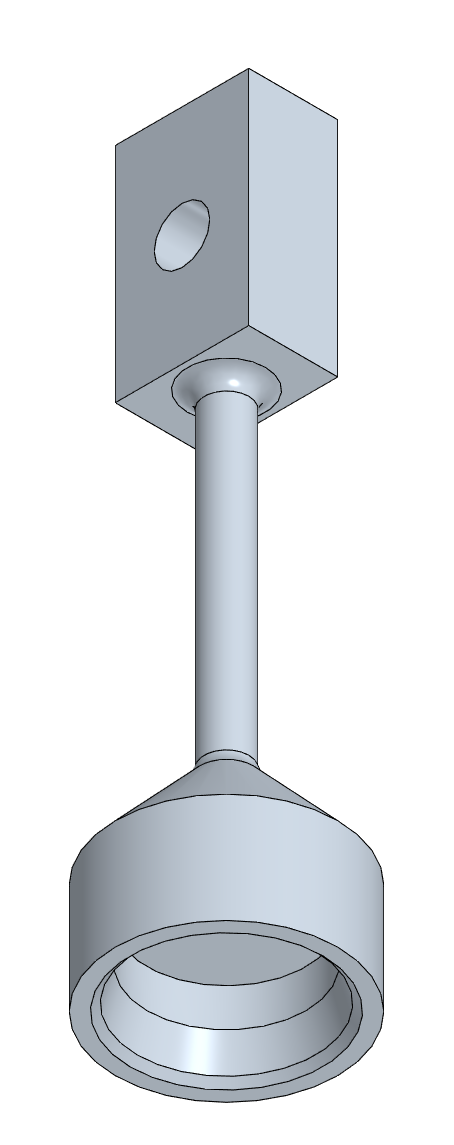
курсовой/2026-11-09/apm/Картинки/ползун_3_новый.png
