DamirNine/prikmeh/курсовой/2026-11-09/apm/Скрины/камень_2_тест.png

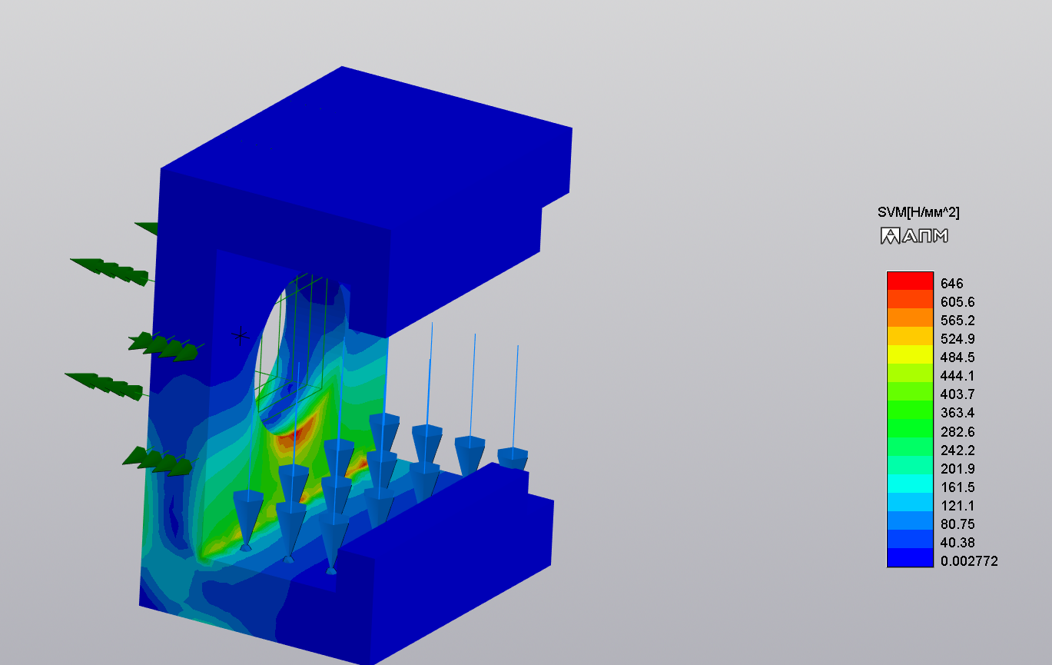
курсовой/2026-11-09/apm/Скрины/камень_2_тест.png
