DamirNine/prikmeh/курсовой/2026-11-09/apm/Скрины/камень_4_тест_итог.png

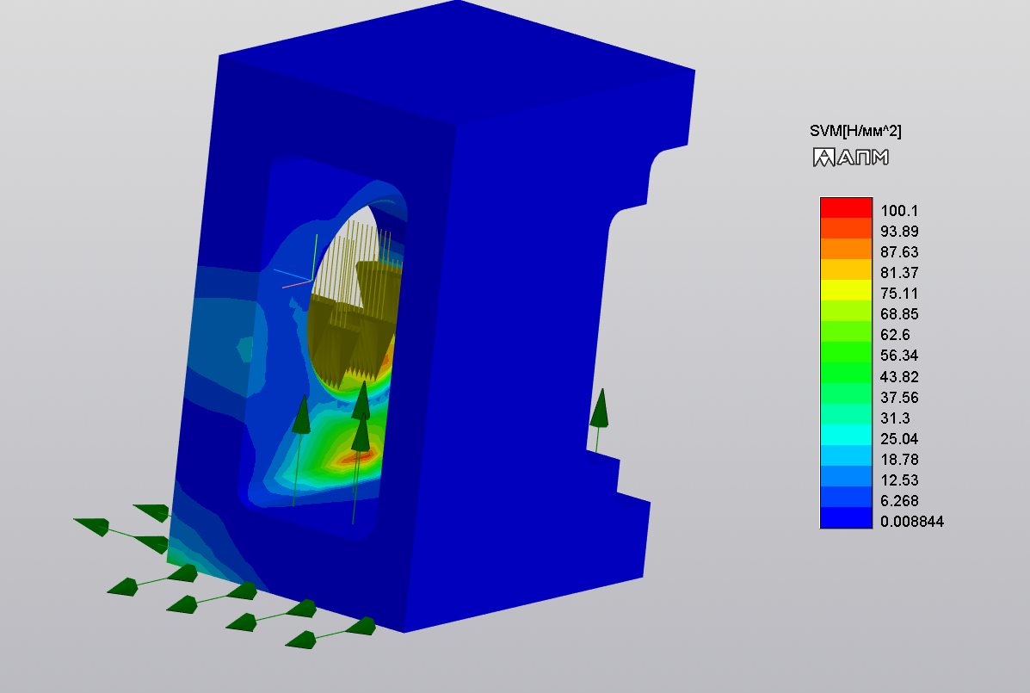
курсовой/2026-11-09/apm/Скрины/камень_4_тест_итог.png
