DamirNine/prikmeh/курсовой/2026-11-09/apm/Скрины/кулиса_4_тест_новой_2.png

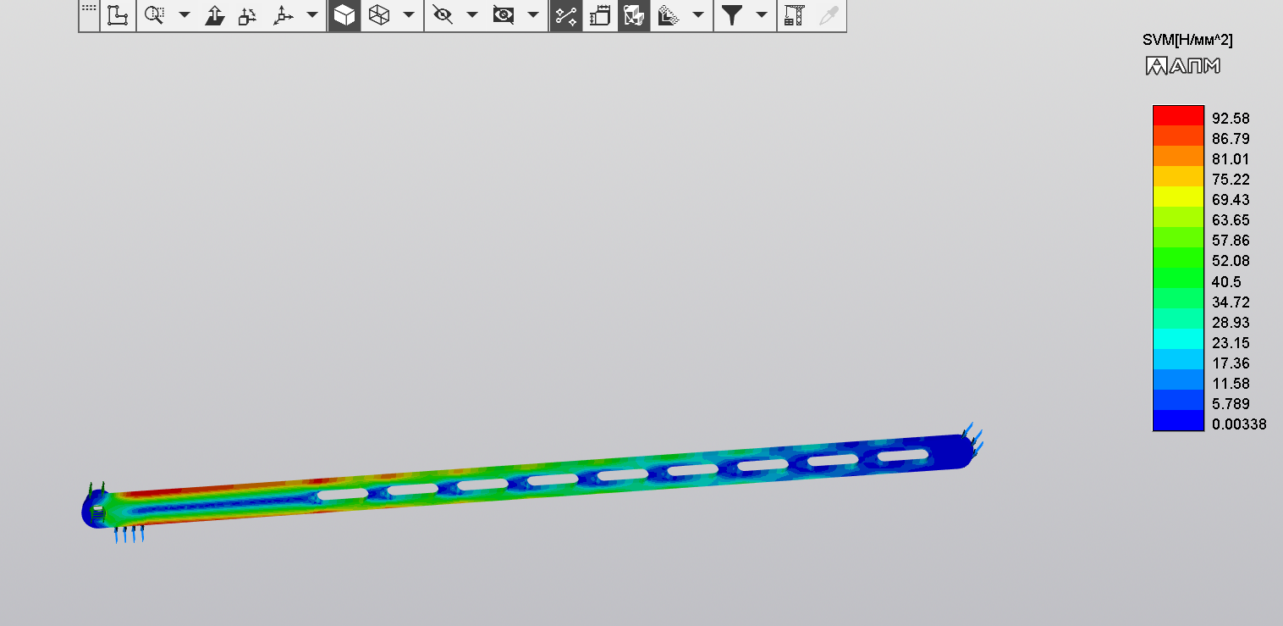
курсовой/2026-11-09/apm/Скрины/кулиса_4_тест_новой_2.png
