DamirNine/prikmeh/курсовой/2026-11-09/apm/Скрины/палец_2_тест_подшипниковая.png

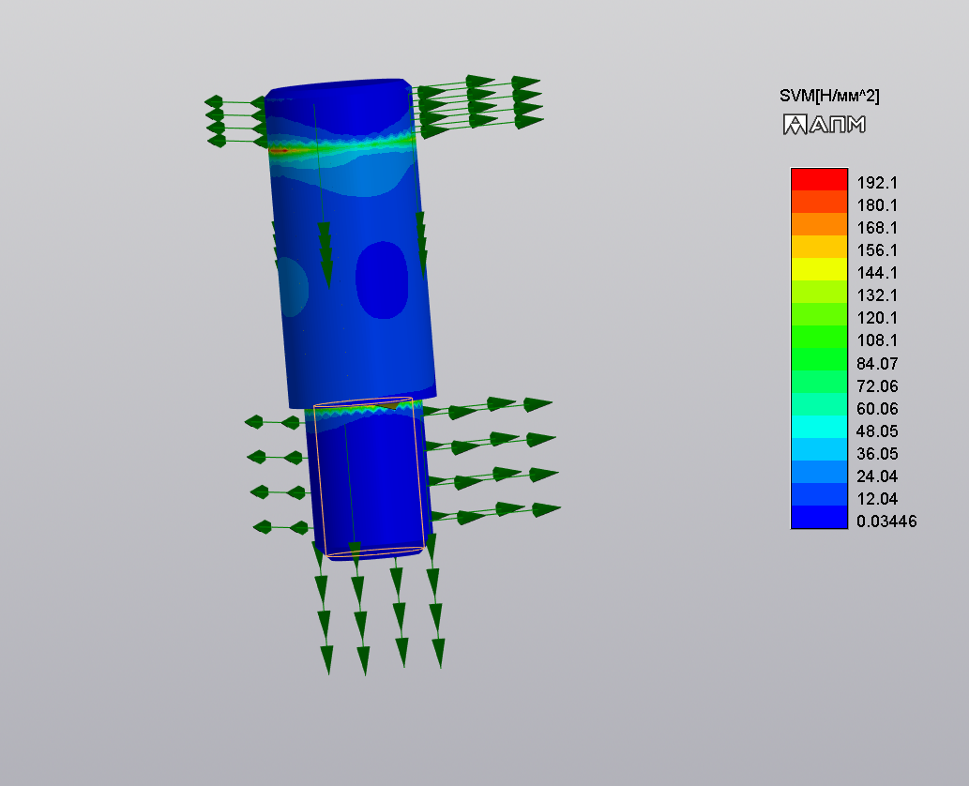
курсовой/2026-11-09/apm/Скрины/палец_2_тест_подшипниковая.png
