DamirNine/prikmeh/курсовой/2026-11-09/apm/Скрины/ползун_4_тест_нового.png

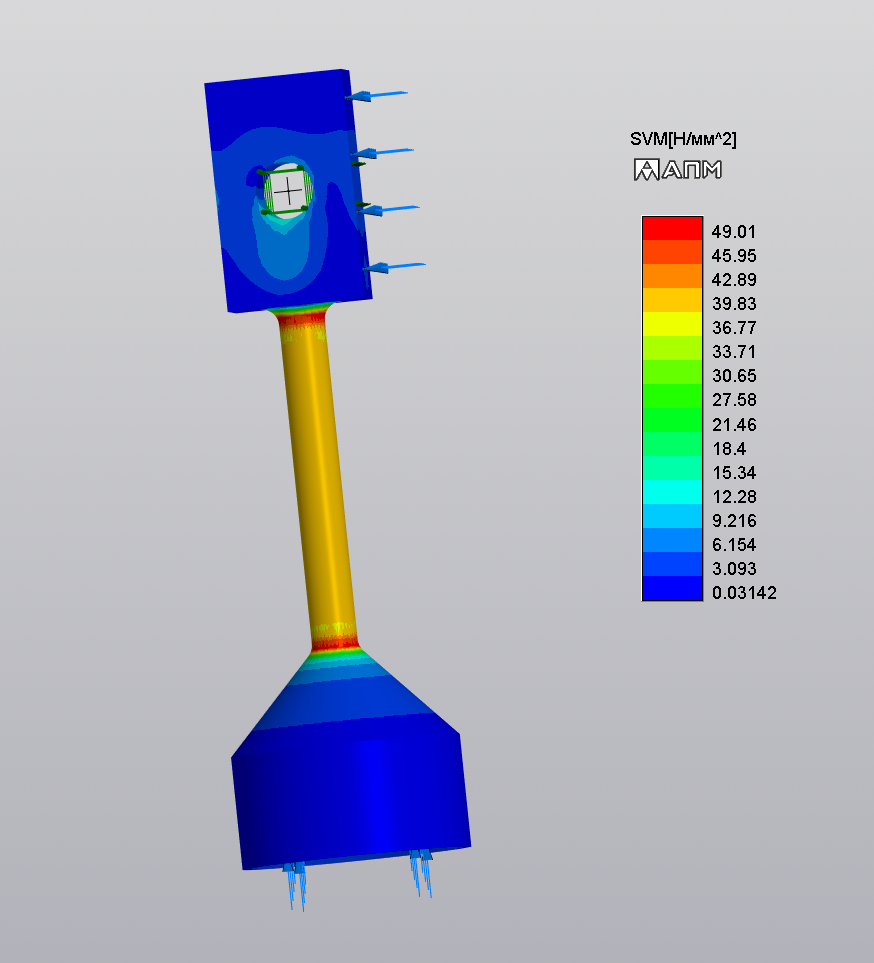
курсовой/2026-11-09/apm/Скрины/ползун_4_тест_нового.png
