DamirNine/prikmeh/курсовой/2026-11-13/инструкция/img/00_общий_вид.png

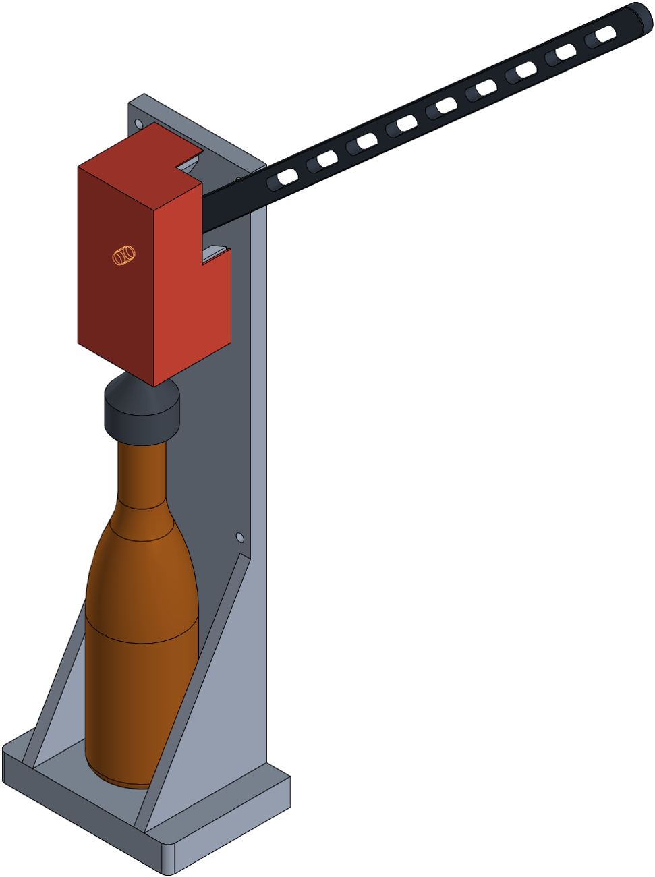
курсовой/2026-11-13/инструкция/img/00_общий_вид.png
