DamirNine/prikmeh/курсовой/2026-11-13/инструкция/img/02_рукоять_вверху.png

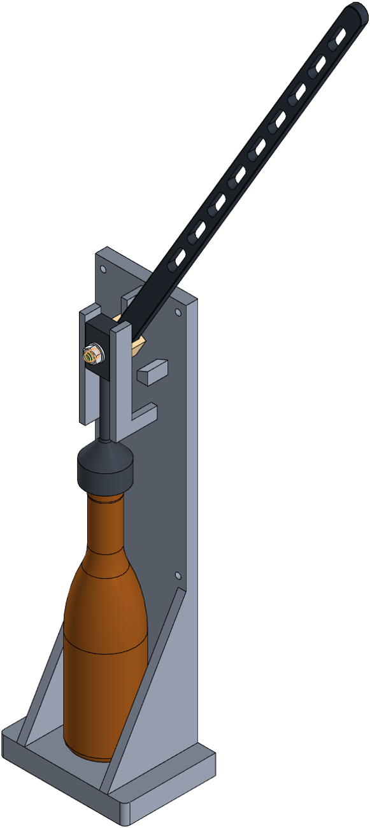
курсовой/2026-11-13/инструкция/img/02_рукоять_вверху.png
