DamirNine/prikmeh/курсовой/2026-11-13/инструкция/img/03_рукоять_внизу.png

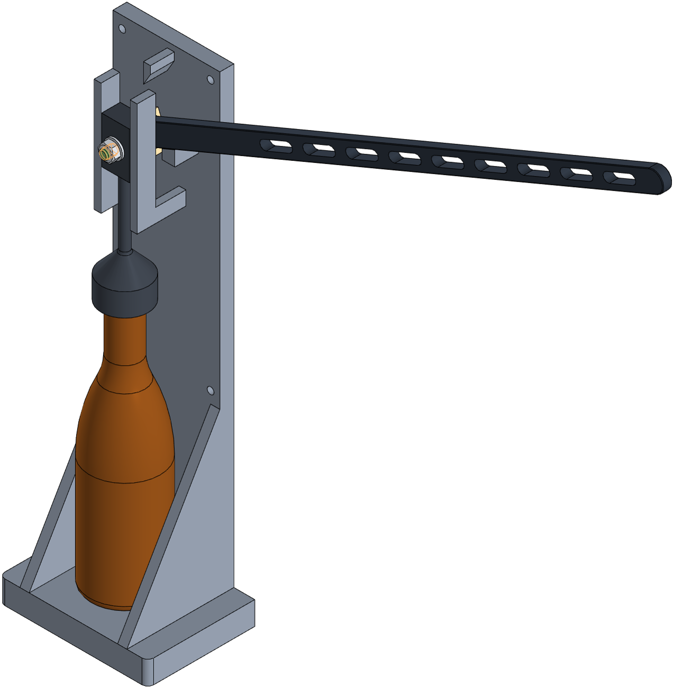
курсовой/2026-11-13/инструкция/img/03_рукоять_внизу.png
