DamirNine/prikmeh/курсовой/2026-11-13/инструкция/img/10_стойка.png

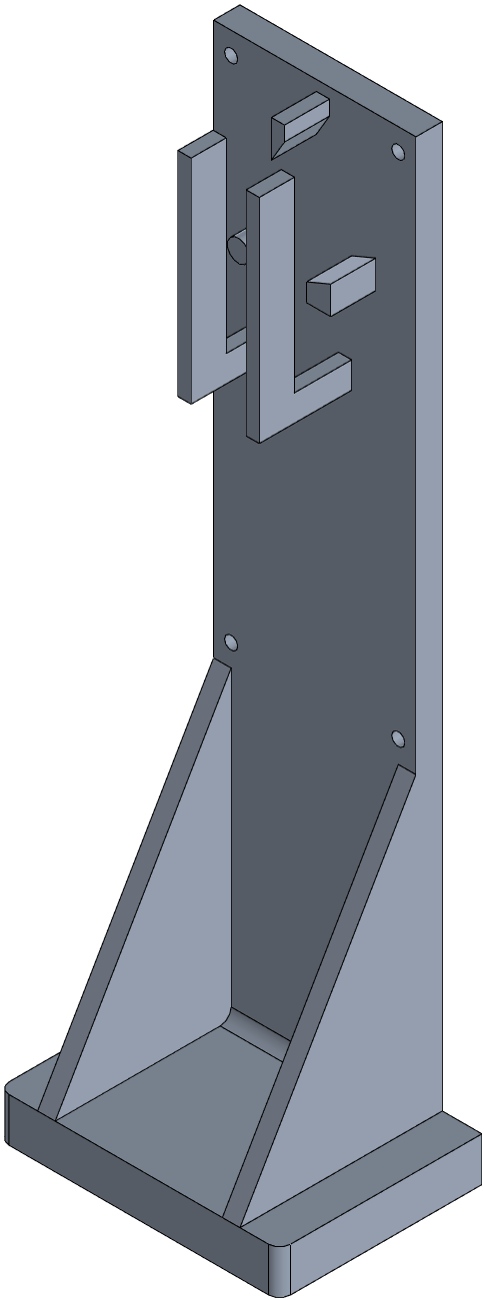
курсовой/2026-11-13/инструкция/img/10_стойка.png
