DamirNine/prikmeh/курсовой/2026-11-13/инструкция/img/11_палец_в_камень.png

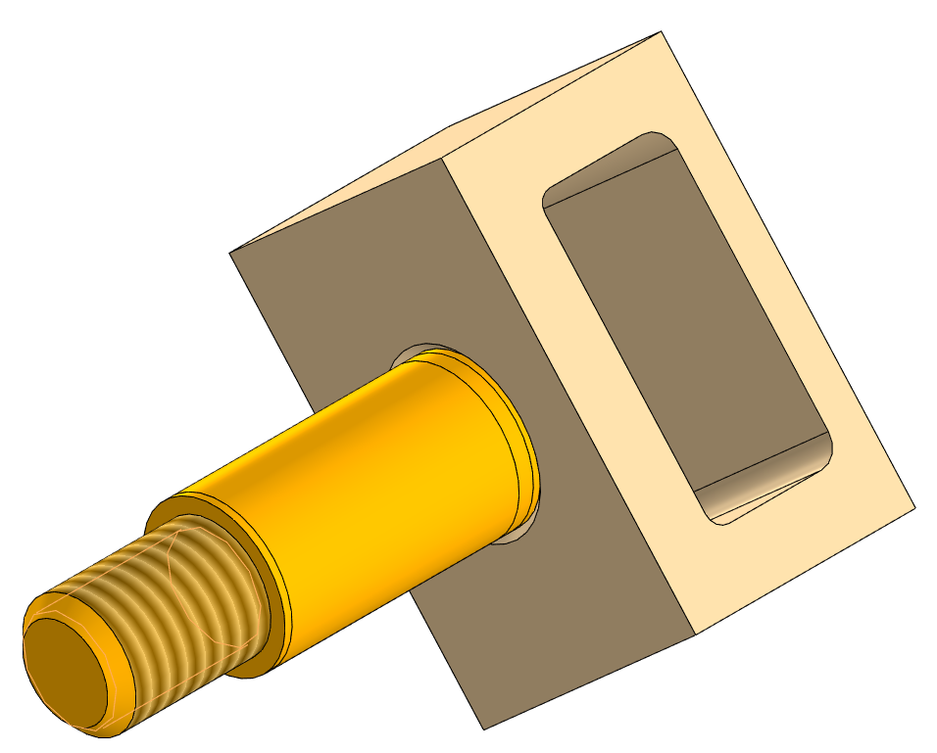
курсовой/2026-11-13/инструкция/img/11_палец_в_камень.png
