DamirNine/prikmeh/курсовой/2026-11-13/инструкция/img/12_камень_на_кулису.png

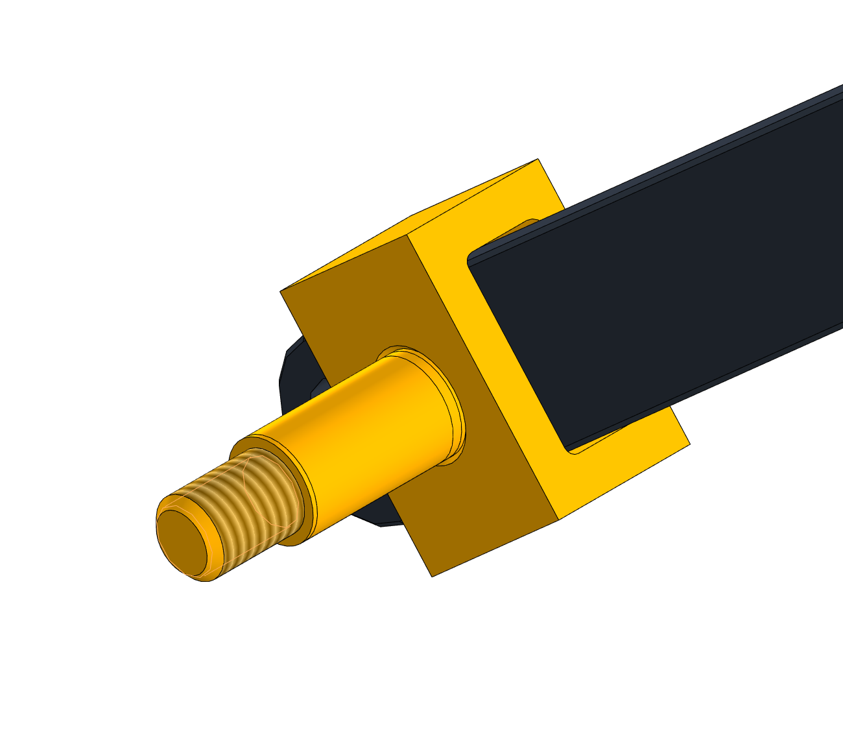
курсовой/2026-11-13/инструкция/img/12_камень_на_кулису.png
