DamirNine/prikmeh/курсовой/2026-11-13/инструкция/img/14_ползун.png

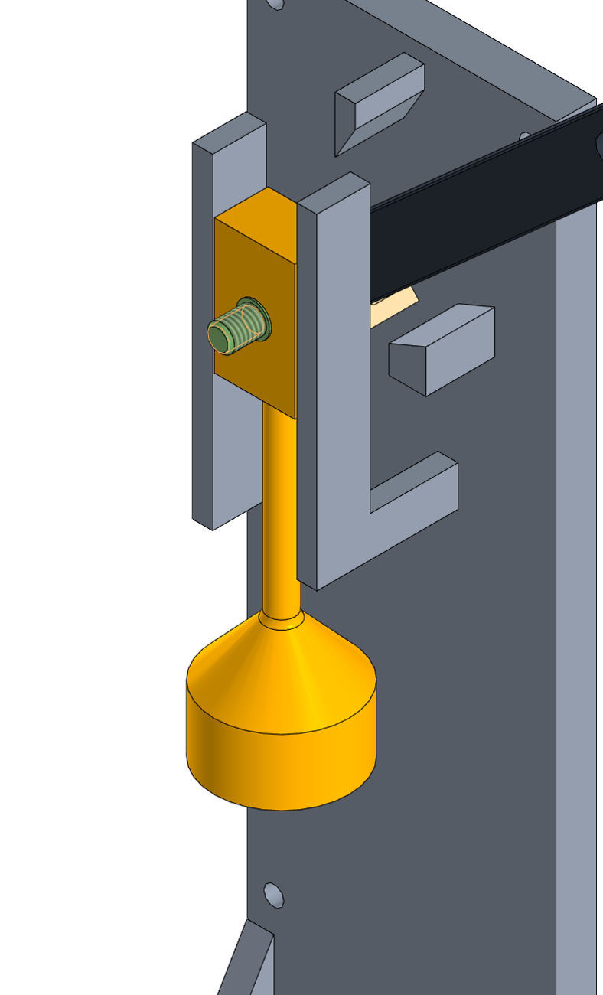
курсовой/2026-11-13/инструкция/img/14_ползун.png
