DamirNine/prikmeh/курсовой/2026-11-13/инструкция/img/15_шайба_гайка.png

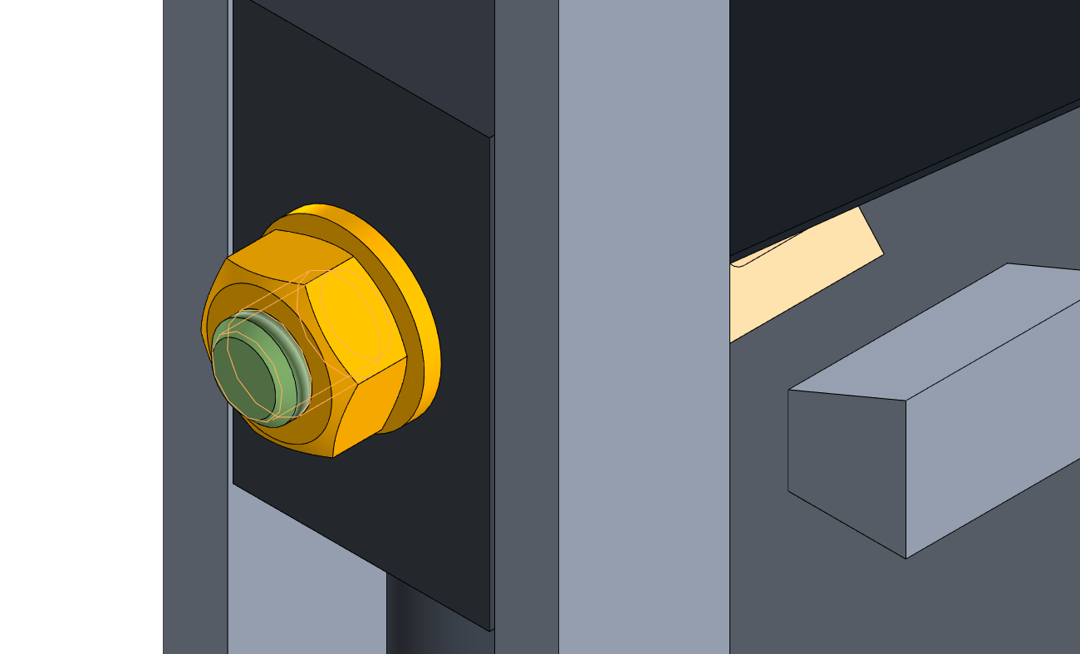
курсовой/2026-11-13/инструкция/img/15_шайба_гайка.png
