DamirNine/prikmeh/курсовой/2026-11-13/инструкция/img/16_кожух_надевание.png

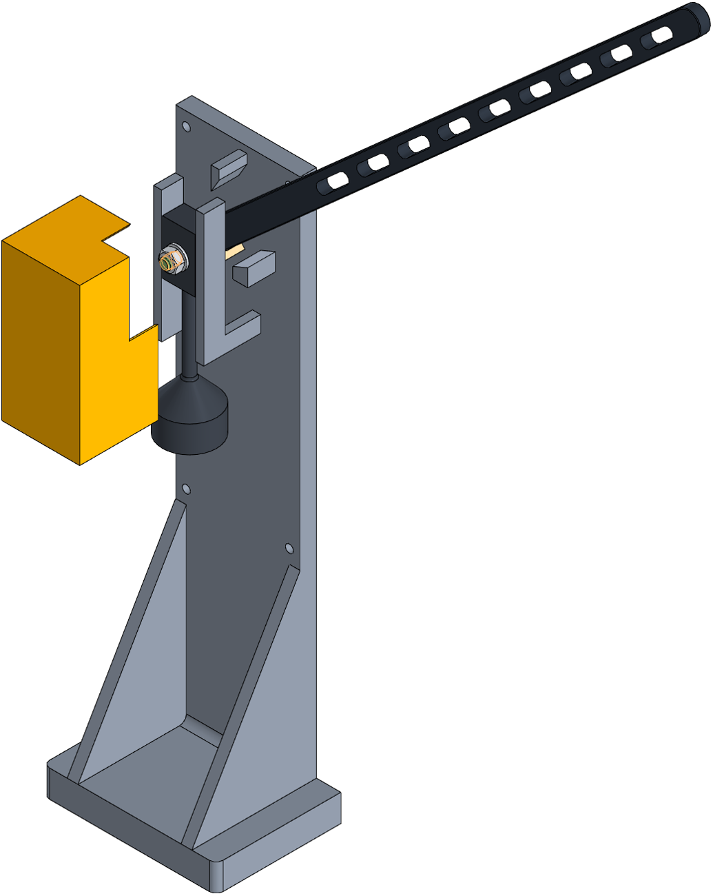
курсовой/2026-11-13/инструкция/img/16_кожух_надевание.png
