DamirNine/prikmeh/курсовой/2026-11-13/инструкция/img/18_бутылка.png

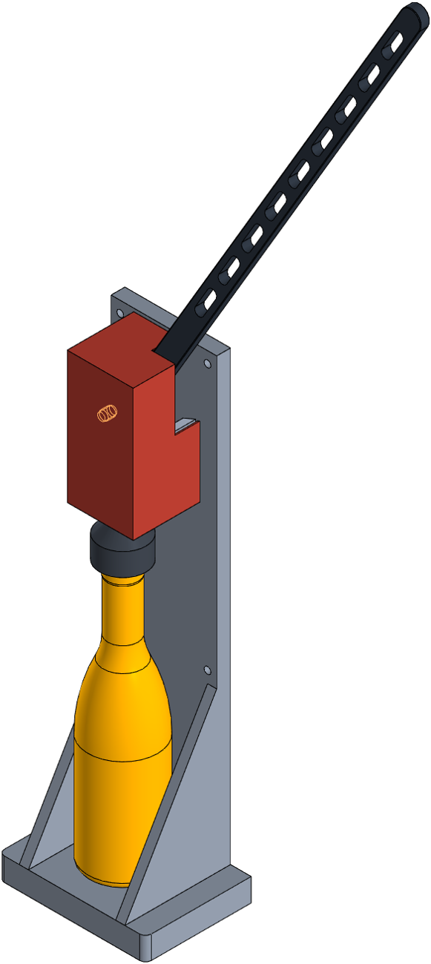
курсовой/2026-11-13/инструкция/img/18_бутылка.png
