DamirNine/prikmeh/курсовой/2026-11-13/инструкция/img/p_cover.png

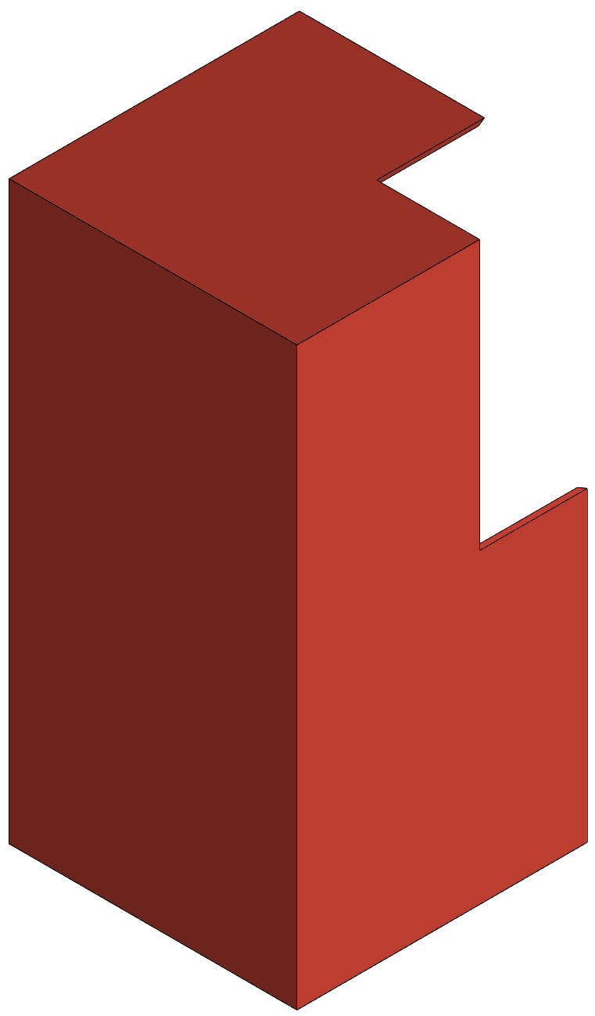
курсовой/2026-11-13/инструкция/img/p_cover.png
