DamirNine/prikmeh/курсовой/2026-11-13/инструкция/img/p_kulisa.png

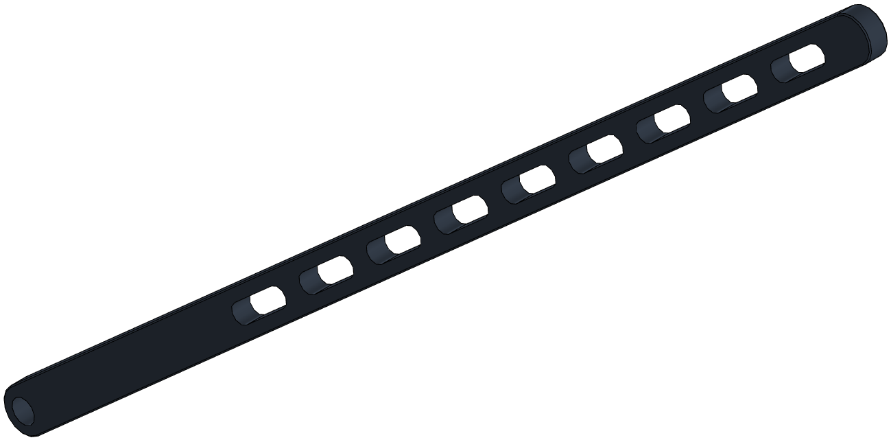
курсовой/2026-11-13/инструкция/img/p_kulisa.png
