DamirNine/prikmeh/курсовой/2026-11-13/инструкция/img/p_nut.png

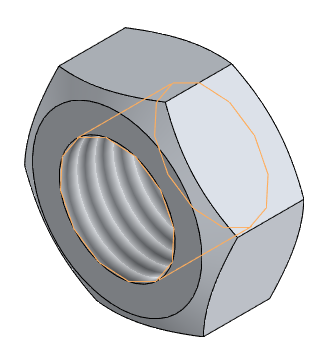
курсовой/2026-11-13/инструкция/img/p_nut.png
