DamirNine/prikmeh/курсовой/2026-11-13/инструкция/img/p_polzun.png

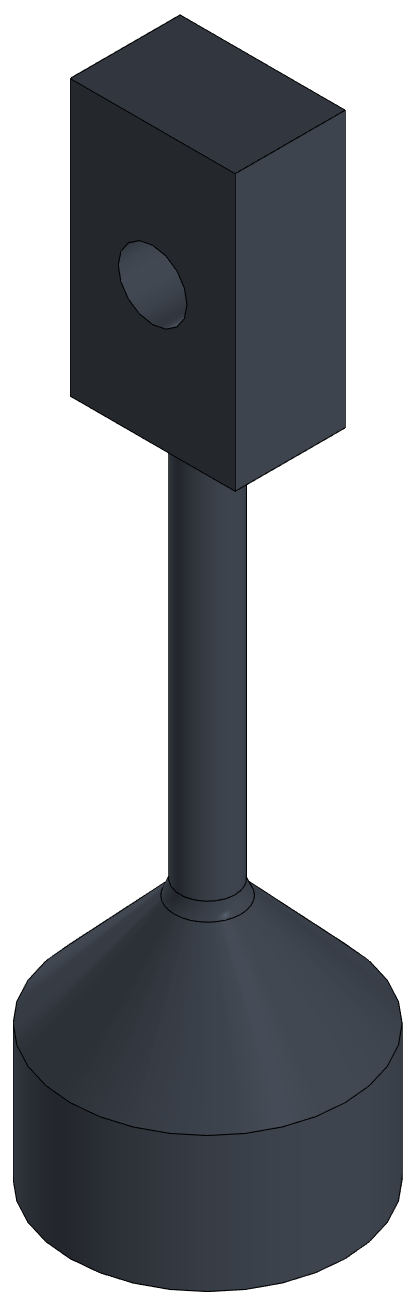
курсовой/2026-11-13/инструкция/img/p_polzun.png
