DamirNine/prikmeh/курсовой/2026-11-13/Укупориватель — печать и сборка/Детали для печати/1 Стойка.stl

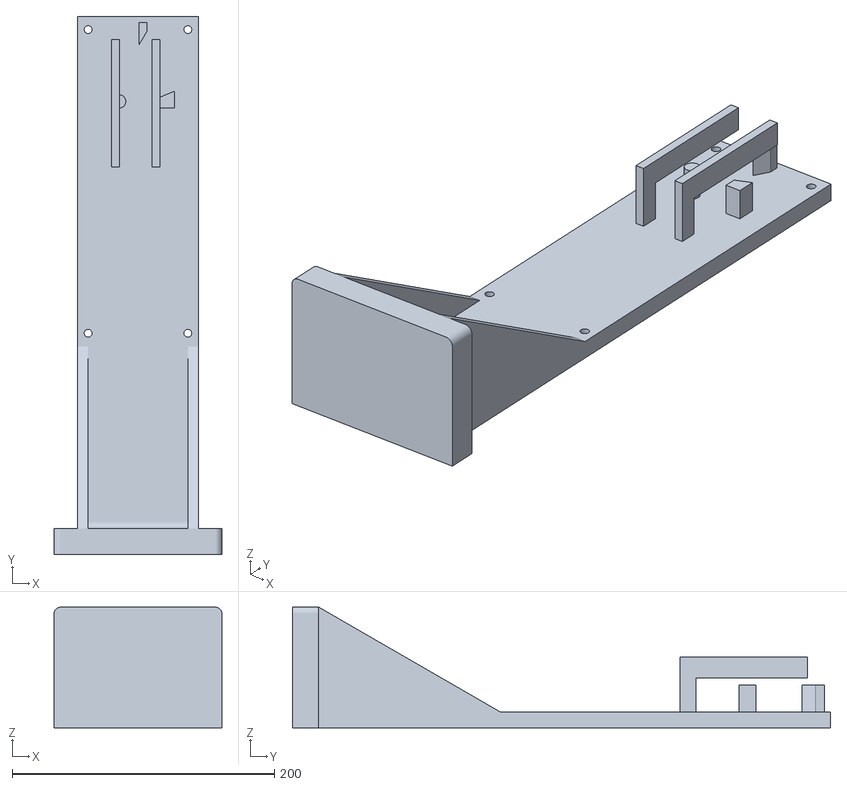
[picture p261: CAD file, 2026-11-13]
курсовой/2026-11-13/Укупориватель — печать и сборка/Детали для печати/1 Стойка.stl
128.0 x 410.0 x 92.0
