DamirNine/prikmeh/курсовой/2026-11-13/Укупориватель — печать и сборка/Детали для печати/8 Кожух.stl

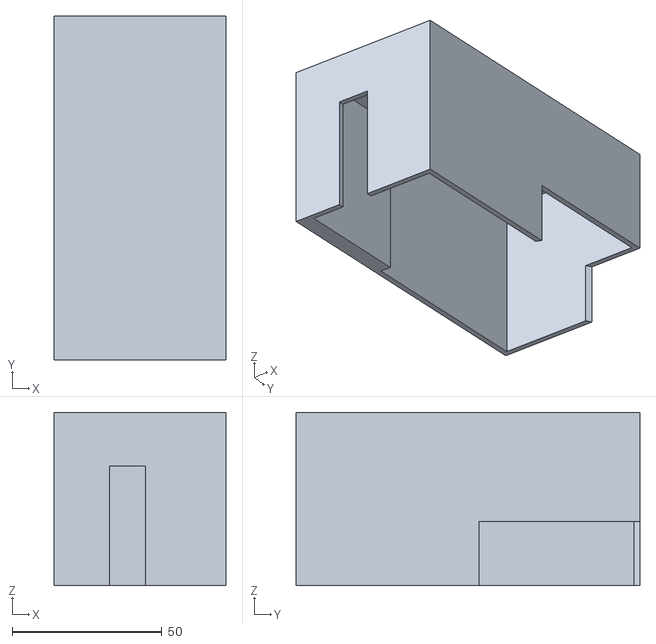
[picture p262: CAD file, 2026-11-13]
курсовой/2026-11-13/Укупориватель — печать и сборка/Детали для печати/8 Кожух.stl
57.5 x 115.0 x 58.0
