DamirNine/prikmeh/курсовой/2026-11-13/Укупориватель — печать и сборка/Детали для печати/4 Палец.stl

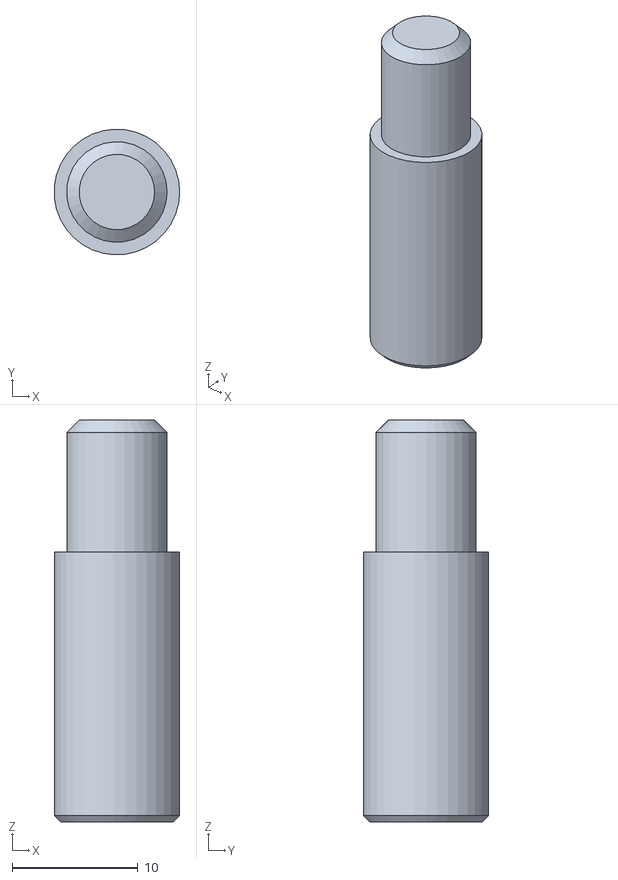
[picture p263: CAD file, 2026-11-13]
курсовой/2026-11-13/Укупориватель — печать и сборка/Детали для печати/4 Палец.stl
9.98 x 9.99 x 32.0
