DamirNine/prikmeh/курсовой/2026-11-13/Укупориватель — печать и сборка/Детали для печати/5 Ползун.stl

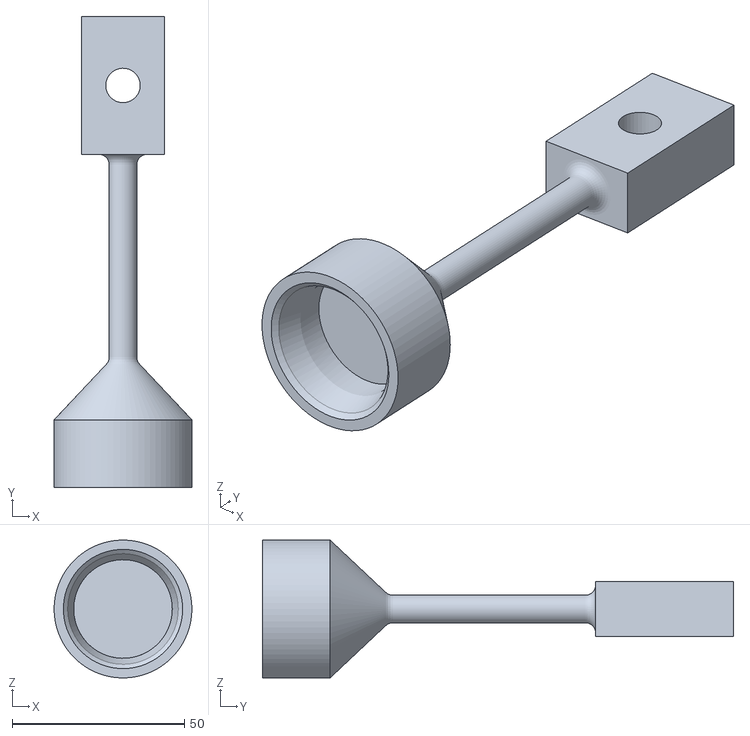
[picture p264: CAD file, 2026-11-13]
курсовой/2026-11-13/Укупориватель — печать и сборка/Детали для печати/5 Ползун.stl
40.0 x 136.7 x 40.0
