DamirNine/prikmeh/курсовой/2026-11-13/Укупориватель — печать и сборка/Детали для печати/7 Гайка.stl

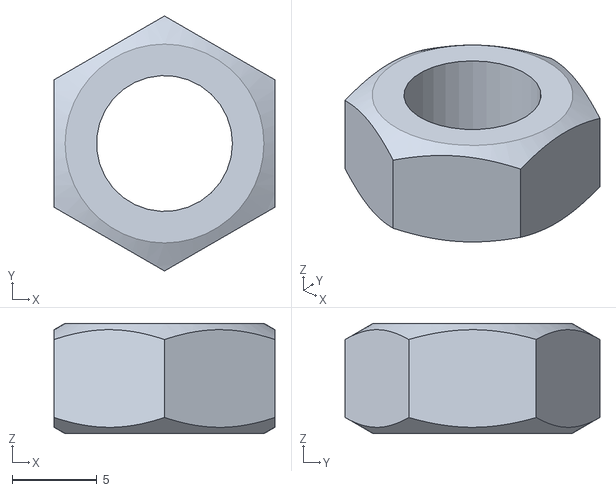
[picture p265: CAD file, 2026-11-13]
курсовой/2026-11-13/Укупориватель — печать и сборка/Детали для печати/7 Гайка.stl
13.0 x 15.0 x 6.50
