DamirNine/prikmeh/курсовой/2026-11-13/Укупориватель — печать и сборка/Детали для печати/6 Шайба.stl

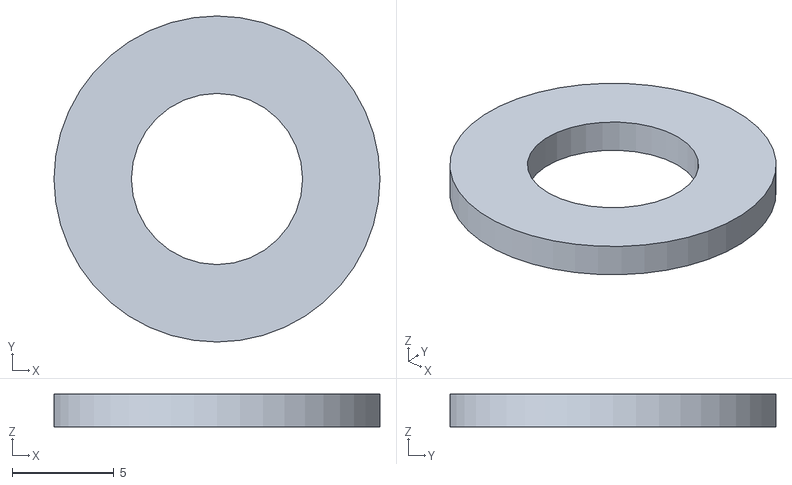
[picture p267: CAD file, 2026-11-13]
курсовой/2026-11-13/Укупориватель — печать и сборка/Детали для печати/6 Шайба.stl
16.0 x 16.0 x 1.60
