DamirNine/prikmeh/курсовой/2026-11-13/Укупориватель — печать и сборка/Детали для печати/2 Кулиса (рукоять).stl

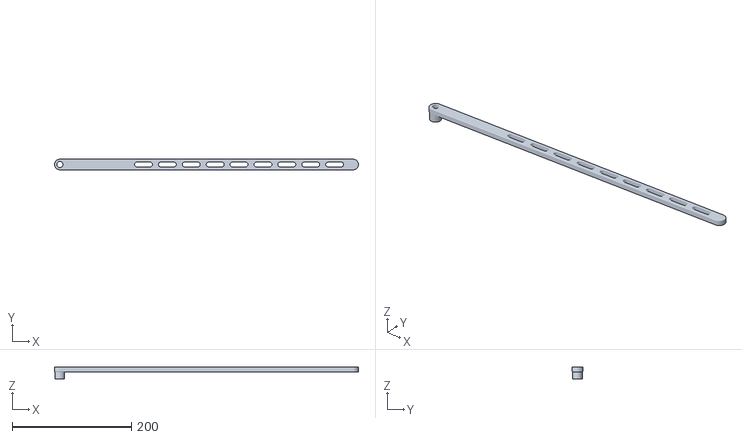
[picture p268: CAD file, 2026-11-13]
курсовой/2026-11-13/Укупориватель — печать и сборка/Детали для печати/2 Кулиса (рукоять).stl
509.0 x 18.0 x 20.0
