DamirNine/prikmeh/курсовой/2026-10-03/optimize_window_result.txt

P = 120 Н (вертикально), L ≤ 500 мм, |φ| ≤ 60°, e ≥ 10 мм
перебрано 816,753,261 вариантов, допустимых 18,926,688
оптимум: A = 80.0 мм², e = 10.0 мм, φк = 7.5°, ψ = 52.5°, φн = 60.0°, S = 16.00 мм, φоб = 36.2°, L = 313 мм
наименьшая площадь при ограничении углового хода ψ ≤ ψ_max:
  ψ ≤   25°: допустимых вариантов нет
  ψ ≤   30°: A = 204.8 мм², e = 25.6 мм, φк = 6.4°, ψ = 30.0°, φн = 36.4°, S = 16.00 мм, φоб = 19.1°, L = 499 мм
  ψ ≤   35°: A = 117.9 мм², e = 14.7 мм, φк = 20.8°, ψ = 35.0°, φн = 55.8°, S = 16.05 мм, φоб = 38.2°, L = 499 мм
  ψ ≤   40°: A = 93.6 мм², e = 11.7 мм, φк = 20.0°, ψ = 40.0°, φн = 60.0°, S = 16.01 мм, φоб = 41.2°, L = 453 мм
  ψ ≤   45°: A = 88.0 мм², e = 11.0 мм, φк = 15.5°, ψ = 44.5°, φн = 60.0°, S = 16.00 мм, φоб = 39.4°, L = 393 мм
  ψ ≤   50°: A = 82.4 мм², e = 10.3 мм, φк = 10.1°, ψ = 49.9°, φн = 60.0°, S = 16.01 мм, φоб = 37.3°, L = 336 мм
  ψ ≤   60°: A = 80.0 мм², e = 10.0 мм, φк = 7.5°, ψ = 52.5°, φн = 60.0°, S = 16.00 мм, φоб = 36.2°, L = 313 мм
время 78 с
