DamirNine/prikmeh/(commit log)

2026-09-06 Первичная загрузка: ДЗ по Прикладной механике (кинематика точки, ДЗ3, курсовой проект) + память проекта
2026-09-15 Добавлено правило: копия перед правкой (+ папки по дате) и автопуш в GitHub
2026-09-18 Курсовой: выбрана тема (укупориватель бутылок), добавлен предпроектный этап (18 пунктов), проверка выполнения по 8 критериям в памяти
2026-09-18 Курсовой: добиты недостающие 5 количественных критериев + расчёт F через материал крышки (18→25 пунктов)
2026-09-18 Курсовой: убрана надпись про "дополнение", §19-25 приведены к формату исходных пунктов (Heading 1, отступы, таблица Times New Roman 12пт)
2026-09-18 Курсовой: формулы в §19-25 переведены на Cambria Math (как в исходных §10-18), устранён разнобой шрифтов
2026-09-18 Добавлен .gitignore для временных файлов-блокировок Word/Excel/PowerPoint
2026-09-18 Курсовой: добавлена версия друга §17-25 с реальными ГОСТ/патентами вместо моих оценочных допущений, проверил источники
2026-09-18 Курсовой: зафиксирована проверка источников версии друга (ГОСТ/патенты) в памяти
2026-09-18 Курсовой: версия друга (_ispravleno) стала канонической predproektnyi_etap_upakovochnyi_mehanizm_25_punktov.docx
2026-09-18 Память: зафиксирована замена канонического файла версией друга
2026-09-18 Курсовой: удалён дубликат _ispravleno.docx (содержимое уже стало каноническим файлом)
2026-09-21 Курсовой: сохранены заметки с очной встречи с преподавателем (2026-09-21)
2026-09-21 Курсовой: уточнена интерпретация "5%" (запас над пределом текучести), шарнир остаётся открытым вопросом
2026-09-21 Курсовой: кинематическая схема (ГОСТ, с размерами) и общий вид укупоривателя
2026-09-21 Курсовой: ТЗ в табличной форме (30 параметров, 6 ГОСТов) — версия друга от 2026-09-21
2026-09-21 Память: проверка ТЗ-таблицы друга; исправлена ошибочная пометка про отмену ГОСТ Р ЕН 1005-3-2010 (подтверждено Росстандартом)
2026-09-25 Курсовой: схема механизма из задания — обрезана, очищена, повёрнута (закрепление слева)
2026-09-27 Курсовой: силовой и кинематический расчёт тангенсного механизма + сверка документов друга от 27.09
    - F по методике преподавателя (1,05·σт × площадь торца горлышка) = 139 кН — показано, почему нереализуемо; сравнение с промышленным ~2 кН
    - кинематика: y = e·tg φ, формула Гохмана, передаточная функция
    - рукоять L = (F/P)(e + S_об²/e), оптимум e = 28 мм (Ra20), таблицы L для вариантов F
    - вопросы преподавателю с ч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
2026-09-27 Курсовой: в расчёт добавлено приведение размеров к ГОСТ 6636-69 (разд. 7)
    - S = 16 (Ra5), e = 28 (Ra20), L = 450 (Ra20), зона 100 (Ra5), основание 200x160
    - проверка после нормализации: Δφ = 29,7° <= 30°, L не меняется
    - перечень размеров, к которым ГОСТ 6636 не применяется (п. 1)
2026-10-01 Память: проверка расчёта 27.09 (разд. 7, ГОСТ 6636-69) — ошибок нет, замечания; правило git pull перед работой
2026-10-02 Курсовой: расчёт v2 — усилие укупоривания по обжиму юбки крышки (~2 кН)
    - кольцо = сечение стенки крышки pi*d*s, F = n*sigma*A*ln(Dk/Dobzh) = 1974 Н
    - сверка с реальными ~2 кН (патент US9327859, замер на Grifo)
    - энергетическая проверка пути руки, рукоять: вариант А 1120 мм, вариант Б 710 мм (Ra20)
    - версия от 27.09 сохранена без изменений
2026-10-02 Курсовой: расчёт v2 — итоговая таблица принятых параметров (п. 7.4), варианты А и Б
2026-10-02 Курсовой: расчёт v2 — убраны упоминания предыдущей версии
2026-10-02 Память: нормы силы руки (ГОСТ Р ЕН 1005-3, ГОСТ 21753-76) и рукоять при разных P
2026-10-02 Курсовой: расчёт v3 — сила руки P = 120 Н, рукоять 500 мм (вариант А) / 320 мм (вариант Б)
2026-10-02 Курсовой: скрипт перебора e, φ, ψ — минимум площади треугольника O–Bн–Bк (817 млн вариантов)
2026-10-02 Курсовой: анимация лучших вариантов окна кулисы (артефакт https://claude.ai/artifact/VXt93KQm4Mi2rMtqVxd3EP)
2026-10-02 Курсовой: расчёт v4 — выбор окна кулисы по площади треугольника (ψ ≤ 40°: e = 12, L = 500), аналоги, закон ω(t), скорости и ускорения точек
2026-10-02 Память: консультация 02–03.10 и расчёт v4 (ψ ≤ 40°, e = 12, L = 500, закон ω(t))
2026-10-05 Курсовой: расчёт v5 — закон ω(t): разгон (холостой ход), площадка (упругая деформация крышки), торможение (пластическая деформация)
2026-10-05 Память: отложенная задача — обновить 3D-модель под размеры v5
2026-10-05 Память: актуальное состояние курсового (v5, отложенная 3D-модель)
2026-10-09 Курсовой: 3D-модель v9 в реальных размерах расчёта v5
2026-10-09 Курсовой: 3D-график площади A(ψ, φк) с допустимой областью и линией A_min; итоговый расчёт (ИТОГ) из загрузок
2026-10-10 Курсовой: расчёт v6 — угловой ход на графике A_min(ψ), проекции на оси ДСК, первичный силовой расчёт
    - рис. 3: угловой ход в шкале относительных уступок, точка компромисса ψ = 36,8° (e = 12,53 мм); табл. 6 с δA, δψ
    - п. 4.3, 8, 10, рис. 5: скорость и ускорение ползуна как проекции V_Dy, a_Dy (V_Dx = a_Dx = 0)
    - новый раздел 11: закон силы обжима F(φ), расчётные схемы звеньев, уравнения равновесия, реакции (P max = 100,6 Н)
    - исходны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
2026-10-10 Курсовой: расчёт v7 — точка M, система 9 уравнений, длина рукояти по max L_треб(φ)
    - схема звеньев с точкой приведения моментов M (левее и выше механизма, оси x_M, y_M)
    - 9 уравнений (по 3 на звено) в матричной форме A(φ)·X = B(φ); неизвестная — сила руки P(φ)
    - решение через угол φ, графики всех 9 неизвестных; L_треб max = 419 мм → L = 450 мм (Ra20), P ≤ 111,8 Н
    - кинематика и сводка пересчитаны на L = 450 мм (ω_max = 1,56 рад/с, t_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
2026-10-10 Курсовой: расчёт v8 — угловой ход 36,75° (точка равных уступок), e = 12,53 мм, L = 500 мм; уравнения с углами φ ± 90°
    - ψ = 40° заменён точкой пересечения A_min(ψ) и углового хода (равные уступки 25,3 %)
    - окно 59,47° → 22,72°, φоб = 41,91°, φу = 41,63°; e не нормализуется (п. 1 ГОСТ 6636-69)
    - пересчитаны аналоги, закон ω(t), проекции на оси ДСК, силовой расчёт: L_треб max = 470 мм → L = 500 мм, P ≤ 112,8 Н
    - уравнения равновесия в явном виде R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
2026-10-10 Память: курсовой v8 (ψ = 36,75°, e = 12,53, L = 500)
2026-10-11 Курсовой: v9 — независимая перепроверка v8, мелкие правки; 3D-график площади с ψ = 36,75°
    - verify_v9.py: пересчёт всех чисел другим способом (бисекция, своя матрица 9×9 по табл. 10, своё моделирование ω(t)),
    сверка текста и таблиц 3, 6–9, 11, 12 и данных рис. 3–9 — расхождений 0
    - табл. 6: δA при ψ = 50° — 2,8 % (было 2,9 — от округлённой площади)
    - п. 11.2: C = 1880/0,1087 ≈ 17 300 Н/мм (при 0,109 вручную выходило 17 250)
    - подпись рис. 1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
2026-10-11 Память: курсовой v9 — перепроверка, 3D-график площади
2026-10-12 Курсовой: v10 — раздел 12 «Прочностной расчёт звеньев» (как в примере РК6-54Б и семинаре 12)
    - сталь 45 (ГОСТ 1050-2013), [n] = 2,5, [σ] = 142, [τ] = 85, [p] = 30 МПа (ориентировочно)
    - эпюры N, Q, M кулисы при φу = 41,63° (опасное) и φк = 22,72° (рис. 10, 11; табл. 13)
    - палец D Ø12, камень 18×18×10, ось O Ø16 со ступицей Ø32×16 (табл. 14);
    при e = 12,53 узел в одной плоскости не компонуется (перекрытие 4,4 мм, нужно e ≥ 17,5) →
    составная кулиса: ступи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
2026-10-12 Память: курсовой v10 — прочностной расчёт
2026-10-12 Курсовой: примеры РПЗ и презентаций других бригад; память — сверка v10 с примерами
2026-10-12 Курсовой: 3D-модель под размеры v10 (составная кулиса, камень 18×18×10, e = 12,53)
2026-10-13 Мои записи и сообщения Claude по курсовому (15.09–13.10.2026), включая заметки с консультаций и ответы на вопросы
2026-10-13 Перенос мои_записи_Claude.md в папку курсовой
2026-10-19 Курсовой: копия v10 → v11 для дальнейшей правки
2026-10-19 Записи 19.10: замечания к прочностному расчёту (сделать в v11)
2026-10-22 Курсовой v11: прочностной расчёт по схеме консультации 19.10
    Раздел 12 заменён: опасные положения → эпюры N, Q, M → σ = |N|/A + |M|/W ≤ [σ] →
    пруток — перебор диаметров по ГОСТ 2590-2006, лист — h из уравнения при известной b →
    выбор материала (Ст3сп, 35, 45, 40Х) → массы. Принято: кулиса — лист Ст3сп 8 мм
    (рукоять 8×18, паз H 36/w 16), палец D Ø10, ось O Ø16, шток Ø12 — сталь 45.
    Обновлены вступление, сводка (табл. 19), раздел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
2026-10-22 Курсовой: вариант расчёта с камнем-роликом (отдельный файл)
    Отдельный файл v11 с камнем — роликом на пальце D: п. 4.1 и рис. 1, 7 с роликом;
    раздел 12 с контактной прочностью пары ролик — паз (Герц, ГОСТ 21354-87): закалка ТВЧ
    HRC 45…50, материал — сталь 45; лист 12 мм, ролик Ø22 × 12, рукоять 12×12, зона паза H 40,
    палец D Ø11, ось O Ø16, шток Ø12; массы, сводка, разделы 14–17. Проверка — 0 расхождений.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
2026-10-23 Курсовой: копия расчёта с квадратным камнем рядом с вариантом с роликом (2026-10-23)
2026-10-23 Курсовой: расчёт v11 перенесён в папку дня правки (2026-10-23)
    Правки 23.10 сохранены в курсовой/2026-10-23: …_v11_квадратный_камень.docx со скриптами
    (build_v11, calc_v11, figs_v11, verify_v11_strength) и рисунками 10–14, рядом …_v11_круглый_камень.docx.
    В курсовой/2026-10-19 возвращена исходная копия v10, сделанная 19.10. Обновлены заметки проекта.
2026-10-23 Память: прикидка влияния трения на силу руки (расчёт отложен)
2026-10-23 Курсовой v12 (квадратный и круглый камень): эпюры без разрыва оси, номера таблиц ГОСТ 19903 и 14637, вопрос о соединении ступицы
2026-10-23 Курсовой v12: рис. 1 — ровная опора стойки под осью O (оба варианта)
2026-10-24 Курсовой v13: камень-обойма снаружи кулисы, эпюры на истинном положении звена, устойчивость штока, без расчёта пальцев и массы камня
2026-10-24 3D-модель под v13: кулиса-полоса 8×18, камень-обойма снаружи, направляющая ползуна на уровне D, шток Ø8
2026-10-24 Курсовой v14: рисунки 1, 4, 5, 7, 10-13 без наложения подписей
    Эпюры на наклонной кулисе с подписями вне эпюр, обойма - кулиса целиком,
    выносной элемент и сечение Б-Б (рабочее ребро снизу), шток - подписи
    с выносками и без скачка на lambda = 100; нумерация 12/13 по порядку.
2026-10-26 Курсовой v15: рис. 3, 6, 8 без наложений, ссылки на таблицы 17 и 19
2026-10-26 3D-модель: головка Ø40 × 24 по расчёту массы ползуна, горловина обжима Ø33 → Ø28,6
2026-10-26 Память: задача - обойма камня охватывает кулису со всех сторон
2026-11-02 Курсовой v16: правки пользователя 30.10 (без разд. 14 и 16, новое сечение Б–Б обоймы) + удалён рис. 13 и ссылка на него
2026-11-02 Память: правки пользователя 30.10, v16, план уточнённого силового расчёта
2026-11-02 Курсовой v17: раздел 13 — уточнённый силовой расчёт с силами тяжести и инерции
    Та же матрица 9x9, новый столбец B: G1, Ф1τ, Ф1n, MФ1 кулисы и G3, Ф3 ползуна по закону ω(φ) п. 9; трение и обратный ход не учитываются.
    P max 112,8 → 109,9 Н (L = 500 сохраняется), на холостом ходе P ≈ −2,5…−2,9 Н; реакции ≤ 0,3 %.
    Проверочный прочностной: кулиса 94,6 ≤ 98 МПа, обойма 15,7 ≤ [p] = 24 МПа — материалы не меняются.
    Сводка → 14 (табл. 23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
2026-11-02 Память: v17 — уточнённый силовой расчёт, решения пользователя, грабли вёрстки
2026-11-02 Память: описание курсового — актуально v17
2026-11-02 3D-модель v17: закрытая обойма (губки укорочены у втулки оси O, зазор ≥ 1,47 мм), кнопка «Человек для масштаба»
2026-11-02 Память: ярлык 3D-модели на рабочем столе
2026-11-02 Курсовой v18: все формулы — редактором формул Word (LaTeX → OMML), матрица 9×9 вместо табл. 20, рис. 14 — 9 графиков
    109 формул: LaTeX (formulas_latex.py) → latex2mathml → MML2OMML.XSL (omml.py); закон обжима — система с фигурной скобкой.
    Табл. 20 (столбец B) заменена матричной записью A(φ)·X = B(φ), B3 отдельной строкой; табл. 21–23 → 20–22.
    Рис. 14 — 3×3 неизвестных: первичный (штрих), уточнённый, разность по правой шкале. Индексы R10x → R10 с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
2026-11-02 Память: v18 — формулы Word, матрица 9×9, рис. 14 из 9 графиков
2026-11-02 Курсовой v19: рис. 14 — только уточнённый силовой расчёт
2026-11-02 Курсовой v20: рис. 12 — сечение Б–Б с губками, палец D заодно с обоймой
2026-11-02 3D-модель v20: палец D заодно с обоймой; память: формулы только через LaTeX
2026-11-02 Курсовой v20: правка пользователя — удалены п. 12.6 и таблица 17
2026-11-02 Курсовой v20: перенумерация после удаления п. 12.6 и табл. 17 (таблицы 17–21, пп. 12.6–12.7, ссылки)
2026-11-04 Курсовой v21: замечания преподавателя — схемы по ЕСКД, расчёт кинематических пар на срез и смятие
    - рис. 1 — кинематическая схема по ГОСТ 2.770-68, крайние положения тонкими штрихпунктирными с двумя точками
    - рис. 7, 10, 11, 13 — звенья линиями, точки вместо пустых кружков; на рис. 13 и в тексте — главный вектор и главный момент сил инерции
    - рис. 12 — сечение Б–Б по оси пальца D, без штриховки, ось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
2026-11-04 Курсовой v22: звено 3 линией, ровная стойка, разрез Б–Б со штриховкой; 3D-модель — ступица выделена
    - рис. 1, 7, 13: звено 3 (ползун) — линия; на рис. 1 стойка у оси O — вертикальная, под прямым углом к основанию
    - рис. 12 в): разрез Б–Б как в v20 — секущая плоскость рядом с пальцем, обойма и полоса заштрихованы,
    палец D за плоскостью без штриховки
    - 3D-модель v22: ступица кулисы у оси O другим цветом, в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
2026-11-04 Курсовой v23: в разрезе Б–Б обойма и палец D одного цвета
    Обойма заштрихована в цвете пальца, палец за секущей плоскостью — без штриховки.
2026-11-04 Модели в КОМПАС-3D v25: 10 деталей и сборка укупоривателя с ограничением хода
    - kompas_build.py: детали через API КОМПАС (основание, стойка, ось O, направляющая, упоры нижний и верхний,
    кулиса со ступицей, ручка, камень с пальцем D, ползун)
    - kompas_assembly.py: сборка с сопряжениями, угол кулисы в диапазоне 22,72…59,47°; проверка кинематики
    (y ползуна = e·tg φ) и возврата в диапазон
    - geom_check.py: соударений на всём ход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
2026-11-04 КОМПАС: детали отдельно в папке «Детали», сборка соединена сопряжениями
    - каждая деталь построена от своей базы в своей системе координат
    - в сборке закреплено только основание; стойка, ось, направляющая, упоры, кулиса, ручка, камень и ползун
    соединены 25 сопряжениями по граням, осям и плоскостям; угол кулисы в диапазоне 22,72…59,47°
    - массы всех деталей совпадают с ручным счётом; соудар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
2026-11-04 КОМПАС: детали непрозрачные, камень поставлен правильно
    - цвет деталей задавался с прозрачностью 0 (детали были видны только рёбрами) — теперь непрозрачные
    - камень по толщине: торец пальца D заподлицо с передней гранью ползуна вместо «На расстоянии»,
    которое ставило обойму перед ползуном
    - скрипт сборки сверяет положение каждой детали с задуманным; системные плоскости деталей с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
2026-11-04 КОМПАС: стойка к стене одной деталью, кулиса с рукоятью одной деталью
    - основание убрано, стойка крепится к стене (4 отверстия Ø6), в сборке закреплена
    - стойка, ось O, направляющая и упоры — одна деталь УКП.00.001
    - кулиса и рукоять — одна деталь УКП.01.001 (рукоять — конец полосы, как в расчёте)
    - сборка из 4 деталей, 8 сопряжений; кинематика и соударения проверены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
2026-11-04 КОМПАС: рукоять Ø26 × 95 — часть детали «Кулиса с рукоятью»
2026-11-04 КОМПАС: стойка снова на столе (основание в той же детали), кулиса без рукояти
    - УКП.00.001 Стойка: основание 200 × 160 × 20, лист, ось O, направляющая и упоры — одна деталь
    - УКП.01.001 Кулиса: рукоять убрана, деталь переименована
2026-11-04 КОМПАС: сборка пересохранена (без изменений геометрии)
2026-11-04 КОМПАС: все эскизы деталей полностью определены (связи и управляющие размеры)
2026-11-04 КОМПАС: кожух УКП.04.001 — закрывает механизм, сдвигается вперёд на 0…60 мм
    - коробка из АБС-пластика 2 мм, открыта сзади; пазы под кулису и шток открыты назад — кожух снимается сдвигом вперёд
    - в сборке: по плоскостям стойки + «На расстоянии» с диапазоном 0…60 мм
    - соударений нет: зазор кулисы в пазу 1 мм, штока в дне 2 мм; эскизы кожуха полностью определены
2026-11-04 КОМПАС: ход кожуха 0…120 мм (правка пользователя), сборка сохранена
2026-11-06 КОМПАС 06.11: основание убрано, стойка крепится к стене
    - новая папка 2026-11-06/kompas, настольная версия осталась в 2026-11-04/kompas
    - пластина 92 × 390 × 12 с 4 отверстиями Ø6 под крепёж к стене
    - от стены до кулисы 24,5…32,5 мм, до оси ползуна 46 мм
2026-11-06 КОМПАС: окно с кнопкой — движение механизма туда-сюда по закону ω(t)
2026-11-06 КОМПАС 06.11: основание возвращено у стены, лист 365 мм, шток 35; исправлен запуск окна движения
    - основание 200 × 160 × 20 — часть стойки, задняя кромка заподлицо со стеной; отверстия под стену сохранены
    - шток 60 → 35 мм, направляющая и кожух короче, лист 390 → 365 мм; под головкой по-прежнему бутылка 226,5 + крышка 6 + зазор 10
    - исправлен путь к pythonw в «Движение механизма.bat»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
2026-11-06 КОМПАС 06.11: сборка пересобрана на новых деталях (основание на месте), сверка масс в скрипте
2026-11-06 КОМПАС 06.11: длины возвращены (лист 390, шток 60), основание 128 × 92 по центру
    Основание уменьшено с 200 × 160: лист посередине с полями по 18 мм, ось бутылки посередине глубины.
    Детали и сборка пересобраны. Масса в kompas_build берётся у своего документа, а не у активного окна.
    Служебные файлы КОМПАСа убраны из репозитория и добавлены в .gitignore.
2026-11-06 Служебные файлы КОМПАСа (~$*.m3~) сняты с учёта в git
2026-11-06 КОМПАС 06.11: лист стойки центрирован по кожуху
    Лист x −31,75…60,25 от оси O, поля от кожуха по 14,75 мм; основание сдвинуто вместе с листом.
    Отверстия под стену — 8 мм от боковых краёв, чтобы шляпка шурупа не заходила под кожух.
2026-11-06 КОМПАС 06.11: встроенная анимация механизма по закону ω(t)
    Копия сборки с исключённым сопряжением угла и осью O, сценарий «Механики: Анимации» на 36 шагов,
    запуск в одно нажатие из «Анимация в КОМПАСе.bat». Рабочая сборка не менялась.
2026-11-06 КОМПАС 06.11: деталь «Бутылка» в сборке и анимации, устранён сбой SaveAs
    Бутылка Longneck 0,33: полая, 226,5 × Ø60,4, 220,8 г (ТЗ 220 г), 355 мл до краёв; стоит на основании по оси ползуна.
    Сбой SaveAs: скрипт создавал деталь, пока грузились приложения КОМПАСа; теперь после запуска ждёт конца загрузки.
2026-11-06 Расчёт v24: из mechanism.docx убраны ссылки на прошлую версию
2026-11-09 КОМПАС 09.11: палец D отдельно от камня — резьба М8, шайба и гайка
    Камень с отверстием Ø10, палец запрессован; ползун на пальце держат шайба
    и гайка М8 (упор в уступ пальца). Кожух глубже (58 мм). 9 компонентов,
    23 сопряжения, соударений нет.
2026-11-09 Расчёт v25 в работе: рисунок обжима конусом (черновик), план правок — пауза
2026-11-09 Расчёт v26 по замечаниям преподавателя; головка ползуна с конической горловиной в 3D
    Текст: одна плоскость среза (i убрано), I_min — минимальный момент инерции
    сечения и выбор «размер или материал», логика рисунок → уравнения → матрица →
    решение в разд. 11 и 13, новый рис. 1 — обжим крышки конусом с распределённым
    давлением (рисунки +1). КОМПАС: головка Ø40 с горловиной Ø32,1→Ø28,6 на 6 мм,
    удлине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
2026-11-09 Расчёт v27: рис. 13 — палец D отдельной деталью, разрез В–В с шайбой и гайкой
    В разрезе Б–Б палец запрессован в стенку обоймы; новый разрез В–В по оси
    пальца: ползун на пальце, шайба и гайка М8, уступ 0,5, одна плоскость среза.
    Текст под рисунком, п. 12.6 и табл. 17 — вместо «заодно с обоймой».
2026-11-09 Палец D своим цветом: рис. 13 (расчёт v28) и деталь в КОМПАСе
    Палец — отдельная деталь, поэтому зелёный (#7fae6a), а не цвета обоймы.
    КОМПАС: build_pin(), «python kompas_build.py pin» перестраивает только палец.
2026-11-09 КОМПАС: сборка пересобрана после перестройки пальца (6 сопряжений с «!»)
2026-11-09 APM FEM: копии кулисы и ползуна для расчёта, картинки деталей
2026-11-09 APM FEM: тест кулисы (92,6 МПа), облегчённая кулиса с пазами 30×8 для второго теста
2026-11-09 APM FEM: тест облегчённой кулисы — 92,6 МПа, у пазов ≤ 81 МПа
2026-11-09 APM FEM: кулиса с сеткой и картой напряжений внутри файла (3,6 МБ)
2026-11-09 APM FEM: облегчённая кулиса с сеткой и картой напряжений внутри файла
2026-11-13 APM FEM: кулиса облегчённая 2 — копия с нагрузками APM + паз 445…475 у рукояти (449,7 г)
2026-11-13 APM FEM: тест кулисы с 9 пазами — 92,6 МПа, у нового паза ≤ 20 МПа
2026-11-13 APM FEM: тест ползуна (шток 37, пик 95,9 МПа у угла), облегчённый ползун — колокол + R3, 320,8 г
2026-11-13 APM FEM: тест облегчённого ползуна (49,0 МПа), отчёт «Прочностной анализ деталей в APM FEM.docx»
2026-11-13 КОМПАС 13.11: стойка — рёбра 50×50×6 по краям листа, R5, нижние отверстия выше рёбер (скрипт, не пересобрано)
2026-11-13 КОМПАС 13.11: стойка с рёбрами 50×50×6 и R5 построена отдельно (5555,7 г), сборка не пересобрана
2026-11-13 APM FEM: копии камня и пальца D для расчёта (палец разбит на зоны запрессовки и ползуна), картинки
2026-11-13 APM FEM: тест камня (646 МПа в углу стенка–перемычка), закрытая обойма с R1,5 для второго теста; картинки 600 dpi
2026-11-13 APM FEM: тест закрытого камня (338 МПа у края отверстия); копия с фасками 0,5×45° и отверстием, разделённым на верх/низ
2026-11-13 APM FEM: камень закрытый 2 — передняя фаска отверстия вырезом вращения (операция «Фаска» на ней не строилась)
2026-11-13 APM FEM: камень закрытый 2 — разделение отверстия на половины исключено (отверстие снова одна грань)
2026-11-13 APM FEM: тест камня закрытого 2 (фаски, отверстие закреплено целиком): пик 534 МПа на кромке закрепления, перемычка 100–230
2026-11-13 APM FEM: отчёт — раздел «Камень» (замкнутая обойма, сталь 40Х), общий вывод о снижении напряжений
2026-11-13 APM FEM: тест пальца D — изгиб у стенки камня ≈190–280 МПа, пик 751 на кромке закрепления
2026-11-13 APM FEM: отчёт — раздел «Палец D» (изгиб ≈230 МПа, сталь 40Х), итоговая таблица из 4 деталей
2026-11-13 память: итоги APM FEM 13.11
2026-11-13 Стойка: рёбра 60° (60×103,9); кулиса облегчённая 3 — фаски 0,5×45° на 4 кромках; новый тест пальца (подшипниковая нагрузка)
2026-11-13 Кулиса облегчённая 3: фаска 0,5×45° по всему контуру полосы с обходом скруглённых концов (без ступеньки)
2026-11-13 13.11: новая сборка из деталей после APM FEM (кулиса с фасками, ползун облегчённый, камень закрытый, палец 40Х, стойка с рёбрами 60°); чистая картинка камня
2026-11-13 13.11: рёбра стойки 80×138,6×8; кожух сужен слева, лежит на верхнем упоре и упирается в направляющую; камень — сталь 45; проверка кожух–стойка
2026-11-13 13.11: инструкция по сборке (HTML) и STL деталей для 3D-печати — папка «Укупориватель — печать и сборка»; скрипты картинок/STL/HTML
2026-11-13 memory: сборка 13.11 и комплект для печати
